cansat-tsniimash/can-cube-sat-2022/logs/sd/best-dataset/readme.txt

Набор создан из одного файла телеметрии с SD карты по имени T167, так как он содержит все данные полёта и чуть больше.

Использованы следующие команды:

1. Для создания первичных csv с фильтрацией по времени и дополнительными колонками с временем
`python make_csv.py -i "T167" --notimestamps --time-steady-start 2450006 --time-steady-stop 10381817 --time-steady-launch 2710973 --output-dir T167_mav_csv_flight --fix-bcu-electricals --time-launch 1656909365`. make_csv находится в cansat-gcs репе

2. Для создания набора с интерполированной высотой и давлением для каждой записи
`python inject.py` Скрипт находится здесь же в папочке `analysis-scripts`

Интересные события:

```
начало интересной телеметрии
time_steady = 2450006; time_s = 1656909103; greg = 2022-07-04T07:31:43; минуты от старта (по time_s): -4.356

запуск
time_steady = 2710973; time_s = 1656909365; greg = 2022-07-04T07:36:05; минуты от старта: 0

разрыв шара
time_steady= 489901; time_s = 1656914065; greg = 2022-07-04T08:54:25; минуты от старта: 78.335

посадка
time_steady = 9328887; time_s = 1656915983; greg = 2022-07-04T09:26:23; минуты от старта: 110.27

конец интересной телеметрии
time_steady = 10381817; time_s = 1656917036; greg = 2022-07-04T09:43:56; минуты от старта: 127.858
```
