cansat-tsniimash/can-cube-sat-2022/doc/Отчетные документы на зимнюю сессию/ТЗ на наземный комплекс управления Охотник.docx

СОГЛАСОВАНО | УТВЕРЖДАЮ
___________________________________ | ___________________________________
должность, головной исполнитель ОКР | должность, заказчик
___________________________________ | ___________________________________
подпись, инициалы, фамилия | подпись, инициалы, фамилия
«___»____________________ 20___г. | «___»____________________ 20___г.

ТЕХНИЧЕСКОЕ ЗАДАНИЕ
НА СОСТАВНУЮ ЧАСТЬ ОПЫТНО-КОНСТРУКТОРСКОЙ РАБОТЫ

НАЗЕМНЫЙ КОМПЛЕКС УПРАВЛЕНИЯ ОХОТНИК

ОХОТНИК-ИТС

Королев 2022

Содержание

1 Наименование, шифр СЧ ОКР, основание, исполнитель и сроки выполнения СЧ ОКР

Разрабатываемый наземный комплекс управления, входящий в состав стратосферной исследовательской системы "Дикая охота" (далее именуется "Охотник").

Шифр СЧ ОКР: "ОХОТНИК-ИТС".

Основания для проведения СЧ ОКР:

- «Положение о проведении 11 сезона всероссийского чемпионата «Воздушно-инженерная школа»;
- решение участников "Концерна "Информационные технические системы" об участии в конкурсе.

Исполнитель – "Концерн "Информационные технические системы".

Сроки выполнения СЧ ОКР распределены на несколько этапов согласно таблице 1.

Таблица 1. Этапы проведения СЧ ОКР.

№ | Наименования этапа | Срок окончания
1 | Разработка эскизного проекта | Январь 2022
2 | Разработка рабочего проекта | Апрель 2022
3 | Изготовление и проведение контрольных испытаний всех элементов разрабатываемой системы | Июнь 2022

2 Цель выполнения СЧ ОКР, наименование и индекс изделия

Целью составной части опытно-конструкторской работы (СЧ ОКР) является разработка наземного комплекса управления в составе стратосферной исследовательской системы "Дикая охота", предназначенной для выполнения исследовательских задач согласно регламенту конкурса "Воздушно-инженерная школа CanSat в России".

Наименование изделия: Наземный комплекс управления "Охотник" стратосферной исследовательской системы "Дикая охота".

Индекс изделия: GCS1B.

3 Технические требования к изделию
  3.1 Состав изделия
- Центр управления полетами "Засада", предназначенный для сбора хранения и отображения телеметрии в реальном времени;
- Приемопередающая антенная система "Арсенал", предназначенная для обеспечения канала связи аппарата с Землей.
- Программное обеспечение различного назначения, в том числе система автоматического наведения, система ручного управления антенной, система отображения телеметрии "Стрела-МС", система приема и отправки команд.
  3.2 Требования назначения

Разрабатываемый наземный комплекс управления предназначен для решения следующих задач:

- приём телеметрической и иной информации, передаваемой стратосферным зондом;
- отправка команд;
- накопление принятой информации на внутреннем накопителе;
- отображение полученной по радиоканалу информации электронно-вычислительными машинами центра управления полетами в реальном или близком к реальному времени;
- передача информации с приемо-передающей антенной системы на электронно-вычислительные машины центра управления полетами, осуществляемая при помощи протокола из стека протоколов TCP/IP (v4 или v6);
- Автоматическое наведение антенны на аппарат по данным о его положении в системе координат WGS84;
- Ручное управление приемо-передающей антенной системой с использованием компьютеров центра управления полетами.
  3.3 Требования радиоэлектронной защиты

Должна быть обеспечена совместимость радиоэлектронных средств, используемых в системе.

  3.4 Требования живучести и стойкости к внешним воздействующим факторам

Требования к имитозащищенности

Наземная станция должна удовлетворять следующим требованиям к имитозащищенности:

- должна быть предусмотрена защита от различного рода помех при помощи таких механизмов, как контрольные суммы или помехозащищенное кодирование.

К наземному измерительному пункту предоставляются следующие требования климатической устойчивости:

- Наземный комплекс управления должен функционировать в диапазоне температур от 0 °C до 45 °C при нормальном атмосферном давлении.

Требования надёжности не предъявляются.

  3.5 Требования эргономики, обитаемости и технической эстетики

Составные части системы должны выглядеть красиво и вызывать ощущение гармонии и удовлетворения в той или иной степени.

  3.6 Требования к эксплуатации, хранению, удобству технического обслуживания и ремонта.

К системе предоставляются следующие эксплуатационные требования:

- система должна приводиться в готовность не дольше 1 часа;
- элементы системы должны быть разборными и предусматривать возможность многократной неразрушающей разборки и последующей сборки в целях проведения локальных ремонтных работ.
  3.7 Требования к транспортабельности

К составным частям системы предоставляются следующие требования:

- элементы системы должны быть транспортабельны при помощи рюкзака объёмом не более 20 литров без потери функциональности. Это требование не распространяется на антенны и штатив.
  3.8 Требования безопасности

К системе предъявляются следующие требования безопасности:

- элементы системы не должны предоставлять опасности для персонала и населения путём воздействия электрического напряжения, движущихся частей, теплового (светового) воздействия, высокочастотных, радиационных, электромагнитных полей, ядовитых паров и газов, вибраций, акустических шумов и др.;
- элементы питания системы должны быть снабжены соответствующими устройствами защиты от коротких замыканий и последующего возгорания;
- конструкция элементов системы должна исключать самопроизвольное включение и выключение.
  3.9 Требования стандартизации

Не предъявляются.

  3.10 Требования технологичности

Не предъявляются.

  3.11 Конструктивные требования

Не предъявляются.

4 Требования к обеспечению
  4.1 Требования к нормативно-техническому обеспечению

Для разработки проекта должна быть использована система контроля версий.

  4.2 Требования к метрологическому обеспечению

Не предъявляются

  4.3 Требования к диагностическому обеспечению

Не предъявляются

  4.4 Требования к математическому, программному и информационно-лингвистическому обеспечению

Вся принятая телеметрия должна сохраняться на внутренний накопитель информации приёмной станции.

5 Требования к консервации, упаковке и маркировке

Для элементов системы должна быть разработана упаковка, позволяющая осуществлять транспортировку и хранение с учётом предоставляемых к транспортировке требований.

6 Требования к учебно-тренировочным средствам

При разработке системы требуется создание автономных стендов для отработки отдельных узлов (там, где это возможно).

7 Этапы выполнения ОКР

Этапы выполнения ОКР приведены в таблице 1.

8 Порядок выполнения этапов и приёмки ОКР

Для закрытия этапа эскизного проектирования, требуется выполнение следующих требований:

Должна быть разработана принципиальная электрической схема наземной станции;

Должна быть создана презентация для устного доклада комиссии;

Для закрытия этапа рабочего проекта должны быть выполнены следующие требования:

Система должна быть полностью спроектирована с выпуском следующих документов:

- Комплект чертежей конструкции СЧ (допустимо использование точных трёхмерных моделей);
- Электрические принципиальные схемы и шаблоны для производства печатных плат, используемых в наземной станции в случае, если последние являются вновь разрабатываемыми.

Должна быть выпущена альфа версия программного обеспечения наземной станции.

Должны быть проведены автономные испытания СЧ.

На финальный этап конкурса команда должна предоставить готовую к эксплуатации СЧ в составе системы и принять участие в финале конкурса "Воздушно-инженерная школа (CanSat в России)".

9 Непредъявляемые требования

Технико-экономические требования.

Требования к каталогизации.

Требования к сырью, материалам и КИМП.

Специальные требования.

10 Ссылочные документы
- Положение о проведении 11 сезона всероссийского чемпионата «Воздушно-инженерная школа».
11 Перечень сокращений:
- КИМП – комплектующие изделия межотраслевого применения;
- ОКР – опытно конструкторская работа;
- СЧ – структурная часть;
- IP – internet protocol;
- UDP – user datagram protocol.

Со стороны исполнителей | Со стороны заказчика
_____________________________________ | _____________________________________
должность, головной исполнитель ОКР | должность, организация заказчика — разработчика ТЗ на ОКР
_____________________________________ | _____________________________________
подпись, инициалы, фамилия | подпись, инициалы, фамилия
«___»____________________ 20___г. | «___»____________________ 20___г.

_____________________________________ | _____________________________________
должность, головной исполнитель ОКР | должность, организация заказчика — разработчика ТЗ на ОКР
_____________________________________ | _____________________________________
подпись, инициалы, фамилия | подпись, инициалы, фамилия
«___»____________________ 20___г. | «___»____________________ 20___г.

_____________________________________ | _____________________________________
должность, головной исполнитель ОКР | должность, организация заказчика — разработчика ТЗ на ОКР
_____________________________________ | _____________________________________
подпись, инициалы, фамилия | подпись, инициалы, фамилия
«___»____________________ 20___г. | «___»____________________ 20___г.

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

ТЗ ОХОТНИК-ИТС Лист 18
