cansat-tsniimash/can-cube-sat-2022/doc/Отчетные документы на зимнюю сессию/ТЗ на систему Дикая охота.docx

СОГЛАСОВАНО | УТВЕРЖДАЮ
___________________________________ | ___________________________________
должность, головной исполнитель ОКР | должность, заказчик
___________________________________ | ___________________________________
подпись, инициалы, фамилия | подпись, инициалы, фамилия
«___»____________________ 20___г. | «___»____________________ 20___г.

ТЕХНИЧЕСКОЕ ЗАДАНИЕ
НА ОПЫТНО-КОНСТРУКТОРСКУЮ РАБОТУ

СТРАТОСФЕРНАЯ ИССЛЕДОВАТЕЛЬСКАЯ СИСТЕМА ДИКАЯ ОХОТА

ДИКАЯ-ОХОТА-ИТС

Содержание

1 Наименование, шифр ОКР, основание, исполнитель и сроки выполнения ОКР

Разрабатываемая стратосферная исследовательская система именуется "Дикая охота".

Шифр ОКР: "ДИКАЯ-ОХОТА-ИТС".

Основания для проведения ОКР:

- «Положение о проведении 11 сезона всероссийского чемпионата «Воздушно-инженерная школа»;
- решение участников Концерна "Информационные технические системы" об участии в конкурсе.

Исполнитель – "Концерн "Информационные технические системы".

Сроки выполнения ОКР распределены на несколько этапов согласно таблице 1.

Таблица 1. Этапы проведения ОКР

№ | Наименования этапа | Срок окончания
1 | Разработка эскизного проекта | Январь 2022
2 | Разработка рабочего проекта | Апрель 2022
3 | Изготовление и проведение контрольных испытаний всех элементов разрабатываемой системы | Июнь 2022

2 Цель выполнения ОКР, наименование и индекс изделия

Целью опытно-конструкторской работы (ОКР) является разработка стратосферной исследовательской системы, предназначенной для выполнения исследовательских задач согласно регламенту конкурса "Воздушно-инженерная школа CanSat в России".

Наименование изделия: Стратосферная исследовательская система "Дикая охота". Далее "Дикая охота" или исследовательская система.

Индекс изделия: 2A.

3 Технические требования к изделию
  3.1 Состав изделия
- стратосферный зонд (СЗ), запускаемый на стратостате;
- наземный комплекс управления (НКУ), осуществляющий приём и обработку данных, поступающих от стратостата.
  3.2 Требования назначения

Разрабатываемая система предназначена для решения следующих задач:

- измерение распределения температуры и давления во время подъёма и спуска;
- измерение относительной влажности на всей трассе полёта;
- измерение состава воздуха (кислорода и примесей: NH3, NO2 и CO) на всей трассе полёта;
- измерение трёх компонент ускорения;
- фотография Земли в период времени от 0 до 10 секунд после начала падения аппарата;
- фиксация точки разрушения шара-зонда (координаты, высота, время);
- фотофиксация неба в момент приземления;
- исследование радиационной обстановки на протяжении всего полета;
- определение ориентации на Солнце при помощи солнечного датчика собственной разработки;
- регистрация траектории полета и ориентации стратосферного зонда;
- изучение эффективности работы солнечных панелей в зависимости от высоты;
- создание улучшенного наземного комплекса управления;
- обеспечение двунаправленной связи по радиоканалу между СЗ и НКУ;
- анализ телеметрии аппарата на приёмном пункте во время полёта;
- накопление принятой информации от СЗ на НКУ;
- автоматическое (основное) и ручное (резервное) наведение антенны НКУ на аппарат.
  3.3 Требования радиоэлектронной защиты

Должна быть обеспечена совместимость радиоэлектронных средств, используемых в системе.

  3.4 Требования живучести и стойкости к внешним воздействующим факторам

Требования к имитозащищенности

Система должна удовлетворять следующим требованиям к имитозащищенности:

- должна быть предусмотрена защита от различного рода помех при помощи таких механизмов, как контрольные суммы или помехозащищенное кодирование.

Требования к устойчивости к климатическим воздействиям не предъявляются.

Требования надёжности не предъявляются.

  3.5 Требования эргономики, обитаемости и технической эстетики

Элементы системы должны выглядеть внушительно.

  3.6 Требования к эксплуатации, хранению, удобству технического обслуживания и ремонта

К системе предоставляются следующие эксплуатационные требования:

- система должна приводиться в готовность не дольше 1 часа;
- элементы системы должны быть разборными и предусматривать возможность многократной неразрушающей разборки и последующей сборки в целях проведения локальных ремонтных работ.
  3.7 Требования к транспортабельности

К составным частям системы предоставляются следующие требования:

- элементы системы должны быть транспортабельны при помощи двух рюкзаков объёмом не более 20 литров без потери функциональности. Это требование не распространяется на антенны и штатив из состава НКУ.
  3.8 Требования безопасности

К системе предоставляются следующие требования безопасности:

- элементы системы не должны предоставлять опасности для персонала и населения путём воздействия электрического напряжения, движущихся частей, теплового (светового) воздействия, высокочастотных, радиационных, электромагнитных полей, ядовитых паров и газов, вибраций, акустических шумов и др.;
- элементы питания системы должны быть снабжены соответствующими устройствами защиты от коротких замыканий и последующего возгорания;
- конструкция элементов системы должна исключать самопроизвольное включение и выключение.
  3.9 Требования стандартизации

Не предъявляются.

  3.10 Требования технологичности

Не предъявляются.

  3.11 Конструктивные требования

Не предъявляются.

4 Технико-экономические требования

Не предъявляются.

5 Требования к обеспечению
  5.1 Требования к нормативно-техническому обеспечению

Для разработки проекта должна быть использована система контроля версий.

  5.2 Требования к метрологическому обеспечению

Не предъявляются.

  5.3 Требования к диагностическому обеспечению

Не предъявляются.

  5.4 Требования к математическому, программному и информационно-лингвистическому обеспечению

Не предъявляются.

6 Требования к учебно-тренировочным средствам

При разработке системы требуется создание автономных стендов для отработки отдельных узлов там, где это возможно.

7 Непредъявляемые требования

Требования к каталогизации.

Требования к сырью, материалам и КИМП.

Специальные требования.

Требования к консервации, упаковке и маркировке.

8 Этапы выполнения ОКР

Этапы выполнения ОКР приведены в таблице 1.

9 Порядок выполнения этапов и приёмки ОКР.

Для закрытия этапа эскизного проектирования, требуется выполнение следующих требований:

Должны быть разработаны трёхмерные модели элементов конструкции стратосферного зонда;

Должна быть разработана принципиальная электрической схема аппарата;

Должна быть создана презентация для устного доклада комиссии.

Презентация должна включать:

- описание научной задачи;
- описание технической задачи;

Для закрытия этапа рабочего проекта должны быть выполнены следующие требования:

Система должна быть полностью спроектирована с выпуском следующих документов:

- Комплект чертежей конструкции системы (допустимо использование точных трёхмерных моделей);
- Электрические принципиальные схемы и шаблоны для производства печатных плат, используемых в системе.

Должна быть выпущена альфа версия программного обеспечения всех составных частей системы.

Должны быть проведены автономные испытания элементов разрабатываемой системы.

На финальный этап конкурса команда должна предоставить готовую к эксплуатации систему и принять участие в финале конкурса Воздушно-инженерная школа CanSat в России.

10 Ссылочные документы
- Положение о проведении 11 сезона всероссийского чемпионата «Воздушно-инженерная школа».
11 Перечень сокращений:
- КИМП – комплектующие изделия межотраслевого применения;
- НИП – наземный измерительный пункт;
- НКУ – наземный комплекс управления;
- ОКР – опытно конструкторская работа;
- СЗ – стратосферный зонд.

Со стороны исполнителей | Со стороны заказчика
_____________________________________ | _____________________________________
должность, головной исполнитель ОКР | должность, организация заказчика — разработчика ТЗ на ОКР
_____________________________________ | _____________________________________
подпись, инициалы, фамилия | подпись, инициалы, фамилия
«___»____________________ 20___г. | «___»____________________ 20___г.

_____________________________________ | _____________________________________
должность, головной исполнитель ОКР | должность, организация заказчика — разработчика ТЗ на ОКР
_____________________________________ | _____________________________________
подпись, инициалы, фамилия | подпись, инициалы, фамилия
«___»____________________ 20___г. | «___»____________________ 20___г.

_____________________________________ | _____________________________________
должность, головной исполнитель ОКР | должность, организация заказчика — разработчика ТЗ на ОКР
_____________________________________ | _____________________________________
подпись, инициалы, фамилия | подпись, инициалы, фамилия
«___»____________________ 20___г. | «___»____________________ 20___г.

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

ТЗ ДИКАЯ-ОХОТА-ИТС Лист 16
