cansat-tsniimash/can-cube-sat-2022/doc/Отчетные документы на зимнюю сессию/ТЗ на стратосфнрный зонд Снегирь МС.docx

СОГЛАСОВАНО | УТВЕРЖДАЮ
___________________________________ | ___________________________________
должность, головной исполнитель ОКР | должность, заказчик
___________________________________ | ___________________________________
подпись, инициалы, фамилия | подпись, инициалы, фамилия
«___»____________________ 20___г. | «___»____________________ 20___г.

ТЕХНИЧЕСКОЕ ЗАДАНИЕ

НА СОСТАВНУЮ ЧАСТЬ ОПЫТНО-КОНСТРУКТОРСКОЙ РАБОТЫ

СТРАТОСФЕРНЫЙ ЗОНД СНЕГИРЬ МС

СНЕГИРЬ-МС-ИТС

Королев 2022

Содержание

1 Наименование, шифр СЧ ОКР, основание, исполнитель и сроки выполнения СЧ ОКР

1.1 Разрабатываемый стратосферный зонд, являющийся частью стратосферной исследовательской системы "Дикая охота" имеет название "Снегирь".

1.2 Шифр СЧ ОКР: "СНЕГИРЬ-МС-ИТС".

1.3 Основания для проведения СЧ ОКР.

- «Положение о проведении 11 сезона всероссийского чемпионата «Воздушно-инженерная школа»;
- решение участников Концерна "Информационные технические системы" об участии в конкурсе.

1.4 Исполнитель – "Концерн "Информационные технические системы".

1.5 Сроки выполнения СЧ ОКР распределены на несколько этапов согласно таблице 1.

Таблица 1. Этапы проведения СЧ ОКР

№ | Наименования этапа | Срок окончания
1 | Разработка эскизного проекта | Январь 2022
2 | Разработка рабочего проекта | Апрель 2022
3 | Изготовление и проведение контрольных испытаний всех элементов разрабатываемой системы | Июнь 2022

2 Цель выполнения СЧ ОКР, наименование и индекс изделия

2.1 Целью составной части опытно-конструкторской работы (СЧ ОКР) является разработка стратосферного зонда, являющегося частью стратосферной исследовательской системы, предназначенной для выполнения исследовательских задач согласно регламенту конкурса "Воздушно-инженерная школа CanSat в России".

2.2 Наименование изделия: Стратосферный зонд "Снегирь". Далее "Снегирь" или стратосферный зонд, или же зонд.

2.3 Индекс изделия: CCS2A.

3 Технические требования к изделию
  3.1 Состав изделия
- бортовой комплекс управления;
- система электроснабжения;
- система обеспечения теплового режима;
- полезная нагрузка;
- блок формирования навигационных параметров;
- конструкция.
  3.2 Требования назначения

3.2.1 Разрабатываемый стратосферный зонд предназначен для решения следующих задач:

- измерение распределения температуры и давления во время подъёма и спуска;
- измерение относительной влажности на всей трассе полёта;
- измерение состава воздуха (кислорода и примесей: NH3, NO2 и CO) на всей трассе полёта;
- измерение трёх компонент ускорения;
- фотография Земли в период времени от 0 до 10 секунд после начала падения аппарата;
- фиксация точки разрушения шара-зонда (координаты, высота, время);
- фотофиксация неба в момент приземления;
- сбор показаний с инерциальных датчиков для последующего восстановления траектории полёта;
- исследование радиационной обстановки на протяжении всего полета;
- определение ориентации на Солнце при помощи солнечного датчика собственной разработки;
- регистрация траектории полета и ориентации стратосферного зонда;
- изучение эффективности работы солнечных панелей в зависимости от высоты;
- отправка телеметрии на наземный комплекс управления;
- получение команд по радиоканалу с наземного комплекса управления и их исполнение.
  3.3 Требования радиоэлектронной защиты

3.3.1 Должна быть обеспечена совместимость радиоэлектронных средств, используемых в зонде.

  3.4 Требования живучести и стойкости к внешним воздействующим факторам

3.4.1 Требования к имитозащищенности

3.4.1.1 Зонд должен удовлетворять следующим требованиям к имитозащищенности:

- должна быть предусмотрена защита от различного рода помех при помощи таких механизмов, как контрольные суммы или помехозащищенное кодирование.

3.4.2 Требования к устойчивости к климатическим воздействиям

3.4.2.1 К зонду в составе системы предъявляются следующие требования:

- зонд должен выдерживать температуру внешней окружающей среды в диапазоне от минус 45 до плюс 45 °C;
- зонд должен выдерживать атмосферное давление в диапазоне от 1 кПа до 105 кПа;
- зонд должен выдерживать подъем на высоту до 30 км относительно опорного эллипсоида WGS84 со скоростью от 4 до 7 м/с;
- зонд должен выдержать посадку при скорости от 5 до 8 м/c;

3.4.3 Требования к надёжности не предъявляются

  3.5 Требования эргономики, обитаемости и технической эстетики

3.5.1 Зонд должен выглядеть приятно.

  3.6 Требования к эксплуатации, хранению, удобству технического обслуживания и ремонта

3.6.1 К зонду предъявляются следующие эксплуатационные требования:

- зонд должен приводиться в готовность не дольше 1 часа;
- конструкция зонда должна предусматривать возможность многократной неразрушающей разборки и последующей сборки в целях проведения локальных ремонтных работ.
  3.7 Требования к транспортабельности

3.7.1 К зонду предъявляются следующие требования:

- зонд должен быть транспортабельным при помощи рюкзака объёмом не более 20 литров без потери функциональности. Это требование не распространяется на антенны.
  3.8 Требования безопасности

3.8.1 К зонду предъявляются следующие требования безопасности:

- элементы зонда не должны предоставлять опасности для персонала и населения путём воздействия электрического напряжения, движущихся частей, теплового (светового) воздействия, высокочастотных, радиационных, электромагнитных полей, ядовитых паров и газов, вибраций, акустических шумов и др.;
- элементы питания зонда должны быть снабжены соответствующими устройствами защиты от коротких замыканий и последующего возгорания;
- конструкция зонда должна исключать самопроизвольное выключение.
  3.9 Требования стандартизации

3.9.1 Не предъявляются.

  3.10 Требования технологичности

3.10.1 Не предъявляются.

  3.11 Конструктивные требования

3.11.1 Габариты зонда: не более 300x300x410 мм с учётом системы крепления троса;

3.11.2 Масса зонда в диапазоне от 750 до 1500 грамм;

3.11.3 Зонд должен быть адаптирован для крепления к специальным точкам стратостата.

3.11.5 Не предъявляются.

4 Требования к обеспечению
  4.1 Требования к нормативно-техническому обеспечению

4.1.1 Для разработки проекта должна быть использована система контроля версий.

  4.2 Требования к метрологическому обеспечению

4.2.1 Не предъявляются.

  4.3 Требования к диагностическому обеспечению

4.3.1 Не предъявляются.

  4.4 Требования к математическому, программному и информационно-лингвистическому обеспечению

4.4.1 Программное обеспечение, разрабатываемое для зонда должно быть разработано на языке программирования C.

4.4.2 Приветствуется следование рекомендациям MISRA C.

4.4.3 Вся телеметрическая информация, передаваемая аппаратом, должна сохраняться на внутреннем накопителе информации.

5 Требования к консервации, упаковке и маркировке

5.1 При необходимости, для зонда должна быть разработана упаковка, позволяющая осуществлять транспортировку и хранение с учётом предъявляемых к транспортировке требований.

5.2 На корпусе зонда должна быть размещена табличка с координатами официального представителя Концерна "Информационного технические системы", с наименованием аппарата и кратким описанием в целях оповещения нашедшего аппарат.

6 Требования к учебно-тренировочным средствам

6.1 При разработке зонда требуется создание автономных стендов для отработки отдельных узлов там, где это возможно.

7 Непредъявляемые требования
  7.1 Технико-экономические требования

7.2 Требования к каталогизации.

  7.2 Требования к сырью, материалам и КИМП

7.4 Специальные требования.

8 Этапы выполнения СЧ ОКР

8.1 Этапы выполнения ОКР приведены в таблице 1.

9 Порядок выполнения этапов и приёмки СЧ ОКР

9.1 Для закрытия этапа эскизного проектирования, требуется выполнение следующих требований:

9.1.1 Должны быть разработаны трёхмерные модели элементов конструкции стратосферного зонда;

9.1.2 Должна быть разработана принципиальная электрической схема аппарата;

9.1.3 Должна быть создана презентация для устного доклада комиссии.

9.1.4 Презентация должна включать:

- описание научной задачи;
- описание технической задачи;

9.2 Для закрытия этапа рабочего проекта должны быть выполнены следующие требования:

9.2.1 Система должна быть полностью спроектирована с выпуском следующих документов:

- Комплект чертежей конструкции системы (допустимо использование точных трёхмерных моделей);
- Электрические принципиальные схемы и шаблоны для производства печатных плат, используемых в системе.

9.2.2 Должна быть выпущена альфа версия программного обеспечения всех составных частей системы.

9.2.3 Должны быть проведены автономные испытания элементов разрабатываемой системы.

9.3 На финальный этап конкурса команда должна предоставить готовую к эксплуатации систему и принять участие в финале конкурса Воздушно-инженерная школа CanSat в России.

10 Ссылочные документы
- Положение о проведении 11 сезона всероссийского чемпионата «Воздушно-инженерная школа».
11 Перечень сокращений:
- КИМП – комплектующие изделия межотраслевого применения;
- НИП – наземный измерительный пункт;
- НКУ – наземный комплекс управления;
- ОКР – опытно конструкторская работа;
- СЗ – стратосферный зонд;
- СЧ – составная часть.

Со стороны исполнителей | Со стороны заказчика
_____________________________________ | _____________________________________
должность, головной исполнитель ОКР | должность, организация заказчика — разработчика ТЗ на ОКР
_____________________________________ | _____________________________________
подпись, инициалы, фамилия | подпись, инициалы, фамилия
«___»____________________ 20___г. | «___»____________________ 20___г.

_____________________________________ | _____________________________________
должность, головной исполнитель ОКР | должность, организация заказчика — разработчика ТЗ на ОКР
_____________________________________ | _____________________________________
подпись, инициалы, фамилия | подпись, инициалы, фамилия
«___»____________________ 20___г. | «___»____________________ 20___г.

_____________________________________ | _____________________________________
должность, головной исполнитель ОКР | должность, организация заказчика — разработчика ТЗ на ОКР
_____________________________________ | _____________________________________
подпись, инициалы, фамилия | подпись, инициалы, фамилия
«___»____________________ 20___г. | «___»____________________ 20___г.

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

ТЗ СНЕГИРЬ-МС-ИТС Лист 8
