cansat-tsniimash/can-cube-sat-2022/doc/Schemstic Payload.png

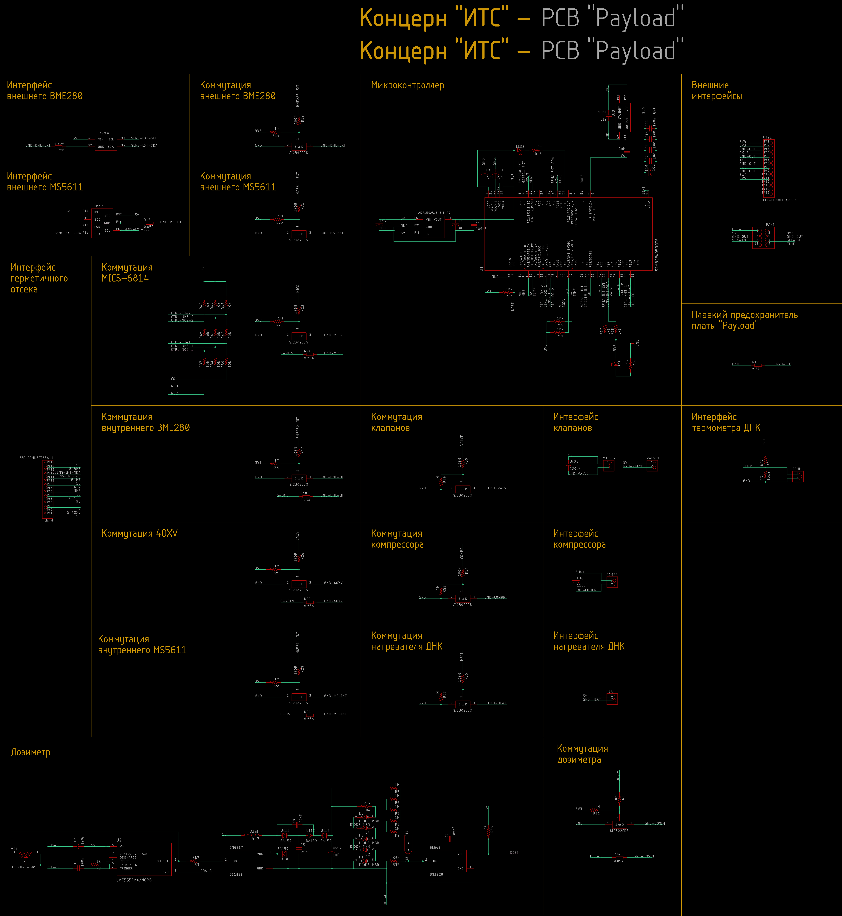
doc/Schemstic Payload.png
