cansat-tsniimash/can-cube-sat-2022/doc/Отчетные документы на зимнюю сессию/Протоколы взаимодействия интерфейсов.PNG

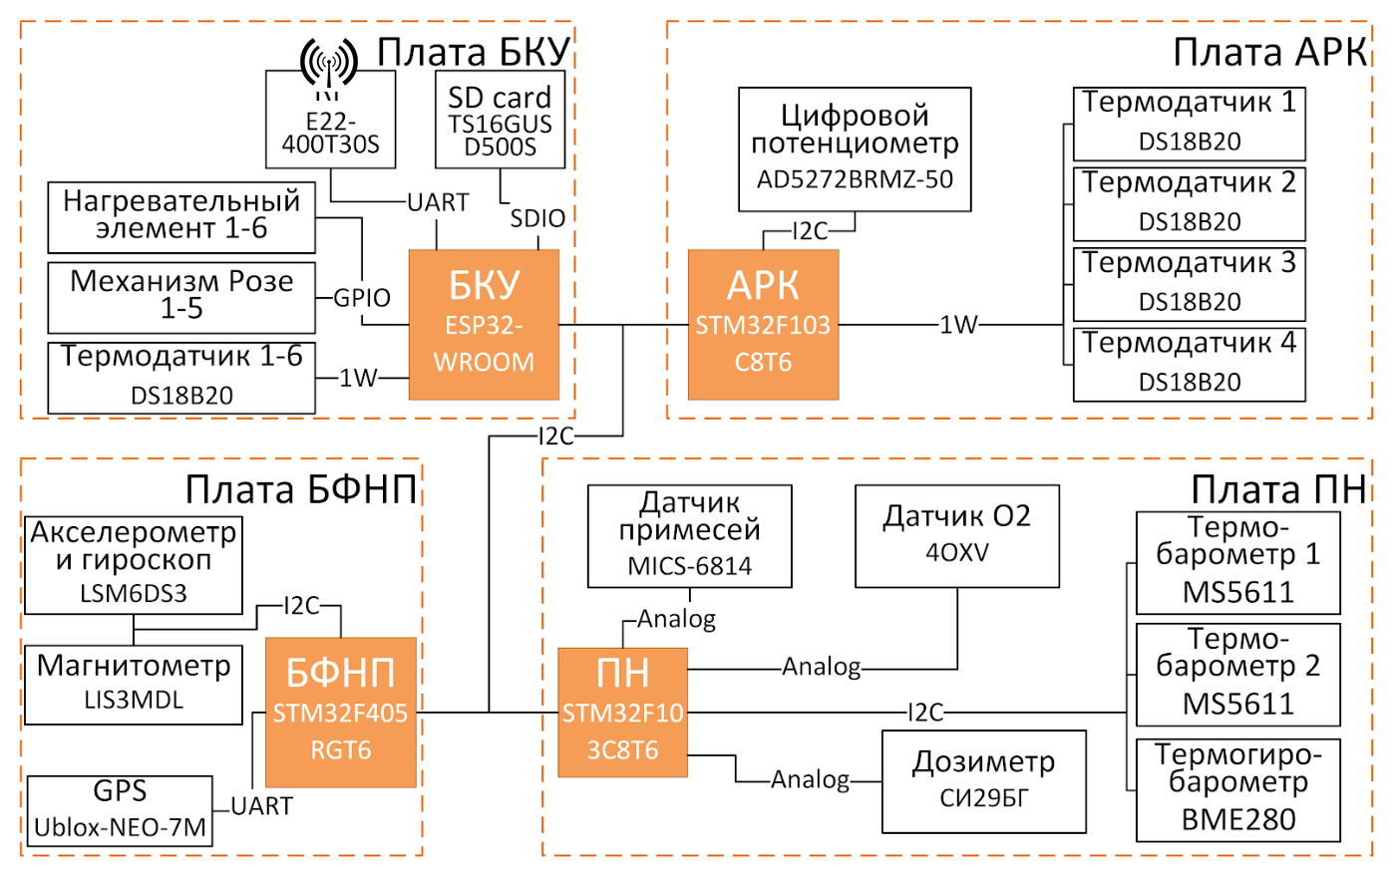
doc/Отчетные документы на зимнюю сессию/Протоколы взаимодействия интерфейсов.PNG
