cansat-tsniimash/can-cube-sat-2022/doc/Схема подключения плат.png

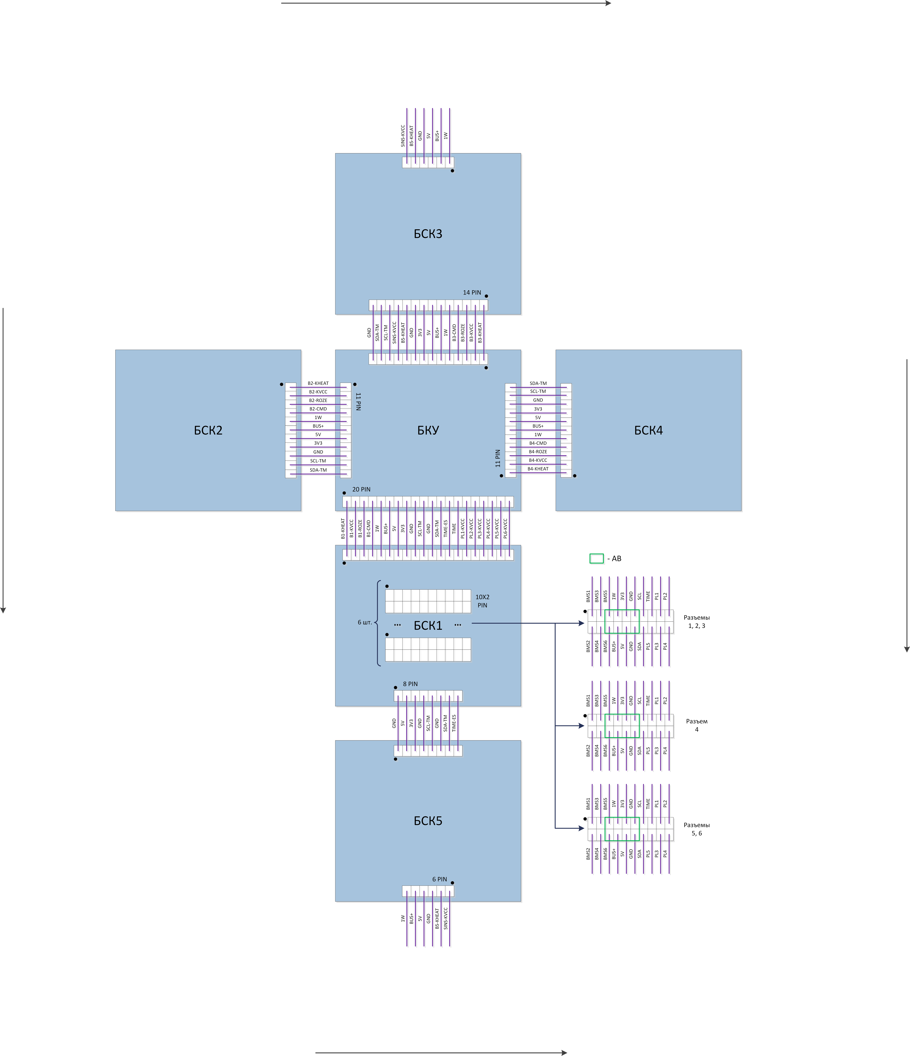
doc/Схема подключения плат.png
