cansat-tsniimash/can-cube-sat-2022/logs/radio/best-dataset-on-the-earth/gnuplot/rssi-snr-analysis.plot.png

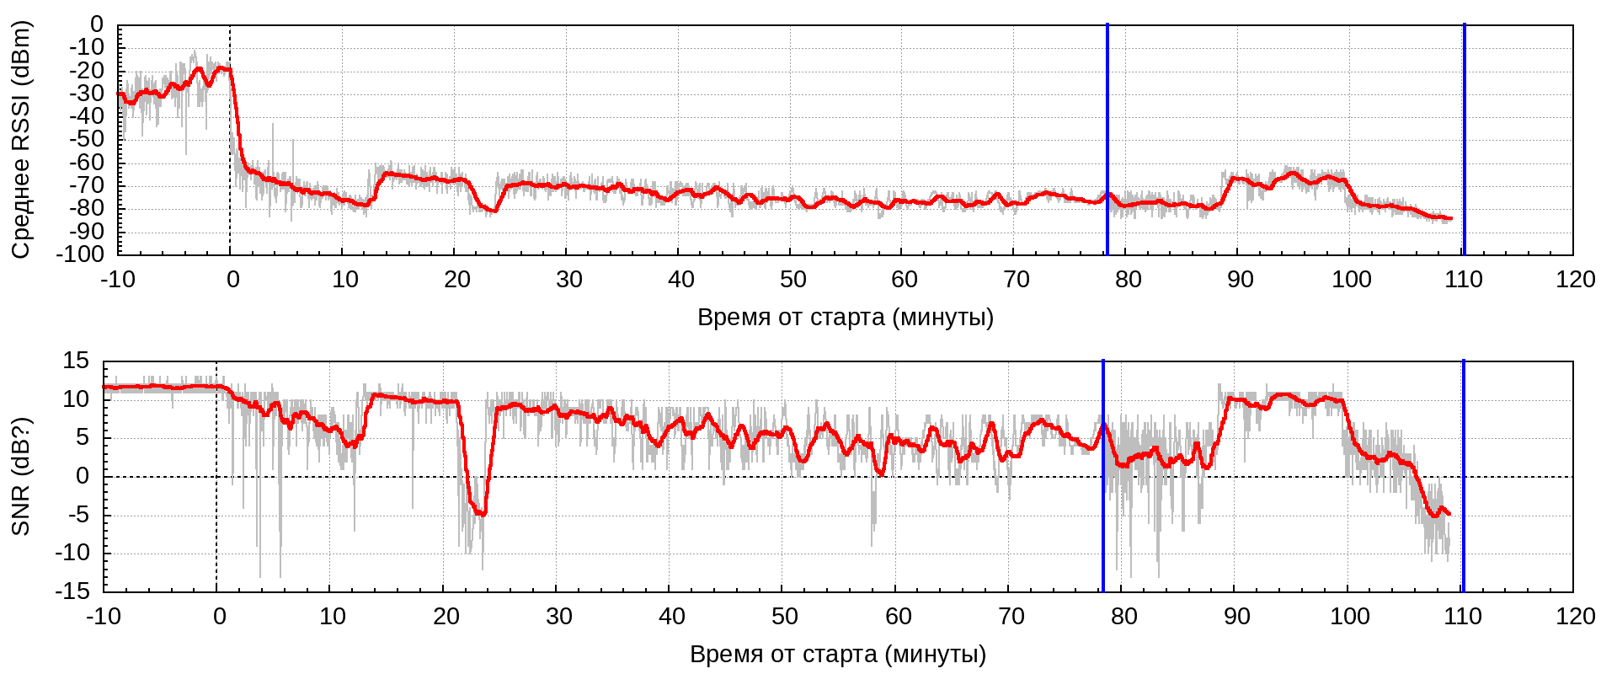
logs/radio/best-dataset-on-the-earth/gnuplot/rssi-snr-analysis.plot.png
