cansat-tsniimash/can-cube-sat-2022/src/research/light_sensor/Madgwick/dump-processor/theplane.stl

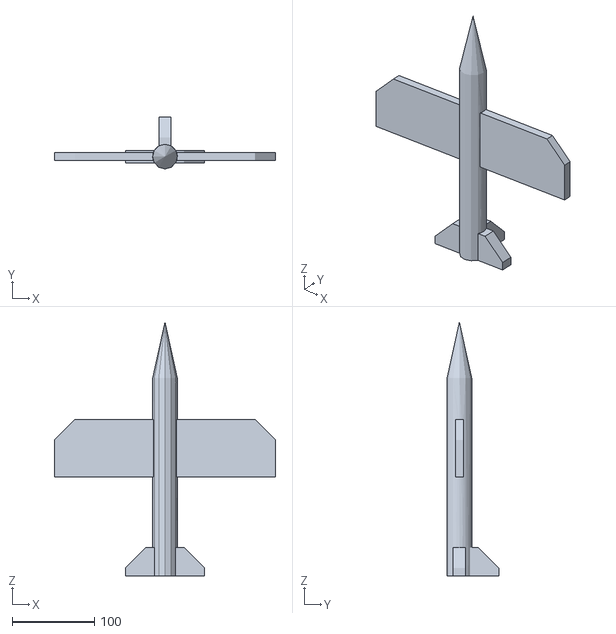
[picture p7: CAD file, 2020-12-05]
src/research/light_sensor/Madgwick/dump-processor/theplane.stl
268.3 x 63.0 x 308.0
