cansat-tsniimash/can-cube-sat-2022/(list of files, cad)

Other CAD files:
construction/3Dmodel_Spacecraft/adapter.prt
construction/3Dmodel_Spacecraft/air-valve.prt
construction/3Dmodel_Spacecraft/ark-pcb.prt
construction/3Dmodel_Spacecraft/barometr-ms5611.prt
construction/3Dmodel_Spacecraft/battery_pcb-bms.prt
construction/3Dmodel_Spacecraft/bku-pcb.prt
construction/3Dmodel_Spacecraft/bme280_module.prt
construction/3Dmodel_Spacecraft/bottom-camera-kron.prt
construction/3Dmodel_Spacecraft/bsk1-pcb-main.prt
construction/3Dmodel_Spacecraft/bsk2-pcb-main.prt
construction/3Dmodel_Spacecraft/bsk3-pcb-main.prt
construction/3Dmodel_Spacecraft/bsk4-pcb-main.prt
construction/3Dmodel_Spacecraft/bsk5_pcb-main.prt
construction/3Dmodel_Spacecraft/bsk_inter-plata.prt
construction/3Dmodel_Spacecraft/bsk_pcb-cross.prt
construction/3Dmodel_Spacecraft/button_s4f.prt
construction/3Dmodel_Spacecraft/camera_sq13.prt
construction/3Dmodel_Spacecraft/cancubesat-2-for-gks.prt
construction/3Dmodel_Spacecraft/connector-ffc_686115148922.prt
construction/3Dmodel_Spacecraft/connector-pbd-20r.prt
construction/3Dmodel_Spacecraft/connector-pbs-14r.prt
construction/3Dmodel_Spacecraft/connector-pbs-6r.prt
construction/3Dmodel_Spacecraft/connector-pbs-8r.prt
construction/3Dmodel_Spacecraft/connector-pls-11.prt
construction/3Dmodel_Spacecraft/connector-pls-14.prt
construction/3Dmodel_Spacecraft/connector-pls-2.prt
construction/3Dmodel_Spacecraft/connector-pls-20.prt
construction/3Dmodel_Spacecraft/connector-pls-6.prt
construction/3Dmodel_Spacecraft/connector-pls-8.prt
construction/3Dmodel_Spacecraft/connector_b2b-eh-a.prt
construction/3Dmodel_Spacecraft/dna-container.prt
construction/3Dmodel_Spacecraft/dna-container_tip.prt
construction/3Dmodel_Spacecraft/dna-tube.prt
construction/3Dmodel_Spacecraft/dosimeter.prt
construction/3Dmodel_Spacecraft/fixator-cancubesat-2.prt
construction/3Dmodel_Spacecraft/gps_antenna.prt
construction/3Dmodel_Spacecraft/gps_ublox_neo-7m-0-000.prt
construction/3Dmodel_Spacecraft/gy-lsm6ds3_lsm6ds3.prt
construction/3Dmodel_Spacecraft/heater.prt
construction/3Dmodel_Spacecraft/ic_mosfet-n_fs8205a.prt
construction/3Dmodel_Spacecraft/ic_shift_register_74hc164d.prt
construction/3Dmodel_Spacecraft/ic_step-down_regulator_ltc3633.prt
construction/3Dmodel_Spacecraft/ic_termometer_ds18b20.prt
construction/3Dmodel_Spacecraft/ic_termometer_ds18b20z.prt
construction/3Dmodel_Spacecraft/ir-photodiode_bpv23nf.prt
construction/3Dmodel_Spacecraft/karkas_balka-1.prt
construction/3Dmodel_Spacecraft/karkas_rama-1.prt
construction/3Dmodel_Spacecraft/karkas_rama-2.prt
construction/3Dmodel_Spacecraft/kompressor-528.prt
construction/3Dmodel_Spacecraft/krepej_anteni_gps-v2.prt
construction/3Dmodel_Spacecraft/kron-of-board.prt
construction/3Dmodel_Spacecraft/li-ion-cell_inr18650-25r.prt
construction/3Dmodel_Spacecraft/microkontroller_esp32-wroom.prt
construction/3Dmodel_Spacecraft/microsd_connector_502774-0891.prt
construction/3Dmodel_Spacecraft/mics-6814.prt
construction/3Dmodel_Spacecraft/module-ab_2s2p_korpus-bottom.prt
construction/3Dmodel_Spacecraft/module-ab_2s2p_korpus-top.prt
construction/3Dmodel_Spacecraft/onboard-antenna-433mhz.prt
construction/3Dmodel_Spacecraft/opora-cancubesat-2.prt
construction/3Dmodel_Spacecraft/oxigen-sensor_me2-o2-f20.prt
construction/3Dmodel_Spacecraft/payload-pcb.prt
construction/3Dmodel_Spacecraft/pin-header-11-female_onboard.prt
construction/3Dmodel_Spacecraft/pin-header-20-female_onboard.prt
construction/3Dmodel_Spacecraft/pin-header-2x10-male_onboard.prt
construction/3Dmodel_Spacecraft/pin-header-2x8-female_onboard.prt
construction/3Dmodel_Spacecraft/pipe-1.prt
construction/3Dmodel_Spacecraft/pipe-2.prt
construction/3Dmodel_Spacecraft/pipe-3.prt
construction/3Dmodel_Spacecraft/pipe-4.prt
construction/3Dmodel_Spacecraft/pipe-nozzle-3_5mm.prt
construction/3Dmodel_Spacecraft/pipe-nozzle-3_9mm.prt
construction/3Dmodel_Spacecraft/sealed-housing-tip.prt
construction/3Dmodel_Spacecraft/sealed-housing.prt
construction/3Dmodel_Spacecraft/shaiba_for_antenna.prt
construction/3Dmodel_Spacecraft/shtift-2mm.prt
construction/3Dmodel_Spacecraft/si-rod.prt
construction/3Dmodel_Spacecraft/soft_connector-for-sb.prt
construction/3Dmodel_Spacecraft/soft_connector.prt
construction/3Dmodel_Spacecraft/solar_inter-plata.prt
construction/3Dmodel_Spacecraft/solar_kron-mirror.prt
construction/3Dmodel_Spacecraft/solar_kron.prt
construction/3Dmodel_Spacecraft/solar_pcb-inner.prt
construction/3Dmodel_Spacecraft/solar_pcb-main.prt
construction/3Dmodel_Spacecraft/solar_pcb-outer.prt
construction/3Dmodel_Spacecraft/spring_0_4x2_4x19_6.prt
construction/3Dmodel_Spacecraft/sun-sensor-kron.prt
construction/3Dmodel_Spacecraft/sun-sensor-shtanga-mirror.prt
construction/3Dmodel_Spacecraft/sun-sensor-shtanga.prt
construction/3Dmodel_Spacecraft/top-camera-kron.prt
construction/3Dmodel_Spacecraft/vint_m2_5x10_din-912.prt
construction/3Dmodel_Spacecraft/vint_m2x6_din-912.prt
construction/3Dmodel_Spacecraft/vint_m2x8_din-912.prt
construction/3Dmodel_Spacecraft/vint_m3x12_din-912.prt
construction/3Dmodel_Spacecraft/vint_m3x5_din-912.prt
construction/3Dmodel_Spacecraft/vint_m3x8_din-912.prt
construction/3Dmodel_Spacecraft/vint_m5x10_din-912.prt
construction/3Dmodel_Spacecraft/wireless_module_e22-400t30s.prt
construction/Equipment/solar-eqv.prt
