cansat-tsniimash/can-cube-sat-2022/doc/Отчетные документы на зимнюю сессию/CCS2A.0000-0.pdf

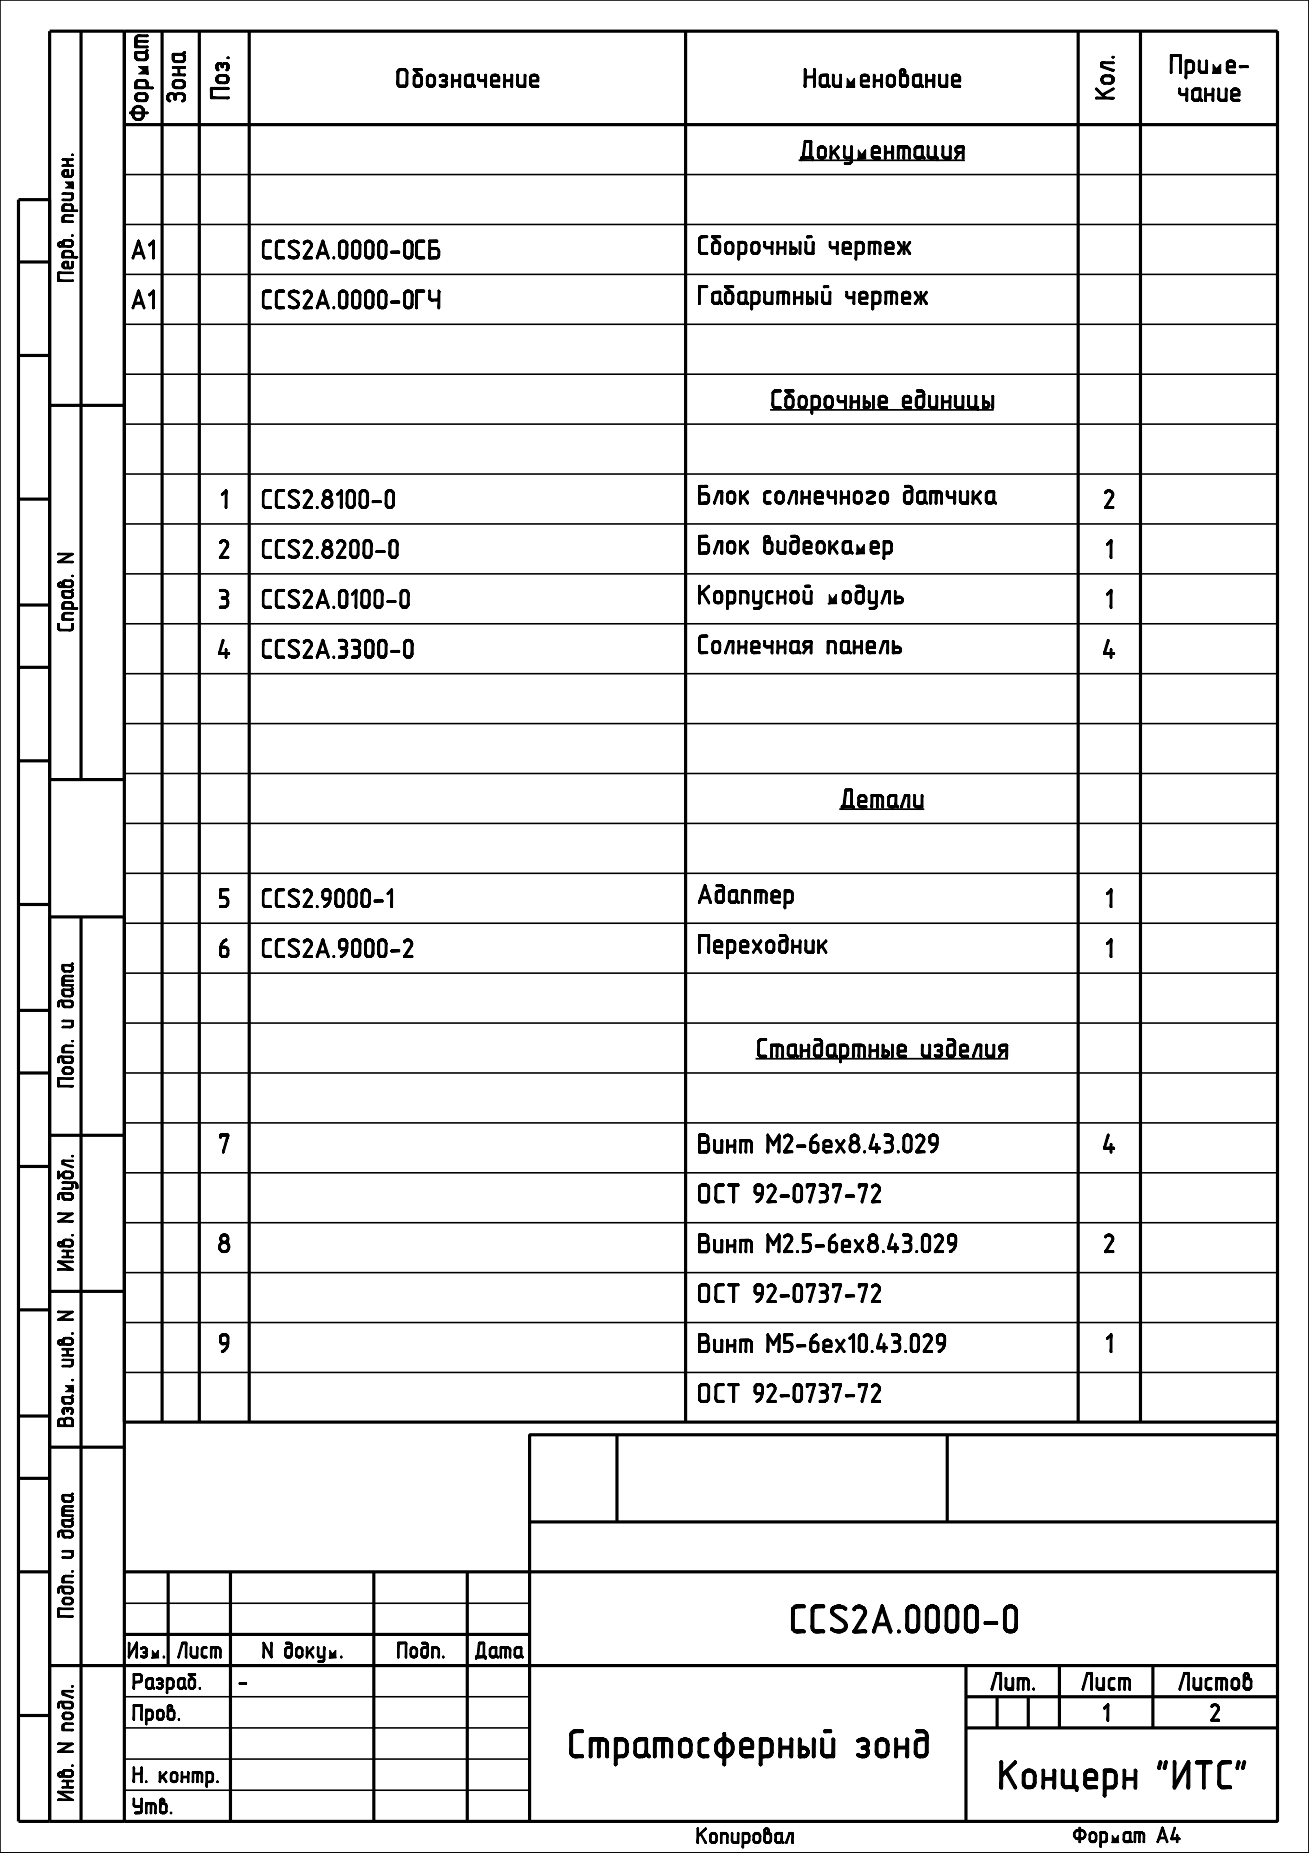
[picture p8: page 1]

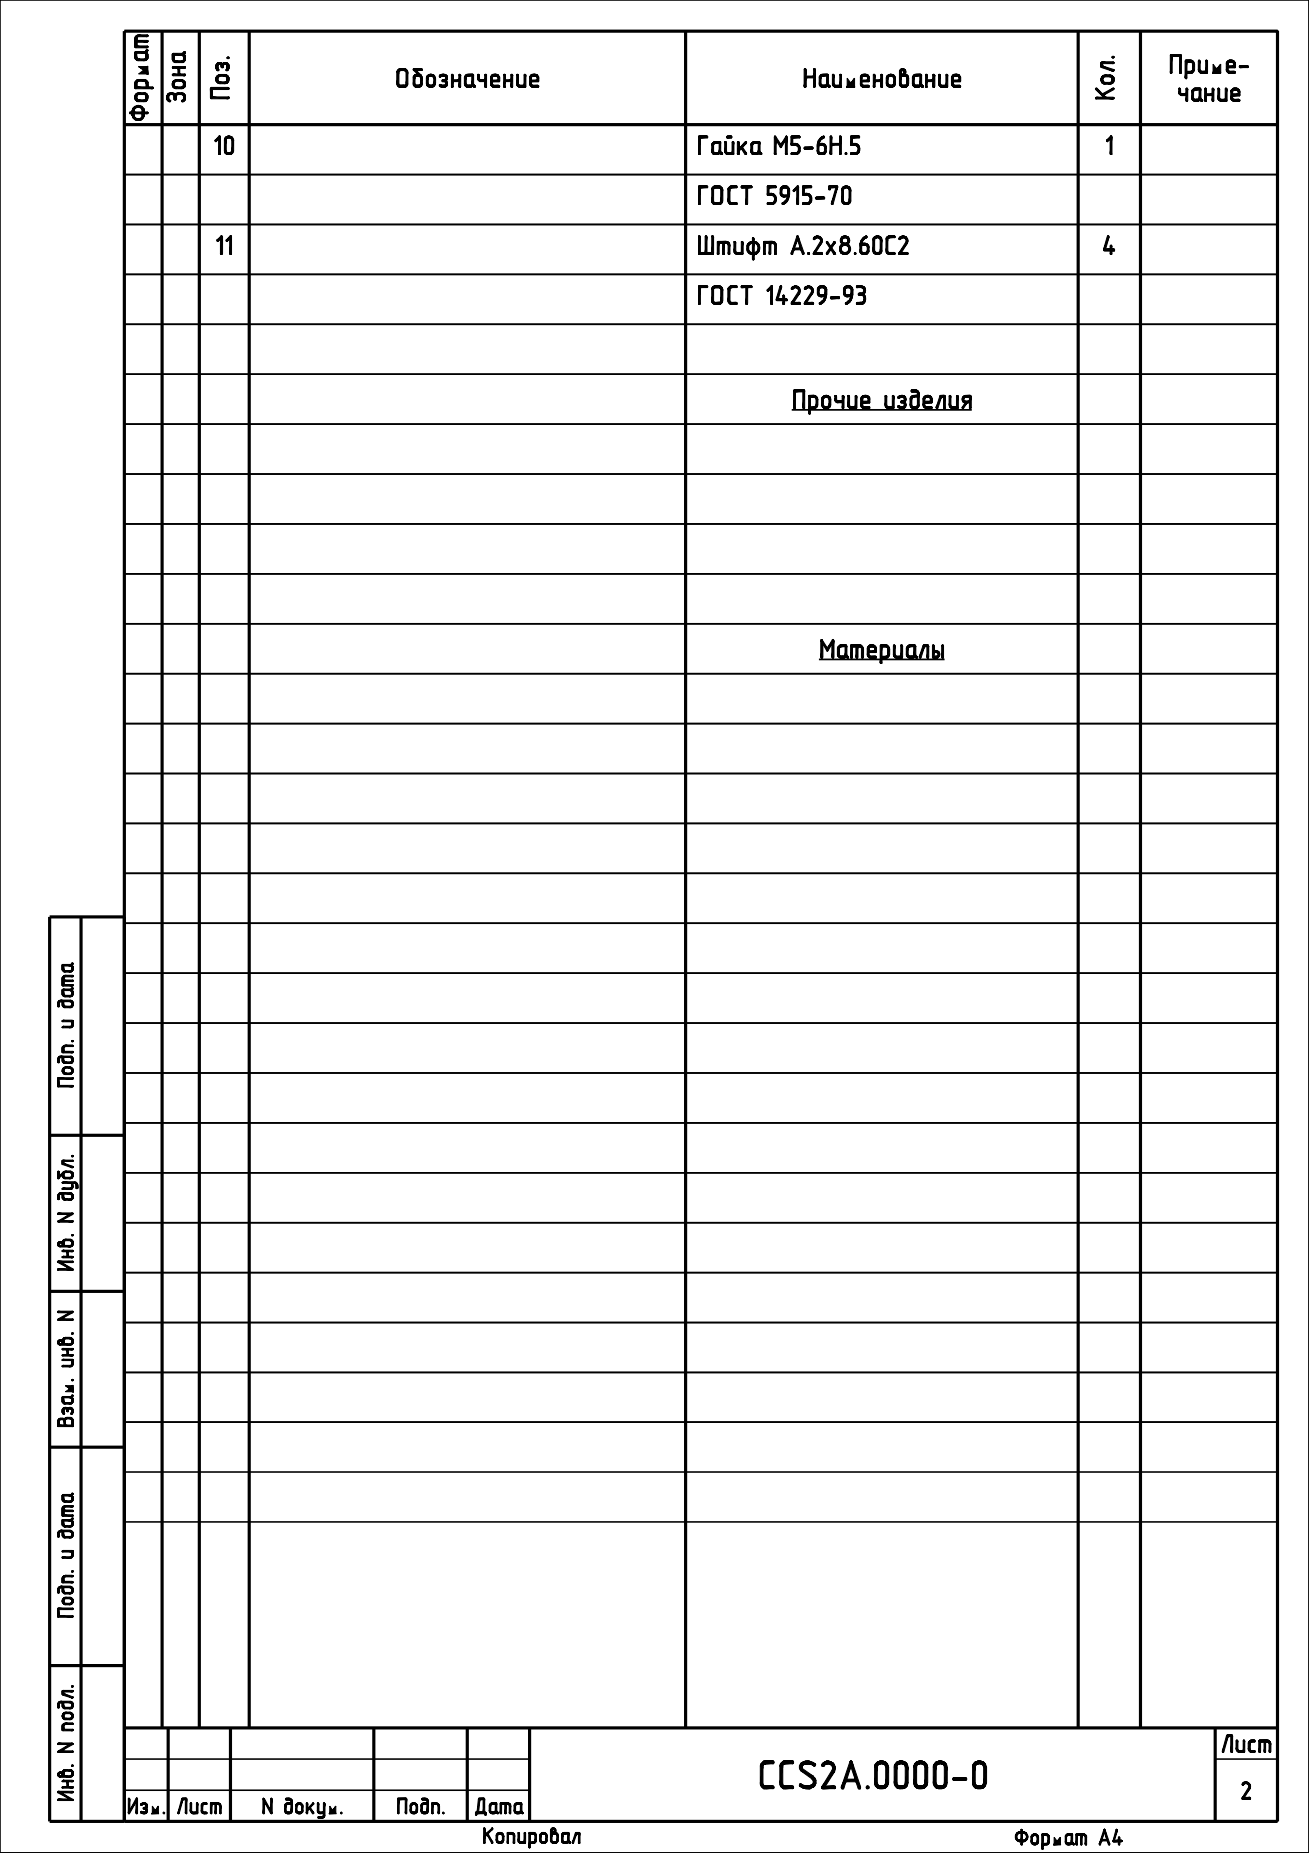
[picture p9: page 2]
