cansat-tsniimash/can-cube-sat-2022/doc/Отчетные документы на зимнюю сессию/CCS2A.0000-0ГЧ.pdf

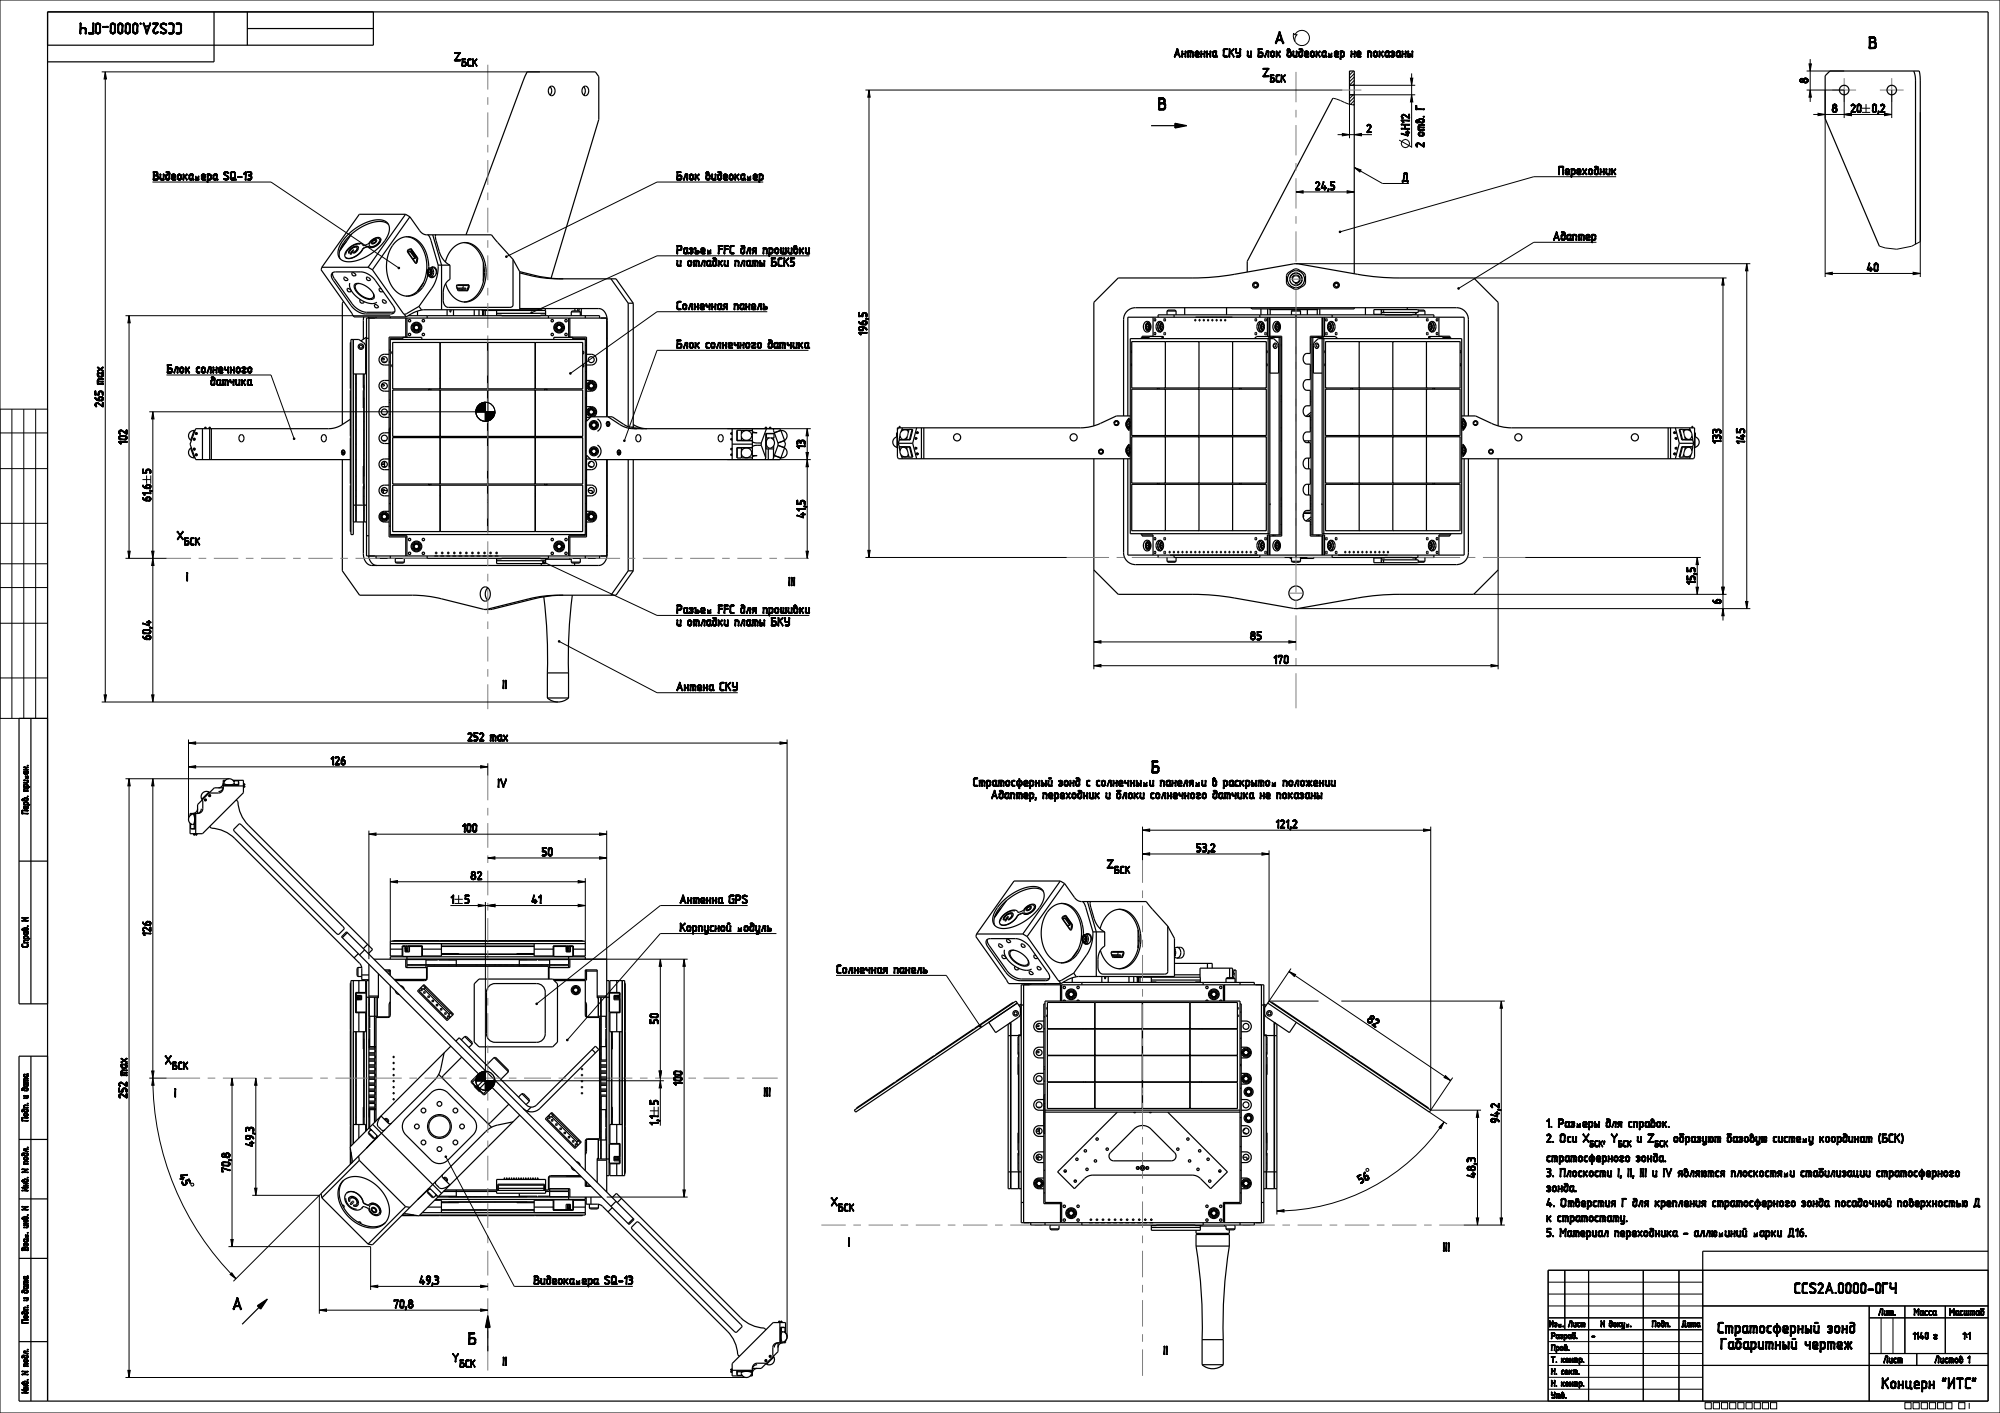
[picture p10: page 1]
III; FFC; GPS; . 3. I, II, III IV .; max 265; 252 max; max 252

CCS2A.0000-0

. | N . | . | | | 1140 | 1:1
. . | | | | 1
. . | | | " " .
. .
