cansat-tsniimash/can-cube-sat-2022/doc/Отчетные документы на зимнюю сессию/CCS2A.0000-0СБ.pdf

- (4:1

)

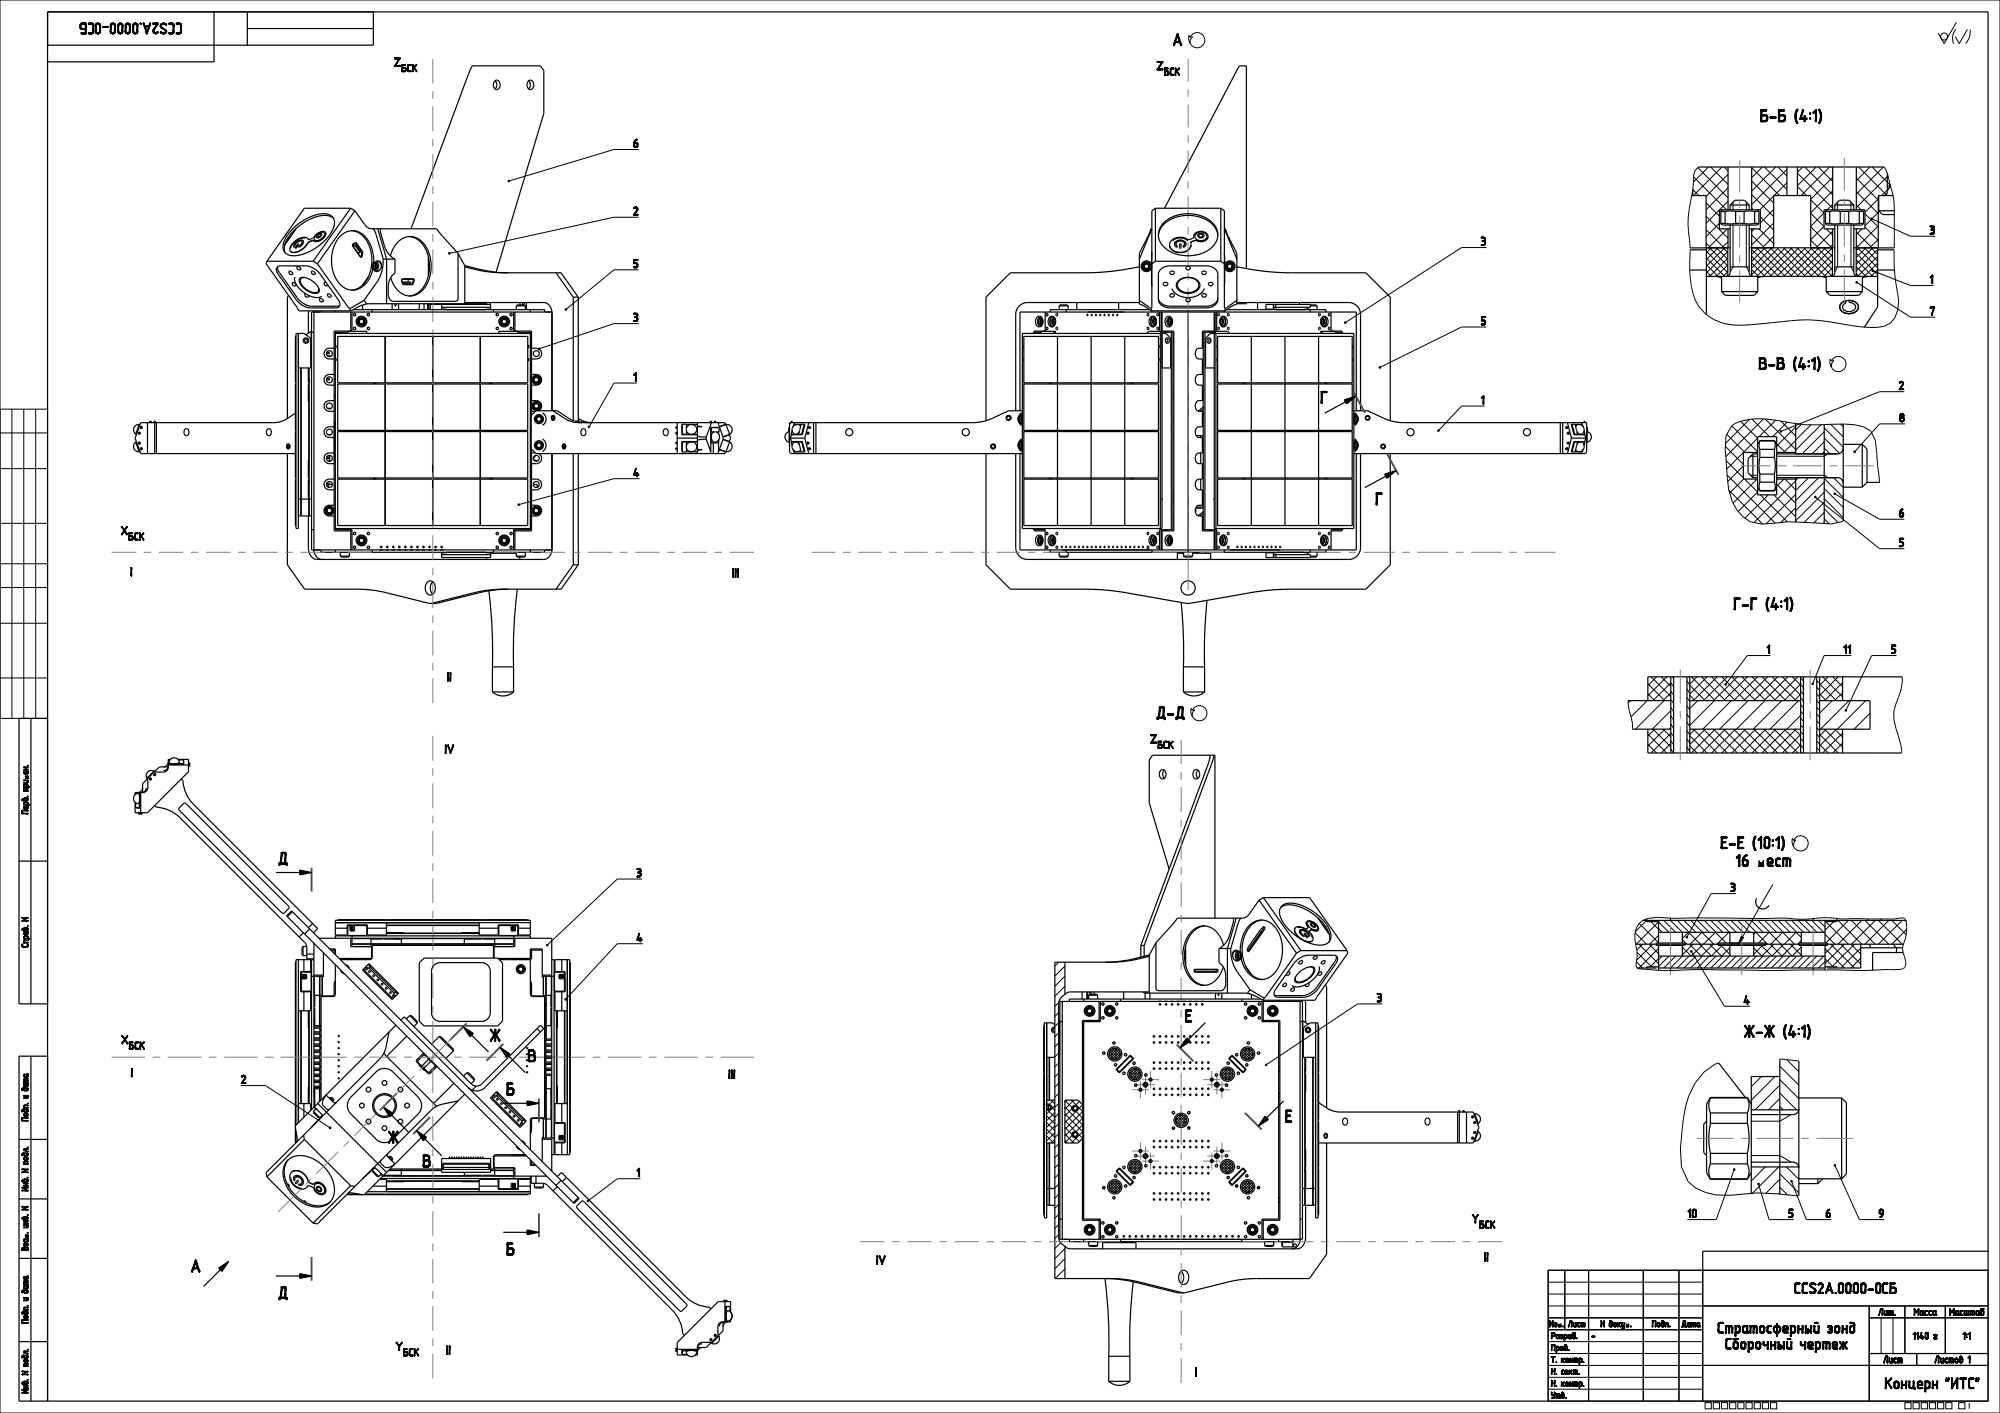
[picture p11: page 1]
III; III Y

CCS2A.0000-0

. | | N . | . | | 1140 | 1:1
. . . . | | -
