cansat-tsniimash/can-cube-sat-2022/schematics/board/ARK.brd

## EAGLE design schematics/board/ARK.brd (2022-05-21)

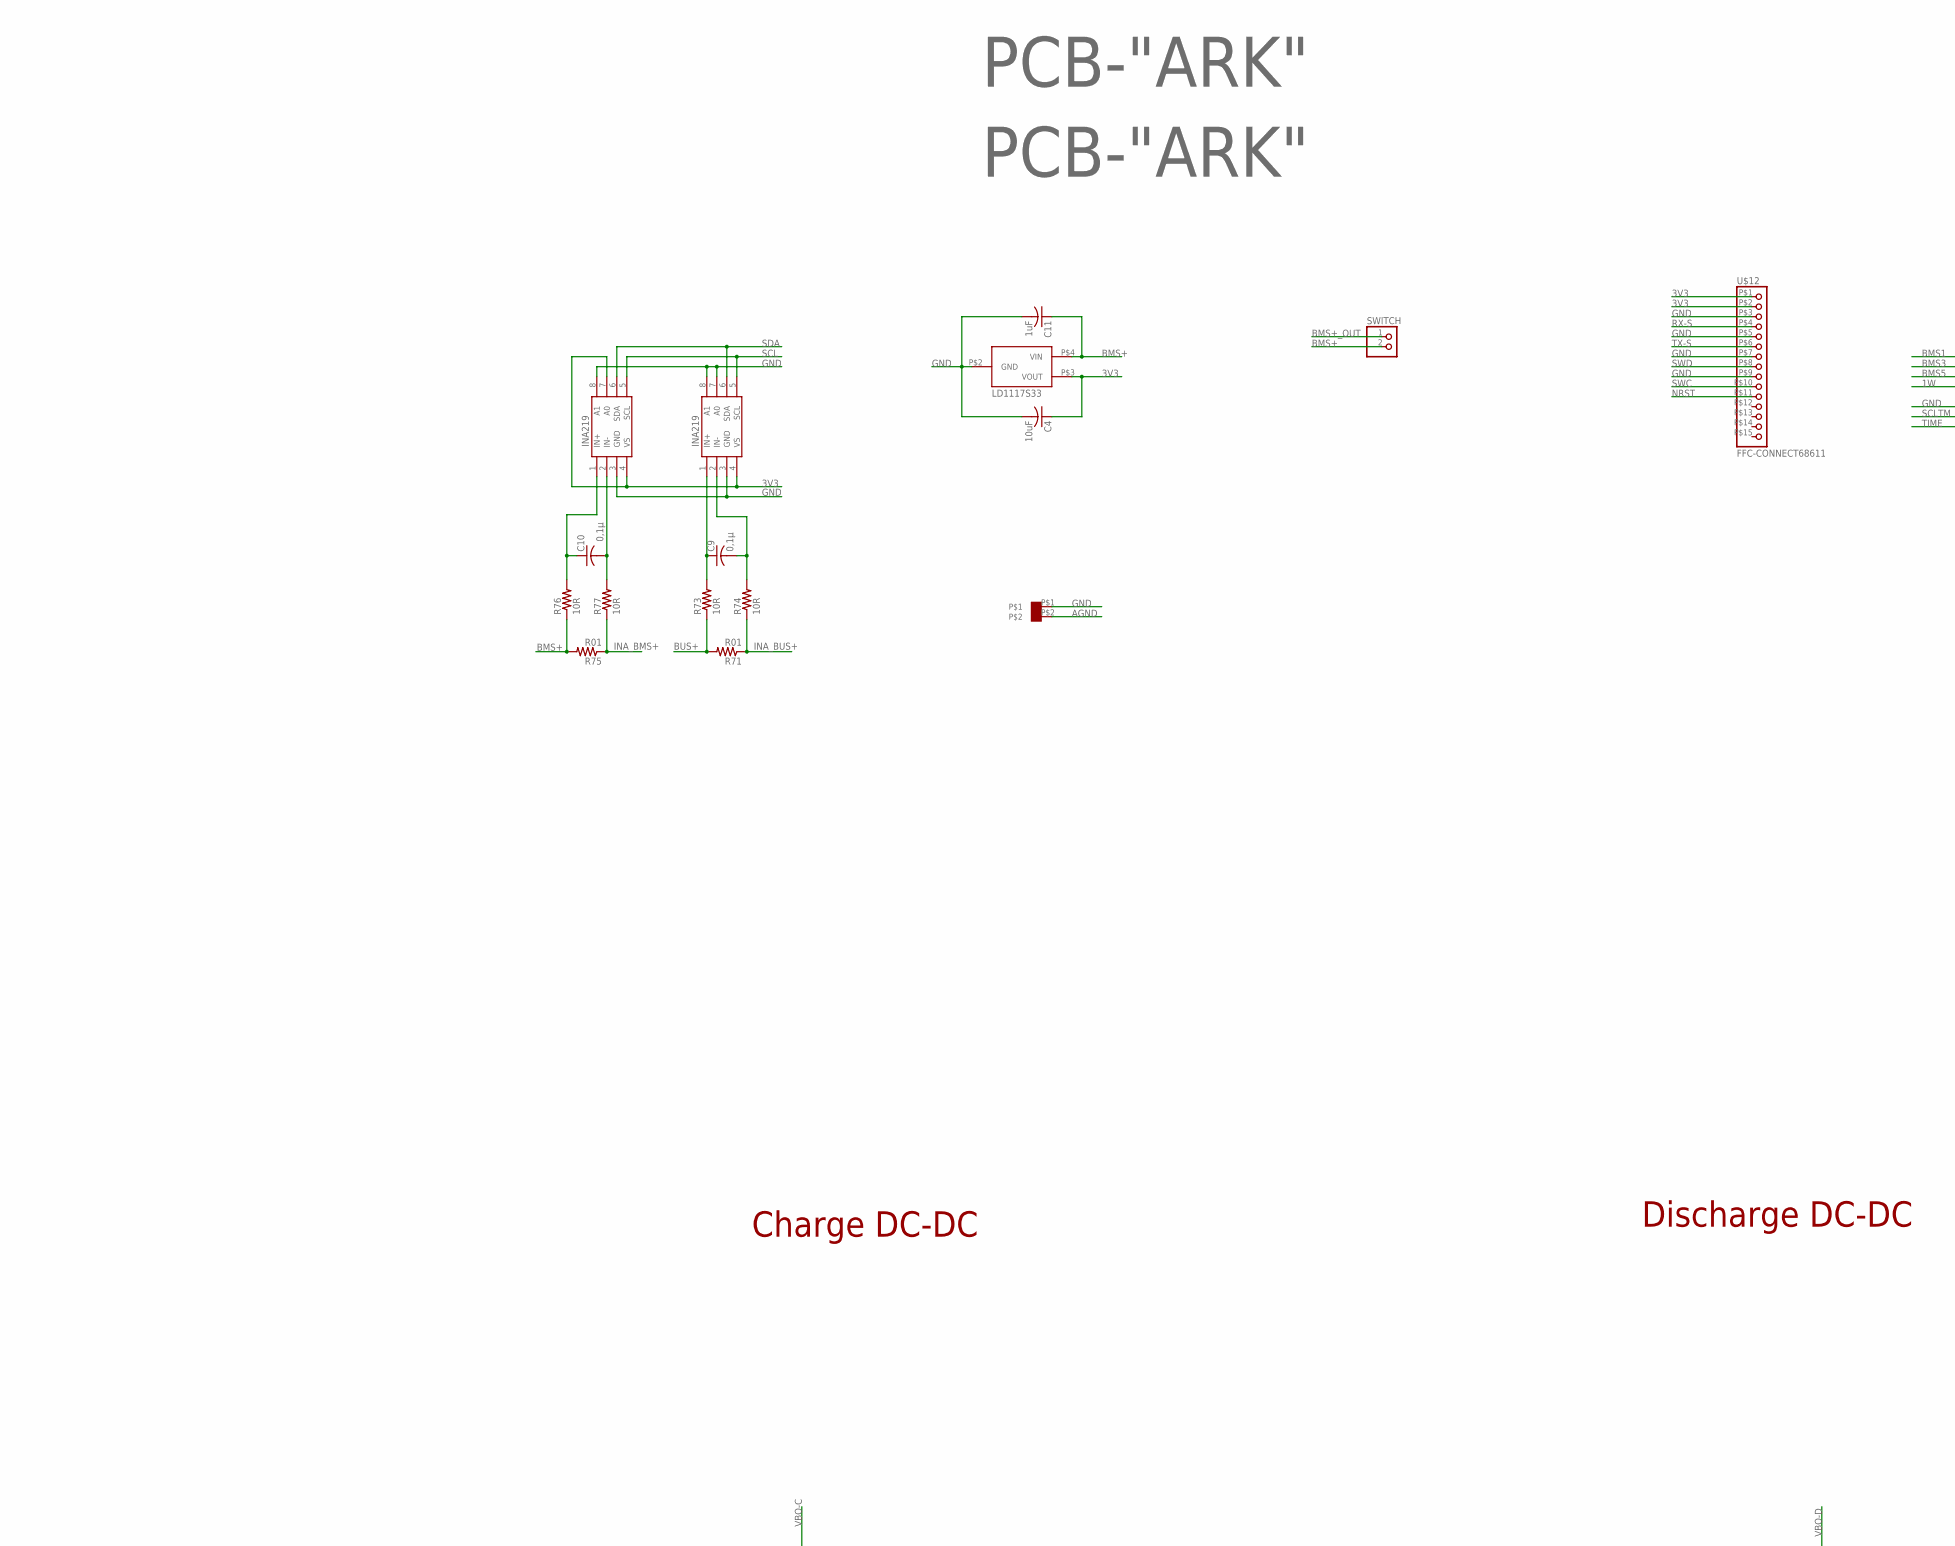
[picture p12: schematic ARK.sch, part in row 1, column 1]

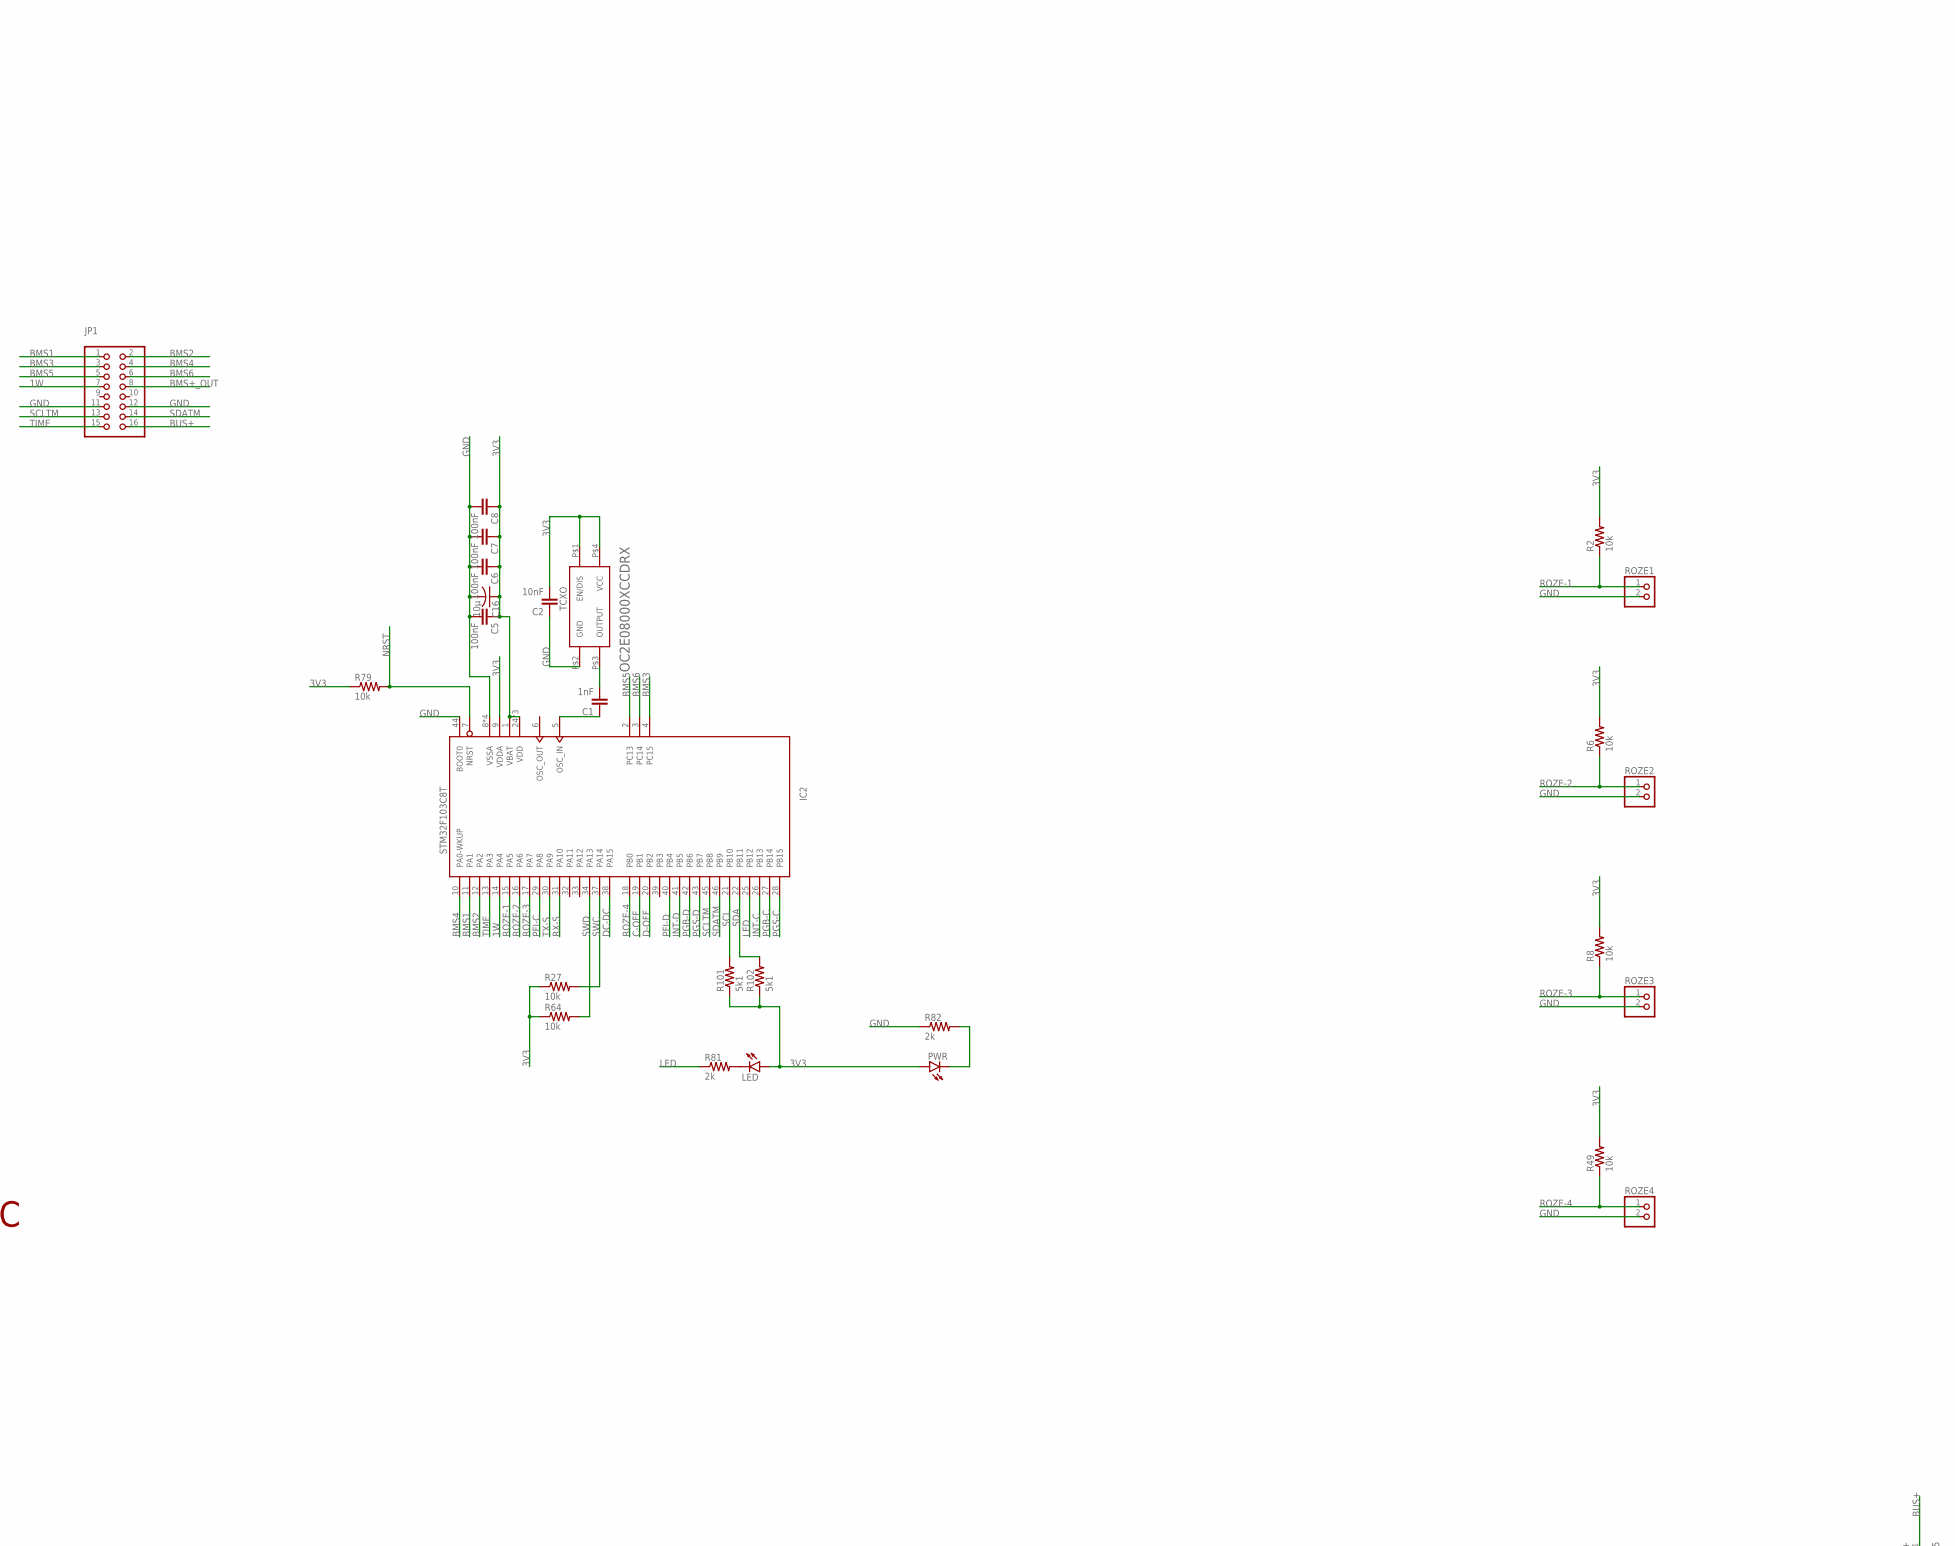
[picture p13: schematic ARK.sch, part in row 1, column 2]

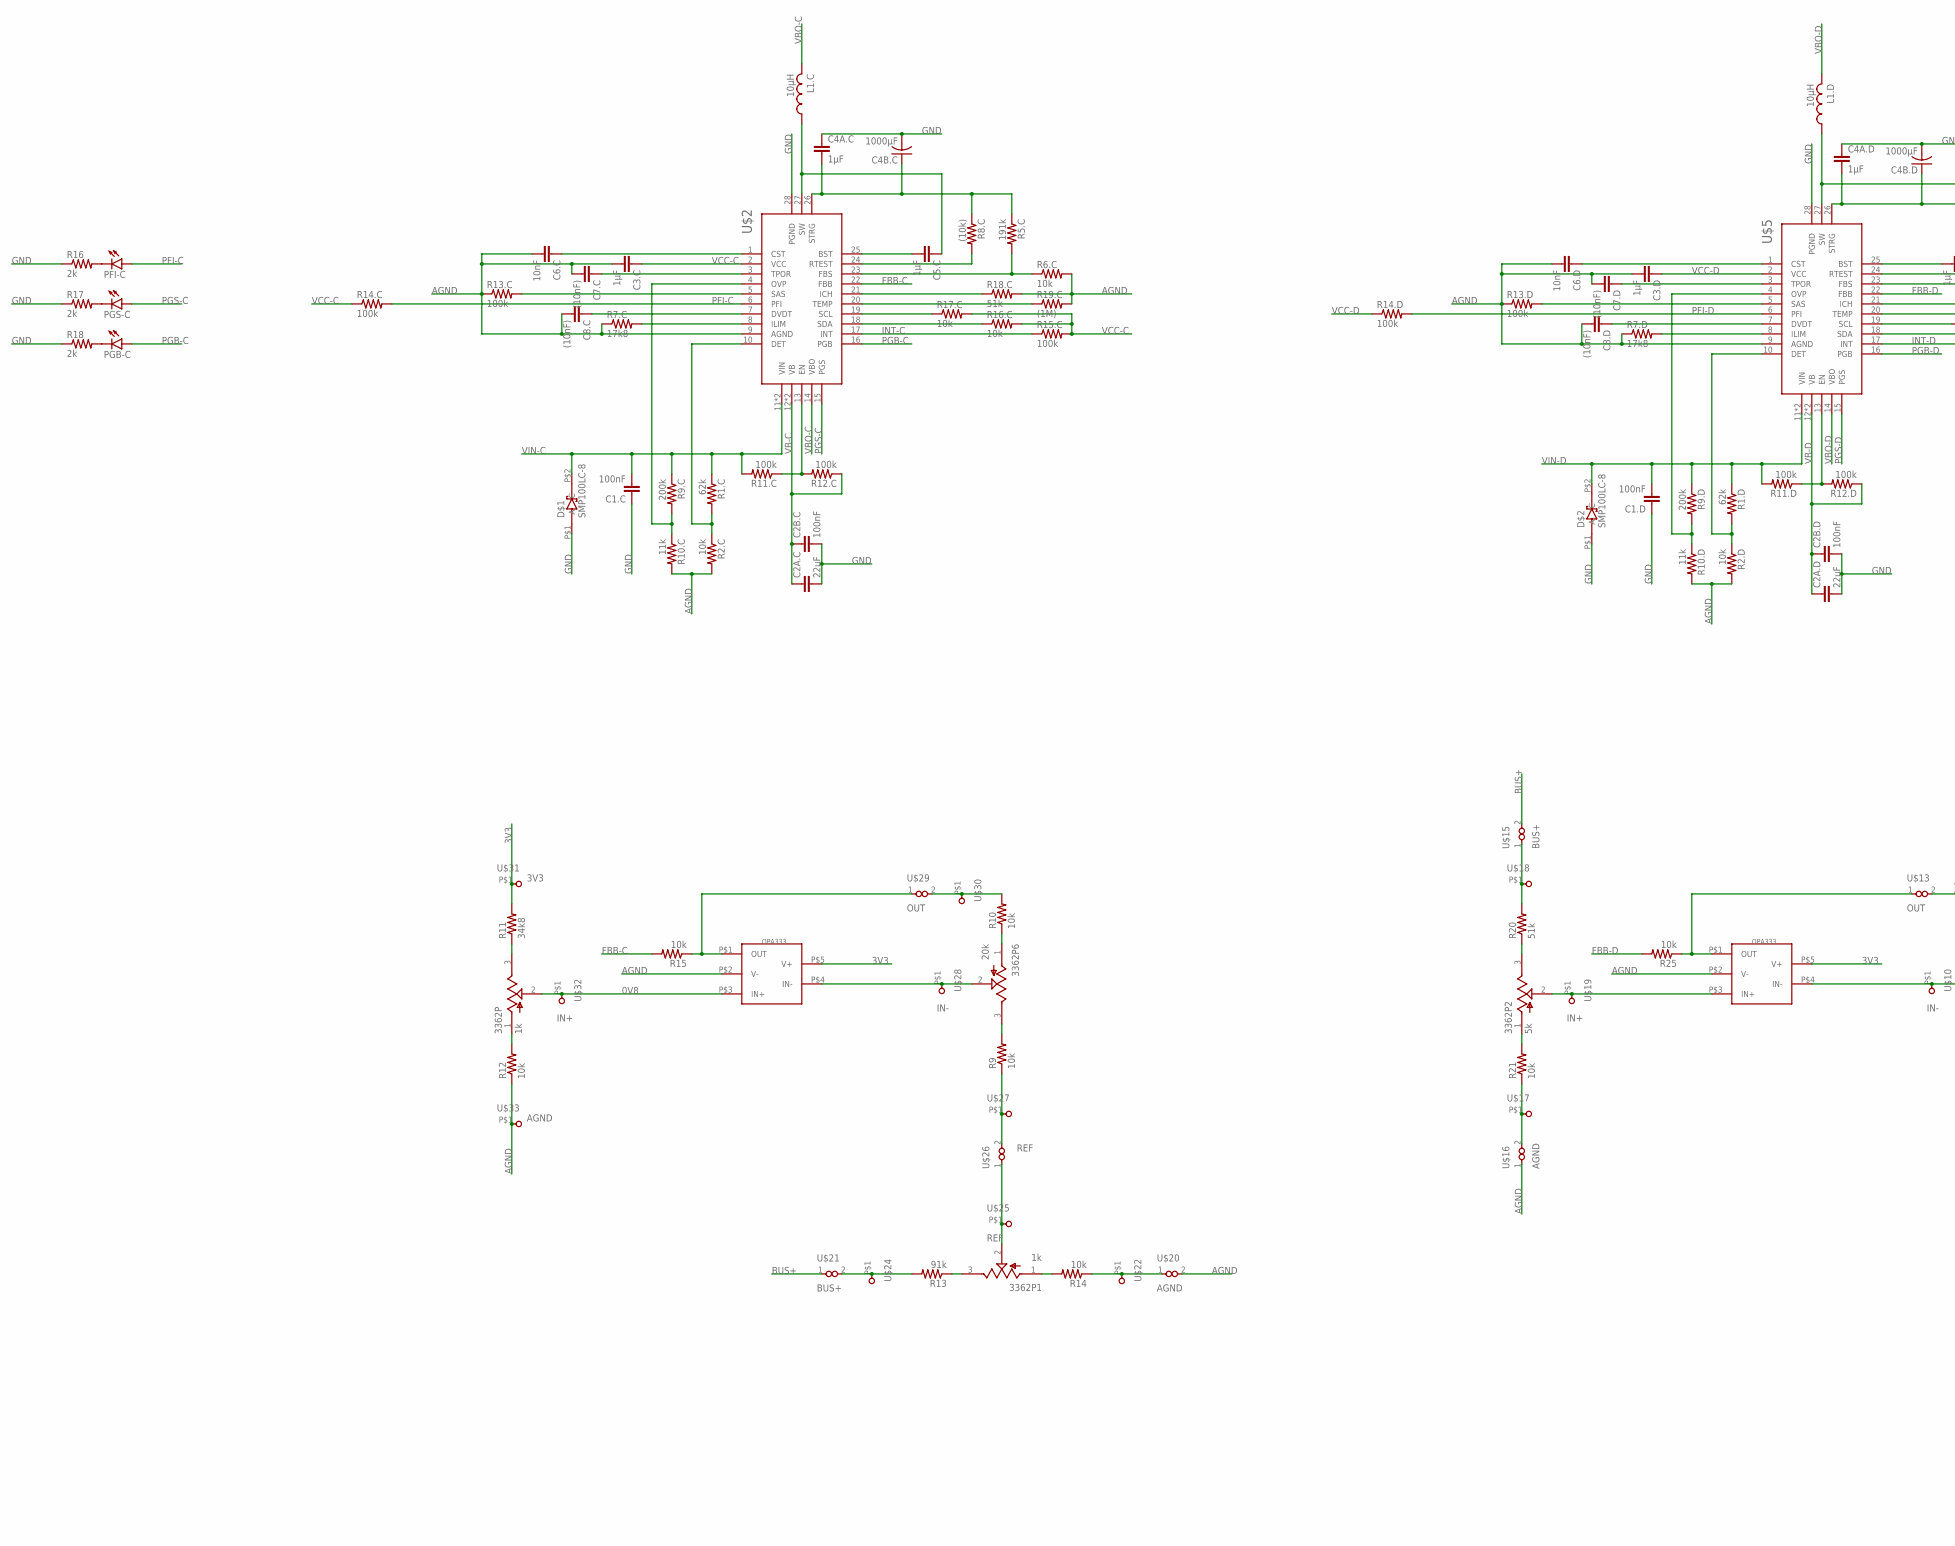
[picture p14: schematic ARK.sch, part in row 2, column 1]

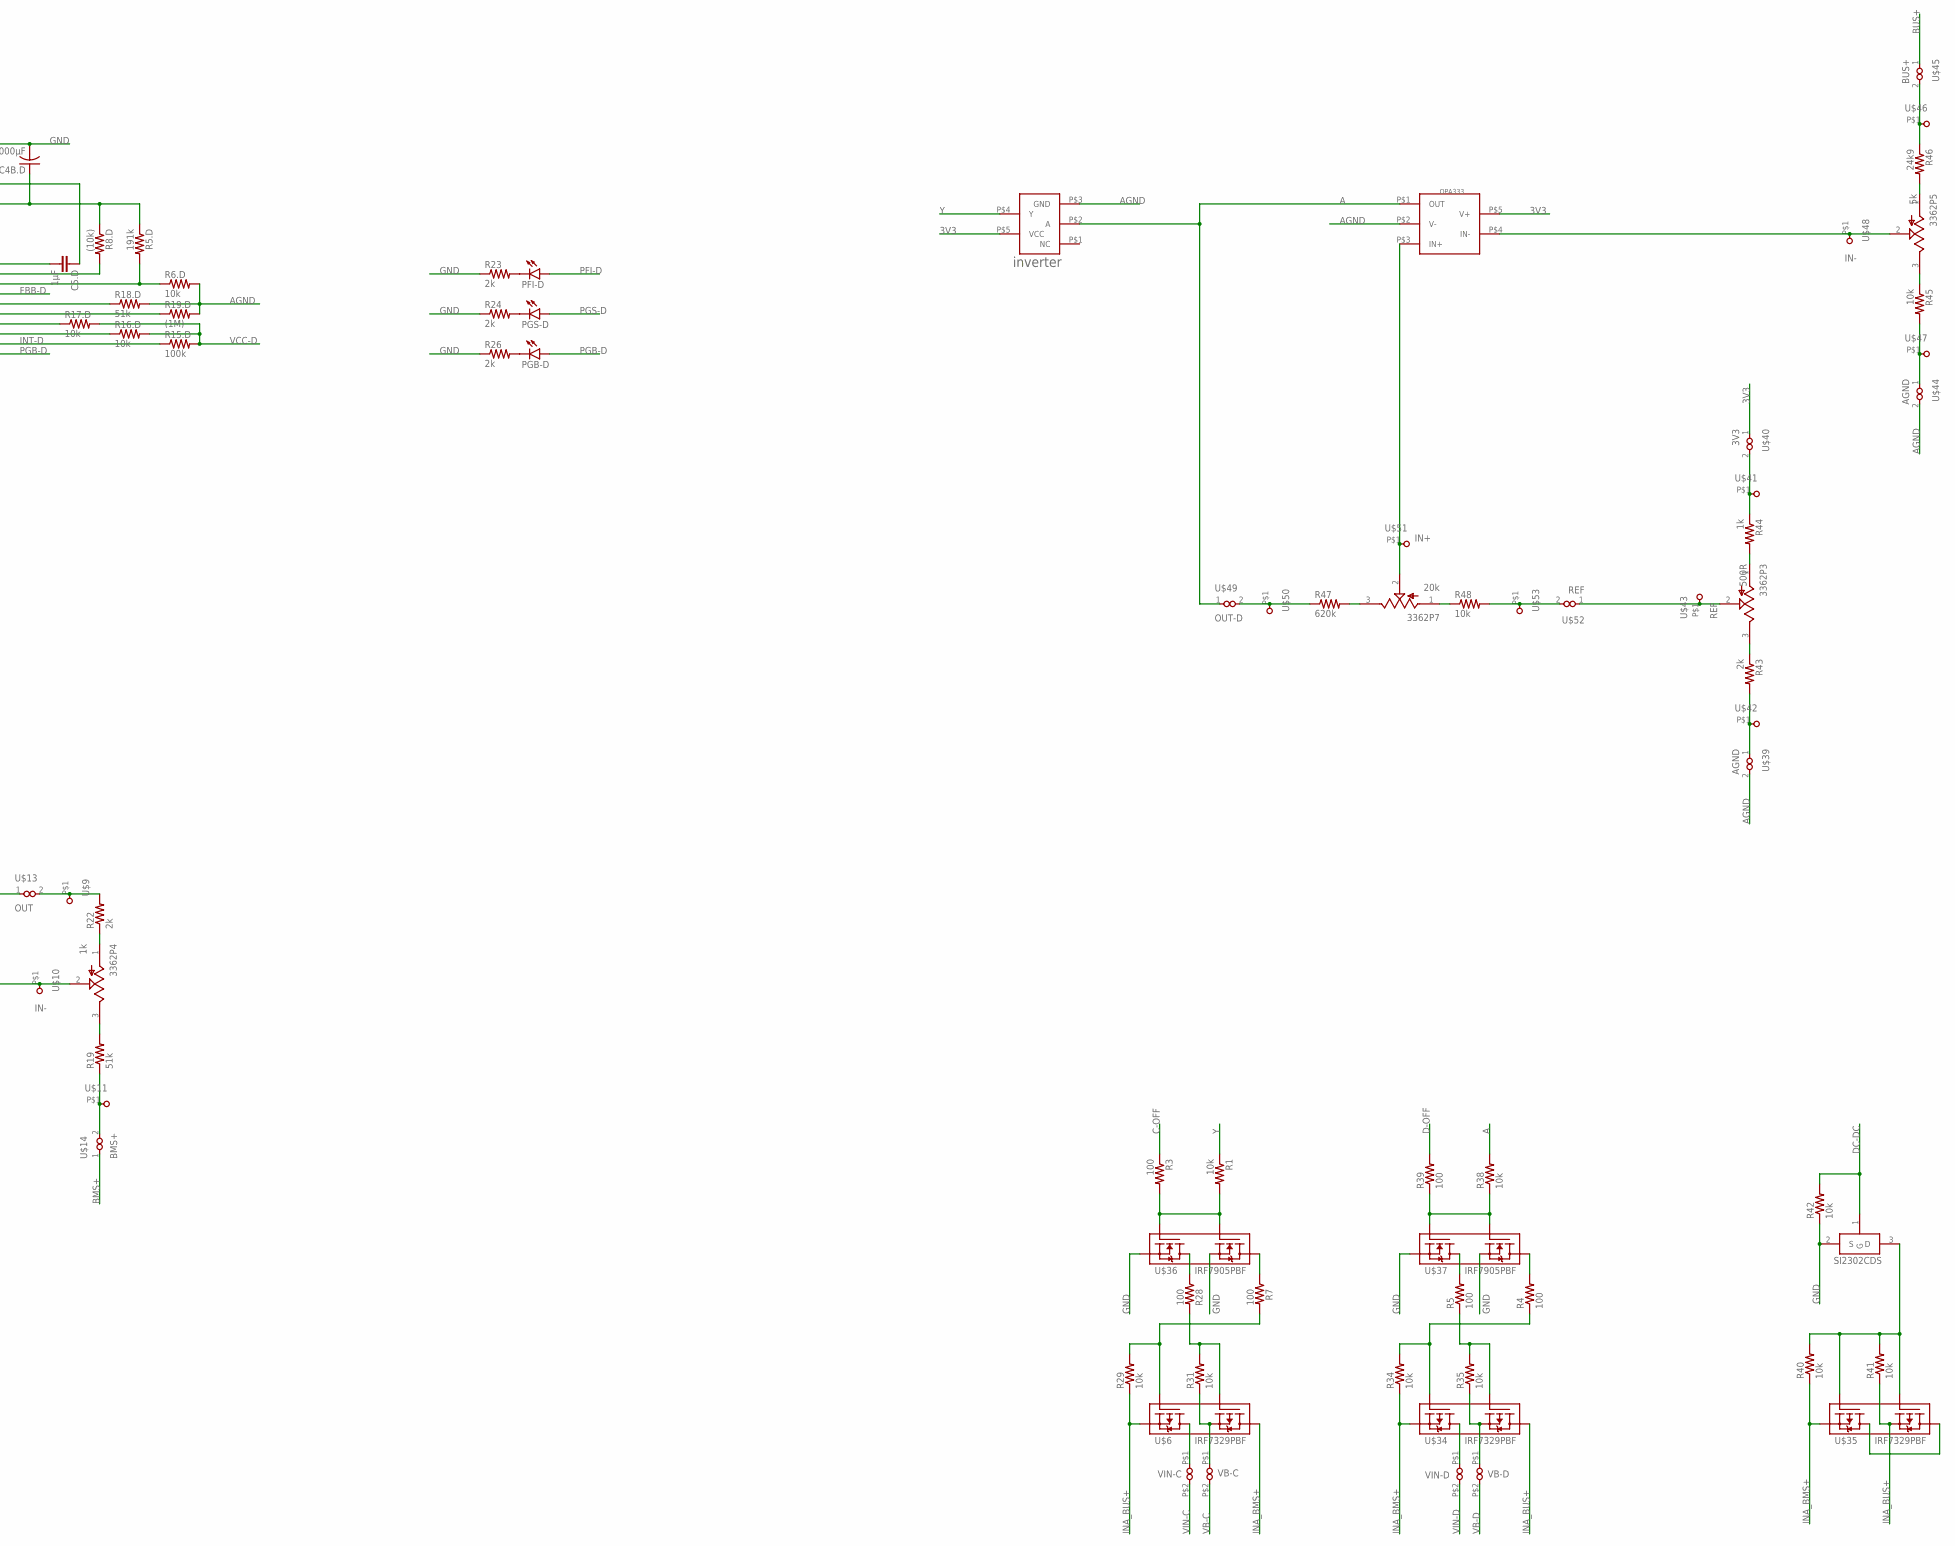
[picture p15: schematic ARK.sch, part in row 2, column 2]

Parts:
3362P, 3362P1, 3362P4: 1k; TRIM_3362P-1-502LF
3362P2, 3362P5: 5k; TRIM_3362P-1-502LF
3362P3: 500R; TRIM_3362P-1-502LF
3362P6, 3362P7: 20k; TRIM_3362P-1-502LF
C1: 1nF; C0603
C1.C, C1.D, C2B.C, C2B.D, C5, C6, C7, C8: 100nF; C0603
C2, C6.C, C6.D: 10nF; C0603
C2A.C, C2A.D: 22µF; C1206
C3.C, C3.D, C5.C, C5.D: 1µF; C0603
C4: 10uF; ECAP-SMD-D4
C4A.C, C4A.D: 1µF; C1206
C4B.C, C4B.D: 1000µF; ECAP1000-CMD
C7.C, C7.D, C8.C, C8.D: (10nF); C0603
C9, C10: 0,1µ; C0603
C11: 1uF; ECAP-SMD-D4
C16: 10µ; C1206
D$1, D$2: SMP100LC-8; SMB
IC2: STM32F103C8T; LQFP48
INA219#1, INA219#2: INA219AID; SOT23-8
INVERT1: INVERTER.; SC70
JP1: PINHD-2X8; 2X08
L1.C, L1.D: 10µH; L_12X12
LD1117S33: LD1117S33; SOT223
LED: LEDCHIPLED_0603; CHIPLED_0603
OPA1, OPA2, OPA3: OPA333; SOT23-5
PFI-C: LEDCHIPLED_0603; CHIPLED_0603
PFI-D: LEDCHIPLED_0603; CHIPLED_0603
PGB-C: LEDCHIPLED_0603; CHIPLED_0603
PGB-D: LEDCHIPLED_0603; CHIPLED_0603
PGS-C: LEDCHIPLED_0603; CHIPLED_0603
PGS-D: LEDCHIPLED_0603; CHIPLED_0603
PWR: LEDCHIPLED_0603; CHIPLED_0603
R1, R2, R2.C, R2.D, R6, R6.C, R6.D, R8, R9, R10, R12, R14, R15, R16.C, R16.D, R17.C, R17.D, R21, R25, R27, R29, R31, R34, R35, R38, R40, R41, R42, R45, R48, R49, R64, R79: 10k; R0603
R1.C, R1.D: 62k; R0603
R3, R4, R5, R7, R28, R39: 100; R0603
R5.C, R5.D: 191k; R0603
R7.C, R7.D: 17k8; R0603
R8.C, R8.D: (10k); R0603
R9.C, R9.D: 200k; R0603
R10.C, R10.D: 11k; R0603
R11: 34k8; R0603
R11.C, R11.D, R12.C, R12.D, R13.C, R13.D, R14.C, R14.D, R15.C, R15.D: 100k; R0603
R13: 91k; R0603
R16, R17, R18, R22, R23, R24, R26, R43, R81, R82: 2k; R0603
R18.C, R18.D, R19, R20: 51k; R0603
R19.C, R19.D: (1M); R0603
R44: 1k; R0603
R46: 24k9; R0603
R47: 620k; R0603
R71, R75: R01; R2512
R73, R74, R76, R77: 10R; R0603
R101, R102: 5k1; R0603
ROZE1, ROZE2, ROZE3, ROZE4: PINHD-1X2; 1X02
SWITCH: PINHD-1X2; 1X02
TCXO: OC2E08000XCCDRX
U$1: VIN-C; SOLDERING-PAD-4A
U$2, U$5: MP5515; QFN-30
U$3, U$4: PCB-"ARK"; ITS-LOGO
U$6, U$34, U$35: IRF7329PBF; SO8
U$7: GNDS-CONNECTOR
U$9, U$11, U$17, U$18, U$22, U$24, U$27, U$30, U$41, U$42, U$46, U$47, U$50, U$53: VIAS
U$10, U$28, U$48: IN-; VIAS
U$12: FFC-CONNECT68611; 68611
U$13, U$29: OUT; VIAS-CONNECT
U$14: BMS+; VIAS-CONNECT
U$15, U$21, U$45: BUS+; VIAS-CONNECT
U$16, U$20, U$39, U$44: AGND; VIAS-CONNECT
U$19, U$32, U$51: IN+; VIAS
U$23: VB-C; SOLDERING-PAD-4A
U$25, U$43: REF; VIAS
U$26, U$52: REF; VIAS-CONNECT
U$31: 3V3; VIAS
U$33: AGND; VIAS
U$36, U$37: IRF7905PBF; SO8
U$38: SI2302CDS; SOT23-3
U$40: 3V3; VIAS-CONNECT
U$49: OUT-D; VIAS-CONNECT
U$54: VIN-D; SOLDERING-PAD-4A
U$55: VB-D; SOLDERING-PAD-4A

Connections:
0V8: 3362P.2 (WIPER), OPA2.P$3 (IN+), U$32.P$1
1W: IC2.14 (PA4), JP1.7
3V3: C2.2, C4.P+ (1), C5.1, C6.1, C7.1, C8.1, C16.1, IC2.1 (VBAT), IC2.9 (VDDA), IC2.24 (VDD), IC2.36 (VDD), IC2.48 (VDD), INA219#1.4 (VS), INA219#2.4 (VS), INA219#2.7 (A0), INVERT1.P$5 (VCC), LD1117S33.P$3 (VOUT), LED.A, OPA1.P$5 (V+), OPA2.P$5 (V+), OPA3.P$5 (V+), PWR.A, R2.2, R6.2, R8.2, R11.2, R27.1, R49.2, R64.1, R79.1, R101.1, R102.1, TCXO.P$1 (EN/DIS), TCXO.P$4 (VCC), U$12.P$1 (1), U$12.P$2 (2), U$31.P$1, U$40.1
A: INVERT1.P$2 (A), OPA1.P$1 (OUT), R38.2, U$49.1
AGND: C3.C.2, C3.D.2, C6.C.2, C6.D.2, C7.C.2, C7.D.2, C8.C.2, C8.D.2, INVERT1.P$3 (GND), OPA1.P$2 (V-), OPA2.P$2 (V-), OPA3.P$2 (V-), R2.C.2, R2.D.2, R6.C.2, R6.D.2, R7.C.1, R7.D.1, R10.C.2, R10.D.2, R12.1, R13.C.1, R13.D.1, R18.C.2, R18.D.2, R19.C.2, R19.D.2, U$2.9 (AGND), U$5.9 (AGND), U$7.P$2, U$16.1, U$20.2, U$33.P$1, U$39.2, U$44.2
BMS1: IC2.11 (PA1), JP1.1
BMS2: IC2.12 (PA2), JP1.2
BMS3: IC2.4 (PC15), JP1.3
BMS4: IC2.10 (PA0-WKUP), JP1.4
BMS5: IC2.2 (PC13), JP1.5
BMS6: IC2.3 (PC14), JP1.6
BMS+: C11.P+ (1), LD1117S33.P$4 (VIN), R75.2, R76.1, SWITCH.2, U$14.1
BMS+_OUT: JP1.8, SWITCH.1
BUS+: JP1.16, R71.2, R73.1, U$15.2, U$21.1, U$45.1
C-OFF: IC2.19 (PB1), R3.1
D-OFF: IC2.20 (PB2), R39.2
DC-DC: IC2.38 (PA15), R42.2, U$38.1 (G)
FBB-C: R15.2, U$2.22 (FBB)
FBB-D: R25.2, U$5.22 (FBB)
GND: C1.C.1, C1.D.1, C2.1, C2A.C.2, C2A.D.2, C2B.C.2, C2B.D.2, C4.P- (2), C4A.C.1, C4A.D.1, C4B.C.P$2 (2), C4B.D.P$2 (2), C5.2, C6.2, C7.2, C8.2, C11.P- (2), C16.2, D$1.P$1 (A), D$2.P$1 (A), IC2.8 (VSSA), IC2.23 (VSSA), IC2.35 (VSSA), IC2.44 (BOOT0), IC2.47 (VSSA), INA219#1.3 (GND), INA219#1.7 (A0), INA219#1.8 (A1), INA219#2.3 (GND), INA219#2.8 (A1), JP1.11, JP1.12, LD1117S33.P$2 (GND), R16.1, R17.1, R18.1, R23.1, R24.1, R26.1, R42.1, R82.1, ROZE1.2, ROZE2.2, ROZE3.2, ROZE4.2, TCXO.P$2 (GND), U$2.28 (PGND), U$5.28 (PGND), U$7.P$1, U$12.P$3 (3), U$12.P$5 (5), U$12.P$7 (7), U$12.P$9 (9), U$36.1 (S2), U$36.3 (S1), U$37.1 (S2), U$37.3 (S1), U$38.2 (S)
INA_BMS+: R34.1, R40.1, R75.1, R77.1, U$6.7 (D1), U$6.8 (D1), U$34.3 (S2), U$35.3 (S2)
INA_BUS+: R29.1, R41.1, R71.1, R74.1, U$6.3 (S2), U$34.7 (D1), U$34.8 (D1), U$35.1 (S1)
INT-C: IC2.26 (PB13), R15.C.1, U$2.17 (INT)
INT-D: IC2.41 (PB5), R15.D.1, U$5.17 (INT)
LED: IC2.25 (PB12), R81.1
unnamed: C1.1, IC2.5 (OSC_IN)
unnamed: U$1.P$1 (1), U$6.5 (D2), U$6.6 (D2)
unnamed: R31.1, U$6.1 (S1), U$23.P$1 (1)
unnamed: C1.2, TCXO.P$3 (OUTPUT)
unnamed: R4.1, R34.2, U$34.4 (G2)
unnamed: OPA3.P$1 (OUT), R25.1, U$13.1
unnamed: R11.C.1, R12.C.2, U$2.13 (EN)
unnamed: R7.C.2, U$2.8 (ILIM)
unnamed: C7.C.1, U$2.3 (TPOR)
unnamed: R1.C.2, R2.C.1, U$2.10 (DET)
unnamed: R9.C.2, R10.C.1, U$2.4 (OVP)
unnamed: C8.C.1, U$2.7 (DVDT)
unnamed: R18.C.1, U$2.21 (ICH)
unnamed: C9.2, INA219#1.2 (IN-), R74.2
unnamed: R19.C.1, U$2.20 (TEMP)
unnamed: R13.C.2, U$2.5 (SAS)
unnamed: LED.C, R81.2
unnamed: C6.C.1, U$2.1 (CST)
unnamed: C4A.C.2, C4B.C.P$1 (1), R5.C.1, R8.C.1, U$2.26 (STRG)
unnamed: C5.C.2, U$2.25 (BST)
unnamed: C5.C.1, L1.C.P$1 (1), U$2.27 (SW)
unnamed: R5.C.2, R6.C.1, U$2.23 (FBS)
unnamed: R8.C.2, U$2.24 (RTEST)
unnamed: 3362P4.1 (CCW), R22.1
unnamed: R7.2, R29.2, U$6.4 (G2)
unnamed: R17.C.1, U$2.19 (SCL)
unnamed: R16.C.1, U$2.18 (SDA)
unnamed: R5.1, R35.2, U$34.2 (G1)
unnamed: 3362P2.2 (WIPER), OPA3.P$3 (IN+), U$19.P$1
unnamed: R11.D.1, R12.D.2, U$5.13 (EN)
unnamed: R1.D.2, R2.D.1, U$5.10 (DET)
unnamed: R9.D.2, R10.D.1, U$5.4 (OVP)
unnamed: R7.D.2, U$5.8 (ILIM)
unnamed: C7.D.1, U$5.3 (TPOR)
unnamed: C8.D.1, U$5.7 (DVDT)
unnamed: R18.D.1, U$5.21 (ICH)
unnamed: R19.D.1, U$5.20 (TEMP)
unnamed: R13.D.2, U$5.5 (SAS)
unnamed: C6.D.1, U$5.1 (CST)
unnamed: C5.D.2, U$5.25 (BST)
unnamed: C5.D.1, L1.D.P$1 (1), U$5.27 (SW)
unnamed: R5.D.2, R6.D.1, U$5.23 (FBS)
unnamed: R8.D.2, U$5.24 (RTEST)
unnamed: C4A.D.2, C4B.D.P$1 (1), R5.D.1, R8.D.1, U$5.26 (STRG)
unnamed: U$35.5 (D2), U$35.6 (D2), U$35.7 (D1), U$35.8 (D1)
unnamed: R17.D.1, U$5.19 (SCL)
unnamed: R1.2, R3.2, U$36.2 (G2), U$36.4 (G1)
unnamed: R16.D.1, U$5.18 (SDA)
unnamed: U$34.5 (D2), U$34.6 (D2), U$54.P$1 (1)
unnamed: R38.1, R39.1, U$37.2 (G2), U$37.4 (G1)
unnamed: OPA2.P$1 (OUT), R15.1, U$29.1
unnamed: 3362P6.2 (WIPER), OPA2.P$4 (IN-), U$28.P$1
unnamed: 3362P6.3 (CW), R9.2
unnamed: 3362P6.1 (CCW), R10.1
unnamed: PFI-C.C, R16.2
unnamed: 3362P.3 (CW), R11.1
unnamed: 3362P.1 (CCW), R12.2
unnamed: 3362P1.3 (CW), R13.1
unnamed: 3362P1.1 (CCW), R14.2
unnamed: 3362P1.2 (WIPER), U$25.P$1, U$26.1
unnamed: 3362P2.3 (CW), R20.1
unnamed: PGS-C.C, R17.2
unnamed: 3362P2.1 (CCW), R21.2
unnamed: PGB-C.C, R18.2
unnamed: 3362P4.2 (WIPER), OPA3.P$4 (IN-), U$10.P$1
unnamed: 3362P4.3 (CW), R19.2
unnamed: PFI-D.C, R23.2
unnamed: PGS-D.C, R24.2
unnamed: PGB-D.C, R26.2
unnamed: R22.2, U$9.P$1, U$13.2
unnamed: R19.1, U$11.P$1, U$14.2
unnamed: R20.2, U$15.1, U$18.P$1
unnamed: R21.1, U$16.2, U$17.P$1
unnamed: R13.2, U$21.2, U$24.P$1
unnamed: R14.1, U$20.1, U$22.P$1
unnamed: R35.1, U$34.1 (S1), U$55.P$1 (1)
unnamed: R5.2, U$37.7 (D2), U$37.8 (D2)
unnamed: R28.1, U$36.7 (D2), U$36.8 (D2)
unnamed: R4.2, U$37.5 (D1), U$37.6 (D1)
unnamed: R7.1, U$36.5 (D1), U$36.6 (D1)
unnamed: R9.1, U$26.2, U$27.P$1
unnamed: R10.2, U$29.2, U$30.P$1
unnamed: R28.2, R31.2, U$6.2 (G1)
unnamed: 3362P3.3 (CW), R43.1
unnamed: 3362P3.1 (CCW), R44.2
unnamed: 3362P3.2 (WIPER), U$43.P$1, U$52.1
unnamed: R40.2, R41.2, U$35.2 (G1), U$35.4 (G2), U$38.3 (D)
unnamed: R43.2, U$39.1, U$42.P$1
unnamed: R44.1, U$40.2, U$41.P$1
unnamed: 3362P5.3 (CW), R45.1
unnamed: 3362P5.1 (CCW), R46.2
unnamed: 3362P5.2 (WIPER), OPA1.P$4 (IN-), U$48.P$1
unnamed: R45.2, U$44.1, U$47.P$1
unnamed: R46.1, U$45.2, U$46.P$1
unnamed: 3362P7.1 (CCW), R48.1
unnamed: 3362P7.2 (WIPER), OPA1.P$3 (IN+), U$51.P$1
unnamed: 3362P7.3 (CW), R47.2
unnamed: R47.1, U$49.2, U$50.P$1
unnamed: R48.2, U$52.2, U$53.P$1
unnamed: C9.1, INA219#1.1 (IN+), R73.2
unnamed: C10.1, INA219#2.1 (IN+), R76.2
unnamed: C10.2, INA219#2.2 (IN-), R77.2
unnamed: PWR.C, R82.2
NRST: IC2.7 (NRST), R79.2, U$12.P$11 (11)
PFI-C: IC2.29 (PA8), PFI-C.A, R14.C.2, U$2.6 (PFI)
PFI-D: IC2.40 (PB4), PFI-D.A, R14.D.2, U$5.6 (PFI)
PGB-C: IC2.27 (PB14), PGB-C.A, U$2.16 (PGB)
PGB-D: IC2.42 (PB6), PGB-D.A, U$5.16 (PGB)
PGS-C: IC2.28 (PB15), PGS-C.A, U$2.15 (PGS)
PGS-D: IC2.43 (PB7), PGS-D.A, U$5.15 (PGS)
ROZE-1: IC2.15 (PA5), R2.1, ROZE1.1
ROZE-2: IC2.16 (PA6), R6.1, ROZE2.1
ROZE-3: IC2.17 (PA7), R8.1, ROZE3.1
ROZE-4: IC2.18 (PB0), R49.1, ROZE4.1
RX-S: IC2.31 (PA10), U$12.P$4 (4)
SCL: IC2.21 (PB10), INA219#1.5 (SCL), INA219#2.5 (SCL), R101.2
SCLTM: IC2.45 (PB8), JP1.13
SDA: IC2.22 (PB11), INA219#1.6 (SDA), INA219#2.6 (SDA), R102.2
SDATM: IC2.46 (PB9), JP1.14
SWC: IC2.37 (PA14), R27.2, U$12.P$10 (10)
SWD: IC2.34 (PA13), R64.2, U$12.P$8 (8)
TIME: IC2.13 (PA3), JP1.15
TX-S: IC2.30 (PA9), U$12.P$6 (6)
VB-C: C2A.C.1, C2B.C.1, R12.C.1, U$2.12 (VB), U$2.29 (VB), U$23.P$2 (2)
VB-D: C2A.D.1, C2B.D.1, R12.D.1, U$5.12 (VB), U$5.29 (VB), U$55.P$2 (2)
VBO-C: L1.C.P$2 (2), U$2.14 (VBO)
VBO-D: L1.D.P$2 (2), U$5.14 (VBO)
VCC-C: C3.C.1, R14.C.1, R15.C.2, R16.C.2, R17.C.2, U$2.2 (VCC)
VCC-D: C3.D.1, R14.D.1, R15.D.2, R16.D.2, R17.D.2, U$5.2 (VCC)
VIN-C: C1.C.2, D$1.P$2 (C), R1.C.1, R9.C.1, R11.C.2, U$1.P$2 (2), U$2.11 (VIN), U$2.30 (VIN)
VIN-D: C1.D.2, D$2.P$2 (C), R1.D.1, R9.D.1, R11.D.2, U$5.11 (VIN), U$5.30 (VIN), U$54.P$2 (2)
Y: INVERT1.P$4 (Y), R1.1

Notes on the sheet:
Charge DC-DC
Discharge DC-DC

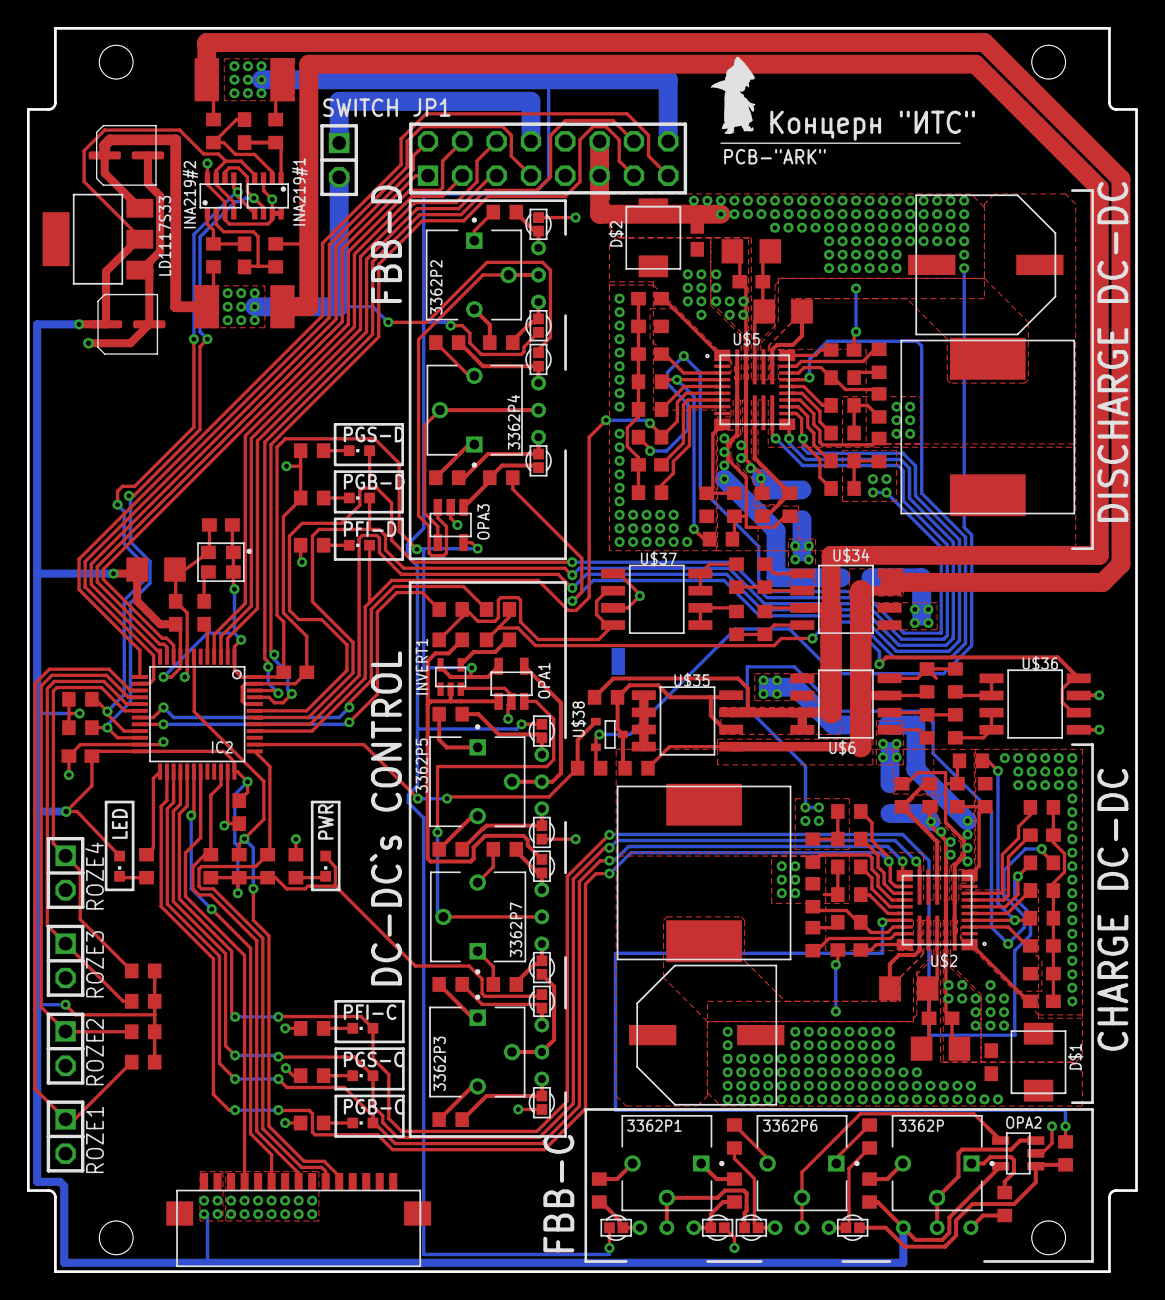
[picture p16: board ARK.brd from above]

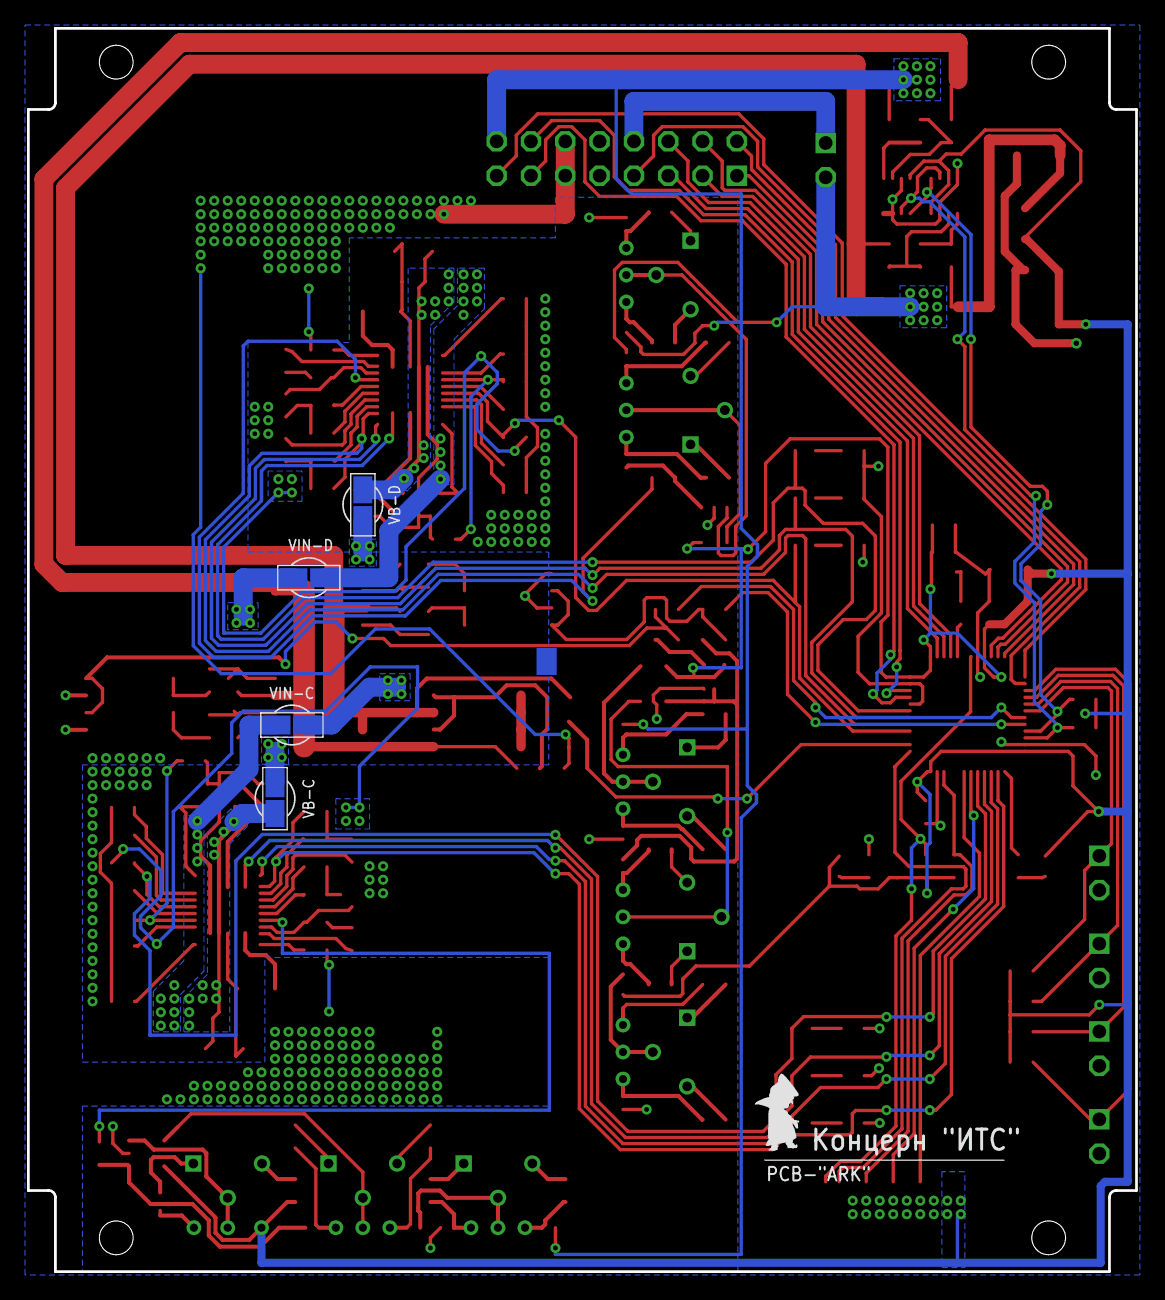
[picture p17: board ARK.brd from below]

Board: 2 copper layers, 82.0 x 92.0 mm, 210 parts (6 on the bottom side), 157 nets.
