cansat-tsniimash/can-cube-sat-2022/schematics/board/SPin.brd

## EAGLE design schematics/board/SPin.brd (2022-05-02)

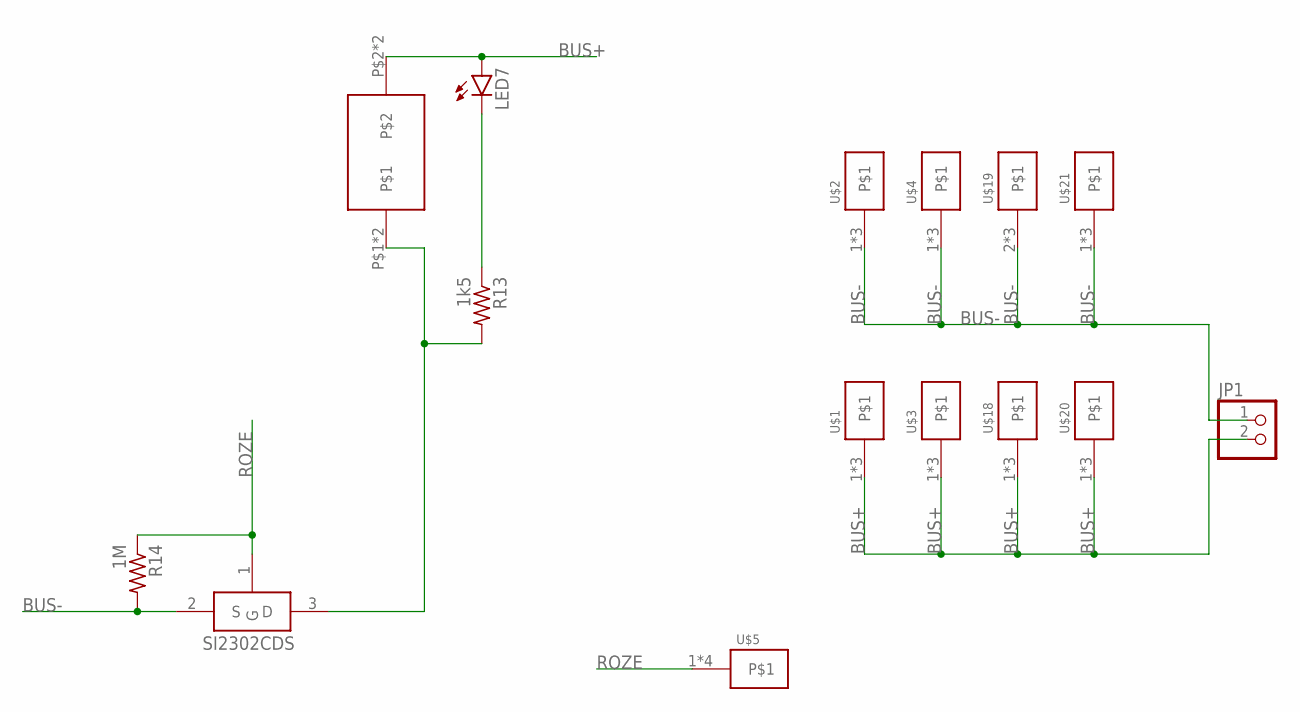
[picture p18: schematic SPin.sch]

Parts:
JP1: PINHD-1X2; 1X02
LED7: LEDCHIPLED_0603; CHIPLED_0603
R13: 1k5; R0603
R14: 1M; R0603
U$1, U$2, U$20, U$21: KCONNECT3; KCONNECT-3
U$3, U$4, U$18: KCONNECT4; KCONNECT-4
U$5: KCONNECTQUAD-; KCONNECT-_QUAD
U$6: GRAFITGRAFIT4_2; GRAFIT4_2
U$13: SI2302CDS; SOT23-3
U$19: KCONNECT1; KCONNECT-1

Connections:
2: R13.2, U$6.P$1, U$6.P$4, U$13.3 (D)
BUS+: JP1.2, LED7.A, U$1.1, U$1.2, U$1.4, U$3.1, U$3.2, U$3.3, U$6.P$2, U$6.P$5, U$18.1, U$18.2, U$18.3, U$20.1, U$20.2, U$20.4
BUS-: JP1.1, R14.2, U$2.1, U$2.2, U$2.4, U$4.1, U$4.2, U$4.3, U$13.2 (S), U$19.2, U$19.3, U$19.4, U$21.1, U$21.2, U$21.4
unnamed: LED7.C, R13.1
ROZE: R14.1, U$5.1, U$5.2, U$5.3, U$5.4, U$13.1 (G)
