cansat-tsniimash/can-cube-sat-2022/schematics/board/SPin.brd

## EAGLE design schematics/board/SPin.brd (continued)

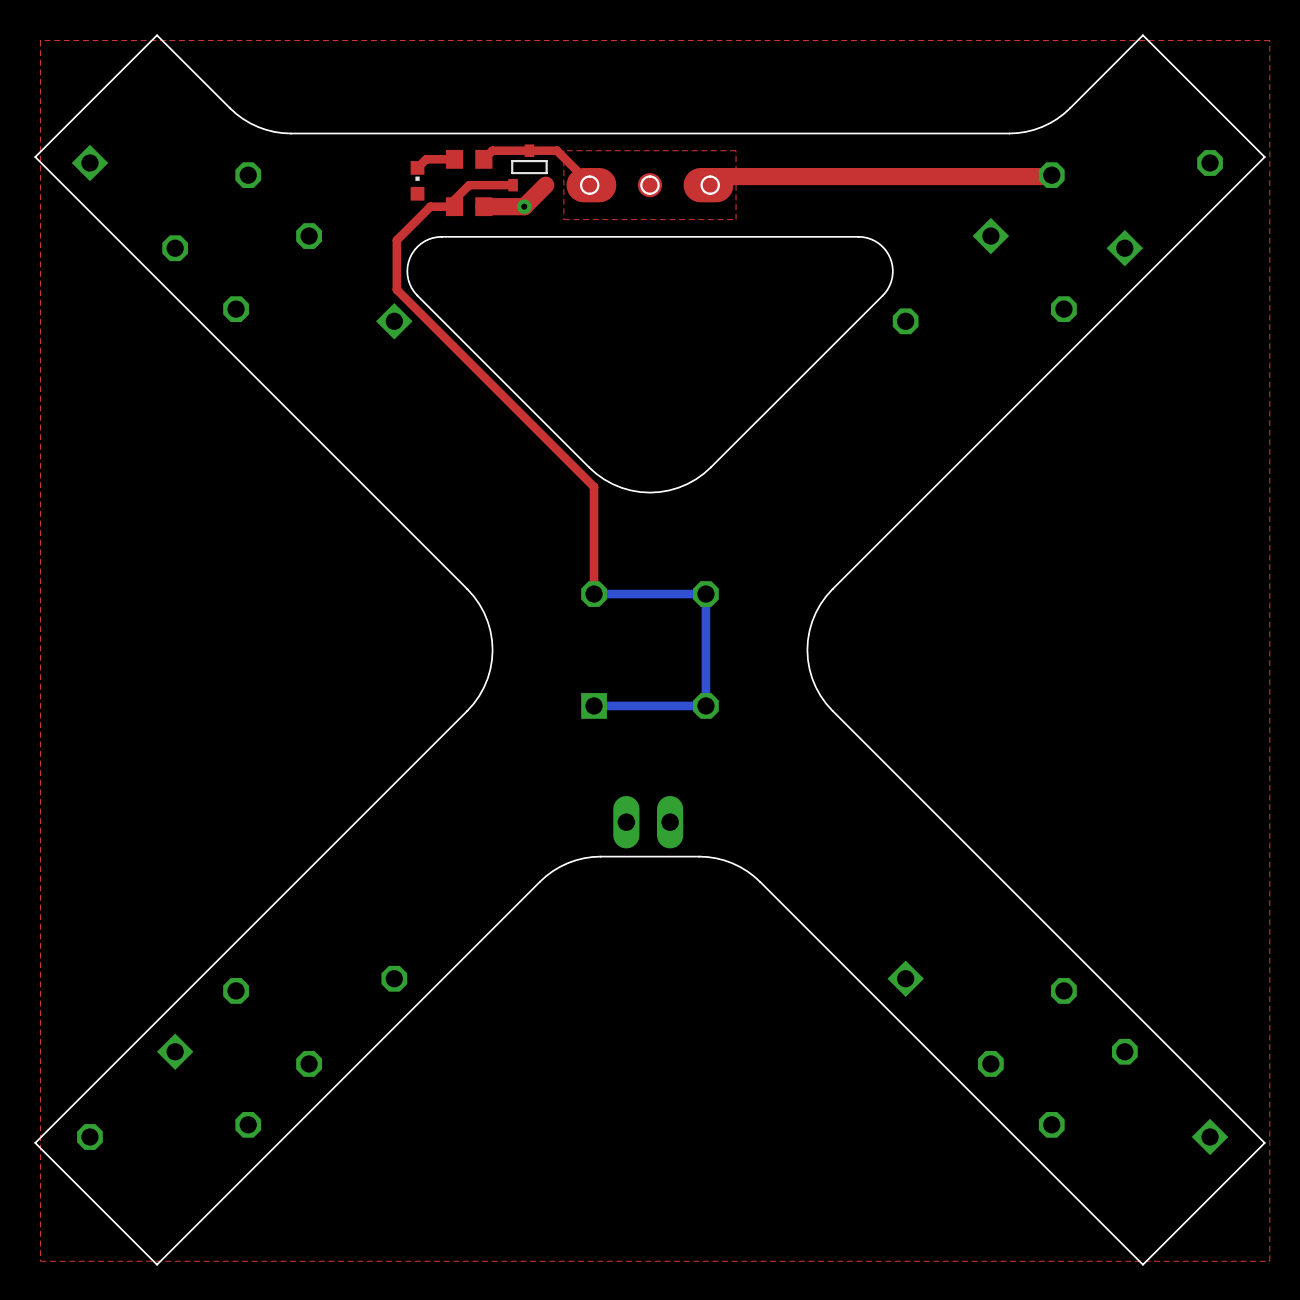
[picture p19: board SPin.brd from above]

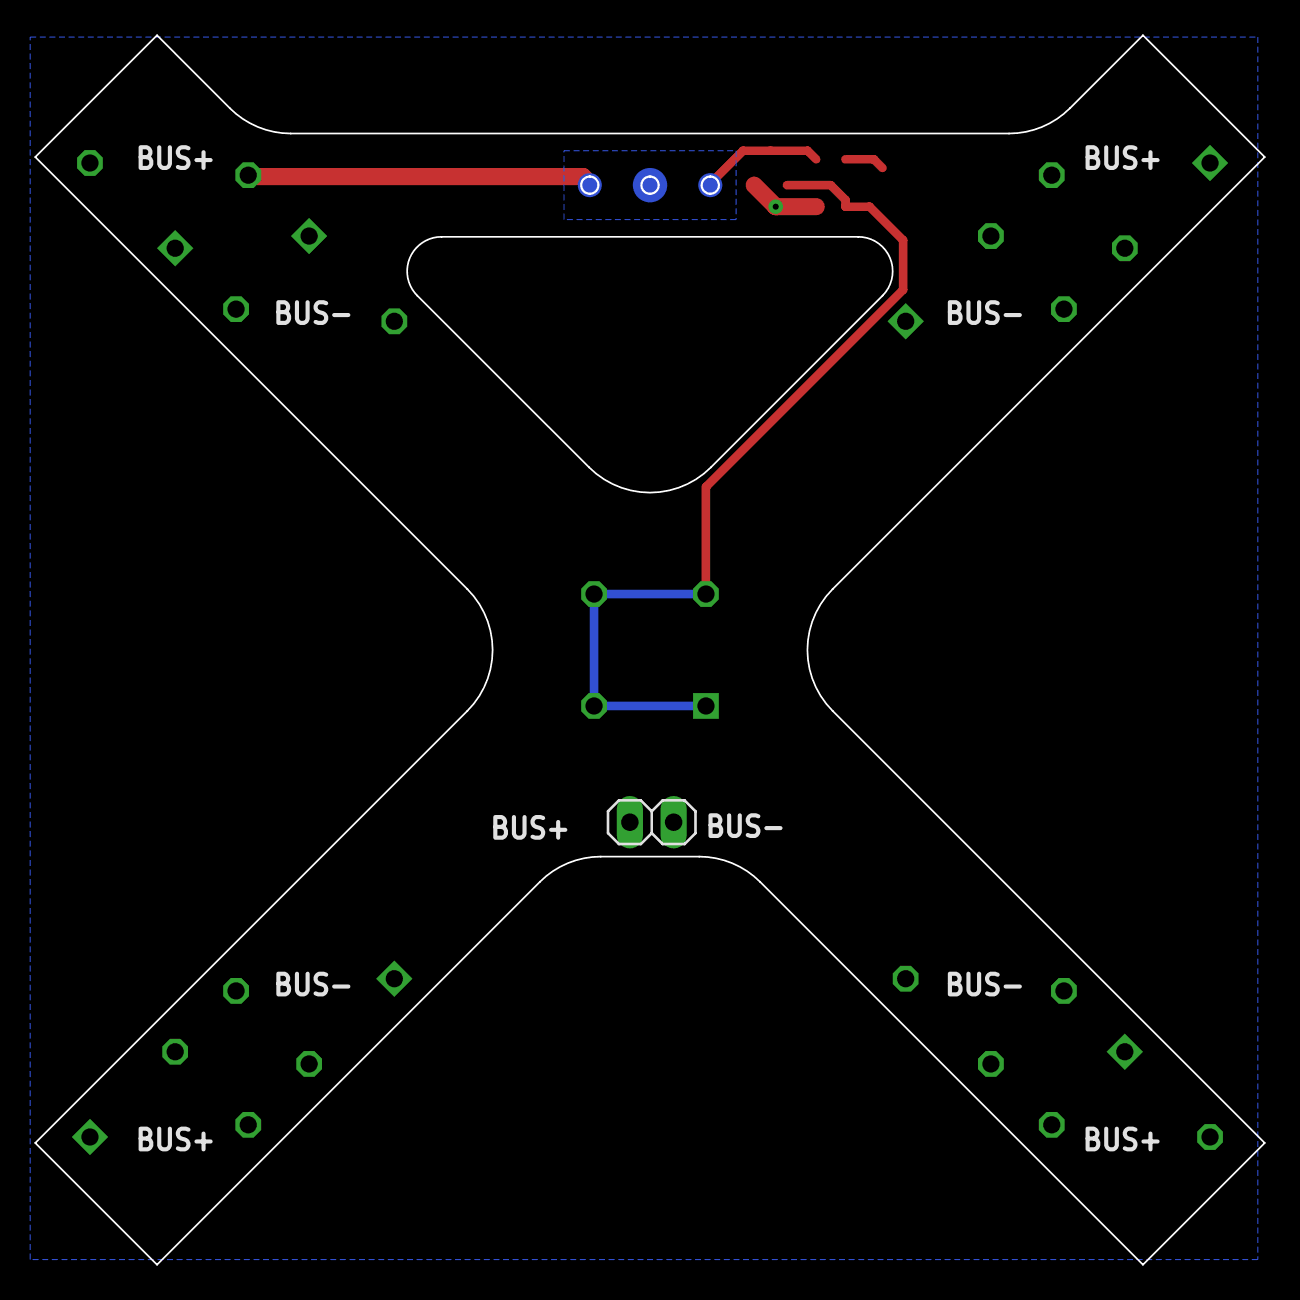
[picture p20: board SPin.brd from below]

Board: 2 copper layers, 71.4 x 71.4 mm, 15 parts (9 on the bottom side), 5 nets.
