cansat-tsniimash/can-cube-sat-2022/schematics/board/SPinner.brd

## EAGLE design schematics/board/SPinner.brd (2022-03-20)

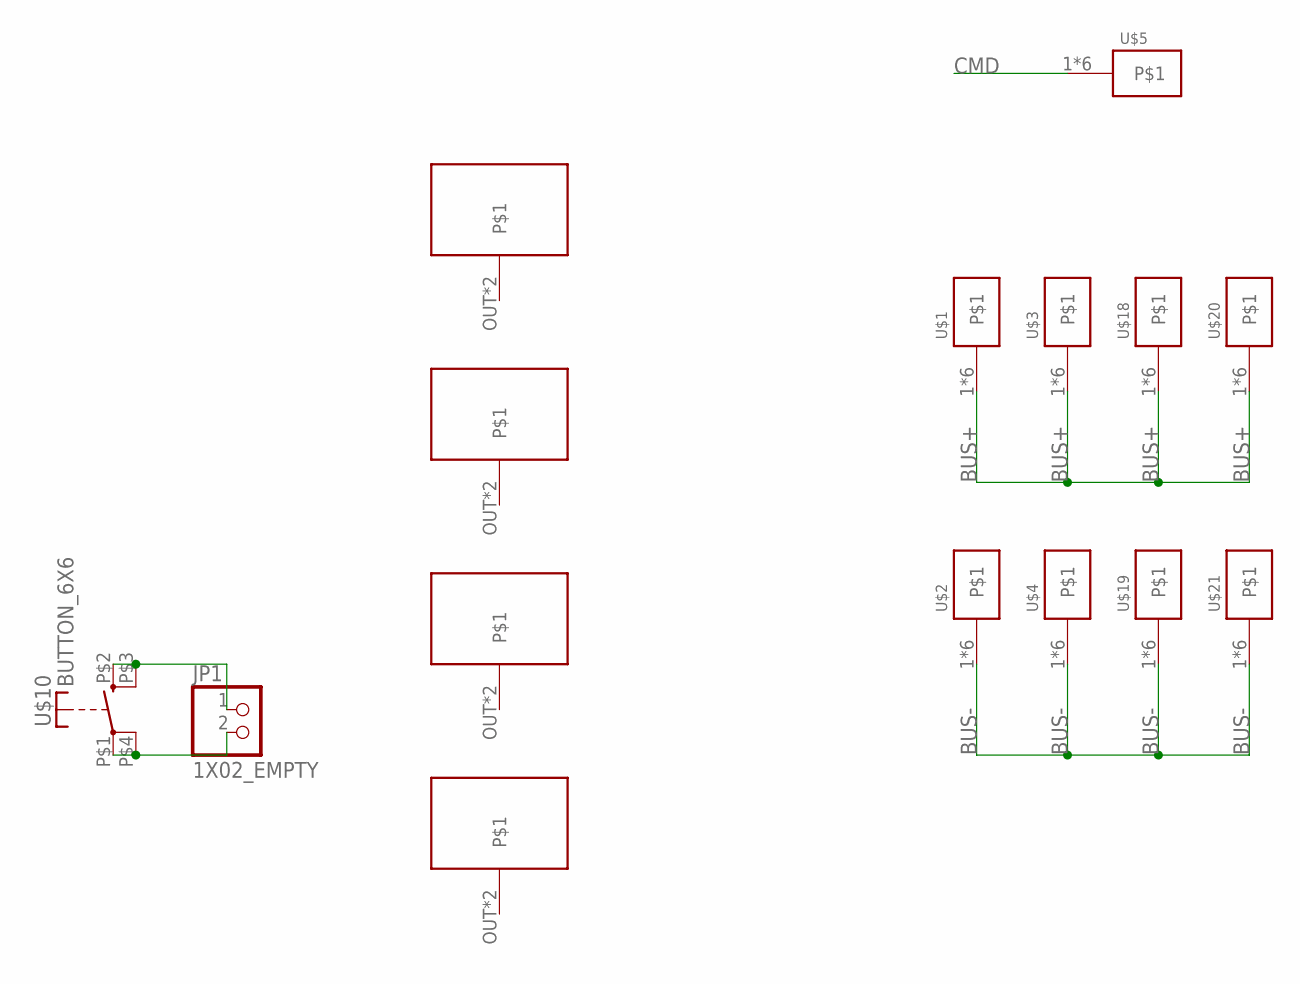
[picture p21: schematic SPinner.sch]

Parts:
JP1: 1X02_EMPTY
U$1, U$2, U$3, U$4, U$18, U$19, U$20, U$21: KCONNECT
U$5: KCONNECTQUAD; KCONNECT_QUAD
U$6, U$7, U$8, U$9: GRAFIT-PASSIVE
U$10: BUTTON_6X6

Connections:
BUS+: U$1.1, U$1.2, U$1.3, U$1.4, U$1.P$1, U$1.P$2, U$3.1, U$3.2, U$3.3, U$3.4, U$3.P$1, U$3.P$2, U$18.1, U$18.2, U$18.3, U$18.4, U$18.P$1, U$18.P$2, U$20.1, U$20.2, U$20.3, U$20.4, U$20.P$1, U$20.P$2
BUS-: U$2.1, U$2.2, U$2.3, U$2.4, U$2.P$1, U$2.P$2, U$4.1, U$4.2, U$4.3, U$4.4, U$4.P$1, U$4.P$2, U$19.1, U$19.2, U$19.3, U$19.4, U$19.P$1, U$19.P$2, U$21.1, U$21.2, U$21.3, U$21.4, U$21.P$1, U$21.P$2
CMD: U$5.1, U$5.2, U$5.3, U$5.4, U$5.P$1, U$5.P$2
unnamed: JP1.1, U$10.P$2 (S), U$10.P$3 (S)
unnamed: JP1.2, U$10.P$1, U$10.P$4

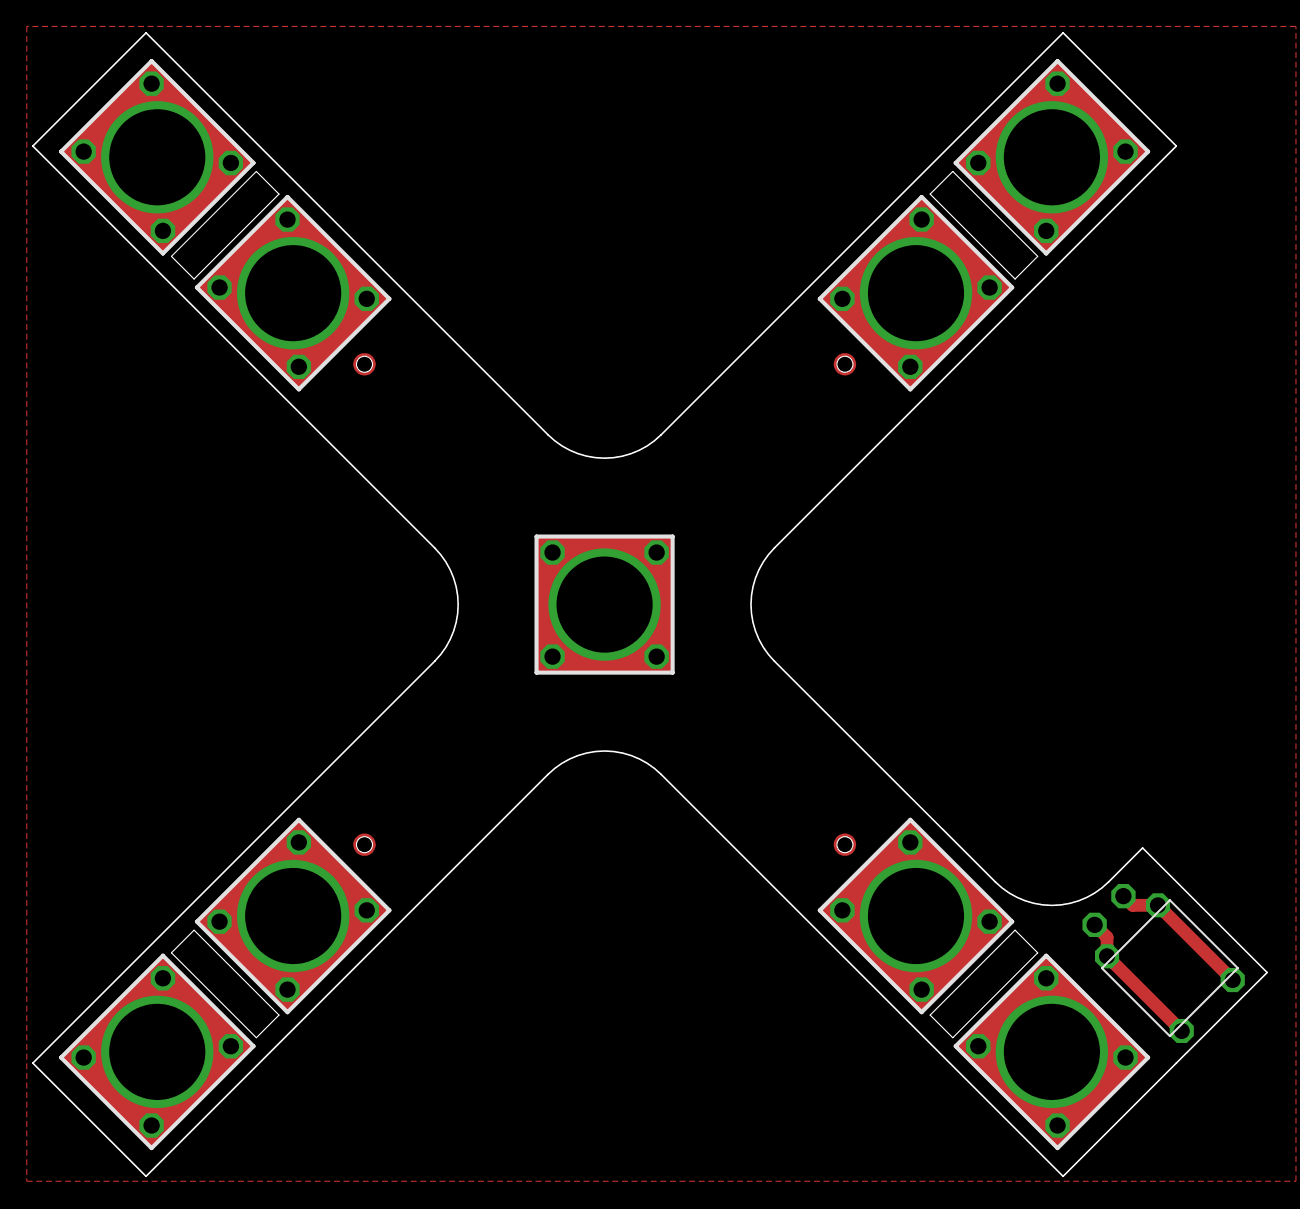
[picture p22: board SPinner.brd from above]

Board: 2 copper layers, 77.1 x 71.4 mm, 15 parts (0 on the bottom side), 5 nets.
