cansat-tsniimash/can-cube-sat-2022/schematics/board/SPout.brd

## EAGLE design schematics/board/SPout.brd (2021-07-07)

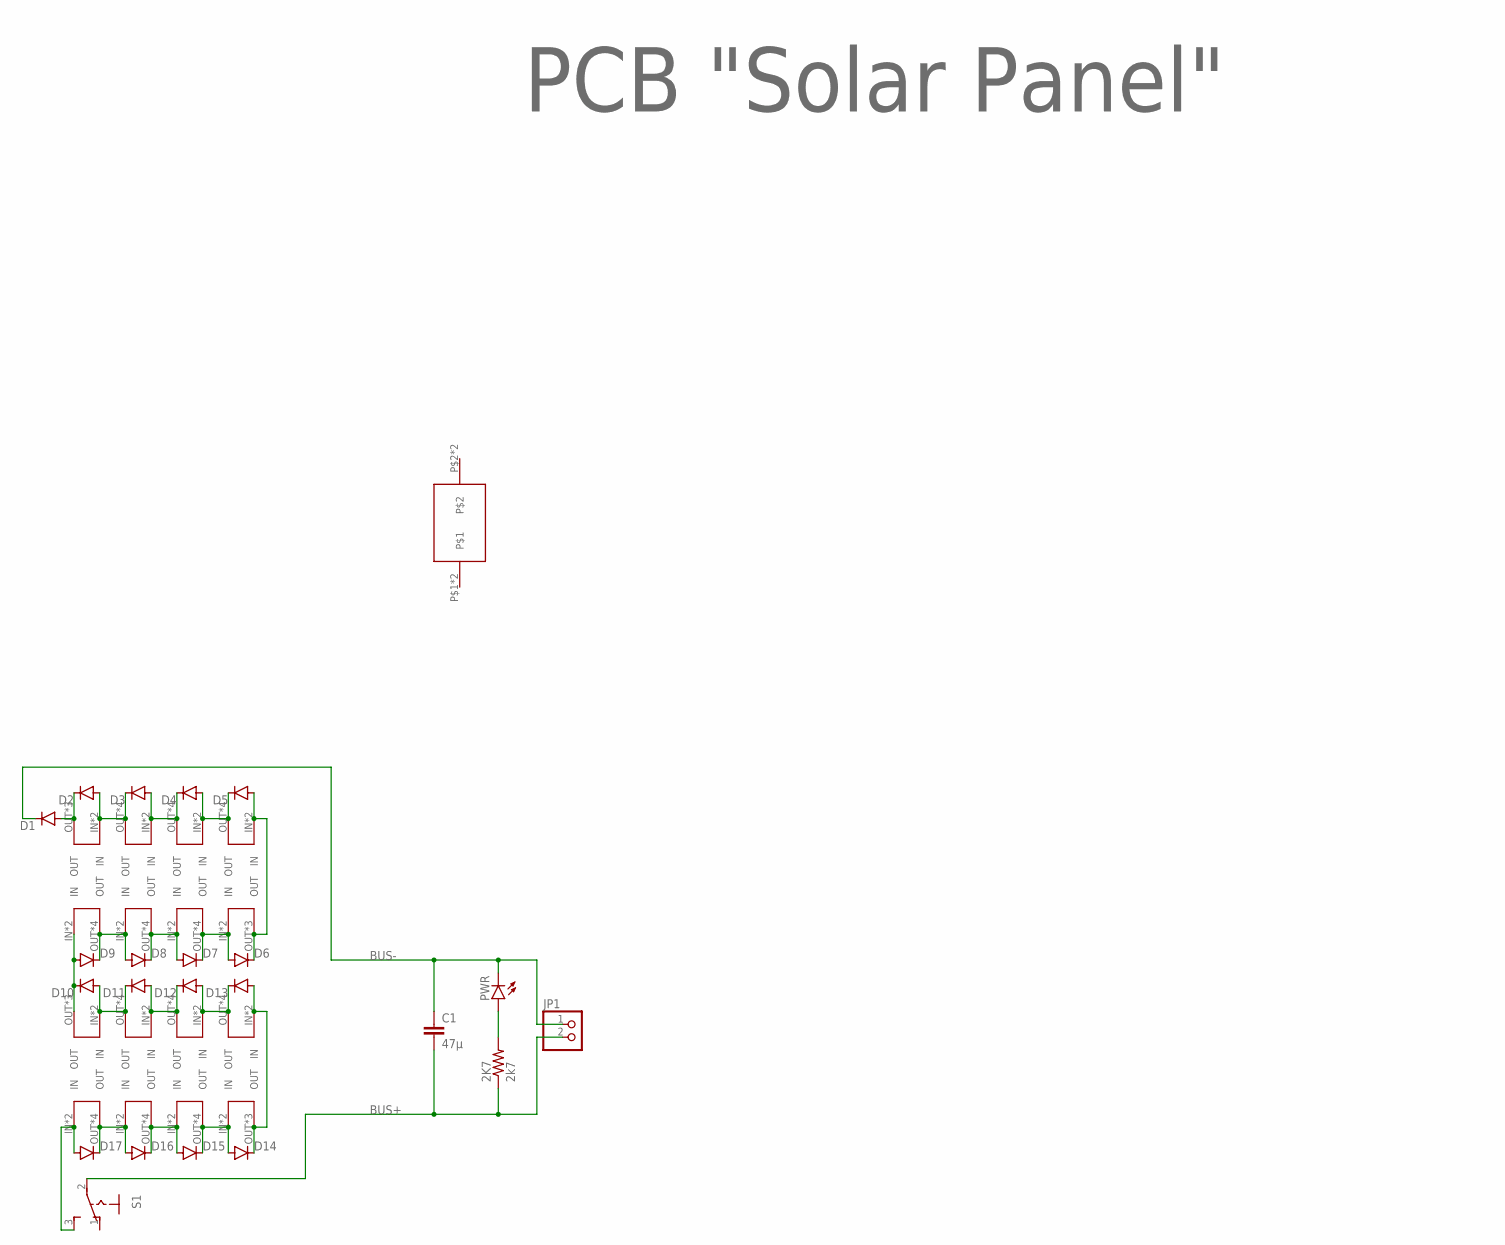
[picture p23: schematic SPout.sch]

Parts:
2K7: 2k7; R0603
C1: 47µ; C1210
D1, D2, D3, D4, D5, D6, D7, D8, D9, D10, D11, D12, D13, D14, D15, D16, D17: MBR0520LT; SOD123
JP1: PINHD-1X2; 1X02
PWR: LEDCHIPLED_0603; CHIPLED_0603
S1: 255SB
SOL1, SOL2, SOL3, SOL5, SOL6, SOL7, SOL9, SOL10, SOL11, SOL13, SOL14, SOL15: SOLAR-2_0; SOLAR_0-2
SOL4, SOL8, SOL12, SOL16: SOLAR-2_1; SOLAR_1-2
U$6: GRAFITGRAFIT4_2; GRAFIT4_2
U$26: PCB "Solar Panel"; ITS-LOGO

Connections:
BUS+: 2K7.1, C1.2, JP1.2, S1.2
BUS-: C1.1, D1.C, JP1.1, PWR.C
unnamed: D16.A, D17.C, SOL1.OUT, SOL1.OUT1 (OUT), SOL1.OUT-2 (OUT), SOL1.OUT-21 (OUT), SOL2.IN, SOL2.IN-2 (IN)
unnamed: D15.A, D16.C, SOL2.OUT, SOL2.OUT1 (OUT), SOL2.OUT-2 (OUT), SOL2.OUT-21 (OUT), SOL3.IN, SOL3.IN-2 (IN)
unnamed: D1.A, D2.C, SOL16.OUT, SOL16.OUT-2 (OUT), SOL16.OUT-21 (OUT)
unnamed: 2K7.2, PWR.A
unnamed: D14.A, D15.C, SOL3.OUT, SOL3.OUT1 (OUT), SOL3.OUT-2 (OUT), SOL3.OUT-21 (OUT), SOL4.IN, SOL4.IN-2 (IN)
unnamed: D17.A, S1.3 (S), SOL1.IN, SOL1.IN-2 (IN)
unnamed: D12.A, D13.C, SOL5.OUT, SOL5.OUT1 (OUT), SOL5.OUT-2 (OUT), SOL5.OUT-21 (OUT), SOL6.IN, SOL6.IN-2 (IN)
unnamed: D11.A, D12.C, SOL6.OUT, SOL6.OUT1 (OUT), SOL6.OUT-2 (OUT), SOL6.OUT-21 (OUT), SOL7.IN, SOL7.IN-2 (IN)
unnamed: D10.A, D11.C, SOL7.OUT, SOL7.OUT1 (OUT), SOL7.OUT-2 (OUT), SOL7.OUT-21 (OUT), SOL8.IN, SOL8.IN-2 (IN)
unnamed: D9.A, D10.C, SOL8.OUT, SOL8.OUT-2 (OUT), SOL8.OUT-21 (OUT), SOL9.IN, SOL9.IN-2 (IN)
unnamed: D8.A, D9.C, SOL9.OUT, SOL9.OUT1 (OUT), SOL9.OUT-2 (OUT), SOL9.OUT-21 (OUT), SOL10.IN, SOL10.IN-2 (IN)
unnamed: D7.A, D8.C, SOL10.OUT, SOL10.OUT1 (OUT), SOL10.OUT-2 (OUT), SOL10.OUT-21 (OUT), SOL11.IN, SOL11.IN-2 (IN)
unnamed: D6.A, D7.C, SOL11.OUT, SOL11.OUT1 (OUT), SOL11.OUT-2 (OUT), SOL11.OUT-21 (OUT), SOL12.IN, SOL12.IN-2 (IN)
unnamed: D5.A, D6.C, SOL12.OUT, SOL12.OUT-2 (OUT), SOL12.OUT-21 (OUT), SOL13.IN, SOL13.IN-2 (IN)
unnamed: D4.A, D5.C, SOL13.OUT, SOL13.OUT1 (OUT), SOL13.OUT-2 (OUT), SOL13.OUT-21 (OUT), SOL14.IN, SOL14.IN-2 (IN)
unnamed: D3.A, D4.C, SOL14.OUT, SOL14.OUT1 (OUT), SOL14.OUT-2 (OUT), SOL14.OUT-21 (OUT), SOL15.IN, SOL15.IN-2 (IN)
unnamed: D2.A, D3.C, SOL15.OUT, SOL15.OUT1 (OUT), SOL15.OUT-2 (OUT), SOL15.OUT-21 (OUT), SOL16.IN, SOL16.IN-2 (IN)
unnamed: D13.A, D14.C, SOL4.OUT, SOL4.OUT-2 (OUT), SOL4.OUT-21 (OUT), SOL5.IN, SOL5.IN-2 (IN)

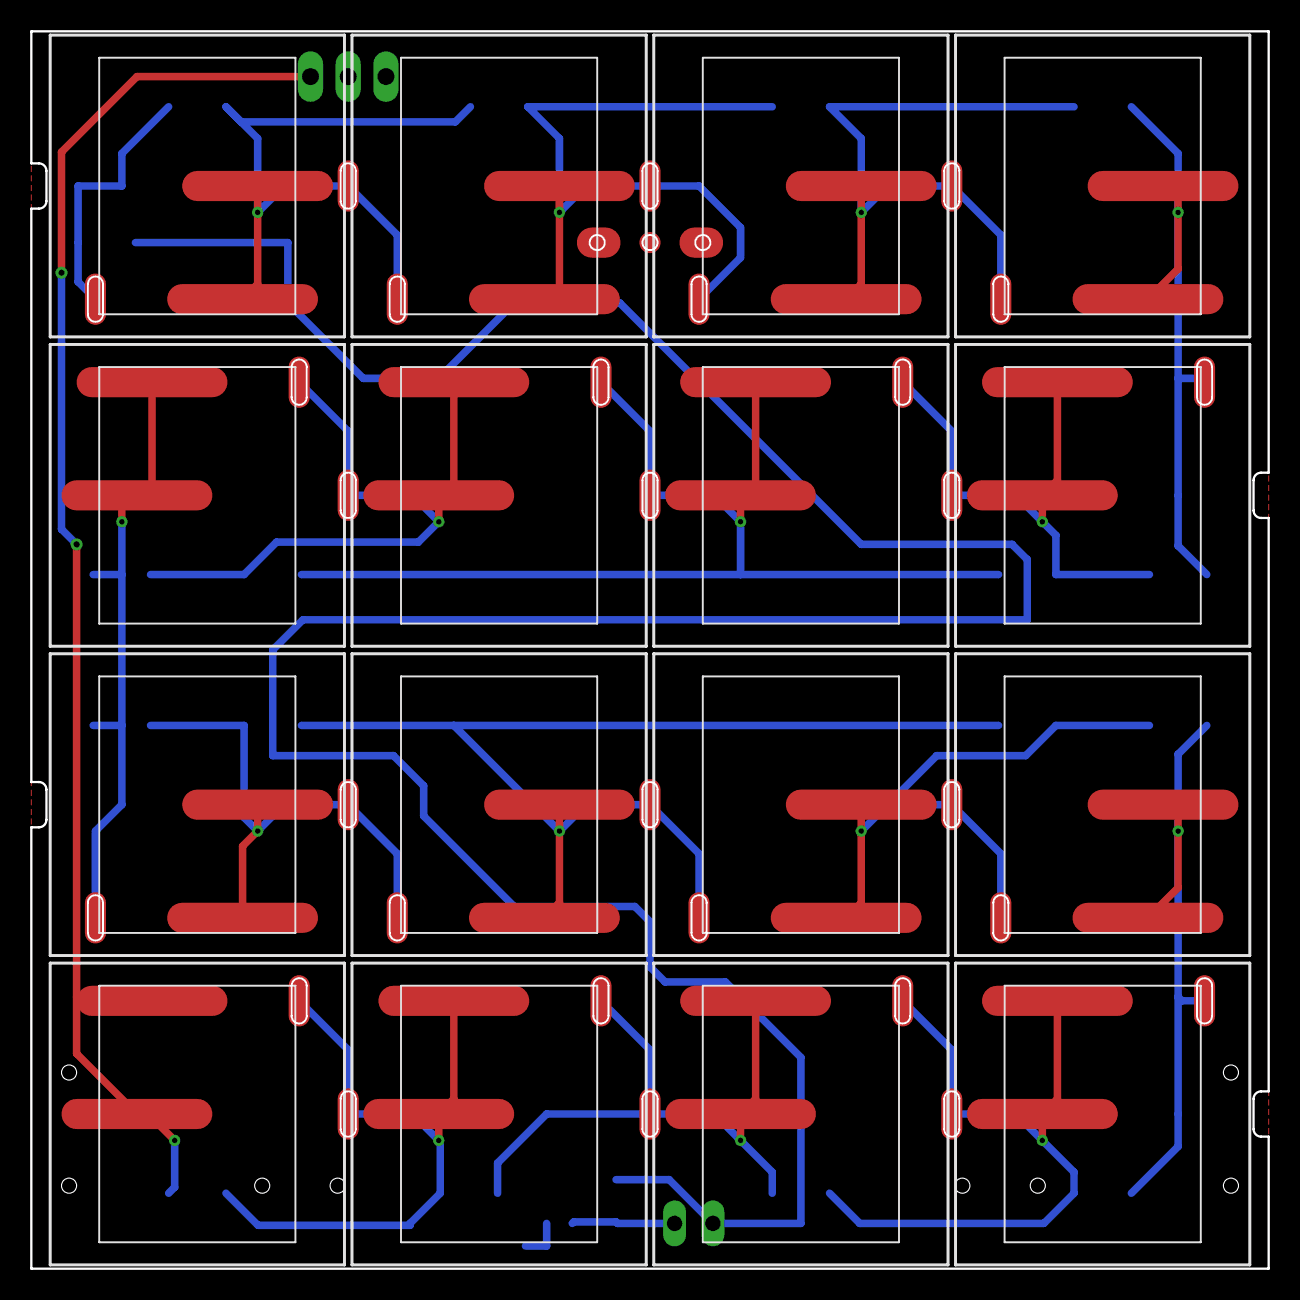
[picture p24: board SPout.brd from above]

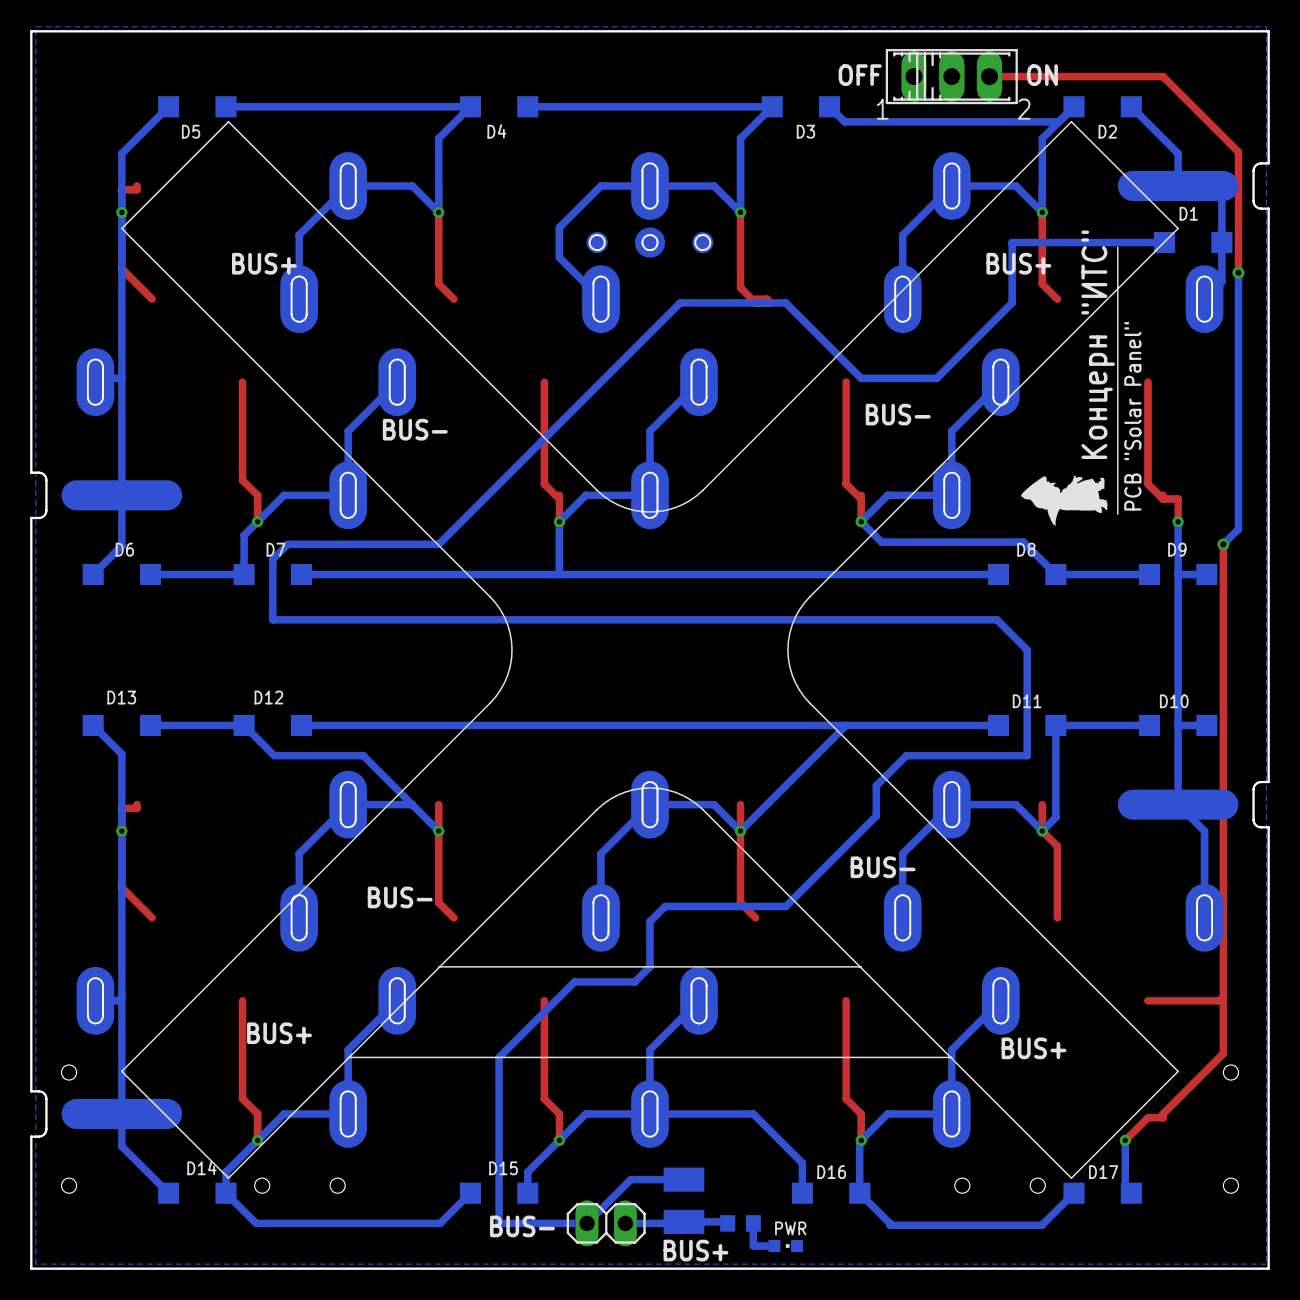
[picture p25: board SPout.brd from below]

Board: 2 copper layers, 82.0 x 82.0 mm, 40 parts (23 on the bottom side), 20 nets.
