cansat-tsniimash/can-cube-sat-2022/schematics/board/AB+RADIO.brd

## EAGLE design schematics/board/AB+RADIO.brd (2021-07-07)

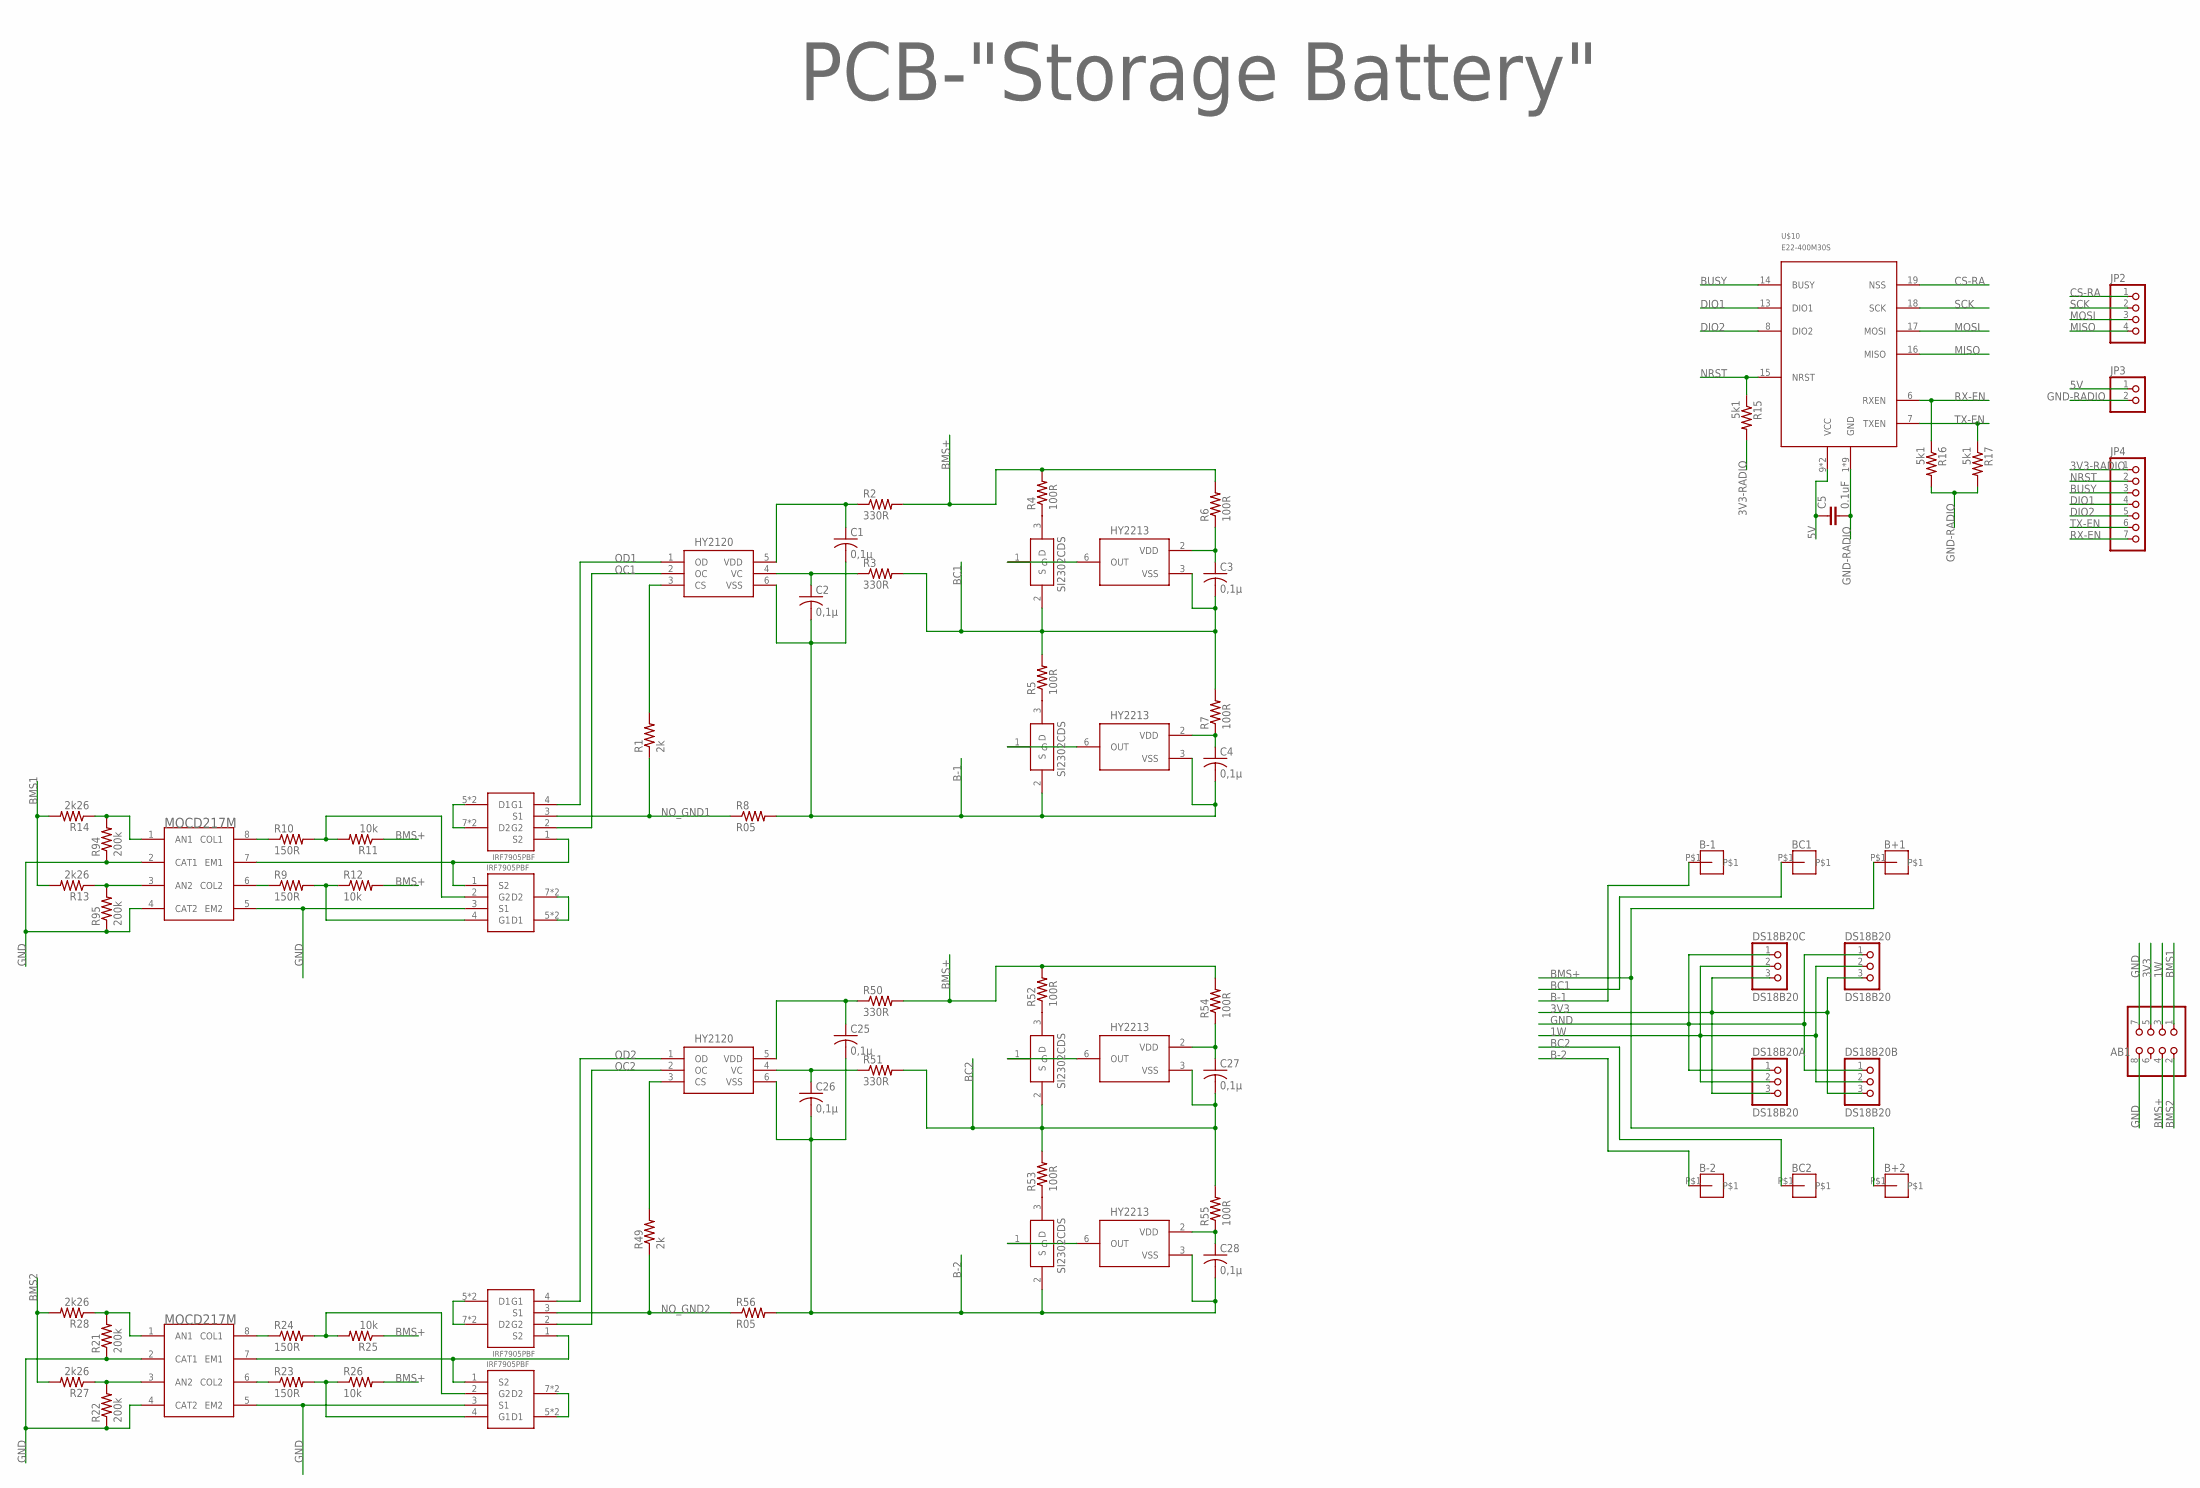
[picture p26: schematic AB+RADIO.sch]

Parts:
AB1: PINHD-2X4; 2X04
B+1, B+2: BATTERY
B-1, B-2: BATTERY
BC1, BC2: BATTERY
C1, C2, C3, C4, C25, C26, C27, C28: 0,1µ; C0603
C5: 0.1uF; C0603
DS18B20, DS18B20A, DS18B20B, DS18B20C: DS18B20; CONNECT1X3
JP2: PINHD-1X4; 1X04
JP3: PINHD-1X2; 1X02
JP4: PINHD-1X7; 1X07
R1, R49: 2k; R0603
R2, R3, R50, R51: 330R; R0603
R4, R5, R6, R7, R52, R53, R54, R55: 100R; R0603
R8, R56: R05; R2512
R9, R10, R23, R24: 150R; R0603
R11, R12, R25, R26: 10k; R0603
R13, R14, R27, R28: 2k26; R0603
R15, R16, R17: 5k1; R0603
R21, R22, R94, R95: 200k; R0603
U$1: PCB-"Storage Battery"; ITS-LOGO
U$2, U$11: MOCD217M; SOIC8
U$3, U$45: HY2120; SOT23-6
U$4, U$5, U$46, U$47: HY2213"; SOT23-6
U$6, U$7, U$48, U$49: SI2302CDS; SOT23-3
U$8, U$9, U$12, U$13: IRF7905PBF; SO8
U$10: E22-400M30S

Connections:
1W: AB1.3, DS18B20.2, DS18B20A.2, DS18B20B.2, DS18B20C.2
3V3: AB1.5, DS18B20.3, DS18B20A.3, DS18B20B.3, DS18B20C.3
3V3-RADIO: JP4.1, R15.2
5V: C5.1, JP3.1, U$10.9 (VCC), U$10.10 (VCC)
B-1: B-1.P$1, C1.2, C2.2, C4.2, R8.2, U$3.6 (VSS), U$5.3 (VSS), U$7.2 (S)
B-2: B-2.P$1, C25.2, C26.2, C28.2, R56.2, U$45.6 (VSS), U$47.3 (VSS), U$49.2 (S)
BC1: BC1.P$1, C3.2, R3.2, R5.2, R7.2, U$4.3 (VSS), U$6.2 (S)
BC2: BC2.P$1, C27.2, R51.2, R53.2, R55.2, U$46.3 (VSS), U$48.2 (S)
BMS1: AB1.1, R13.2, R14.2
BMS2: AB1.2, R27.2, R28.2
BMS+: AB1.4, B+1.P$1, B+2.P$1, R2.2, R4.2, R6.2, R11.1, R12.2, R25.1, R26.2, R50.2, R52.2, R54.2
BUSY: JP4.3, U$10.14 (BUSY)
CS-RA: JP2.1, U$10.19 (NSS)
DIO1: JP4.4, U$10.13 (DIO1)
DIO2: JP4.5, U$10.8 (DIO2)
GND: AB1.7, AB1.8, DS18B20.1, DS18B20A.1, DS18B20B.1, DS18B20C.1, R21.1, R22.1, R94.1, R95.1, U$2.2 (CAT1), U$2.4 (CAT2), U$2.5 (EM2), U$8.3 (S1), U$11.2 (CAT1), U$11.4 (CAT2), U$11.5 (EM2), U$12.3 (S1)
GND-RADIO: C5.2, JP3.2, R16.2, R17.2, U$10.1 (GND), U$10.2 (GND), U$10.3 (GND), U$10.4 (GND), U$10.5 (GND), U$10.11 (GND), U$10.12 (GND), U$10.20 (GND), U$10.22 (GND)
MISO: JP2.4, U$10.16 (MISO)
MOSI: JP2.3, U$10.17 (MOSI)
unnamed: U$2.7 (EM1), U$8.1 (S2), U$9.1 (S2)
unnamed: R10.2, R11.2, U$8.2 (G2)
unnamed: R49.2, U$45.3 (CS)
unnamed: C1.1, R2.1, U$3.5 (VDD)
unnamed: C3.1, R6.1, U$4.2 (VDD)
unnamed: U$4.6 (OUT), U$6.1 (G)
unnamed: C4.1, R7.1, U$5.2 (VDD)
unnamed: U$5.6 (OUT), U$7.1 (G)
unnamed: R4.1, U$6.3 (D)
unnamed: R5.1, U$7.3 (D)
unnamed: R1.2, U$3.3 (CS)
unnamed: C2.1, R3.1, U$3.4 (VC)
unnamed: U$9.5 (D1), U$9.6 (D1), U$9.7 (D2), U$9.8 (D2)
unnamed: R10.1, U$2.8 (COL1)
unnamed: R13.1, R95.2, U$2.3 (AN2)
unnamed: R22.2, R27.1, U$11.3 (AN2)
unnamed: U$8.5 (D1), U$8.6 (D1), U$8.7 (D2), U$8.8 (D2)
unnamed: R9.1, U$2.6 (COL2)
unnamed: R9.2, R12.1, U$8.4 (G1)
unnamed: R21.2, R28.1, U$11.1 (AN1)
unnamed: R14.1, R94.2, U$2.1 (AN1)
unnamed: R24.2, R25.2, U$12.2 (G2)
unnamed: R24.1, U$11.8 (COL1)
unnamed: R23.1, U$11.6 (COL2)
unnamed: R23.2, R26.1, U$12.4 (G1)
unnamed: U$11.7 (EM1), U$12.1 (S2), U$13.1 (S2)
unnamed: U$13.5 (D1), U$13.6 (D1), U$13.7 (D2), U$13.8 (D2)
unnamed: U$12.5 (D1), U$12.6 (D1), U$12.7 (D2), U$12.8 (D2)
unnamed: R52.1, U$48.3 (D)
unnamed: R53.1, U$49.3 (D)
unnamed: C25.1, R50.1, U$45.5 (VDD)
unnamed: C27.1, R54.1, U$46.2 (VDD)
unnamed: U$46.6 (OUT), U$48.1 (G)
unnamed: U$47.6 (OUT), U$49.1 (G)
unnamed: C26.1, R51.1, U$45.4 (VC)
unnamed: C28.1, R55.1, U$47.2 (VDD)
NO_GND1: R1.1, R8.1, U$9.3 (S1)
NO_GND2: R49.1, R56.1, U$13.3 (S1)
NRST: JP4.2, R15.1, U$10.15 (NRST)
OC1: U$3.2 (OC), U$9.2 (G2)
OC2: U$13.2 (G2), U$45.2 (OC)
OD1: U$3.1 (OD), U$9.4 (G1)
OD2: U$13.4 (G1), U$45.1 (OD)
RX-EN: JP4.7, R16.1, U$10.6 (RXEN)
SCK: JP2.2, U$10.18 (SCK)
TX-EN: JP4.6, R17.1, U$10.7 (TXEN)

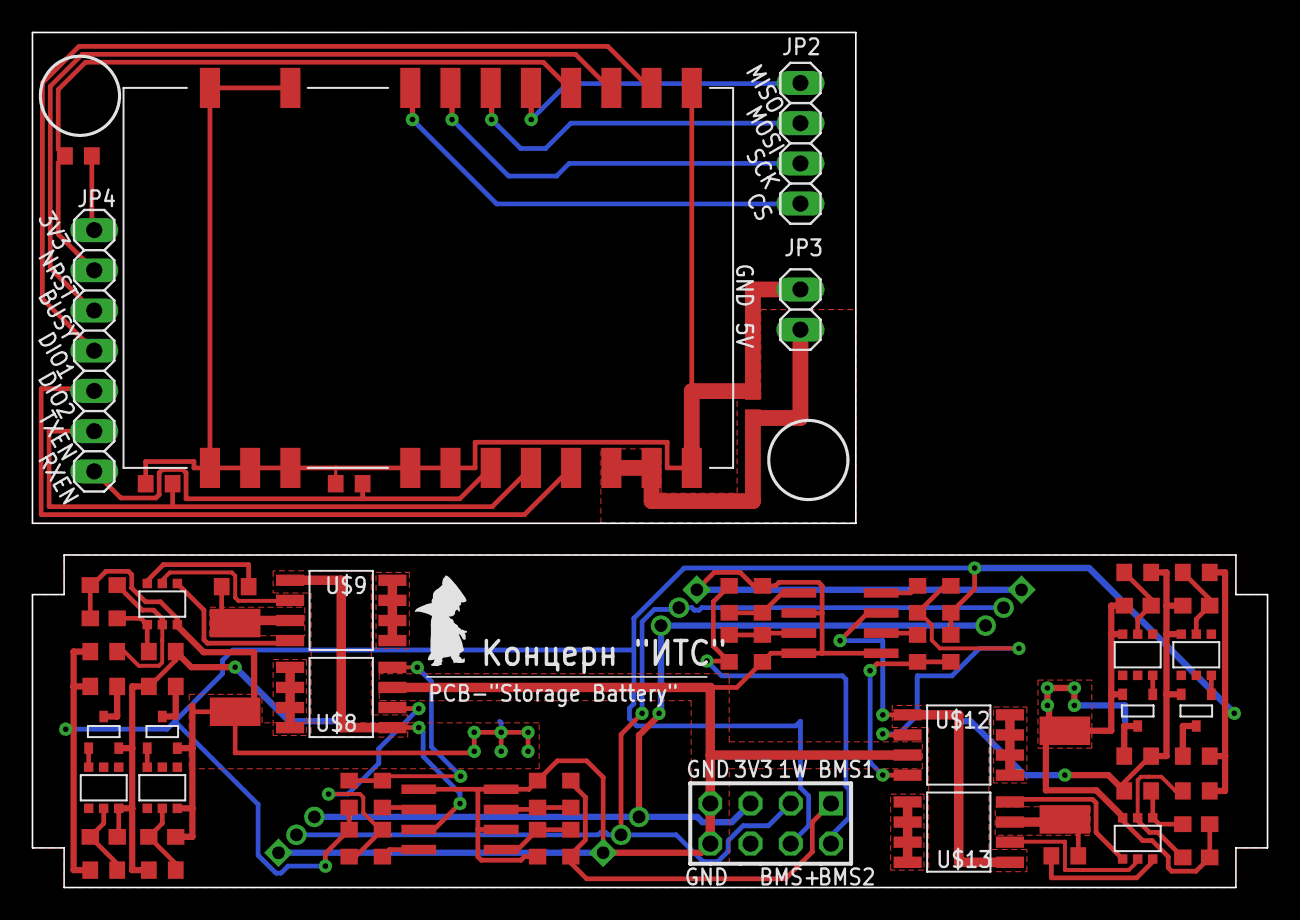
[picture p27: board AB+RADIO.brd from above]

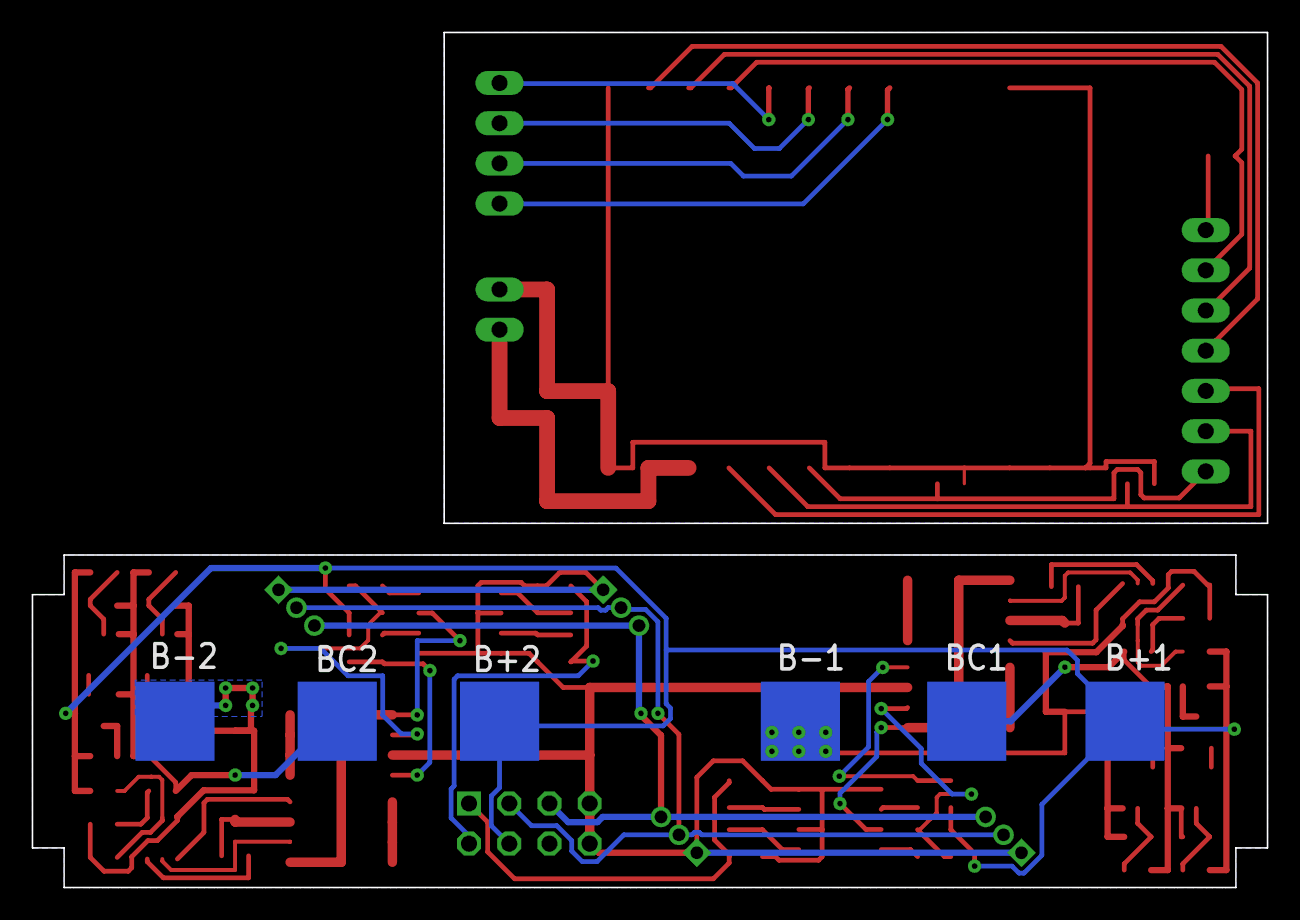
[picture p28: board AB+RADIO.brd from below]

Board: 2 copper layers, 78.0 x 54.0 mm, 76 parts (6 on the bottom side), 65 nets.
