cansat-tsniimash/can-cube-sat-2022/schematics/board/RADIO.brd

## EAGLE design schematics/board/RADIO.brd (2021-06-03)

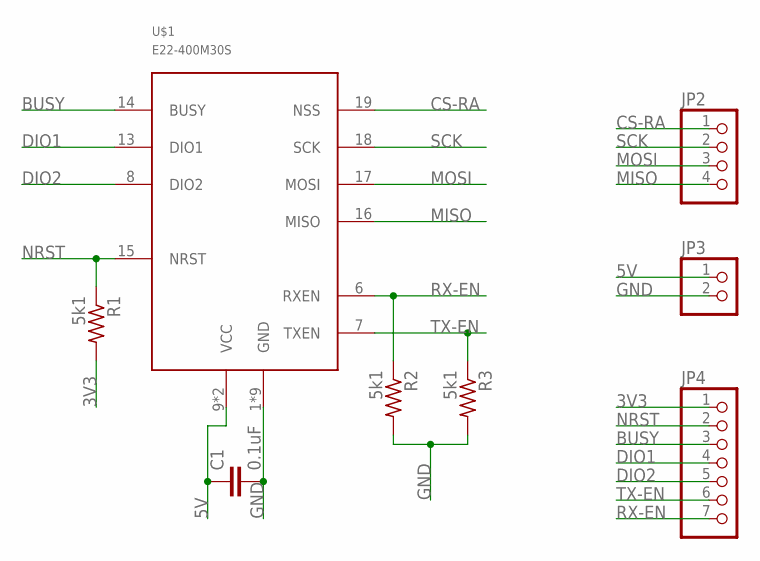
[picture p29: schematic RADIO.sch]

Parts:
C1: 0.1uF; C0603
JP2: PINHD-1X4; 1X04
JP3: PINHD-1X2; 1X02
JP4: PINHD-1X7; 1X07
R1, R2, R3: 5k1; R0603
U$1: E22-400M30S

Connections:
3V3: JP4.1, R1.2
5V: C1.1, JP3.1, U$1.9 (VCC), U$1.10 (VCC)
BUSY: JP4.3, U$1.14 (BUSY)
CS-RA: JP2.1, U$1.19 (NSS)
DIO1: JP4.4, U$1.13 (DIO1)
DIO2: JP4.5, U$1.8 (DIO2)
GND: C1.2, JP3.2, R2.2, R3.2, U$1.1 (GND), U$1.2 (GND), U$1.3 (GND), U$1.4 (GND), U$1.5 (GND), U$1.11 (GND), U$1.12 (GND), U$1.20 (GND), U$1.22 (GND)
MISO: JP2.4, U$1.16 (MISO)
MOSI: JP2.3, U$1.17 (MOSI)
NRST: JP4.2, R1.1, U$1.15 (NRST)
RX-EN: JP4.7, R2.1, U$1.6 (RXEN)
SCK: JP2.2, U$1.18 (SCK)
TX-EN: JP4.6, R3.1, U$1.7 (TXEN)
