cansat-tsniimash/can-cube-sat-2022/schematics/board/RADIO.brd

## EAGLE design schematics/board/RADIO.brd (continued)

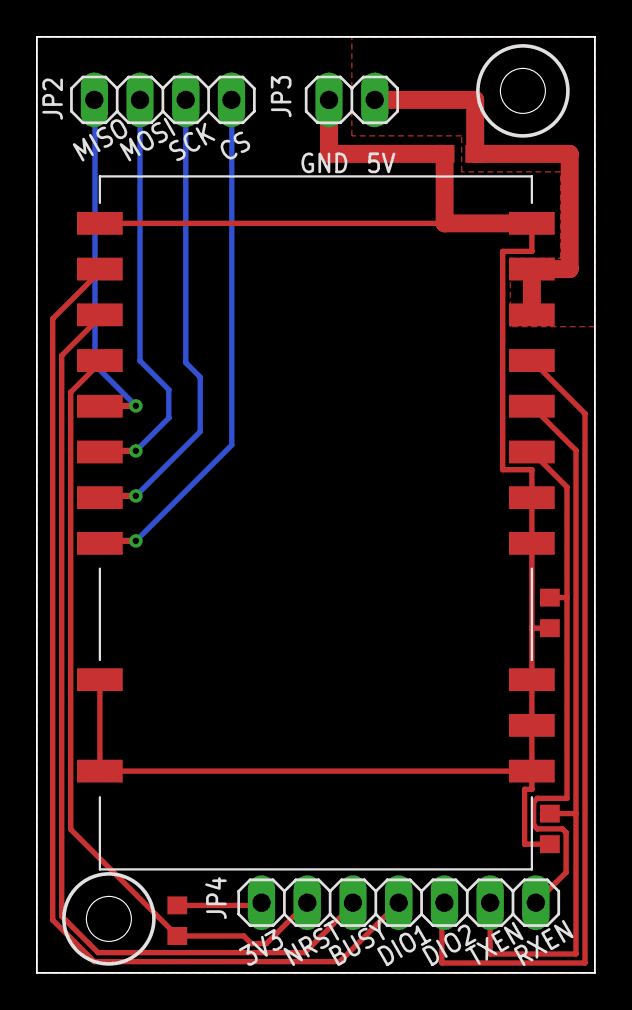
[picture p30: board RADIO.brd from above]

Board: 2 copper layers, 31.0 x 52.0 mm, 8 parts (0 on the bottom side), 13 nets.
