cansat-tsniimash/can-cube-sat-2022/schematics/board/Debug.brd

## EAGLE design schematics/board/Debug.brd (2021-05-13)

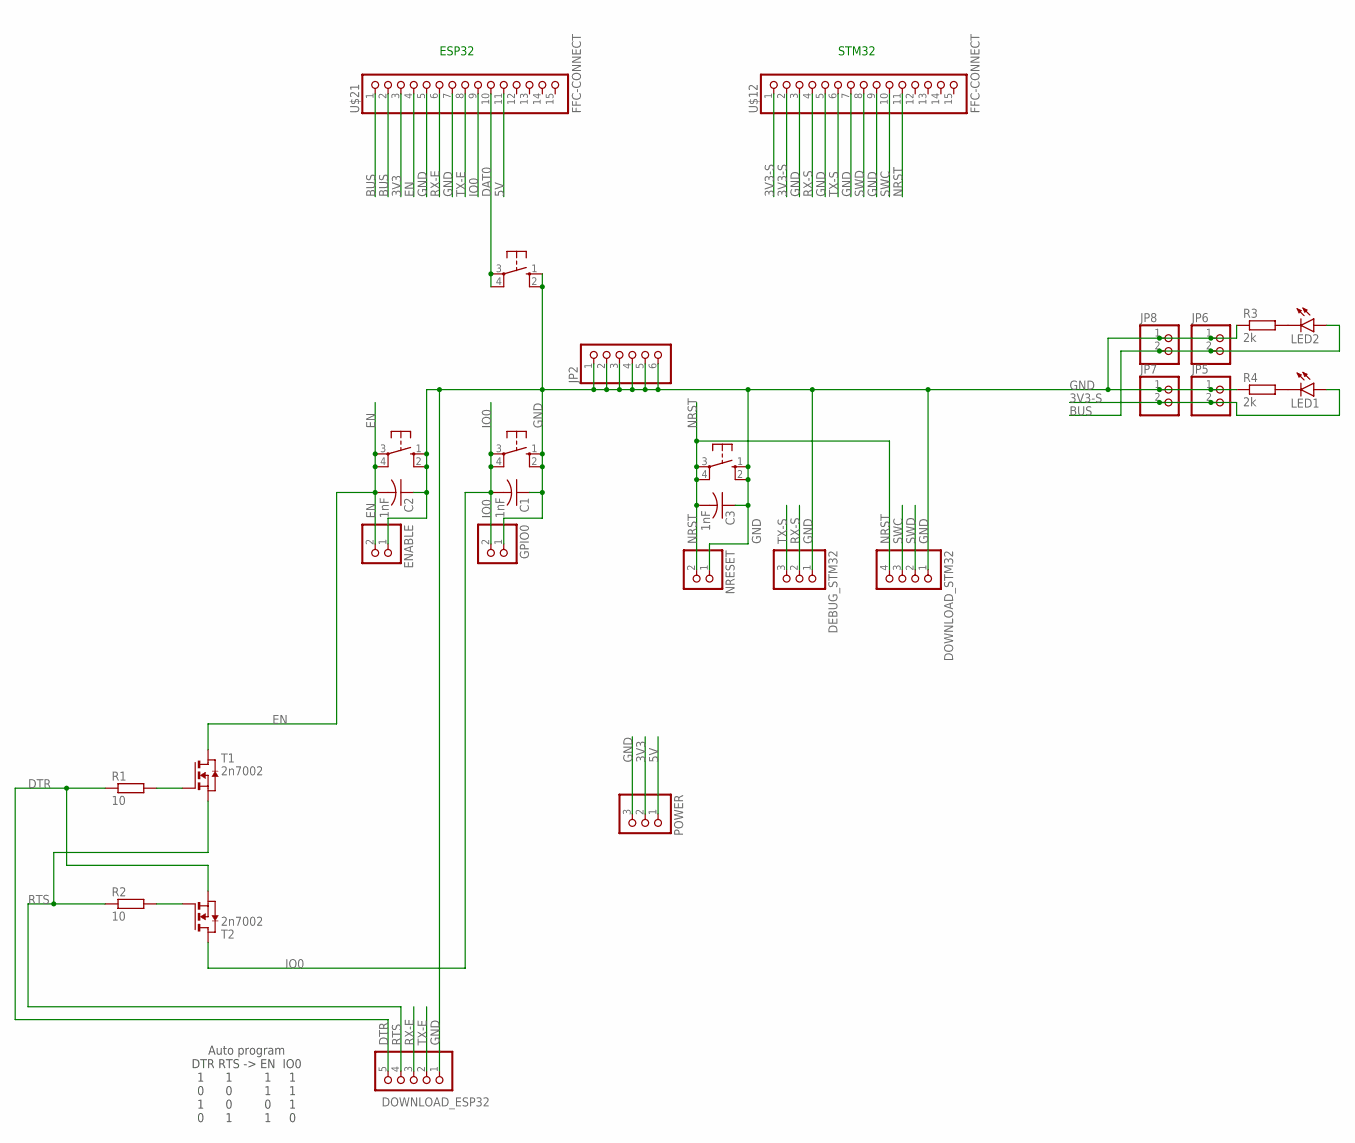
[picture p31: schematic Debug.sch]

Parts:
C1, C2, C3: 1nF; C0603
DAT0: 10-XX; B3F-10XX
DEBUG_STM32: PINHD-1X3; 1X03
DOWNLOAD_ESP32: PINHD-1X5; 1X05
DOWNLOAD_STM32: PINHD-1X4; 1X04
EN: 10-XX; B3F-10XX
ENABLE: PINHD-1X2; 1X02
GPIO0: PINHD-1X2; 1X02
IO0: 10-XX; B3F-10XX
JP2: PINHD-1X6; 1X06
JP5, JP6, JP7, JP8: PINHD-1X2; 1X02
LED1, LED2: LEDCHIPLED_0603; CHIPLED_0603
NRESET: PINHD-1X2; 1X02
NRST: 10-XX; B3F-10XX
POWER: PINHD-1X3; 1X03
R1, R2: 10; R0603
R3, R4: 2k; R0603
T1, T2: 2n7002; SOT-23
U$12, U$21: FFC-CONNECT; SLW15S

Connections:
3V3: POWER.2, U$21.3
3V3-S: JP5.2, JP7.2, LED1.A, U$12.1, U$12.2
5V: POWER.1, U$21.11
BUS: JP6.2, JP8.2, LED2.A, U$21.1, U$21.2
DAT0: DAT0.3, DAT0.4 (P1), U$21.10
DTR: DOWNLOAD_ESP32.5, R1.1, T2.2 (S)
EN: C2.2, EN.3, EN.4 (P1), ENABLE.2, T1.1 (D), U$21.4
GND: C1.1, C2.1, C3.1, DAT0.1 (S), DAT0.2 (S1), DEBUG_STM32.1, DOWNLOAD_ESP32.1, DOWNLOAD_STM32.1, EN.1 (S), EN.2 (S1), ENABLE.1, GPIO0.1, IO0.1 (S), IO0.2 (S1), JP2.1, JP2.2, JP2.3, JP2.4, JP2.5, JP2.6, JP5.1, JP6.1, JP7.1, JP8.1, NRESET.1, NRST.1 (S), NRST.2 (S1), POWER.3, R3.1, R4.1, U$12.3, U$12.5, U$12.7, U$12.9, U$21.5, U$21.7
IO0: C1.2, GPIO0.2, IO0.3, IO0.4 (P1), T2.1 (D), U$21.9
unnamed: R2.2, T2.3 (G)
unnamed: R1.2, T1.3 (G)
unnamed: LED1.C, R4.2
unnamed: LED2.C, R3.2
NRST: C3.2, DOWNLOAD_STM32.4, NRESET.2, NRST.3, NRST.4 (P1), U$12.11
RTS: DOWNLOAD_ESP32.4, R2.1, T1.2 (S)
RX-E: DOWNLOAD_ESP32.3, U$21.6
RX-S: DEBUG_STM32.2, U$12.4
SWC: DOWNLOAD_STM32.3, U$12.10
SWD: DOWNLOAD_STM32.2, U$12.8
TX-E: DOWNLOAD_ESP32.2, U$21.8
TX-S: DEBUG_STM32.3, U$12.6

Notes on the sheet:
ESP32
STM32
Auto program DTR RTS -> EN IO0 1 1 1 1 0 0 1 1 1 0 0 1 0 1 1 0

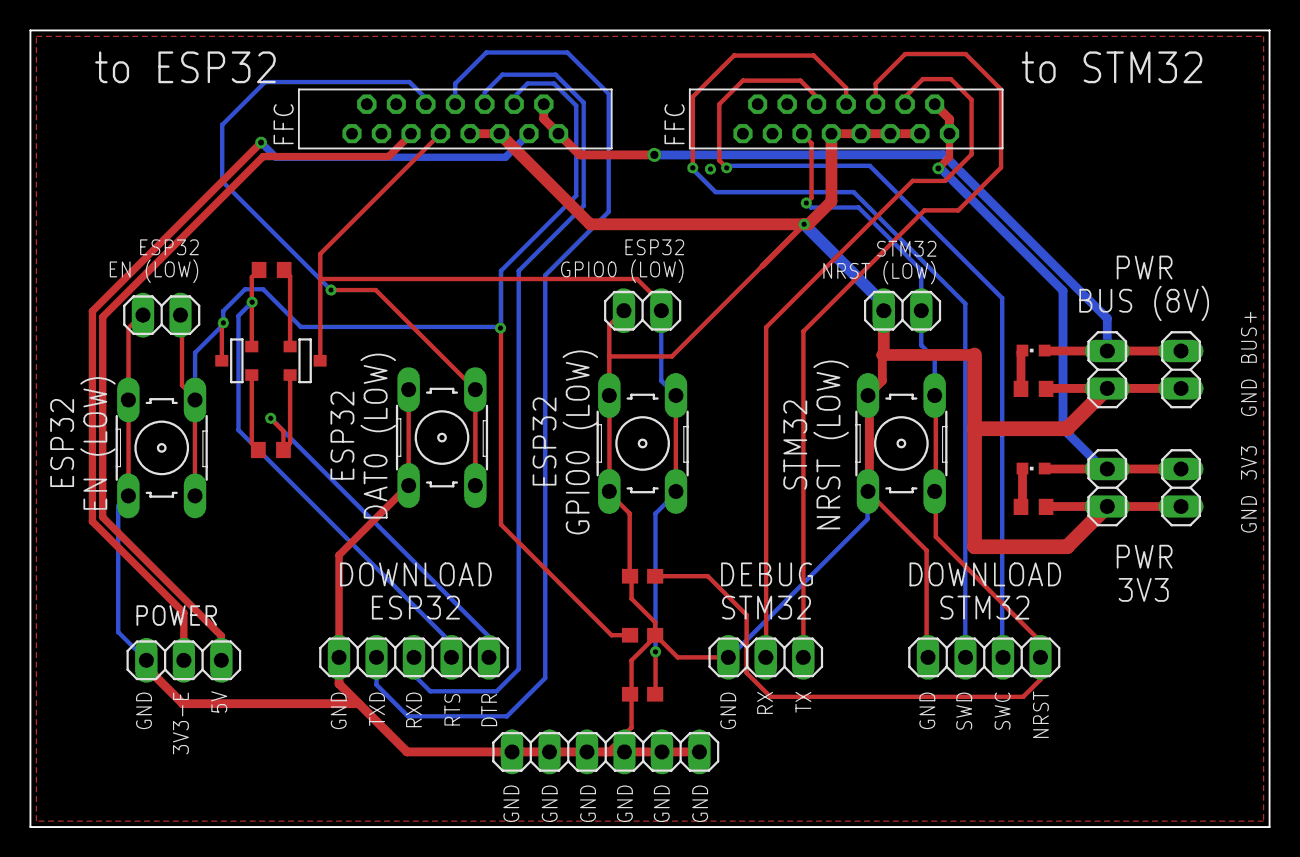
[picture p32: board Debug.brd from above]

Board: 2 copper layers, 84.0 x 54.0 mm, 29 parts (0 on the bottom side), 21 nets.
