cansat-tsniimash/can-cube-sat-2022/schematics/board/BKU.brd

## EAGLE design schematics/board/BKU.brd (2021-05-13)

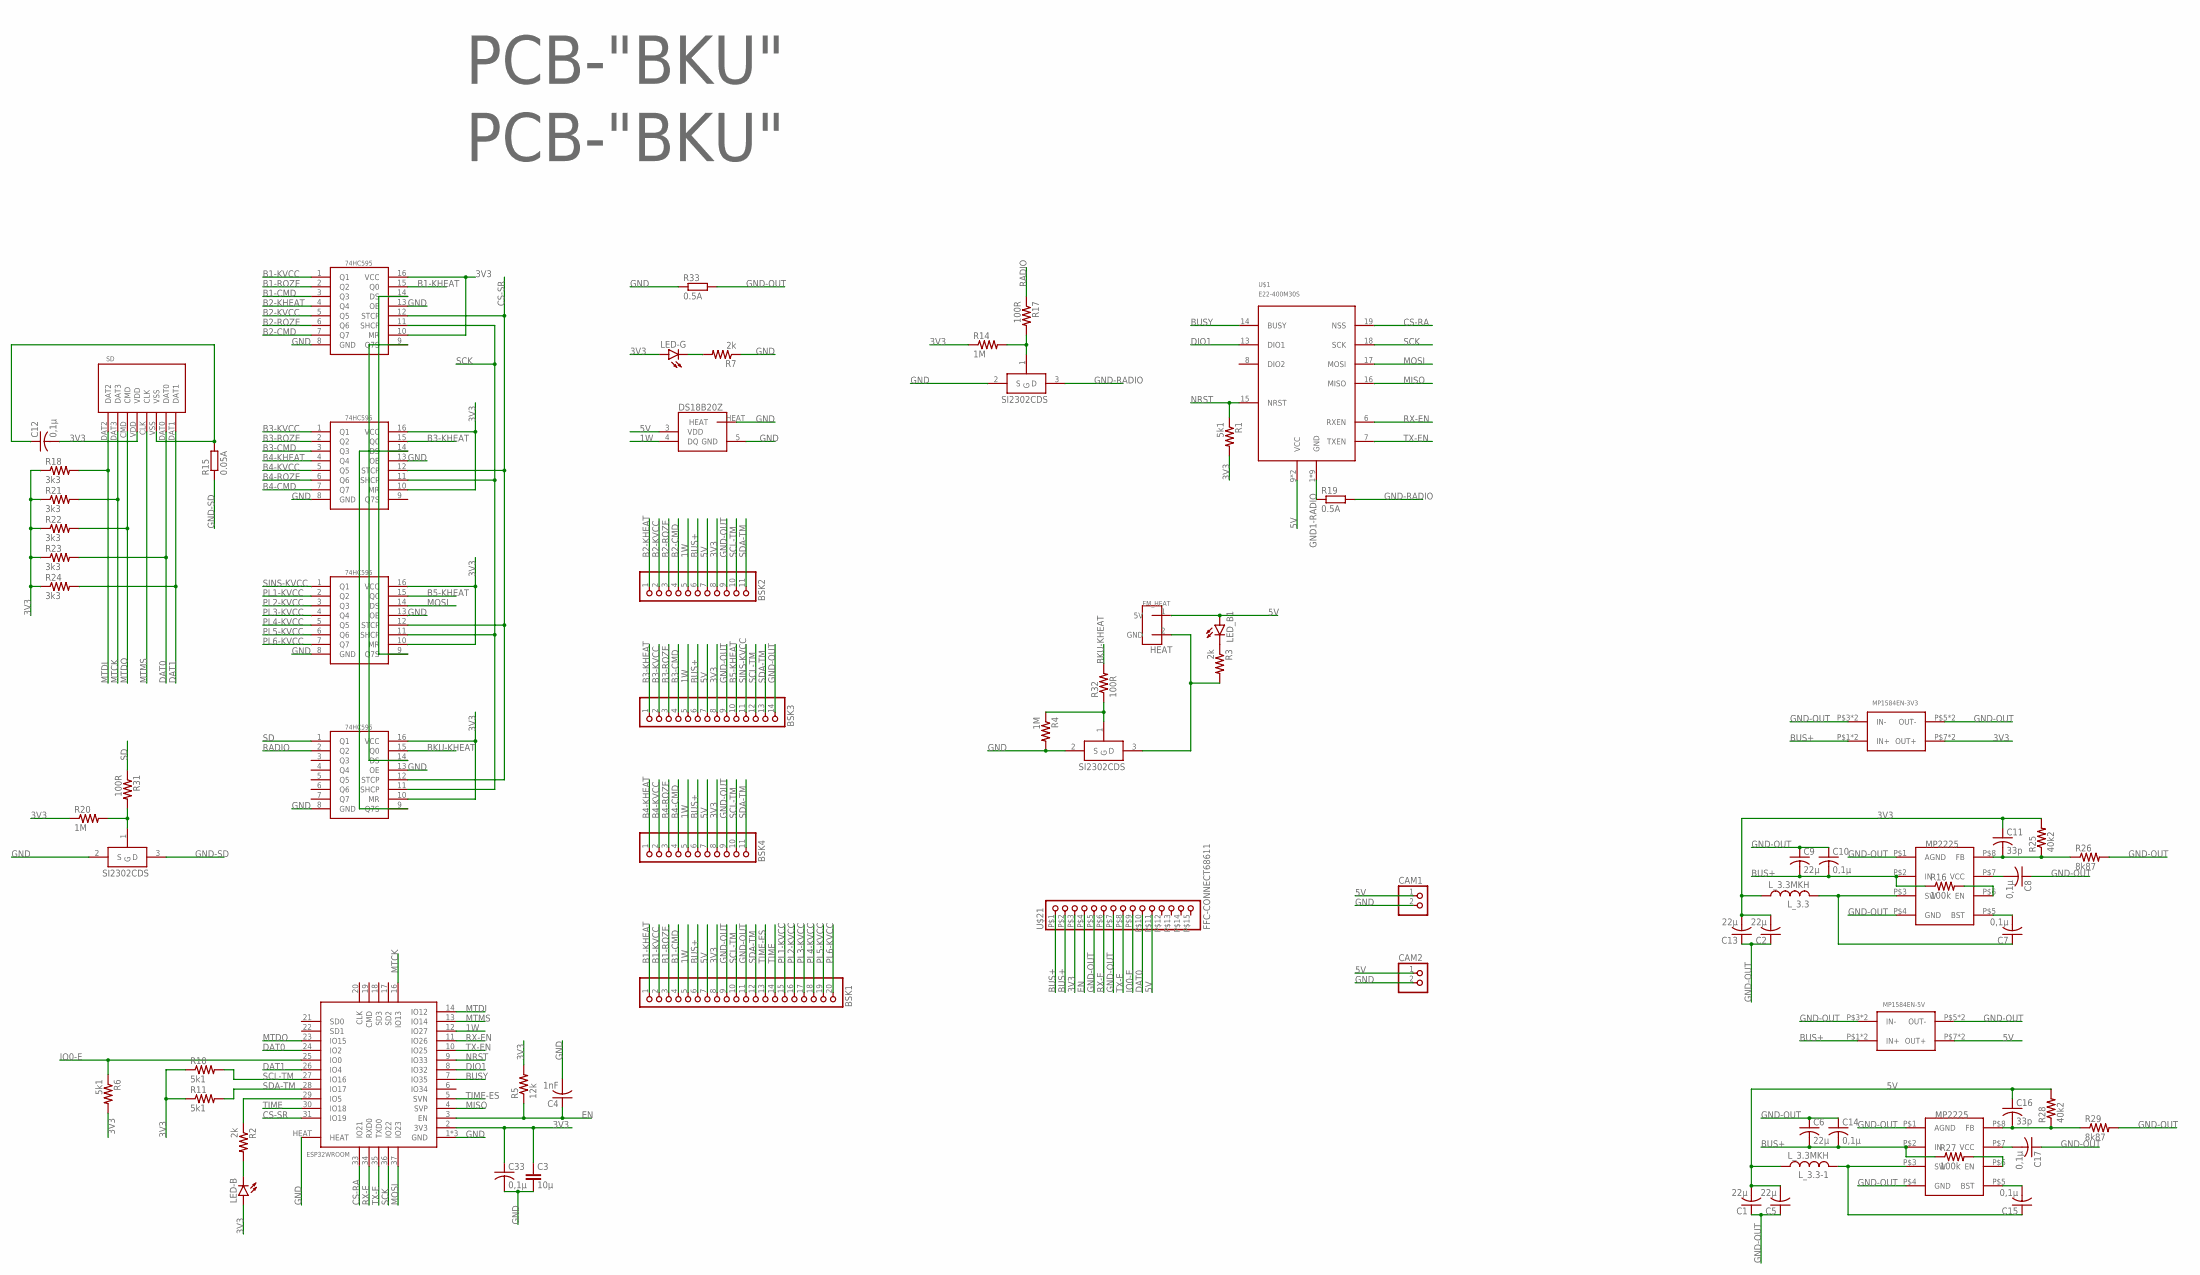
[picture p33: schematic BKU.sch]

Parts:
74HC595#1, 74HC595#2, 74HC595#3, 74HC595#4: 74HC595; TSSOP16
BSK1: PINHD-1X20; 1X20
BSK2, BSK4: PINHD-1X11; 1X11
BSK3: PINHD-1X14; 1X14
C1, C2, C5, C6, C9, C13: 22µ; C1206
C3: 10µ; C1206
C4: 1nF; C0603
C7, C8, C10, C12, C14, C15, C17, C33: 0,1µ; C0603
C11, C16: 33p; C0603
CAM1, CAM2: PINHD-1X2; 1X02
LED-B: LEDCHIPLED_0603; CHIPLED_0603
LED-G: LEDCHIPLED_0603; CHIPLED_0603
LED_B1: LEDCHIPLED_0603; CHIPLED_0603
L_3.3, L_3.3-1: L_3.3MKH; L_SPM5020
MP1584EN-3V3, MP1584EN-5V: MP1584-B
MP2225-3V3, MP2225-5V: MP2225; TSOT23-8
R1, R6, R10, R11: 5k1; R0603
R2, R3, R7: 2k; R0603
R4, R14, R20: 1M; R0603
R5: 12k; R0603
R15: 0.05A; R1210
R16, R27: 100k; R0603
R17, R31, R32: 100R; R0603
R18, R21, R22, R23, R24: 3k3; R0603
R19, R33: 0.5A; R1210
R25, R28: 40k2; R0603
R26, R29: 8k87; R0603
SD: SD
U$1: E22-400M30S
U$2, U$6: PCB-"BKU"; ITS-LOGO
U$3, U$4, U$23: SI2302CDS; SOT23-3
U$5: DS18B20Z; SOIC8+HEAT_S
U$13: ESP32WROOM
U$21: FFC-CONNECT68611; 68611
U$24: EM_HEAT

Connections:
1W: BSK1.5, BSK2.5, BSK3.5, BSK4.5, U$5.4 (DQ), U$13.12 (IO27)
3: R3.2, U$23.3 (D), U$24.2 (GND)
3V3: 74HC595#1.10 (MR), 74HC595#1.16 (VCC), 74HC595#2.10 (MR), 74HC595#2.16 (VCC), 74HC595#3.10 (MR), 74HC595#3.16 (VCC), 74HC595#4.10 (MR), 74HC595#4.16 (VCC), BSK1.8, BSK2.8, BSK3.8, BSK4.8, C2.2, C3.1, C11.1, C12.2, C13.2, C33.1, LED-B.A, LED-G.A, L_3.3.P$1 (1), MP1584EN-3V3.P$7 (OUT+), MP1584EN-3V3.P$8 (OUT+), R1.2, R5.2, R6.2, R10.1, R11.1, R14.1, R18.1, R20.1, R21.1, R22.1, R23.1, R24.1, R25.2, SD.VDD, U$13.2 (3V3), U$21.P$3 (3)
5V: BSK1.7, BSK2.7, BSK3.7, BSK4.7, C1.2, C5.2, C16.1, CAM1.1, CAM2.1, LED_B1.A, L_3.3-1.P$1 (1), MP1584EN-5V.P$7 (OUT+), MP1584EN-5V.P$8 (OUT+), R28.2, U$1.9 (VCC), U$1.10 (VCC), U$5.3 (VDD), U$21.P$11 (11), U$24.1 (5V)
B1-CMD: 74HC595#1.3 (Q3), BSK1.4
B1-KHEAT: 74HC595#1.15 (Q0), BSK1.1
B1-KVCC: 74HC595#1.1 (Q1), BSK1.2
B1-ROZE: 74HC595#1.2 (Q2), BSK1.3
B2-CMD: 74HC595#1.7 (Q7), BSK2.4
B2-KHEAT: 74HC595#1.4 (Q4), BSK2.1
B2-KVCC: 74HC595#1.5 (Q5), BSK2.2
B2-ROZE: 74HC595#1.6 (Q6), BSK2.3
B3-CMD: 74HC595#2.3 (Q3), BSK3.4
B3-KHEAT: 74HC595#2.15 (Q0), BSK3.1
B3-KVCC: 74HC595#2.1 (Q1), BSK3.2
B3-ROZE: 74HC595#2.2 (Q2), BSK3.3
B4-CMD: 74HC595#2.7 (Q7), BSK4.4
B4-KHEAT: 74HC595#2.4 (Q4), BSK4.1
B4-KVCC: 74HC595#2.5 (Q5), BSK4.2
B4-ROZE: 74HC595#2.6 (Q6), BSK4.3
B5-KHEAT: 74HC595#3.15 (Q0), BSK3.10
BKU-KHEAT: 74HC595#4.15 (Q0), R32.2
BUS+: BSK1.6, BSK2.6, BSK3.6, BSK4.6, C6.2, C9.2, C10.2, C14.2, MP1584EN-3V3.P$1 (IN+), MP1584EN-3V3.P$2 (IN+), MP1584EN-5V.P$1 (IN+), MP1584EN-5V.P$2 (IN+), MP2225-3V3.P$2 (IN), MP2225-5V.P$2 (IN), R16.1, R27.1, U$21.P$1 (1), U$21.P$2 (2)
BUSY: U$1.14 (BUSY), U$13.7 (IO35)
CS-RA: U$1.19 (NSS), U$13.33 (IO21)
CS-SR: 74HC595#1.12 (STCP), 74HC595#2.12 (STCP), 74HC595#3.12 (STCP), 74HC595#4.12 (STCP), U$13.31 (IO19)
DAT0: R23.2, SD.DAT0, U$13.24 (IO2), U$21.P$10 (10)
DAT1: R24.2, SD.DAT1, U$13.26 (IO4)
DIO1: U$1.13 (DIO1), U$13.8 (IO32)
EN: C4.1, R5.1, U$13.3 (EN), U$21.P$4 (4)
GND: 74HC595#1.8 (GND), 74HC595#1.13 (OE), 74HC595#2.8 (GND), 74HC595#2.13 (OE), 74HC595#3.8 (GND), 74HC595#3.13 (OE), 74HC595#4.8 (GND), 74HC595#4.13 (OE), C3.2, C4.2, C33.2, CAM1.2, CAM2.2, R4.2, R7.1, R33.1, U$3.2 (S), U$4.2 (S), U$5.5 (GND), U$5.HEAT, U$13.1 (GND), U$13.15 (GND), U$13.38 (GND), U$13.HEAT, U$23.2 (S)
GND1-RADIO: R19.1, U$1.1 (GND), U$1.2 (GND), U$1.3 (GND), U$1.4 (GND), U$1.5 (GND), U$1.11 (GND), U$1.12 (GND), U$1.20 (GND), U$1.22 (GND)
GND-OUT: BSK1.9, BSK1.11, BSK2.9, BSK3.9, BSK3.14, BSK4.9, C1.1, C2.1, C5.1, C6.1, C8.1, C9.1, C10.1, C13.1, C14.1, C17.1, MP1584EN-3V3.P$3 (IN-), MP1584EN-3V3.P$4 (IN-), MP1584EN-3V3.P$5 (OUT-), MP1584EN-3V3.P$6 (OUT-), MP1584EN-5V.P$3 (IN-), MP1584EN-5V.P$4 (IN-), MP1584EN-5V.P$5 (OUT-), MP1584EN-5V.P$6 (OUT-), MP2225-3V3.P$1 (AGND), MP2225-3V3.P$4 (GND), MP2225-5V.P$1 (AGND), MP2225-5V.P$4 (GND), R26.2, R29.2, R33.2, U$21.P$5 (5), U$21.P$7 (7)
GND-RADIO: R19.2, U$4.3 (D)
GND-SD: R15.1, U$3.3 (D)
IO0-E: R6.1, U$13.25 (IO0), U$21.P$9 (9)
IO1: R2.1, U$13.29 (IO5)
MISO: U$1.16 (MISO), U$13.4 (SVP)
MOSI: 74HC595#3.14 (DS), U$1.17 (MOSI), U$13.37 (IO23)
MTCK: R21.2, SD.DAT3, U$13.16 (IO13)
MTDI: R18.2, SD.DAT2, U$13.14 (IO12)
MTDO: R22.2, SD.CMD, U$13.23 (IO15)
MTMS: SD.CLK, U$13.13 (IO14)
unnamed: 74HC595#1.9 (Q7S), 74HC595#4.14 (DS)
unnamed: LED_B1.C, R3.1
unnamed: LED-G.C, R7.2
unnamed: LED-B.C, R2.2
unnamed: C12.1, R15.2, SD.VSS
unnamed: R14.2, R17.2, U$4.1 (G)
unnamed: 74HC595#2.14 (DS), 74HC595#4.9 (Q7S)
unnamed: C15.1, L_3.3-1.P$2 (2), MP2225-5V.P$3 (SW)
unnamed: C15.2, MP2225-5V.P$5 (BST)
unnamed: MP2225-5V.P$6 (EN), R27.2
unnamed: R20.2, R31.2, U$3.1 (G)
unnamed: C17.2, MP2225-5V.P$7 (VCC)
unnamed: C7.2, MP2225-3V3.P$5 (BST)
unnamed: C7.1, L_3.3.P$2 (2), MP2225-3V3.P$3 (SW)
unnamed: MP2225-3V3.P$6 (EN), R16.2
unnamed: C8.2, MP2225-3V3.P$7 (VCC)
unnamed: 74HC595#1.14 (DS), 74HC595#3.9 (Q7S)
unnamed: C11.2, MP2225-3V3.P$8 (FB), R25.1, R26.1
unnamed: C16.2, MP2225-5V.P$8 (FB), R28.1, R29.1
unnamed: R4.1, R32.1, U$23.1 (G)
NRST: R1.1, U$1.15 (NRST), U$13.9 (IO33)
PL1-KVCC: 74HC595#3.2 (Q2), BSK1.15
PL2-KVCC: 74HC595#3.3 (Q3), BSK1.16
PL3-KVCC: 74HC595#3.4 (Q4), BSK1.17
PL4-KVCC: 74HC595#3.5 (Q5), BSK1.18
PL5-KVCC: 74HC595#3.6 (Q6), BSK1.19
PL6-KVCC: 74HC595#3.7 (Q7), BSK1.20
RADIO: 74HC595#4.2 (Q2), R17.1
RX-E: U$13.34 (RXD0), U$21.P$6 (6)
RX-EN: U$1.6 (RXEN), U$13.11 (IO26)
SCK: 74HC595#1.11 (SHCP), 74HC595#2.11 (SHCP), 74HC595#3.11 (SHCP), 74HC595#4.11 (SHCP), U$1.18 (SCK), U$13.36 (IO22)
SCL-TM: BSK1.10, BSK2.10, BSK3.12, BSK4.10, R10.2, U$13.27 (IO16)
SD: 74HC595#4.1 (Q1), R31.1
SDA-TM: BSK1.12, BSK2.11, BSK3.13, BSK4.11, R11.2, U$13.28 (IO17)
SINS-KVCC: 74HC595#3.1 (Q1), BSK3.11
TIME: BSK1.14, U$13.30 (IO18)
TIME-ES: BSK1.13, U$13.5 (SVN)
TX-E: U$13.35 (TXD0), U$21.P$8 (8)
TX-EN: U$1.7 (TXEN), U$13.10 (IO25)

Notes on the sheet:
HEAT

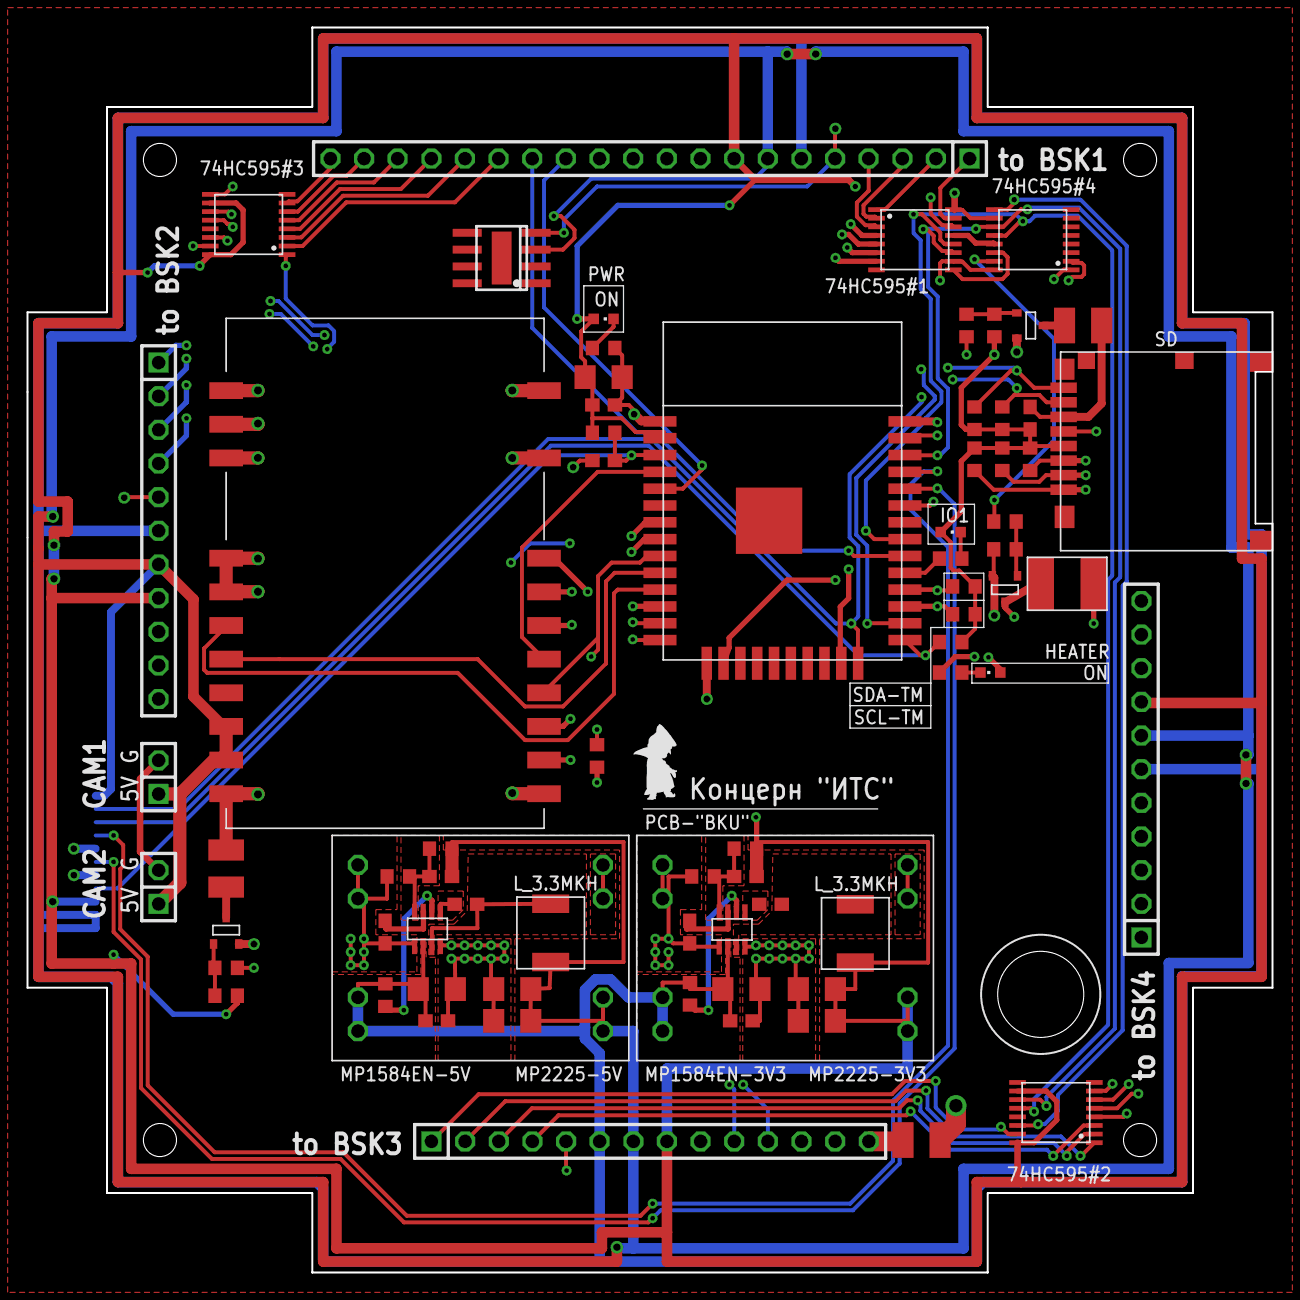
[picture p34: board BKU.brd from above]

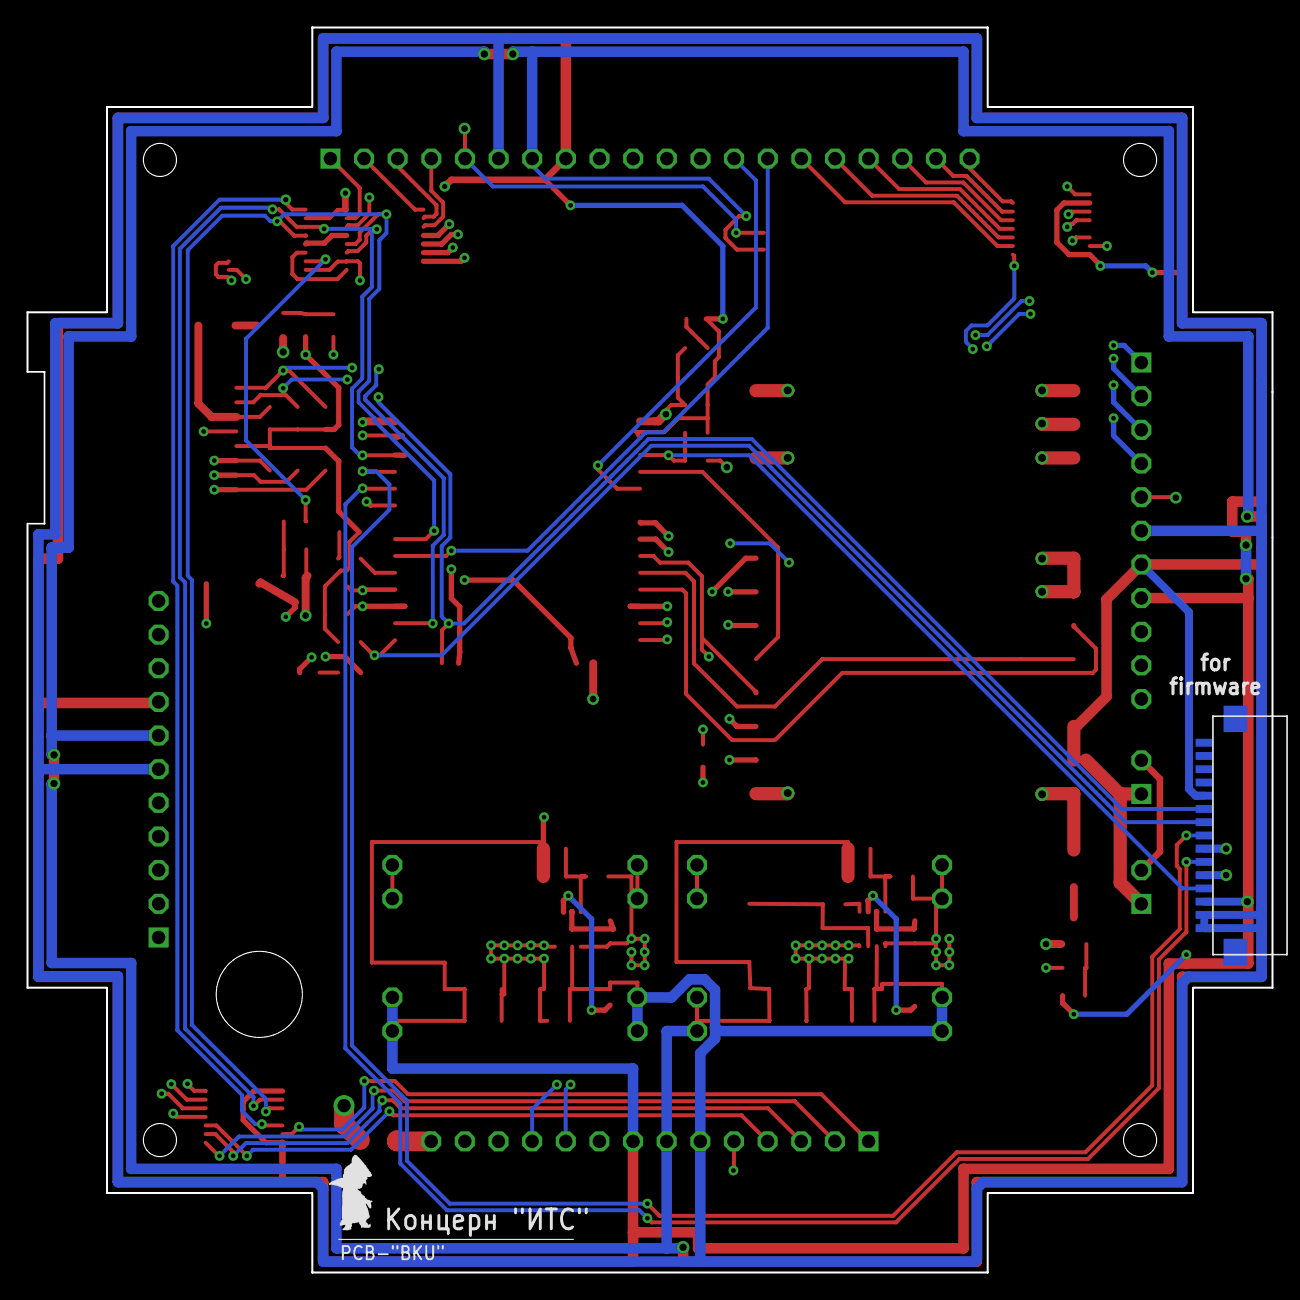
[picture p35: board BKU.brd from below]

Board: 4 copper layers, 94.0 x 94.0 mm, 76 parts (2 on the bottom side), 82 nets.
