cansat-tsniimash/can-cube-sat-2022/schematics/board/BSK5.brd

## EAGLE design schematics/board/BSK5.brd (2021-04-24)

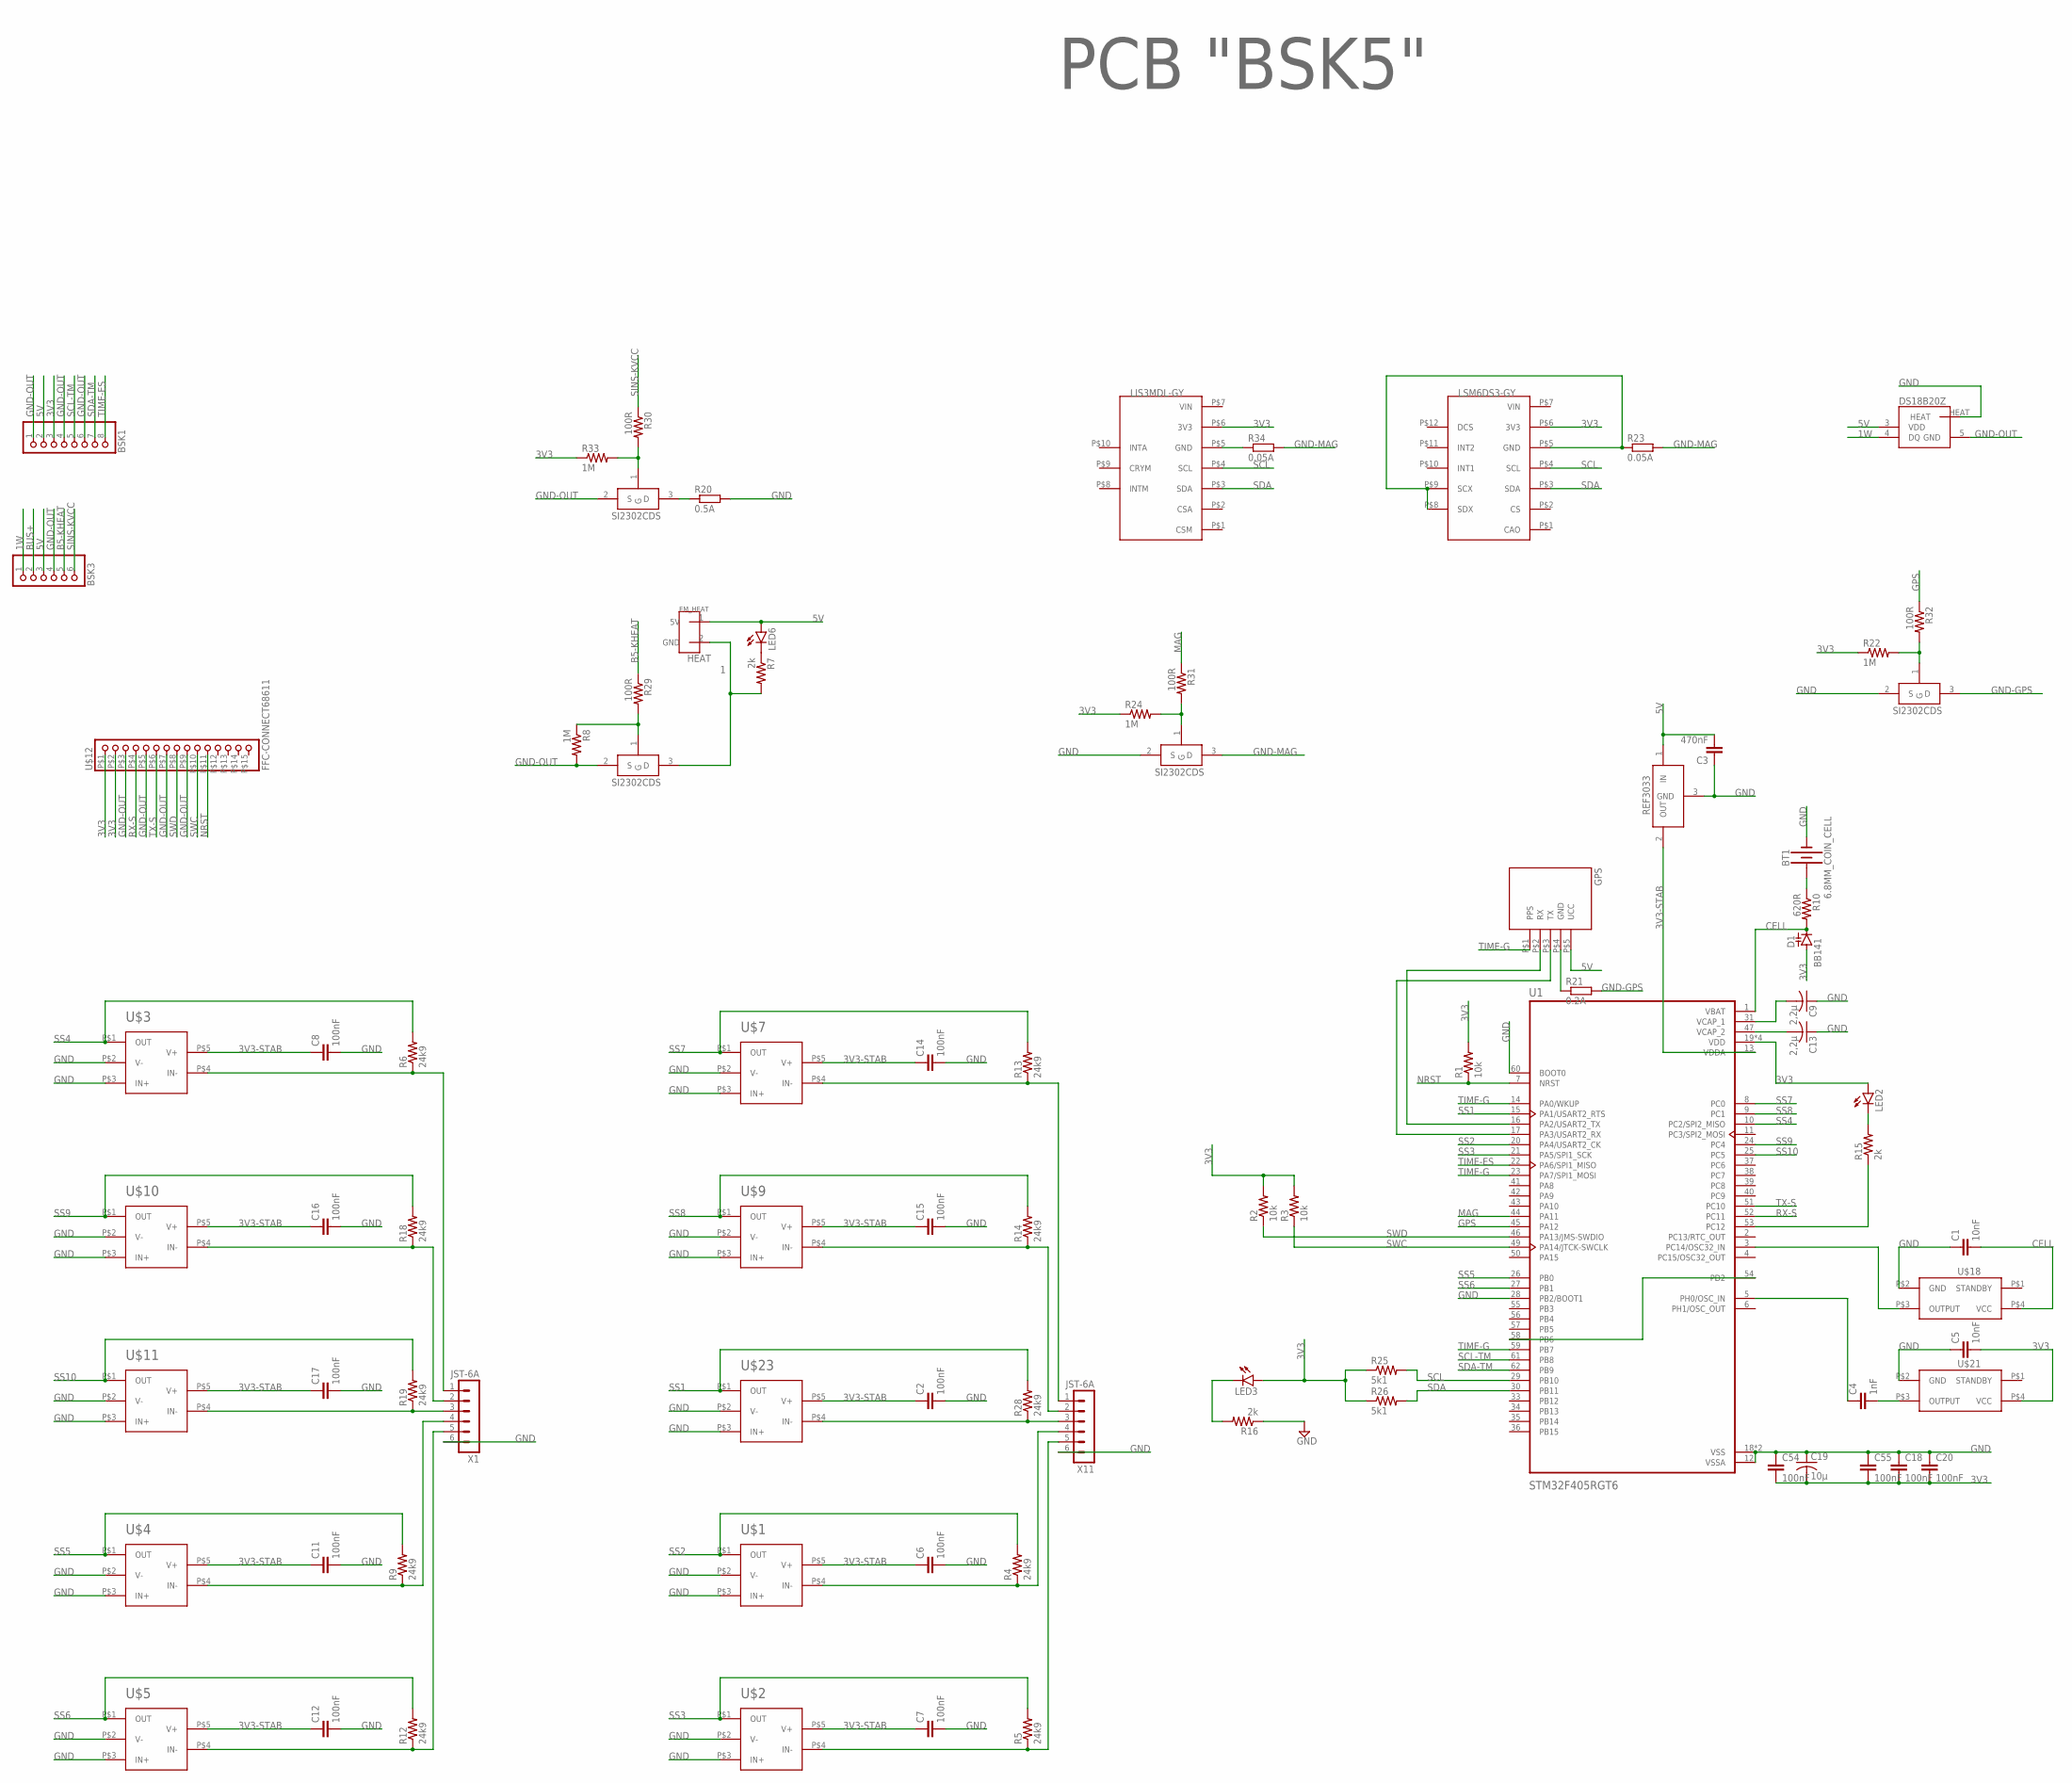
[picture p36: schematic BSK5.sch]

Parts:
BSK1: PINHD-1X8; 1X08
BSK3: PINHD-1X6; 1X06
BT1: 6.8MM_COIN_CELL; BATTCON-6.8MM
C1, C5: 10nF; C0603
C2, C6, C7, C8, C11, C12, C14, C15, C16, C17, C18, C20, C54, C55: 100nF; C0603
C3: 470nF; C0603
C4: 1nF; C0603
C9, C13: 2,2µ; C0603
C19: 10µ; C1206
D1: BB141; SOD523
DS18B20Z1: DS18B20Z; SOIC8+HEAT_S
GPS: GPSNEO6M; GPS-NEO6M
LED2, LED3, LED6: LEDCHIPLED_0603; CHIPLED_0603
LIS3MDL-GY: LIS3MDL-GY
LSM6DS3-GY: LSM6DS3-GY
R1, R2, R3: 10k; R0603
R4, R5, R6, R9, R12, R13, R14, R18, R19, R28: 24k9; R0603
R7, R15, R16: 2k; R0603
R8, R22, R24, R33: 1M; R0603
R10: 620R; R0603
R20: 0.5A; R1210
R21: 0.2A; R1210
R23, R34: 0.05A; R1210
R25, R26: 5k1; R0603
R29, R30, R31, R32: 100R; R0603
U1: STM32F405RGT6; QFP50P1200X1200X160-64N
U$1, U$2, U$3, U$4, U$5, U$7, U$9, U$10, U$11, U$23: LMC7101
U$6: REF3033; SOT23-3
U$8, U$19, U$20, U$22: SI2302CDS; SOT23-3
U$12: FFC-CONNECT68611; 68611
U$14: EM_HEAT
U$18: Q32.768
U$21: Q24
U$26: PCB "BSK5"; ITS-LOGO
X1, X11: JST-6A; B6B-EH-A

Connections:
1: R7.2, U$8.3 (D), U$14.2 (GND)
1W: BSK3.1, DS18B20Z1.4 (DQ)
3V3: BSK1.3, C5.2, C18.2, C19.2, C20.2, C54.2, C55.2, D1.A, LED2.A, LED3.A, LIS3MDL-GY.P$6 (3V3), LSM6DS3-GY.P$6 (3V3), R1.2, R2.2, R3.2, R22.1, R24.1, R25.1, R26.1, R33.1, U1.19 (VDD), U1.32 (VDD), U1.48 (VDD), U1.64 (VDD), U$12.P$1 (1), U$12.P$2 (2), U$21.P$4 (VCC)
3V3-STAB: C2.1, C6.1, C7.1, C8.1, C11.1, C12.1, C14.1, C15.1, C16.1, C17.1, U1.13 (VDDA), U$1.P$5 (V+), U$2.P$5 (V+), U$3.P$5 (V+), U$4.P$5 (V+), U$5.P$5 (V+), U$6.2 (OUT), U$7.P$5 (V+), U$9.P$5 (V+), U$10.P$5 (V+), U$11.P$5 (V+), U$23.P$5 (V+)
5V: BSK1.2, BSK3.3, C3.2, DS18B20Z1.3 (VDD), GPS.P$5 (UCC), LED6.A, U$6.1 (IN), U$14.1 (5V)
B5-KHEAT: BSK3.5, R29.1
BUS+: BSK3.2
CELL: C1.2, D1.C, R10.2, U1.1 (VBAT), U$18.P$4 (VCC)
GND: BT1.-, C1.1, C2.2, C3.1, C5.1, C6.2, C7.2, C8.2, C9.1, C11.2, C12.2, C13.1, C14.2, C15.2, C16.2, C17.2, C18.1, C19.1, C20.1, C54.1, C55.1, DS18B20Z1.HEAT, R16.1, R20.2, U1.12 (VSSA), U1.18 (VSS), U1.28 (PB2/BOOT1), U1.60 (BOOT0), U1.63 (VSS), U$1.P$2 (V-), U$1.P$3 (IN+), U$2.P$2 (V-), U$2.P$3 (IN+), U$3.P$2 (V-), U$3.P$3 (IN+), U$4.P$2 (V-), U$4.P$3 (IN+), U$5.P$2 (V-), U$5.P$3 (IN+), U$6.3 (GND), U$7.P$2 (V-), U$7.P$3 (IN+), U$9.P$2 (V-), U$9.P$3 (IN+), U$10.P$2 (V-), U$10.P$3 (IN+), U$11.P$2 (V-), U$11.P$3 (IN+), U$18.P$2 (GND), U$19.2 (S), U$20.2 (S), U$21.P$2 (GND), U$23.P$2 (V-), U$23.P$3 (IN+), X1.6, X11.6
GND-GPS: R21.2, U$20.3 (D)
GND-MAG: R23.2, R34.2, U$19.3 (D)
GND-OUT: BSK1.1, BSK1.4, BSK1.6, BSK3.4, DS18B20Z1.5 (GND), R8.2, U$8.2 (S), U$12.P$3 (3), U$12.P$5 (5), U$12.P$7 (7), U$12.P$9 (9), U$22.2 (S)
GPS: R32.1, U1.45 (PA12)
MAG: R31.1, U1.44 (PA11)
unnamed: U1.3 (PC14/OSC32_IN), U$18.P$3 (OUTPUT)
unnamed: R20.1, U$22.3 (D)
unnamed: R13.1, U$7.P$4 (IN-), X11.1
unnamed: R6.1, U$3.P$4 (IN-), X1.1
unnamed: R9.1, U$4.P$4 (IN-), X1.4
unnamed: R8.1, R29.2, U$8.1 (G)
unnamed: R30.2, R33.2, U$22.1 (G)
unnamed: R24.2, R31.2, U$19.1 (G)
unnamed: LSM6DS3-GY.P$5 (GND), LSM6DS3-GY.P$8 (SDX), LSM6DS3-GY.P$9 (SCX), R23.1
unnamed: R22.2, R32.2, U$20.1 (G)
unnamed: LIS3MDL-GY.P$5 (GND), R34.1
unnamed: BT1.+, R10.1
unnamed: GPS.P$4 (GND), R21.1
unnamed: U1.54 (PD2), U1.58 (PB6)
unnamed: C13.2, U1.47 (VCAP_2)
unnamed: R4.1, U$1.P$4 (IN-), X11.4
unnamed: R5.1, U$2.P$4 (IN-), X11.5
unnamed: LED6.C, R7.1
unnamed: R12.1, U$5.P$4 (IN-), X1.5
unnamed: C9.2, U1.31 (VCAP_1)
unnamed: LED2.C, R15.2
unnamed: R15.1, U1.53 (PC12)
unnamed: LED3.C, R16.2
unnamed: GPS.P$2 (RX), U1.16 (PA2/USART2_TX)
unnamed: GPS.P$3 (TX), U1.17 (PA3/USART2_RX)
unnamed: C4.2, U$21.P$3 (OUTPUT)
unnamed: C4.1, U1.5 (PH0/OSC_IN)
unnamed: R28.1, U$23.P$4 (IN-), X11.3
unnamed: R14.1, U$9.P$4 (IN-), X11.2
unnamed: R18.1, U$10.P$4 (IN-), X1.2
unnamed: R19.1, U$11.P$4 (IN-), X1.3
NRST: R1.1, U1.7 (NRST), U$12.P$11 (11)
RX-S: U1.52 (PC11), U$12.P$4 (4)
SCL: LIS3MDL-GY.P$4 (SCL), LSM6DS3-GY.P$4 (SCL), R25.2, U1.29 (PB10)
SCL-TM: BSK1.5, U1.61 (PB8)
SDA: LIS3MDL-GY.P$3 (SDA), LSM6DS3-GY.P$3 (SDA), R26.2, U1.30 (PB11)
SDA-TM: BSK1.7, U1.62 (PB9)
SINS-KVCC: BSK3.6, R30.1
SS1: R28.2, U1.15 (PA1/USART2_RTS), U$23.P$1 (OUT)
SS2: R4.2, U1.20 (PA4/USART2_CK), U$1.P$1 (OUT)
SS3: R5.2, U1.21 (PA5/SPI1_SCK), U$2.P$1 (OUT)
SS4: R6.2, U1.10 (PC2/SPI2_MISO), U$3.P$1 (OUT)
SS5: R9.2, U1.26 (PB0), U$4.P$1 (OUT)
SS6: R12.2, U1.27 (PB1), U$5.P$1 (OUT)
SS7: R13.2, U1.8 (PC0), U$7.P$1 (OUT)
SS8: R14.2, U1.9 (PC1), U$9.P$1 (OUT)
SS9: R18.2, U1.24 (PC4), U$10.P$1 (OUT)
SS10: R19.2, U1.25 (PC5), U$11.P$1 (OUT)
SWC: R3.1, U1.49 (PA14/JTCK-SWCLK), U$12.P$10 (10)
SWD: R2.1, U1.46 (PA13/JMS-SWDIO), U$12.P$8 (8)
TIME-ES: BSK1.8, U1.22 (PA6/SPI1_MISO)
TIME-G: GPS.P$1 (PPS), U1.14 (PA0/WKUP), U1.23 (PA7/SPI1_MOSI), U1.59 (PB7)
TX-S: U1.51 (PC10), U$12.P$6 (6)

Notes on the sheet:
HEAT
