cansat-tsniimash/can-cube-sat-2022/schematics/board/BSK5.brd

## EAGLE design schematics/board/BSK5.brd (continued)

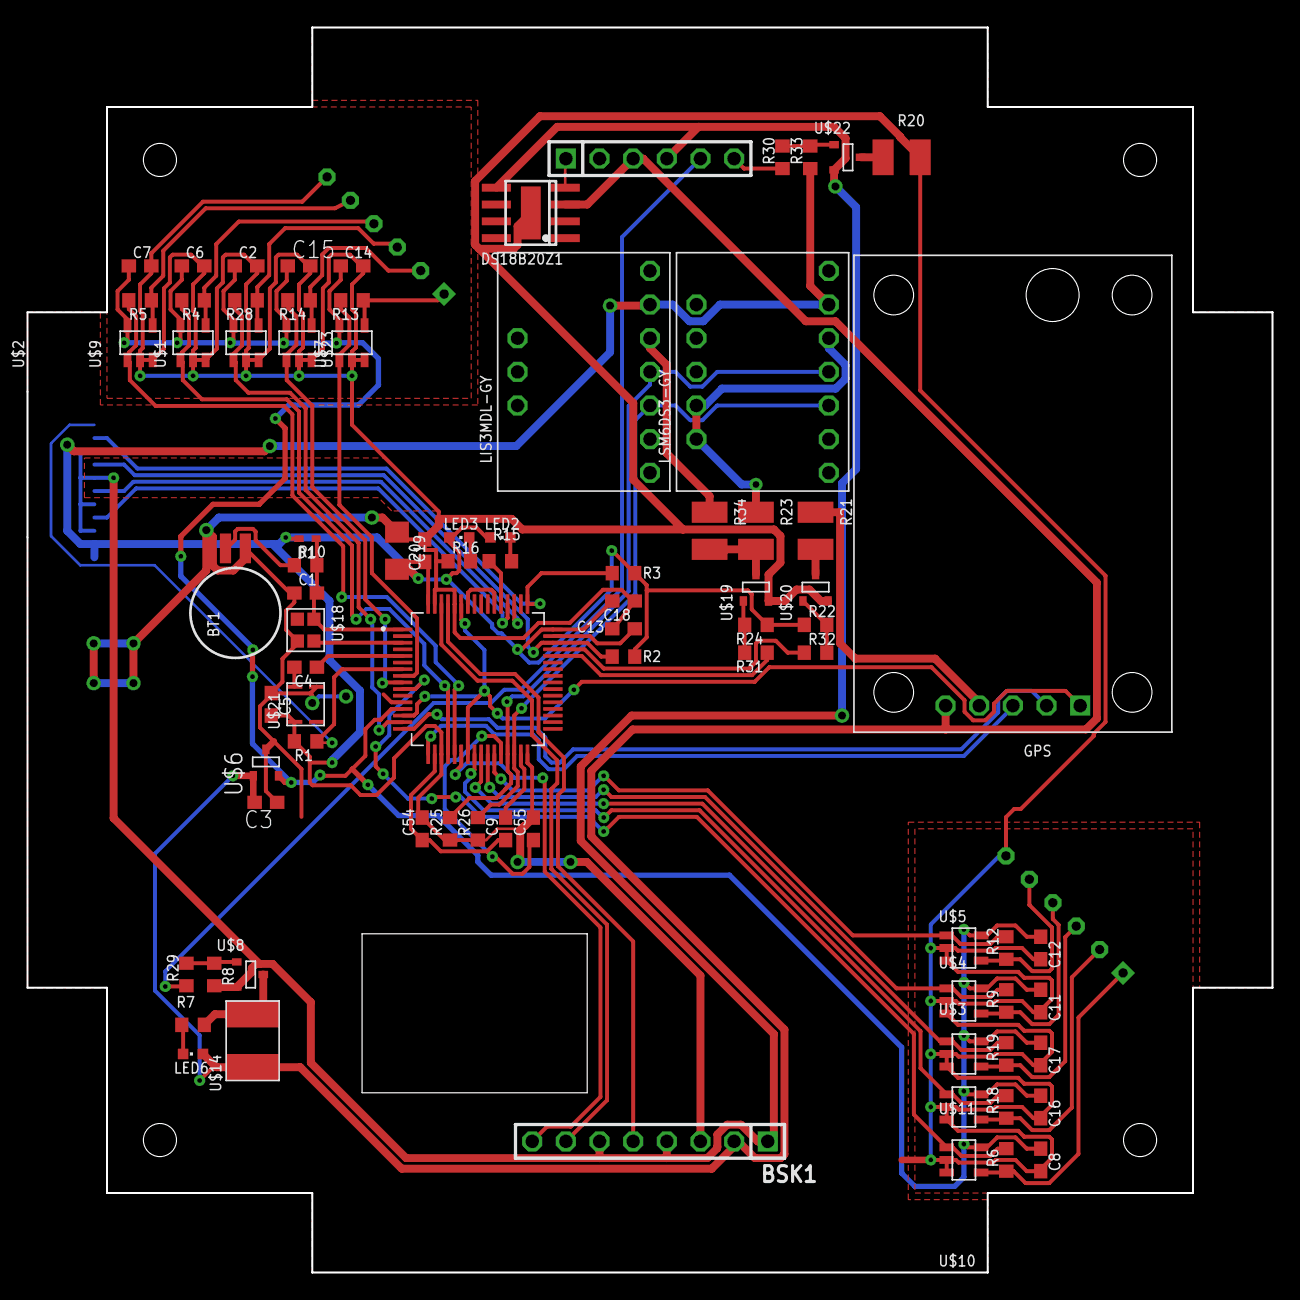
[picture p37: board BSK5.brd from above]

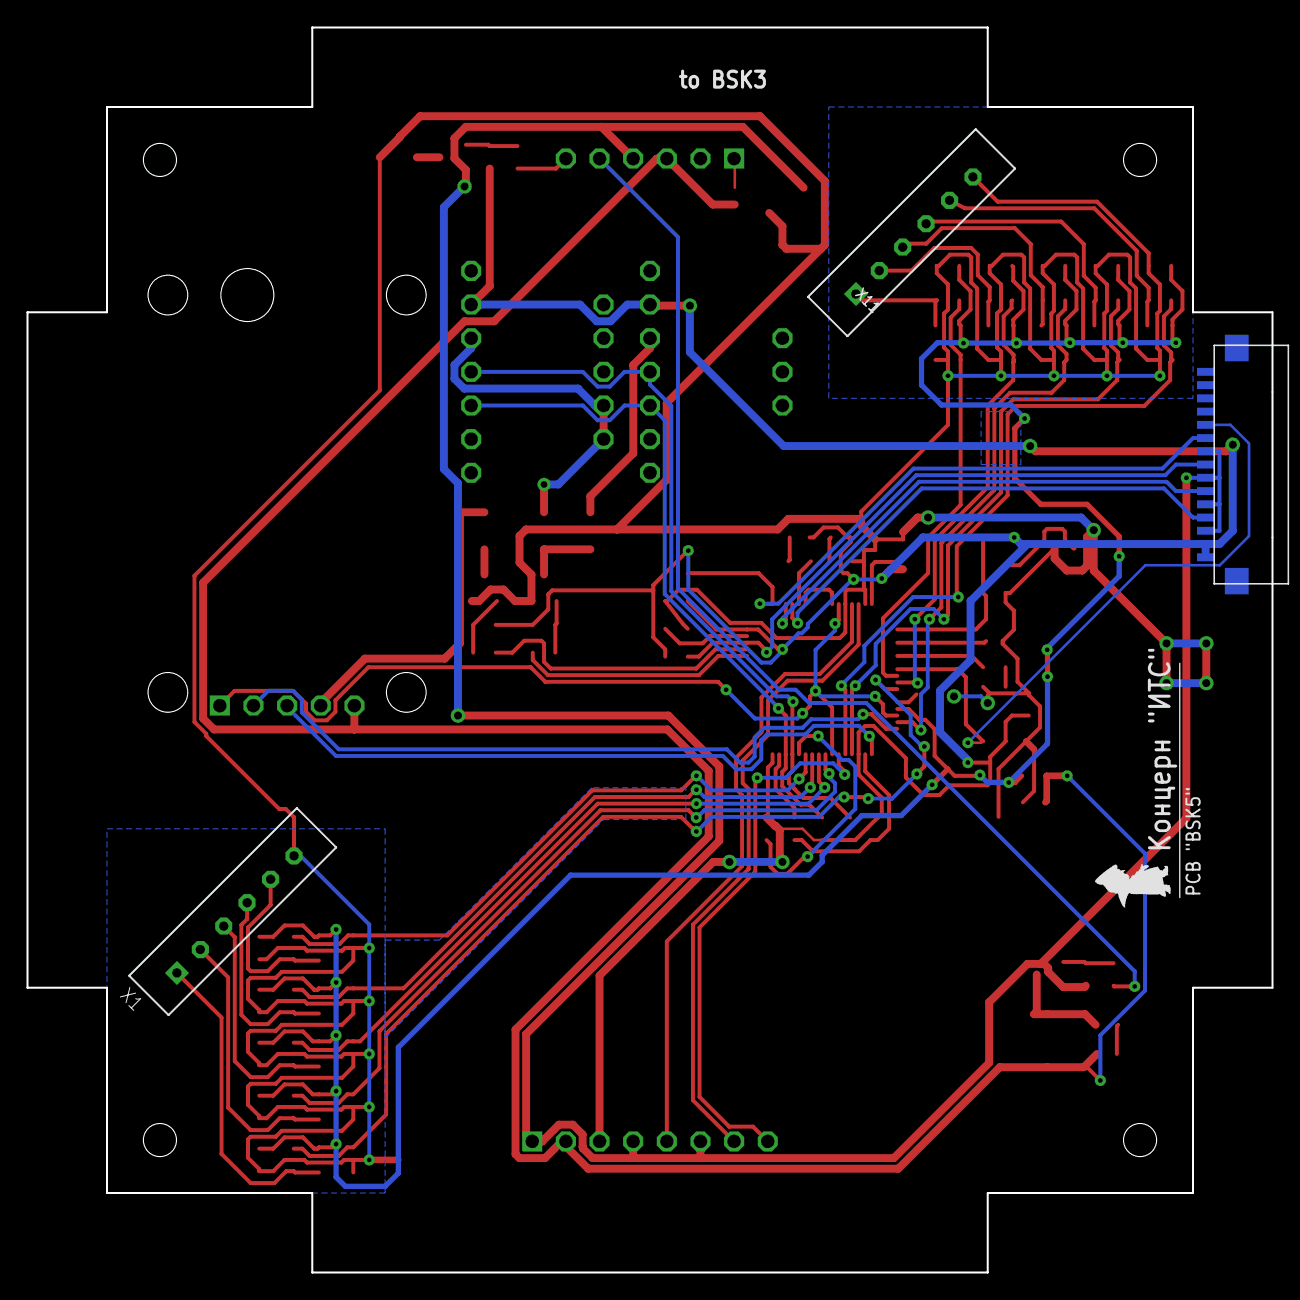
[picture p38: board BSK5.brd from below]

Board: 2 copper layers, 94.0 x 94.0 mm, 86 parts (4 on the bottom side), 66 nets.
