cansat-tsniimash/can-cube-sat-2022/schematics/board/MP2225.brd

## EAGLE design schematics/board/MP2225.brd (2021-04-22)

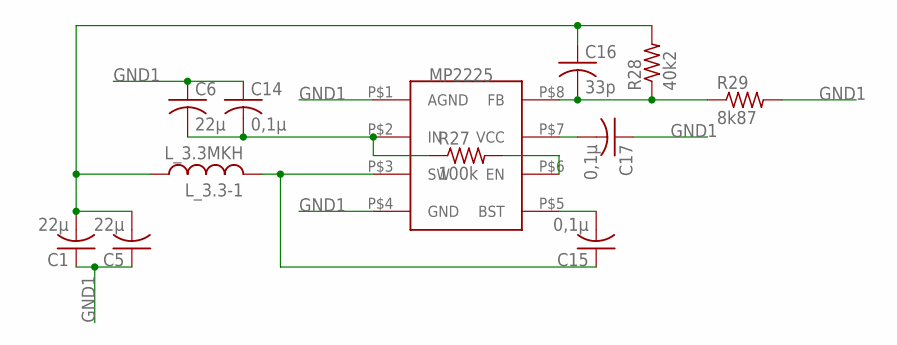
[picture p39: schematic MP2225.sch]

Parts:
C1, C5, C6: 22µ; C1206
C14, C15, C17: 0,1µ; C0603
C16: 33p; C0603
L_3.3-1: L_3.3MKH; L_SPM5020
MP2225-1: MP2225; TSOT23-8
R27: 100k; R0603
R28: 40k2; R0603
R29: 8k87; R0603

Connections:
GND1: C1.1, C5.1, C6.1, C14.1, C17.1, MP2225-1.P$1 (AGND), MP2225-1.P$4 (GND), R29.2
unnamed: C1.2, C5.2, C16.1, L_3.3-1.P$1 (1), R28.2
unnamed: C6.2, C14.2, MP2225-1.P$2 (IN), R27.1
unnamed: C15.1, L_3.3-1.P$2 (2), MP2225-1.P$3 (SW)
unnamed: C15.2, MP2225-1.P$5 (BST)
unnamed: MP2225-1.P$6 (EN), R27.2
unnamed: C17.2, MP2225-1.P$7 (VCC)
unnamed: C16.2, MP2225-1.P$8 (FB), R28.1, R29.1

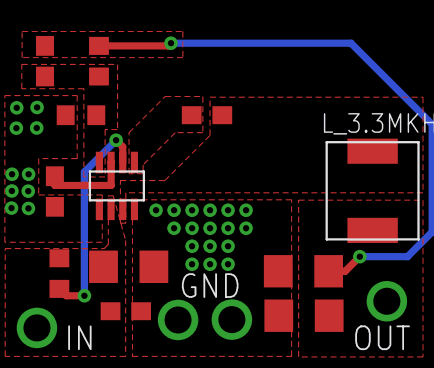
[picture p40: board MP2225.brd from above]

Board: 2 copper layers, 12 parts (0 on the bottom side), 8 nets.
