cansat-tsniimash/can-cube-sat-2022/schematics/board/BSK2.brd

## EAGLE design schematics/board/BSK2.brd (2021-04-13)

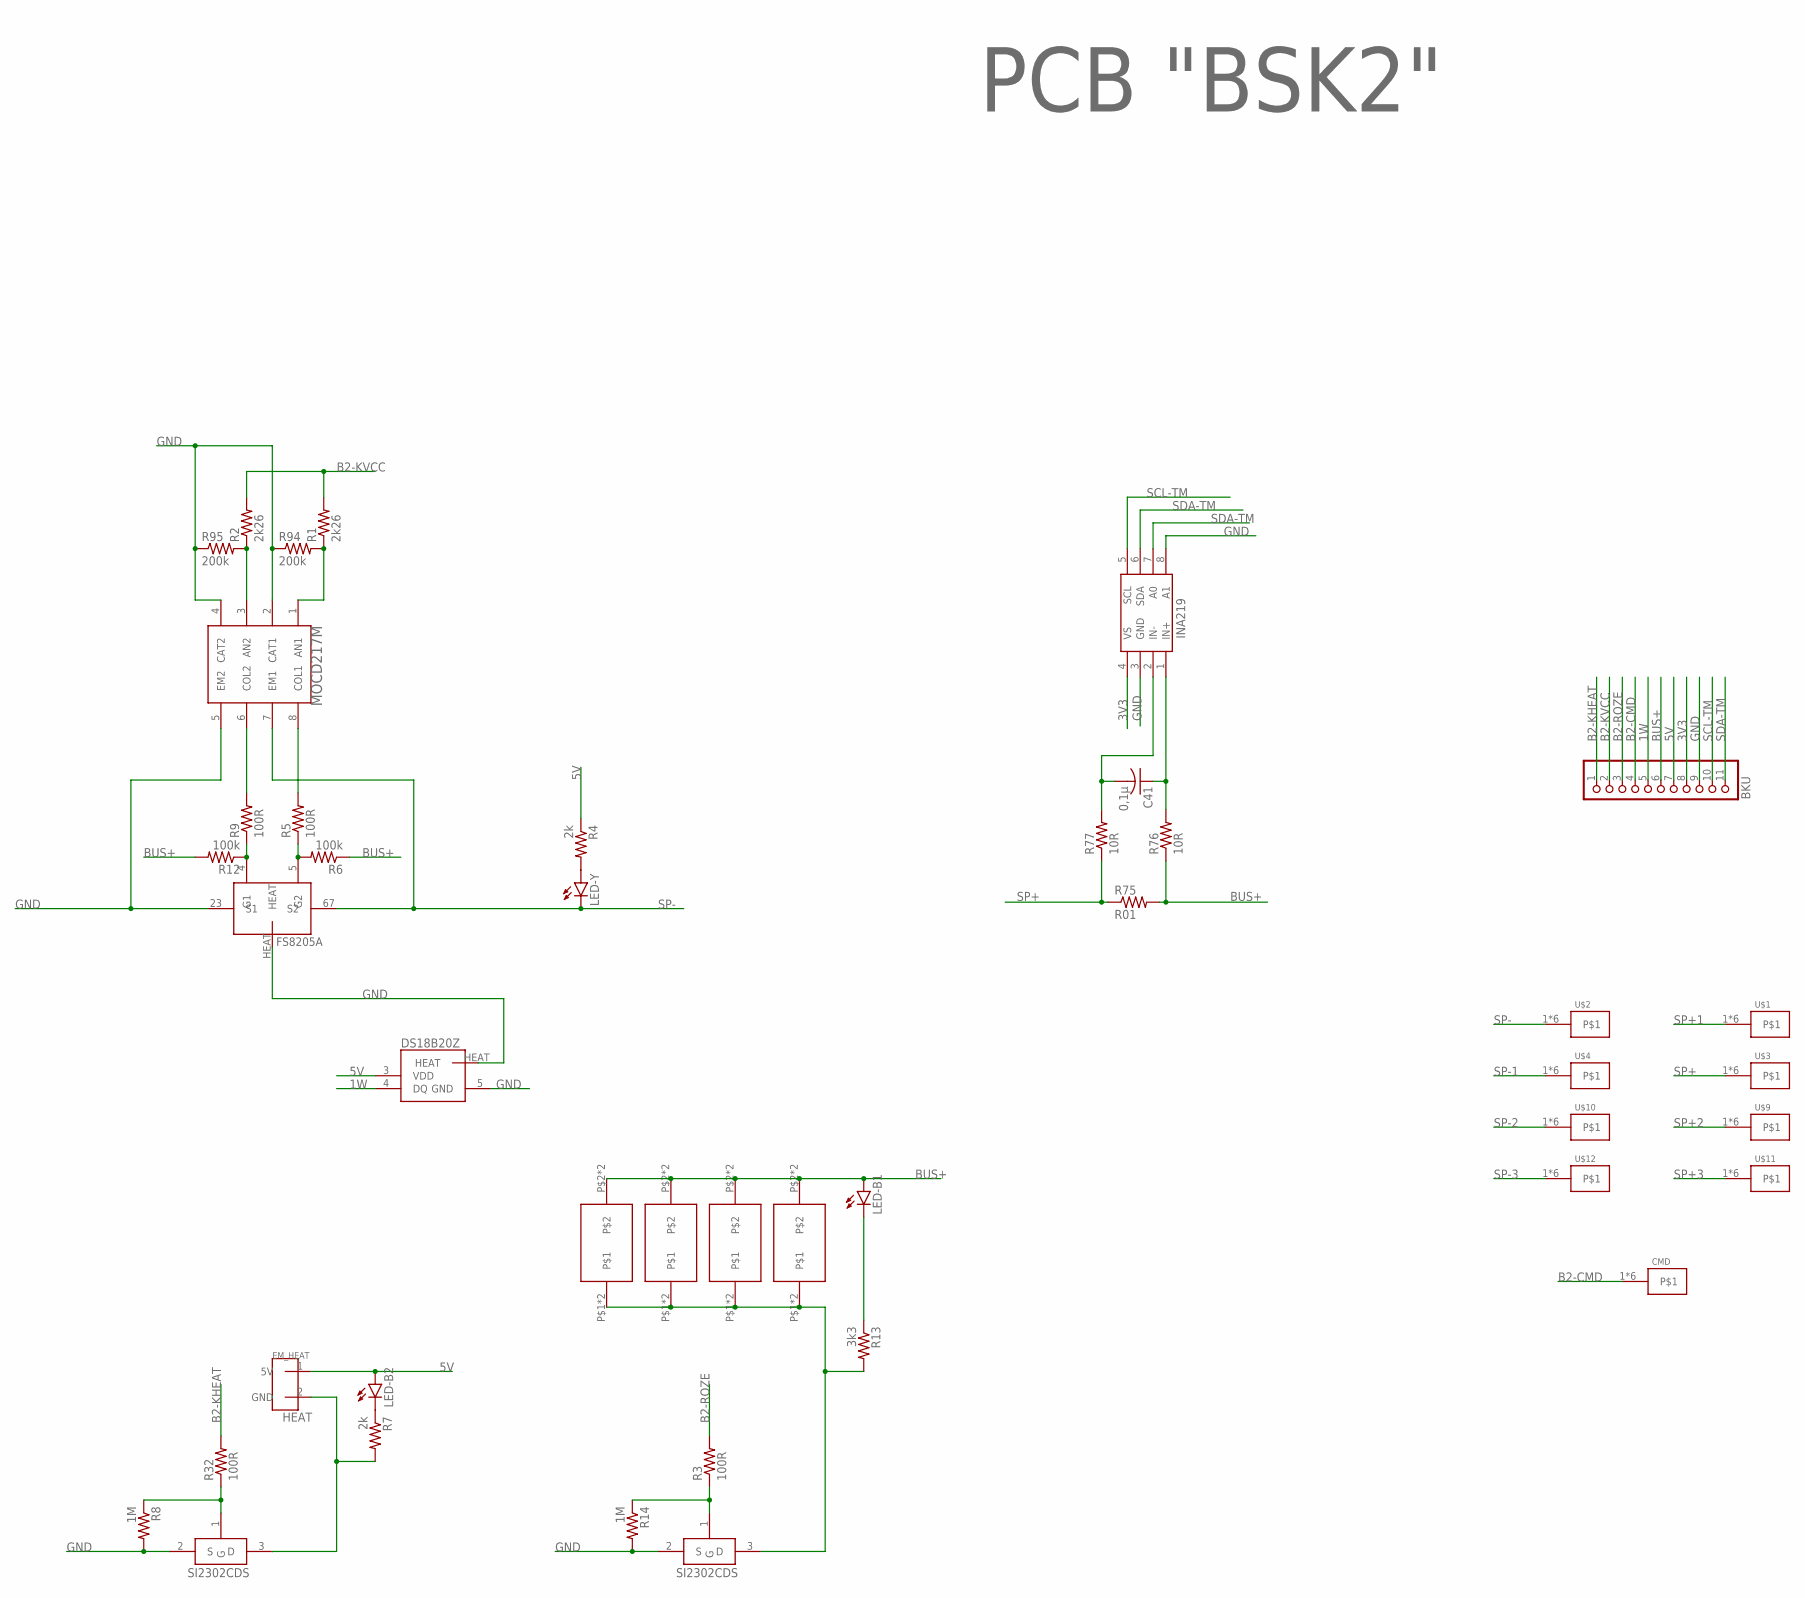
[picture p41: schematic BSK2.sch]

Parts:
BKU: PINHD-1X11; 1X11
C41: 0,1µ; C0603
CMD: KCONNECTQUAD; KCONNECT_QUAD
DS18B20Z1: DS18B20Z; SOIC8+HEAT_S
INA: INA219AID; SOT23-8
LED-B1, LED-B2: LEDCHIPLED_0603; CHIPLED_0603
LED-Y: LAP4-BOTTOM; P47F-BOTTOM
MOCD: MOCD; SOIC8
R1, R2: 2k26; R0603
R3, R5, R9, R32: 100R; R0603
R4, R7: 2k; R0603
R6, R12: 100k; R0603
R8, R14: 1M; R0603
R13: 3k3; R0603
R75: R01; R2512
R76, R77: 10R; R0603
R94, R95: 200k; R0603
U$1, U$2, U$3, U$4, U$9, U$10, U$11, U$12: KCONNECT
U$6, U$7, U$15, U$16: GRAFITGRAFIT4_2; GRAFIT4_2
U$8, U$13: SI2302CDS; SOT23-3
U$14: EM_HEAT
U$17: PCB "BSK2"; ITS-LOGO
U$26: FS8205A+

Connections:
1: R7.2, U$8.3 (D), U$14.2 (GND)
1W: BKU.5, DS18B20Z1.4 (DQ)
2: R13.2, U$6.P$1, U$6.P$4, U$7.P$1, U$7.P$4, U$13.3 (D), U$15.P$1, U$15.P$4, U$16.P$1, U$16.P$4
3V3: BKU.8, INA.4 (VS)
5V: BKU.7, DS18B20Z1.3 (VDD), LED-B2.A, R4.1, U$14.1 (5V)
B2-CMD: BKU.4, CMD.1, CMD.2, CMD.3, CMD.4, CMD.P$1, CMD.P$2
B2-KHEAT: BKU.1, R32.2
B2-KVCC: BKU.2, R1.2, R2.2
B2-ROZE: BKU.3, R3.2
BUS+: BKU.6, LED-B1.A, R6.1, R12.2, R75.2, R76.1, U$6.P$2, U$6.P$5, U$7.P$2, U$7.P$5, U$15.P$2, U$15.P$5, U$16.P$2, U$16.P$5
GND: BKU.9, DS18B20Z1.5 (GND), DS18B20Z1.HEAT, INA.3 (GND), INA.8 (A1), MOCD.2 (CAT1), MOCD.4 (CAT2), MOCD.5 (EM2), R8.2, R14.2, R94.1, R95.1, U$8.2 (S), U$13.2 (S), U$26.23 (S1), U$26.HEAT
unnamed: MOCD.1 (AN1), R1.1, R94.2
unnamed: MOCD.3 (AN2), R2.1, R95.2
unnamed: R8.1, R32.1, U$8.1 (G)
unnamed: R3.1, R14.1, U$13.1 (G)
unnamed: R5.1, R6.2, U$26.5 (G2)
unnamed: R9.1, R12.1, U$26.4 (G1)
unnamed: LED-Y.A, R4.2
unnamed: LED-B1.C, R13.1
unnamed: LED-B2.C, R7.1
unnamed: C41.1, INA.1 (IN+), R76.2
unnamed: C41.2, INA.2 (IN-), R77.2
OC1: MOCD.6 (COL2), R9.2
OD1: MOCD.8 (COL1), R5.2
SCL-TM: BKU.10, INA.5 (SCL)
SDA-TM: BKU.11, INA.6 (SDA), INA.7 (A0)
SP+: R75.1, R77.1, U$3.1, U$3.2, U$3.3, U$3.4, U$3.P$1, U$3.P$2
SP+1: U$1.1, U$1.2, U$1.3, U$1.4, U$1.P$1, U$1.P$2
SP+2: U$9.1, U$9.2, U$9.3, U$9.4, U$9.P$1, U$9.P$2
SP+3: U$11.1, U$11.2, U$11.3, U$11.4, U$11.P$1, U$11.P$2
SP-: LED-Y.C, MOCD.7 (EM1), U$2.1, U$2.2, U$2.3, U$2.4, U$2.P$1, U$2.P$2, U$26.67 (S2)
SP-1: U$4.1, U$4.2, U$4.3, U$4.4, U$4.P$1, U$4.P$2
SP-2: U$10.1, U$10.2, U$10.3, U$10.4, U$10.P$1, U$10.P$2
SP-3: U$12.1, U$12.2, U$12.3, U$12.4, U$12.P$1, U$12.P$2

Notes on the sheet:
HEAT

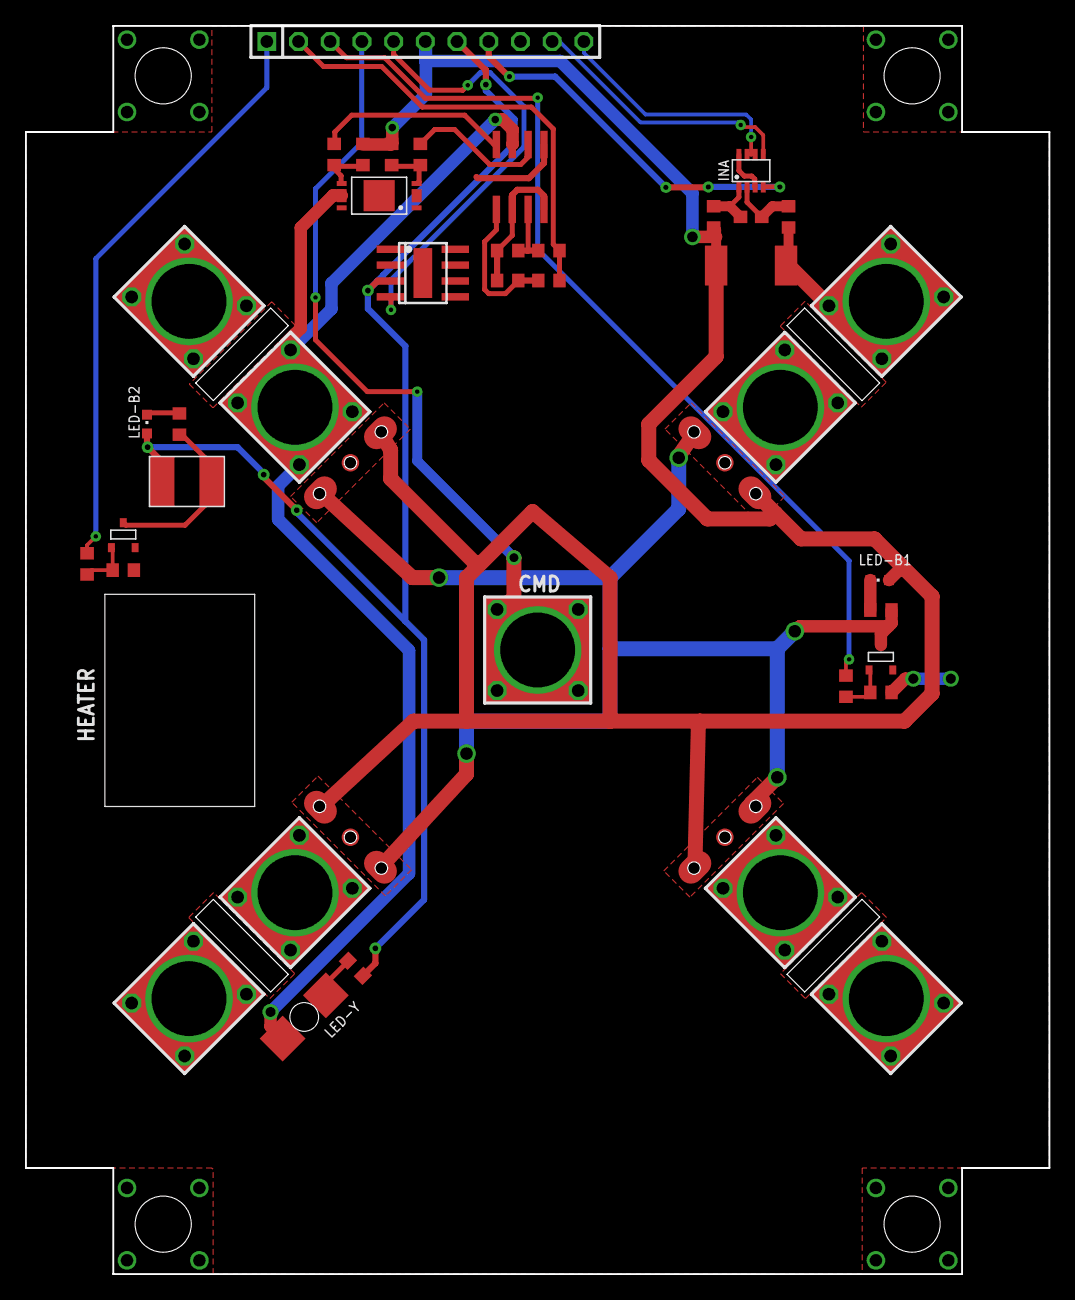
[picture p42: board BSK2.brd from above]

Board: 2 copper layers, 82.0 x 100.0 mm, 44 parts (1 on the bottom side), 34 nets.
