cansat-tsniimash/can-cube-sat-2022/schematics/board/k1fm-pico-balloon-v1.3.brd

## EAGLE design schematics/board/k1fm-pico-balloon-v1.3.brd (2021-04-12)

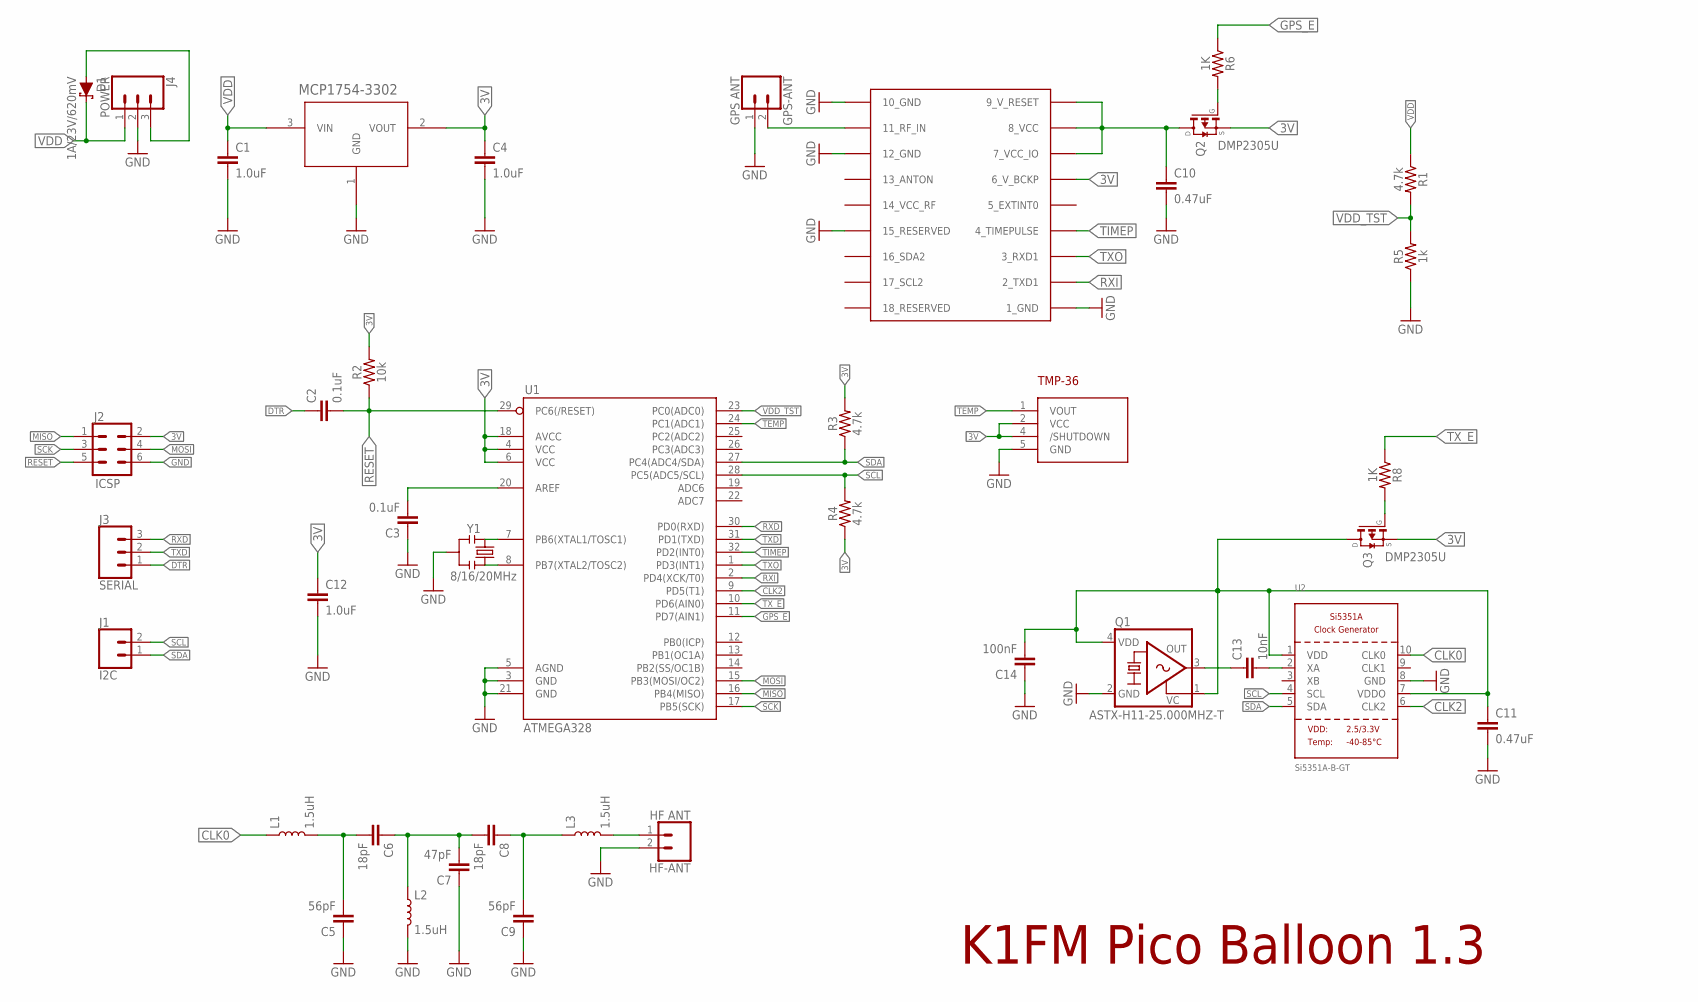
[picture p43: schematic k1fm-pico-balloon-v1.3.sch]

Parts:
C1, C4, C12: 1.0uF; 0603
C2, C3: 0.1uF; 0603
C5, C9: 56pF; 0603
C6, C8: 18pF; 0603
C7: 47pF; 0603
C10, C11: 0.47uF; 0603
C13: 10nF; 0603
C14: 100nF; 0603
D1: 1A/23V/620mV; SOD-323
GPS1: UBLOX_MAX
GPS-ANT: GPS ANT; 1X02
HF-ANT: HF ANT; 1X02
J1: I2C; 1X02
J2: ICSP; 2X3
J3: SERIAL; 1X03
J4: POWER; 1X03
L1, L2, L3: 1.5uH; 0603
Q1: ASTX-H11-25.000MHZ-T; 3.2X2.5_KXO-84
Q2, Q3: DMP2305U; SOT23
R1, R3, R4: 4.7k; 0603
R2: 10k; 0603
R5: 1k; 0603
R6, R8: 1K; 0603
U1: ATMEGA328; TQFP32-08
U2: Si5351A-B-GT; MSOP10
U3: MCP1754X-XXXXX/C; SOT-23A_MC
U4: TMP36; SOT-23
Y1: 8/16/20MHz; RESONATOR-SMD-1:1

Connections:
3V: C4.1, C12.1, GPS1.6_V_BCKP, J2.2, Q2.2 (S), Q3.2 (S), R2.2, R3.2, R4.1, U1.4 (VCC), U1.6 (VCC), U1.18 (AVCC), U3.2 (VOUT), U4.2 (VCC), U4.4 (/SHUTDOWN)
ANT: HF-ANT.1, L3.2
AREF: C3.2, U1.20 (AREF)
CLK0: L1.1, U2.10 (CLK0)
CLK2: U1.9 (PD5(T1)), U2.6 (CLK2)
DTR: C2.1, J3.1
GND: C1.2, C3.1, C4.2, C5.1, C7.1, C9.1, C10.2, C11.2, C12.2, C14.1, GPS1.1_GND, GPS1.10_GND, GPS1.12_GND, GPS1.15_RESERVED, GPS-ANT.1, HF-ANT.2, J2.6, J4.2, L2.2, Q1.2 (GND), R5.1, U1.3 (GND), U1.5 (AGND), U1.21 (GND), U2.8 (GND), U3.1 (GND), U4.5 (GND), Y1.2
GPS_E: R6.1, U1.11 (PD7(AIN1))
MISO: J2.1, U1.16 (PB4(MISO))
MOSI: J2.4, U1.15 (PB3(MOSI/OC2))
unnamed: C13.1, Q1.3 (OUT)
unnamed: C13.2, U2.2 (XA)
unnamed: D1.A, J4.3
unnamed: Q2.1 (G), R6.2
unnamed: GPS1.11_RF_IN, GPS-ANT.2
unnamed: Q3.1 (G), R8.2
unnamed: C10.1, GPS1.7_VCC_IO, GPS1.8_VCC, GPS1.9_V_RESET, Q2.3 (D)
unnamed: C6.1, C7.2, C8.2, L2.1
unnamed: C5.2, C6.2, L1.2
unnamed: C8.1, C9.2, L3.1
unnamed: C11.1, C14.2, Q1.1 (VC), Q1.4 (VDD), Q3.3 (D), U2.1 (VDD), U2.7 (VDDO)
unnamed: U1.8 (PB7(XTAL2/TOSC2)), Y1.3
unnamed: U1.7 (PB6(XTAL1/TOSC1)), Y1.1
RESET: C2.2, J2.5, R2.1, U1.29 (PC6(/RESET))
RXD: J3.3, U1.30 (PD0(RXD))
RXI: GPS1.2_TXD1, U1.2 (PD4(XCK/T0))
SCK: J2.3, U1.17 (PB5(SCK))
SCL: J1.2, R4.2, U1.28 (PC5(ADC5/SCL)), U2.4 (SCL)
SDA: J1.1, R3.1, U1.27 (PC4(ADC4/SDA)), U2.5 (SDA)
TEMP: U1.24 (PC1(ADC1)), U4.1 (VOUT)
TIMEP: GPS1.4_TIMEPULSE, U1.32 (PD2(INT0))
TXD: J3.2, U1.31 (PD1(TXD))
TXO: GPS1.3_RXD1, U1.1 (PD3(INT1))
TX_E: R8.1, U1.10 (PD6(AIN0))
VDD: C1.1, D1.C, J4.1, R1.1, U3.3 (VIN)
VDD_TST: R1.2, R5.2, U1.23 (PC0(ADC0))

Notes on the sheet:
K1FM Pico Balloon 1.3

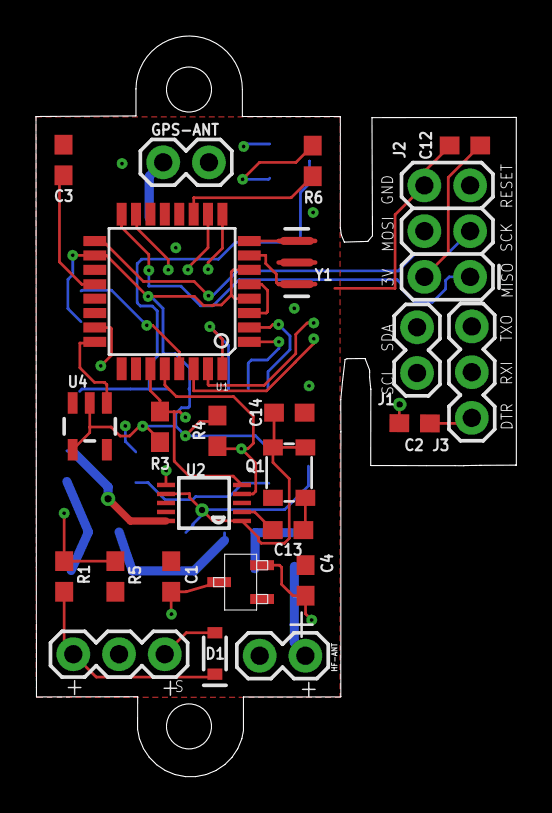
[picture p44: board k1fm-pico-balloon-v1.3.brd from above]

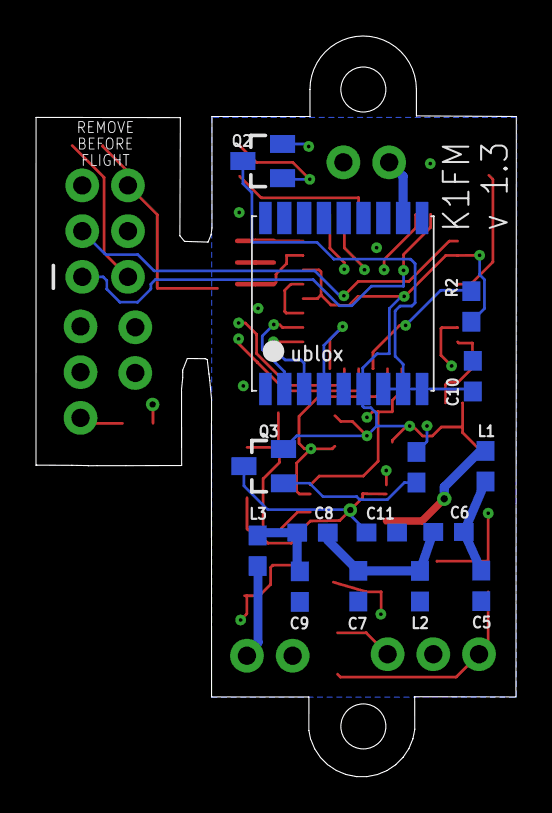
[picture p45: board k1fm-pico-balloon-v1.3.brd from below]

Board: 4 copper layers, 26.7 x 41.1 mm, 40 parts (15 on the bottom side), 36 nets.
