cansat-tsniimash/can-cube-sat-2022/schematics/board/BSK1.brd

## EAGLE design schematics/board/BSK1.brd (2021-04-12)

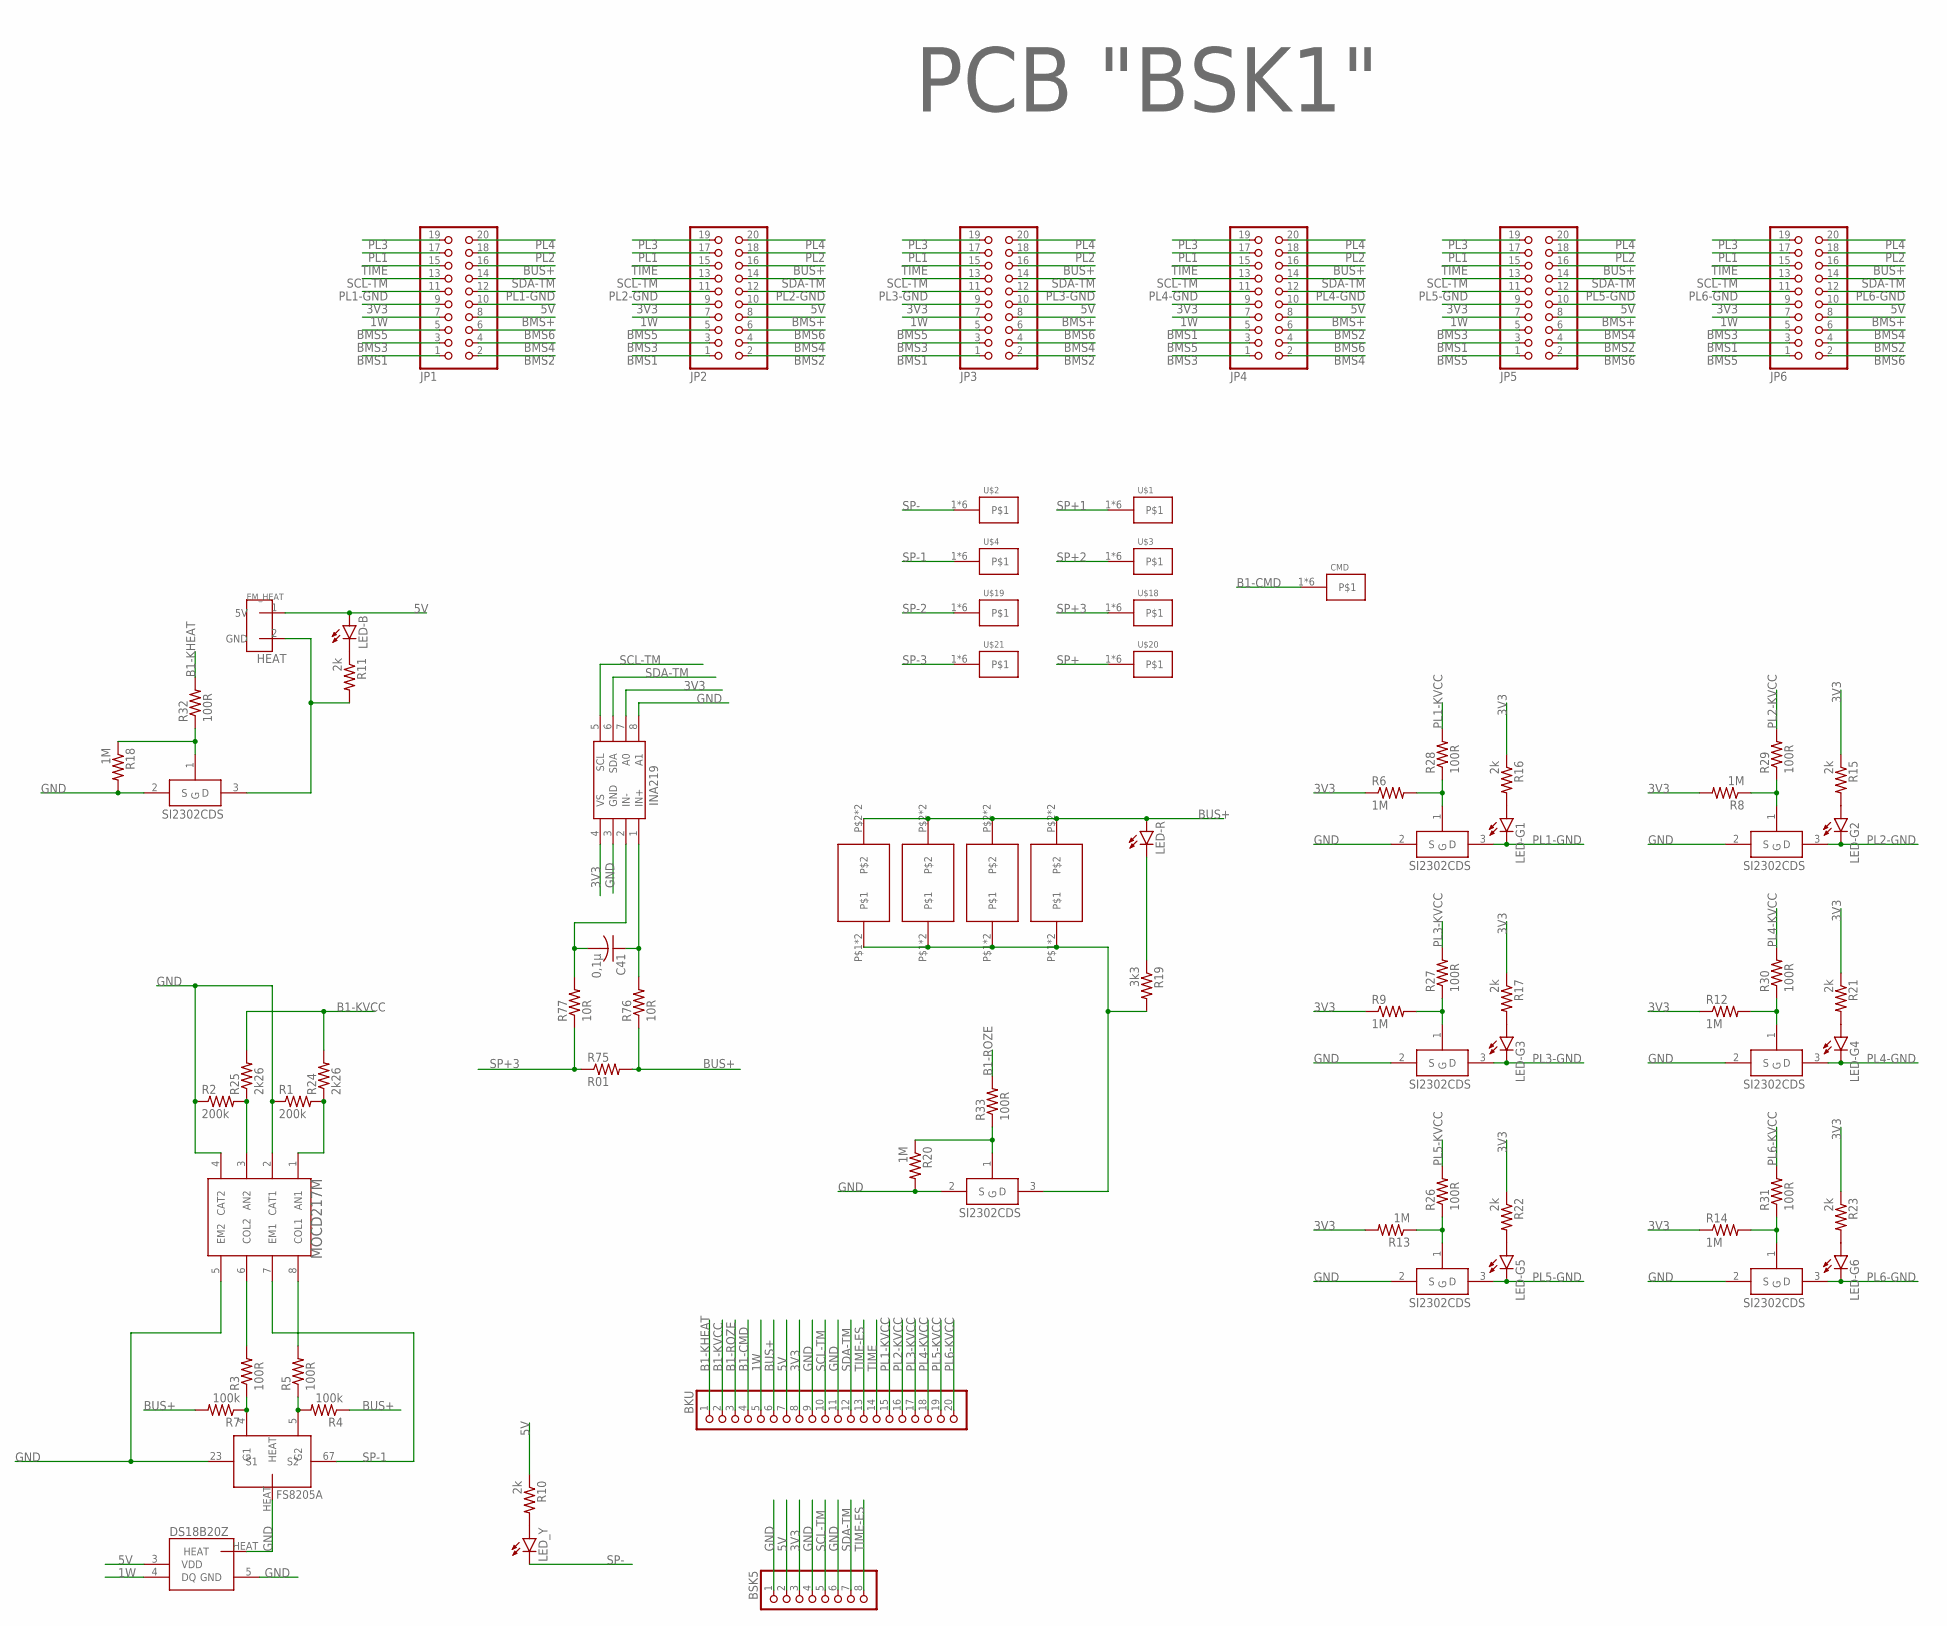
[picture p46: schematic BSK1.sch]

Parts:
BKU: PINHD-1X20; 1X20
BSK5: PINHD-1X8; 1X08
C41: 0,1µ; C0603
CMD: KCONNECTQUAD; KCONNECT_QUAD
DS18B20Z: DS18B20Z; SOIC8+HEAT_S
FS8205: FS8205A+
INA: INA219AID; SOT23-8
JP1, JP2, JP3, JP4, JP5, JP6: PINHD-2X10; 2X10
LED-B: LEDCHIPLED_0603; CHIPLED_0603
LED-G1, LED-G2, LED-G3, LED-G4, LED-G5, LED-G6: LEDCHIPLED_0603; CHIPLED_0603
LED-R: LEDCHIPLED_0603; CHIPLED_0603
LED_Y: LAP4-BOTTOM; P47F-BOTTOM
R1, R2: 200k; R0603
R3, R5, R26, R27, R28, R29, R30, R31, R32, R33: 100R; R0603
R4, R7: 100k; R0603
R6, R8, R9, R12, R13, R14, R18, R20: 1M; R0603
R10, R11, R15, R16, R17, R21, R22, R23: 2k; R0603
R19: 3k3; R0603
R24, R25: 2k26; R0603
R75: R01; R2512
R76, R77: 10R; R0603
SI2302-1, SI2302-2, SI2302-3, SI2302-4, SI2302-5, SI2302-6, SI2302-7, SI2302-8: SI2302CDS; SOT23-3
U$1, U$2, U$3, U$4, U$18, U$19, U$20, U$21: KCONNECT
U$22: MOCD; SOIC8
U$24: EM_HEAT
U$26: PCB "BSK1"; ITS-LOGO
U$27, U$28, U$29, U$30: GRAFITGRAFIT4_2; GRAFIT4_2

Connections:
1W: BKU.5, DS18B20Z.4 (DQ), JP1.7, JP2.7, JP3.7, JP4.7, JP5.7, JP6.7
3: R11.2, SI2302-1.3 (D), U$24.2 (GND)
3V3: BKU.8, BSK5.3, INA.4 (VS), INA.7 (A0), JP1.9, JP2.9, JP3.9, JP4.9, JP5.9, JP6.9, R6.1, R8.2, R9.1, R12.1, R13.2, R14.1, R15.1, R16.1, R17.1, R21.1, R22.1, R23.1
4: R19.2, SI2302-2.3 (D), U$27.P$1, U$27.P$4, U$28.P$1, U$28.P$4, U$29.P$1, U$29.P$4, U$30.P$1, U$30.P$4
5V: BKU.7, BSK5.2, DS18B20Z.3 (VDD), JP1.10, JP2.10, JP3.10, JP4.10, JP5.10, JP6.10, LED-B.A, R10.1, U$24.1 (5V)
B1-CMD: BKU.4, CMD.1, CMD.2, CMD.3, CMD.4, CMD.P$1, CMD.P$2
B1-KHEAT: BKU.1, R32.2
B1-KVCC: BKU.2, R24.2, R25.2
B1-ROZE: BKU.3, R33.2
BMS1: JP1.1, JP2.1, JP3.1, JP4.5, JP5.3, JP6.3
BMS2: JP1.2, JP2.2, JP3.2, JP4.6, JP5.4, JP6.4
BMS3: JP1.3, JP2.3, JP3.3, JP4.1, JP5.5, JP6.5
BMS4: JP1.4, JP2.4, JP3.4, JP4.2, JP5.6, JP6.6
BMS5: JP1.5, JP2.5, JP3.5, JP4.3, JP5.1, JP6.1
BMS6: JP1.6, JP2.6, JP3.6, JP4.4, JP5.2, JP6.2
BMS+: JP1.8, JP2.8, JP3.8, JP4.8, JP5.8, JP6.8
BUS+: BKU.6, JP1.16, JP2.16, JP3.16, JP4.16, JP5.16, JP6.16, LED-R.A, R4.1, R7.2, R75.2, R76.1, U$27.P$2, U$27.P$5, U$28.P$2, U$28.P$5, U$29.P$2, U$29.P$5, U$30.P$2, U$30.P$5
GND: BKU.9, BKU.11, BSK5.1, BSK5.4, BSK5.6, DS18B20Z.5 (GND), DS18B20Z.HEAT, FS8205.23 (S1), FS8205.HEAT, INA.3 (GND), INA.8 (A1), R1.1, R2.1, R18.2, R20.2, SI2302-1.2 (S), SI2302-2.2 (S), SI2302-3.2 (S), SI2302-4.2 (S), SI2302-5.2 (S), SI2302-6.2 (S), SI2302-7.2 (S), SI2302-8.2 (S), U$22.2 (CAT1), U$22.4 (CAT2), U$22.5 (EM2)
unnamed: FS8205.5 (G2), R4.2, R5.1
unnamed: LED-B.C, R11.1
unnamed: LED-R.C, R19.1
unnamed: LED-G1.A, R16.2
unnamed: LED-G3.A, R17.2
unnamed: LED-G4.A, R21.2
unnamed: LED-G5.A, R22.2
unnamed: LED-G6.A, R23.2
unnamed: R1.2, R24.1, U$22.1 (AN1)
unnamed: R2.2, R25.1, U$22.3 (AN2)
unnamed: FS8205.4 (G1), R3.1, R7.1
unnamed: LED_Y.A, R10.2
unnamed: R13.1, R26.1, SI2302-4.1 (G)
unnamed: R9.2, R27.1, SI2302-6.1 (G)
unnamed: R6.2, R28.1, SI2302-8.1 (G)
unnamed: R14.2, R31.1, SI2302-3.1 (G)
unnamed: R8.1, R29.1, SI2302-7.1 (G)
unnamed: R12.2, R30.1, SI2302-5.1 (G)
unnamed: R18.1, R32.1, SI2302-1.1 (G)
unnamed: R20.1, R33.1, SI2302-2.1 (G)
unnamed: LED-G2.A, R15.2
unnamed: C41.1, INA.1 (IN+), R76.2
unnamed: C41.2, INA.2 (IN-), R77.2
OC2: R3.2, U$22.6 (COL2)
OD2: R5.2, U$22.8 (COL1)
PL1: JP1.17, JP2.17, JP3.17, JP4.17, JP5.17, JP6.17
PL1-GND: JP1.11, JP1.12, LED-G1.C, SI2302-8.3 (D)
PL1-KVCC: BKU.15, R28.2
PL2: JP1.18, JP2.18, JP3.18, JP4.18, JP5.18, JP6.18
PL2-GND: JP2.11, JP2.12, LED-G2.C, SI2302-7.3 (D)
PL2-KVCC: BKU.16, R29.2
PL3: JP1.19, JP2.19, JP3.19, JP4.19, JP5.19, JP6.19
PL3-GND: JP3.11, JP3.12, LED-G3.C, SI2302-6.3 (D)
PL3-KVCC: BKU.17, R27.2
PL4: JP1.20, JP2.20, JP3.20, JP4.20, JP5.20, JP6.20
PL4-GND: JP4.11, JP4.12, LED-G4.C, SI2302-5.3 (D)
PL4-KVCC: BKU.18, R30.2
PL5-GND: JP5.11, JP5.12, LED-G5.C, SI2302-4.3 (D)
PL5-KVCC: BKU.19, R26.2
PL6-GND: JP6.11, JP6.12, LED-G6.C, SI2302-3.3 (D)
PL6-KVCC: BKU.20, R31.2
SCL-TM: BKU.10, BSK5.5, INA.5 (SCL), JP1.13, JP2.13, JP3.13, JP4.13, JP5.13, JP6.13
SDA-TM: BKU.12, BSK5.7, INA.6 (SDA), JP1.14, JP2.14, JP3.14, JP4.14, JP5.14, JP6.14
SP+: U$20.1, U$20.2, U$20.3, U$20.4, U$20.P$1, U$20.P$2
SP+1: U$1.1, U$1.2, U$1.3, U$1.4, U$1.P$1, U$1.P$2
SP+2: U$3.1, U$3.2, U$3.3, U$3.4, U$3.P$1, U$3.P$2
SP+3: R75.1, R77.1, U$18.1, U$18.2, U$18.3, U$18.4, U$18.P$1, U$18.P$2
SP-: LED_Y.C, U$2.1, U$2.2, U$2.3, U$2.4, U$2.P$1, U$2.P$2
SP-1: FS8205.67 (S2), U$4.1, U$4.2, U$4.3, U$4.4, U$4.P$1, U$4.P$2, U$22.7 (EM1)
SP-2: U$19.1, U$19.2, U$19.3, U$19.4, U$19.P$1, U$19.P$2
SP-3: U$21.1, U$21.2, U$21.3, U$21.4, U$21.P$1, U$21.P$2
TIME: BKU.14, JP1.15, JP2.15, JP3.15, JP4.15, JP5.15, JP6.15
TIME-ES: BKU.13, BSK5.8

Notes on the sheet:
HEAT
