cansat-tsniimash/can-cube-sat-2022/schematics/board/BSK1.brd

## EAGLE design schematics/board/BSK1.brd (continued)

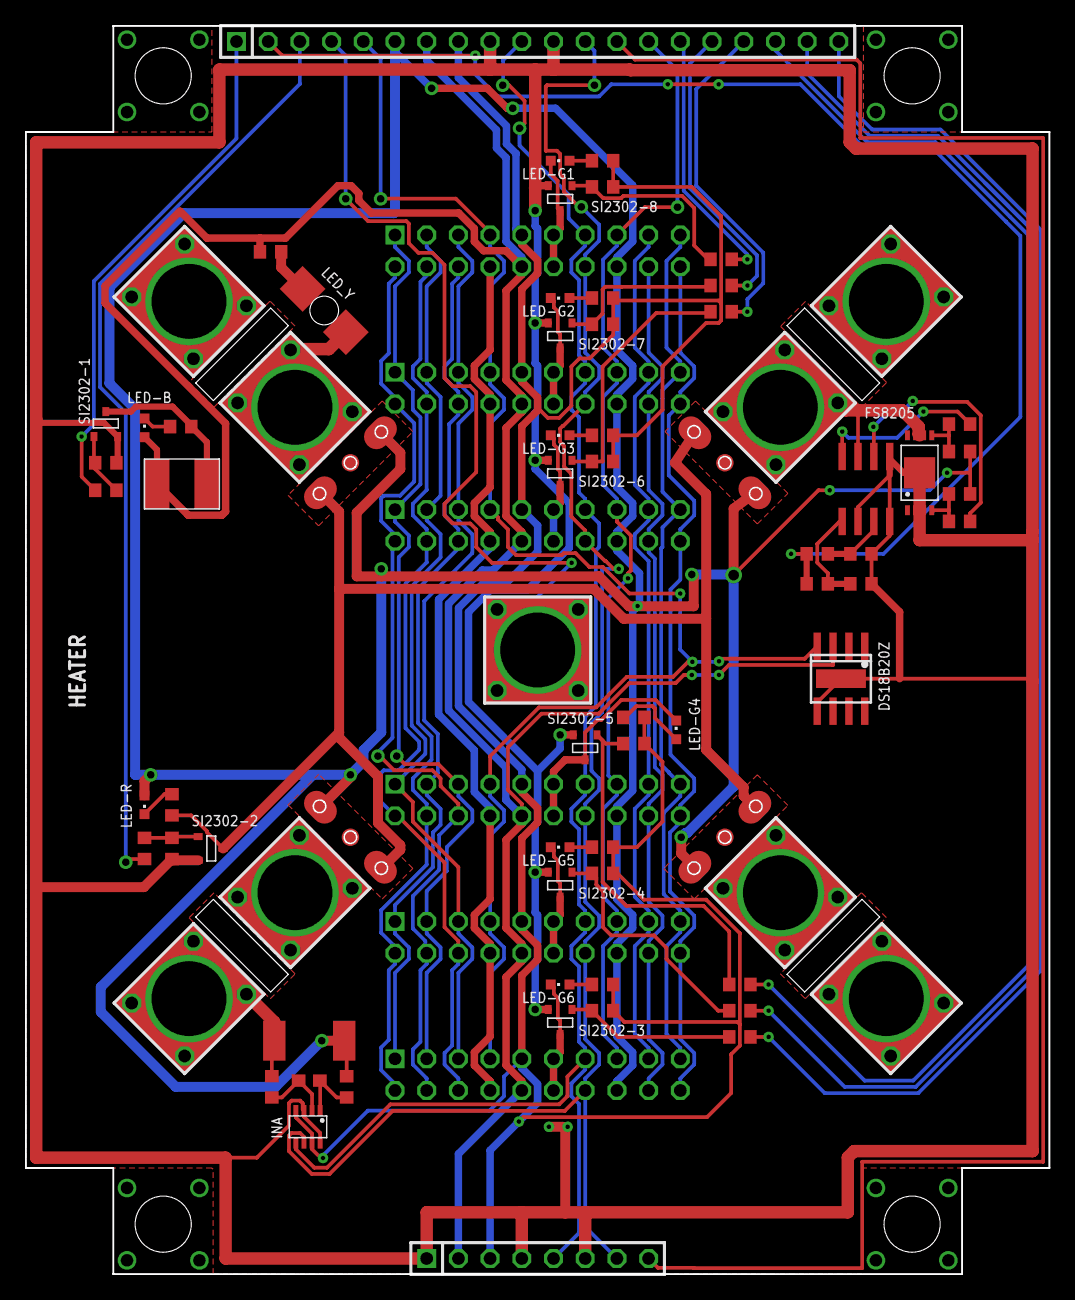
[picture p47: board BSK1.brd from above]

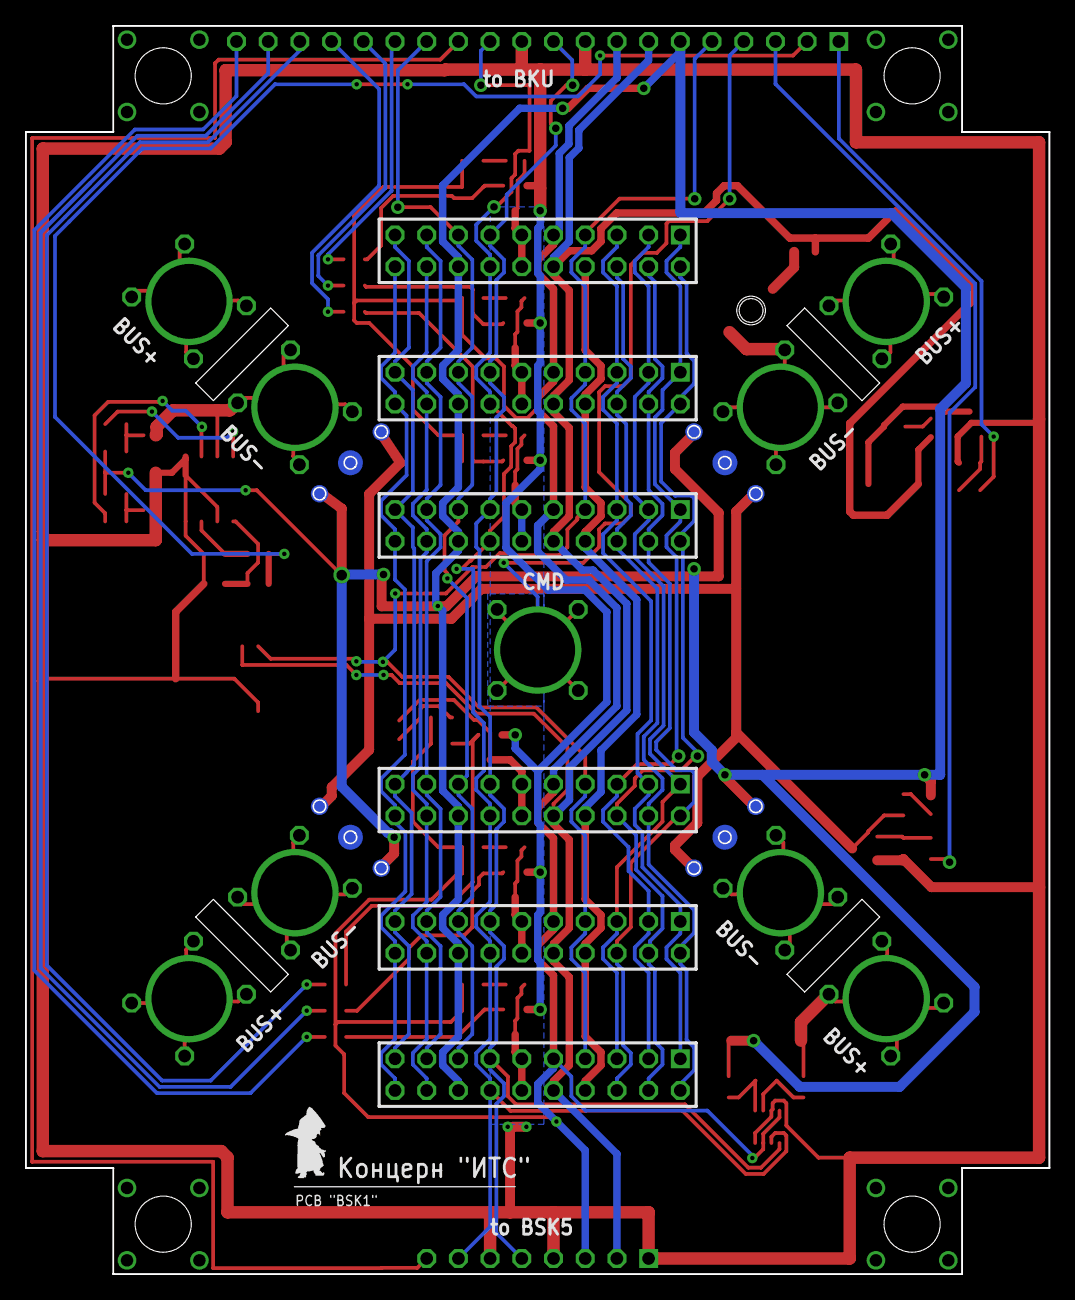
[picture p48: board BSK1.brd from below]

Board: 2 copper layers, 82.0 x 100.0 mm, 81 parts (7 on the bottom side), 71 nets.
