cansat-tsniimash/can-cube-sat-2022/schematics/board/PL.brd

## EAGLE design schematics/board/PL.brd (2021-04-12)

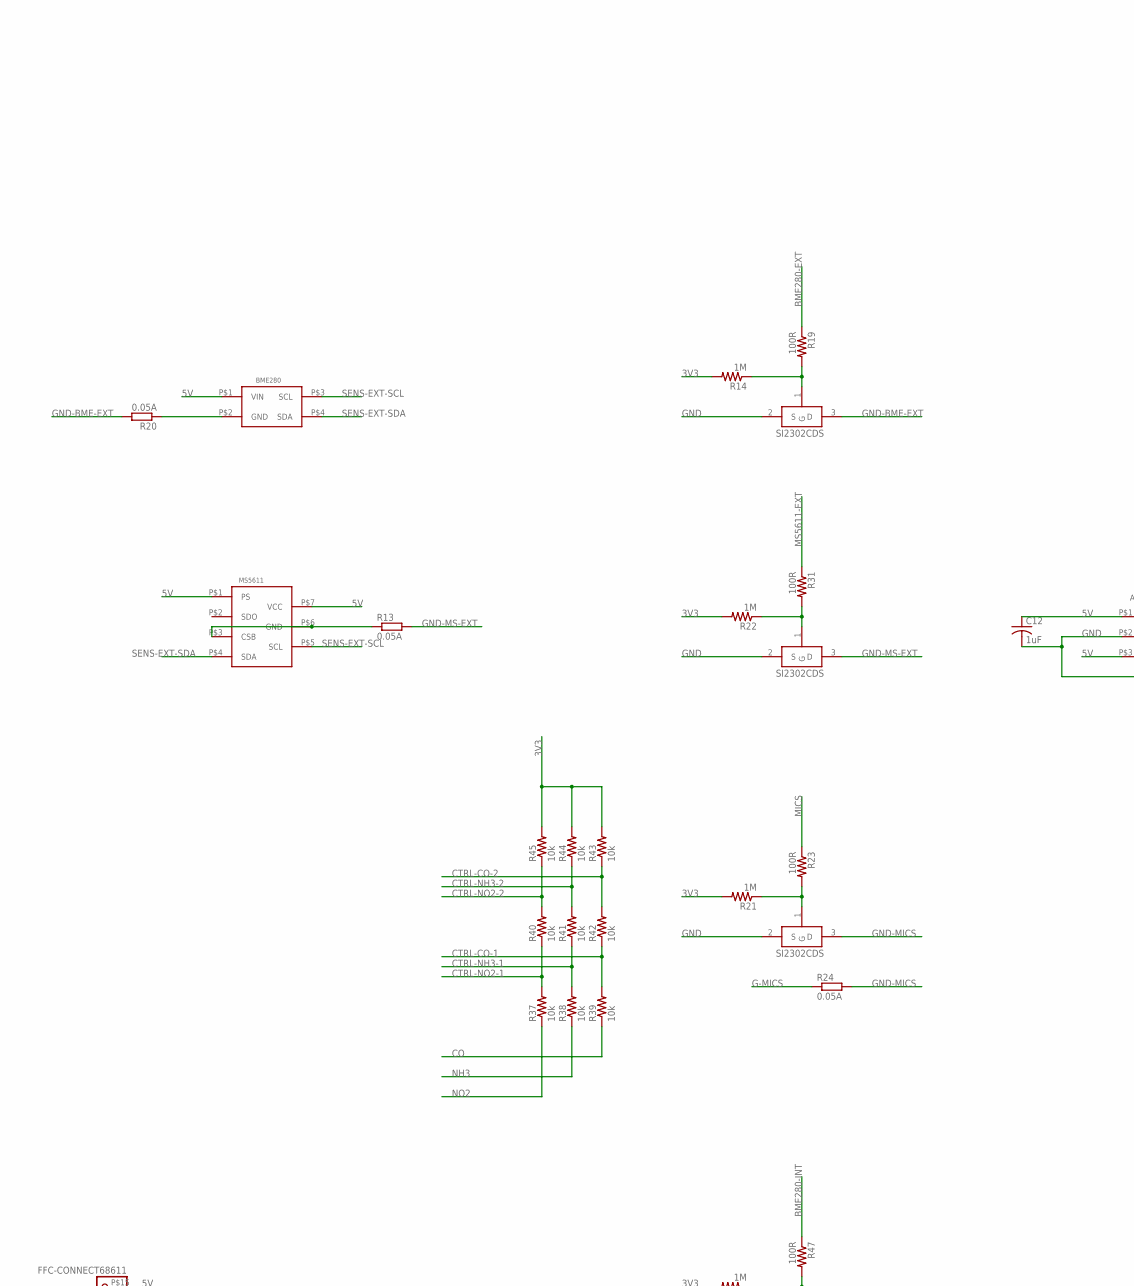
[picture p49: schematic PL.sch, part in row 1, column 1]

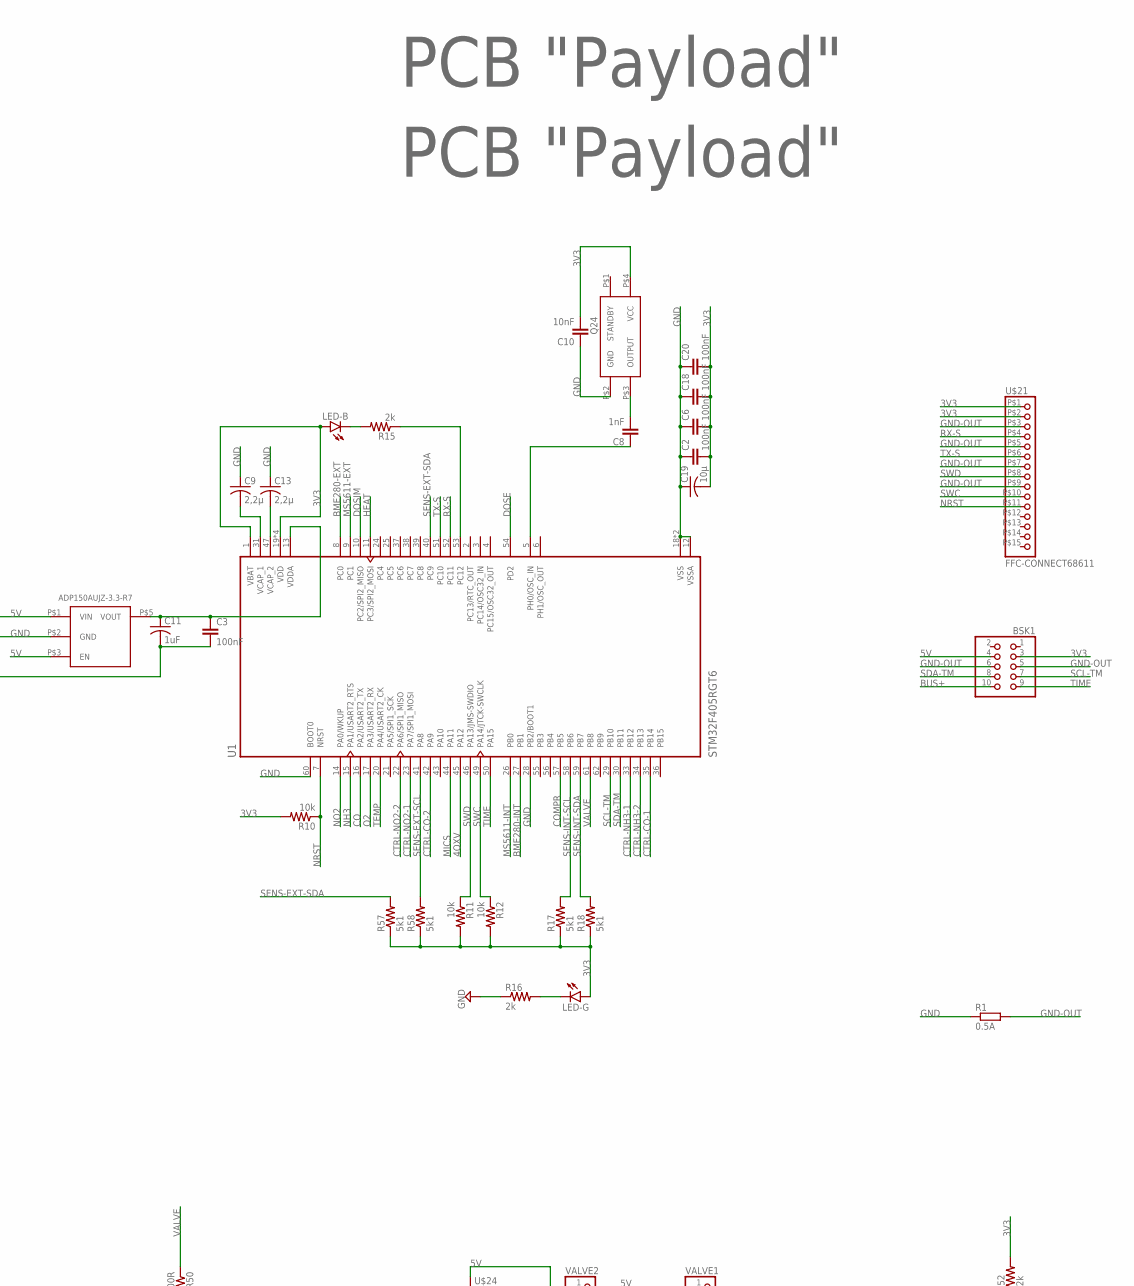
[picture p50: schematic PL.sch, part in row 1, column 2]

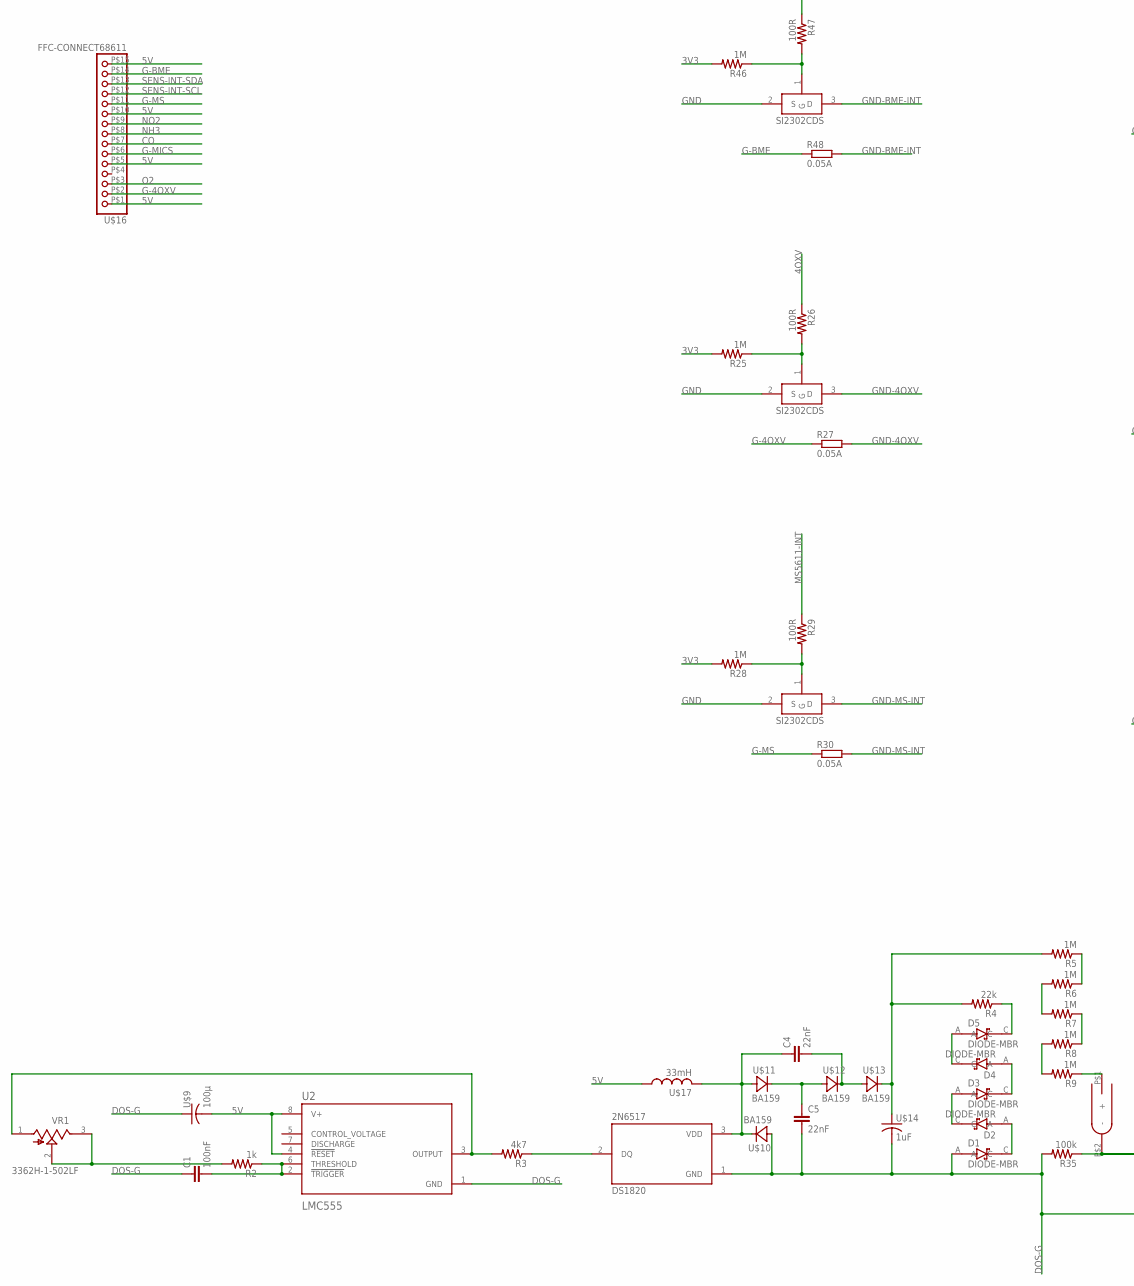
[picture p51: schematic PL.sch, part in row 2, column 1]

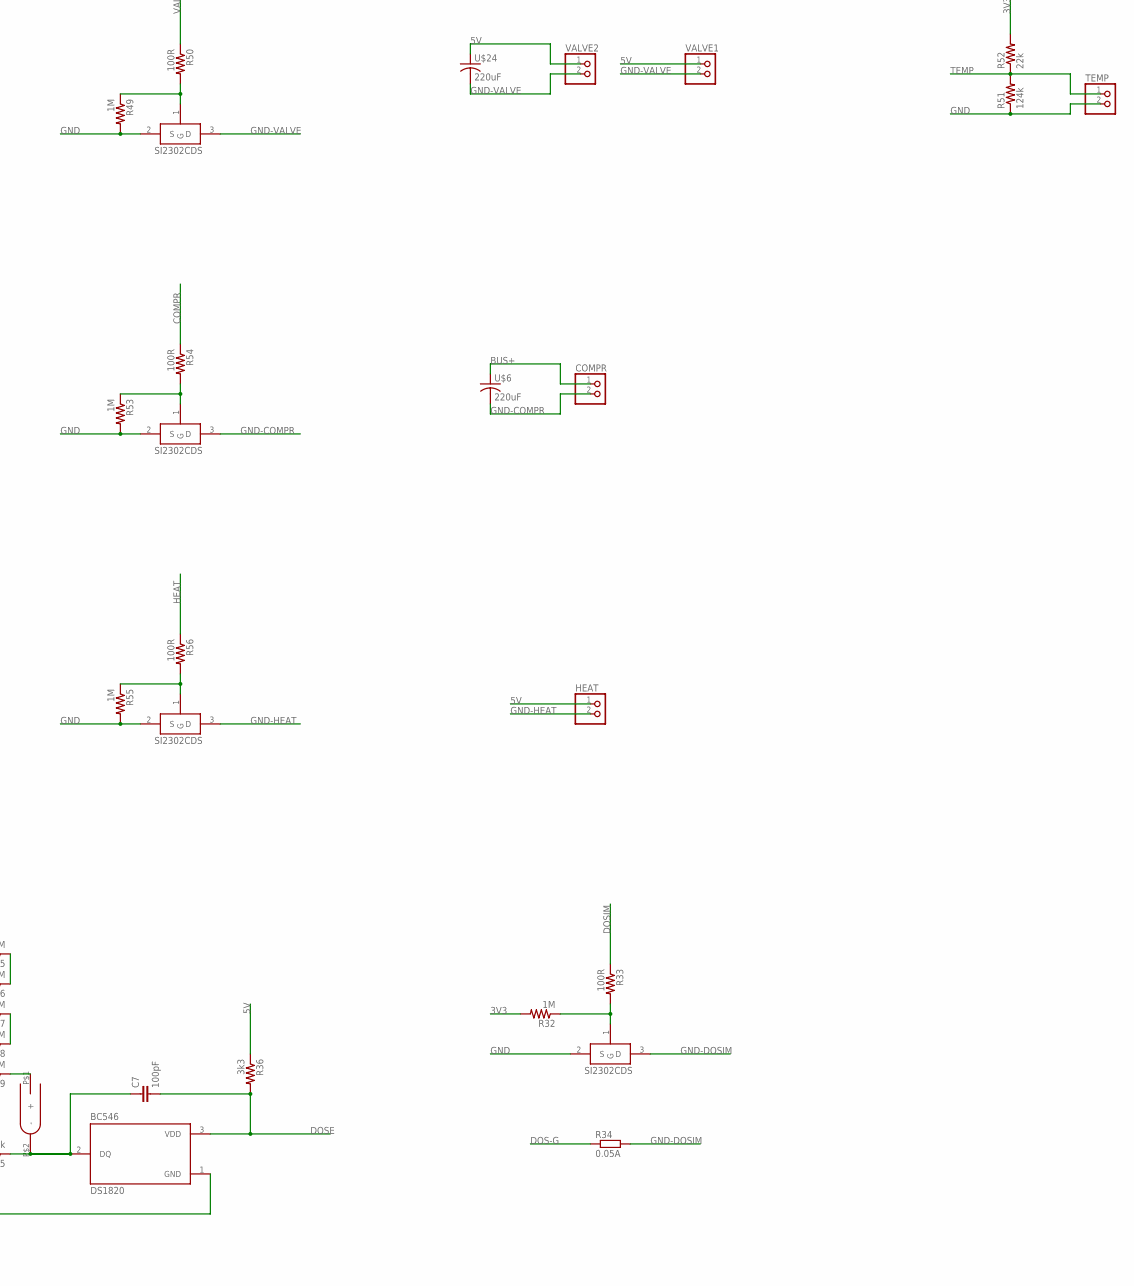
[picture p52: schematic PL.sch, part in row 2, column 2]

Parts:
2N6517: DS1820; TO92/TO226
BC546: DS1820; TO92/TO226
BME280: BME280BME280-PINS-ONLY; BME280-PINS-ONLY
BSK1: PINHD-2X5; 2X05
C1, C2, C3, C6, C18, C20: 100nF; C0603
C4, C5: 22nF; C1210
C7: 100pF; C0603
C8: 1nF; C0603
C9, C13: 2,2µ; C0603
C10: 10nF; C0603
C11, C12: 1uF; ECAP-SMD-D4
C19: 10µ; C1206
COMPR: PINHD-1X2; 1X02
D1, D2, D3, D4, D5: DIODE-MBR; SOD123
HEAT: PINHD-1X2; 1X02
LED-B: LEDCHIPLED_0603; CHIPLED_0603
LED-G: LEDCHIPLED_0603; CHIPLED_0603
MS5611: MS5611MS5611-PIN-ONLY; MS5611-PINS-ONLY
Q24: Q24
R1: 0.5A; R1210
R2: 1k; R0603
R3: 4k7; R0603
R4, R52: 22k; R0603
R5, R6, R7, R8, R9, R14, R21, R22, R25, R28, R32, R46, R49, R53, R55: 1M; R0603
R10, R11, R12, R37, R38, R39, R40, R41, R42, R43, R44, R45: 10k; R0603
R13, R20, R24, R27, R30, R34, R48: 0.05A; R1210
R15, R16: 2k; R0603
R17, R18, R57, R58: 5k1; R0603
R19, R23, R26, R29, R31, R33, R47, R50, R54, R56: 100R; R0603
R35: 100k; R0603
R36: 3k3; R0603
R51: 124k; R0603
SI2302-0, SI2302-1, SI2302-2, SI2302-3, SI2302-4, SI2302-5, SI2302-6, SI2302-7, SI2302-8, SI2302-9: SI2302CDS; SOT23-3
STAB: ADP150AUJZ-3.3-R7; SOT23-5
TEMP: PINHD-1X2; 1X02
U1: STM32F405RGT6; QFP50P1200X1200X160-64N
U2: LMC555; SOIC127P599X175-8N
U$1, U$26: PCB "Payload"; ITS-LOGO
U$6, U$24: 220uF; ECAP220-CMD
U$9: 100µ; ECAP100-CMD
U$10, U$11, U$12, U$13: BA159
U$14: 1uF; ECAP1MK
U$15: DOSIM
U$16, U$21: FFC-CONNECT68611; 68611
U$17: 33mH; RCH114NP
VALVE1, VALVE2: PINHD-1X2; 1X02
VR1: 3362H-1-502LF; TRIM_3362H-1-502LF

Connections:
3V3: BSK1.3, C2.2, C6.2, C10.2, C18.2, C19.2, C20.2, LED-B.A, LED-G.A, Q24.P$4 (VCC), R10.2, R11.2, R12.2, R14.2, R17.1, R18.1, R21.2, R22.2, R25.2, R28.2, R32.2, R43.2, R44.2, R45.2, R46.2, R52.2, R57.1, R58.1, U1.1 (VBAT), U1.19 (VDD), U1.32 (VDD), U1.48 (VDD), U1.64 (VDD), U$21.P$1 (1), U$21.P$2 (2)
4OXV: R26.1, U1.45 (PA12)
5V: BME280.P$1 (VIN), BSK1.4, C12.P+ (1), HEAT.1, MS5611.P$1 (PS), MS5611.P$7 (VCC), R36.1, STAB.P$1 (VIN), STAB.P$3 (EN), U2.4 (!RESET!), U2.8 (V+), U$9.P$2 (2), U$16.P$1 (1), U$16.P$5 (5), U$16.P$10 (10), U$16.P$15 (15), U$17.P$1 (1), U$24.P$1 (1), VALVE1.1, VALVE2.1
BME280-EXT: R19.1, U1.8 (PC0)
BME280-INT: R47.1, U1.27 (PB1)
BUS+: BSK1.10, COMPR.1, U$6.P$1 (1)
CO: R39.1, U1.16 (PA2/USART2_TX), U$16.P$7 (7)
COMPR: R54.1, U1.57 (PB5)
CTRL-CO-1: R39.2, R42.1, U1.35 (PB14)
CTRL-CO-2: R42.2, R43.1, U1.42 (PA9)
CTRL-NH3-1: R38.2, R41.1, U1.33 (PB12)
CTRL-NH3-2: R41.2, R44.1, U1.34 (PB13)
CTRL-NO2-1: R37.2, R40.1, U1.23 (PA7/SPI1_MOSI)
CTRL-NO2-2: R40.2, R45.1, U1.22 (PA6/SPI1_MISO)
DOS-G: 2N6517.1 (GND), BC546.1 (GND), C1.1, C5.2, D1.A, R34.1, R35.2, U2.1 (GND), U$9.P$1 (1), U$10.P$1 (A), U$14.P$2 (2)
DOSE: BC546.3 (VDD), C7.2, R36.2, U1.54 (PD2)
DOSIM: R33.1, U1.10 (PC2/SPI2_MISO)
G-4OXV: R27.1, U$16.P$2 (2)
G-BME: R48.1, U$16.P$14 (14)
G-MICS: R24.1, U$16.P$6 (6)
G-MS: R30.1, U$16.P$11 (11)
GND: C2.1, C3.2, C6.1, C9.1, C10.1, C11.P- (2), C12.P- (2), C13.1, C18.1, C19.1, C20.1, Q24.P$2 (GND), R1.1, R16.1, R49.2, R51.1, R53.2, R55.2, SI2302-0.2 (S), SI2302-1.2 (S), SI2302-2.2 (S), SI2302-3.2 (S), SI2302-4.2 (S), SI2302-5.2 (S), SI2302-6.2 (S), SI2302-7.2 (S), SI2302-8.2 (S), SI2302-9.2 (S), STAB.P$2 (GND), TEMP.2, U1.12 (VSSA), U1.18 (VSS), U1.28 (PB2/BOOT1), U1.60 (BOOT0), U1.63 (VSS)
GND-4OXV: R27.2, SI2302-8.3 (D)
GND-BME-EXT: R20.2, SI2302-2.3 (D)
GND-BME-INT: R48.2, SI2302-5.3 (D)
GND-COMPR: COMPR.2, SI2302-9.3 (D), U$6.P$2 (2)
GND-DOSIM: R34.2, SI2302-4.3 (D)
GND-HEAT: HEAT.2, SI2302-3.3 (D)
GND-MICS: R24.2, SI2302-7.3 (D)
GND-MS-EXT: R13.2, SI2302-1.3 (D)
GND-MS-INT: R30.2, SI2302-6.3 (D)
GND-OUT: BSK1.5, BSK1.6, R1.2, U$21.P$3 (3), U$21.P$5 (5), U$21.P$7 (7), U$21.P$9 (9)
GND-VALVE: SI2302-0.3 (D), U$24.P$2 (2), VALVE1.2, VALVE2.2
HEAT: R56.1, U1.11 (PC3/SPI2_MOSI)
MICS: R23.1, U1.44 (PA11)
MS5611-EXT: R31.1, U1.9 (PC1)
MS5611-INT: R29.1, U1.26 (PB0)
unnamed: MS5611.P$3 (CSB), MS5611.P$6 (GND), R13.1
unnamed: R14.1, R19.2, SI2302-2.1 (G)
unnamed: BME280.P$2 (GND), R20.1
unnamed: C8.2, Q24.P$3 (OUTPUT)
unnamed: C8.1, U1.5 (PH0/OSC_IN)
unnamed: R21.1, R23.2, SI2302-7.1 (G)
unnamed: R49.1, R50.2, SI2302-0.1 (G)
unnamed: R25.1, R26.2, SI2302-8.1 (G)
unnamed: C3.1, C11.P+ (1), STAB.P$5 (VOUT), U1.13 (VDDA)
unnamed: R46.1, R47.2, SI2302-5.1 (G)
unnamed: R22.1, R31.2, SI2302-1.1 (G)
unnamed: R28.1, R29.2, SI2302-6.1 (G)
unnamed: LED-G.C, R16.2
unnamed: R32.1, R33.2, SI2302-4.1 (G)
unnamed: C1.2, R2.1, U2.2 (!TRIGGER!), U2.6 (THRESHOLD)
unnamed: R2.2, VR1.2 (WIPER), VR1.3 (CW)
unnamed: R3.2, U2.3 (OUTPUT), VR1.1 (CCW)
unnamed: 2N6517.2 (DQ), R3.1
unnamed: 2N6517.3 (VDD), C4.1, U$10.P$2 (C), U$11.P$1 (A), U$17.P$2 (2)
unnamed: C5.1, U$11.P$2 (C), U$12.P$1 (A)
unnamed: C4.2, U$12.P$2 (C), U$13.P$1 (A)
unnamed: R4.2, R5.2, U$13.P$2 (C), U$14.P$1 (1)
unnamed: D1.C, D2.A
unnamed: D2.C, D3.A
unnamed: D3.C, D4.A
unnamed: D4.C, D5.A
unnamed: D5.C, R4.1
unnamed: R5.1, R6.1
unnamed: C13.2, U1.47 (VCAP_2)
unnamed: R6.2, R7.2
unnamed: R7.1, R8.1
unnamed: R8.2, R9.2
unnamed: R9.1, U$15.P$1 (+)
unnamed: BC546.2 (DQ), C7.1, R35.1, U$15.P$2 (-)
unnamed: C9.2, U1.31 (VCAP_1)
unnamed: LED-B.C, R15.2
unnamed: R15.1, U1.53 (PC12)
unnamed: R53.1, R54.2, SI2302-9.1 (G)
unnamed: R55.1, R56.2, SI2302-3.1 (G)
NH3: R38.1, U1.15 (PA1/USART2_RTS), U$16.P$8 (8)
NO2: R37.1, U1.14 (PA0/WKUP), U$16.P$9 (9)
NRST: R10.1, U1.7 (NRST), U$21.P$11 (11)
O2: U1.17 (PA3/USART2_RX), U$16.P$3 (3)
RX-S: U1.52 (PC11), U$21.P$4 (4)
SCL-TM: BSK1.7, U1.29 (PB10)
SDA-TM: BSK1.8, U1.30 (PB11)
SENS-EXT-SCL: BME280.P$3 (SCL), MS5611.P$5 (SCL), R58.2, U1.41 (PA8)
SENS-EXT-SDA: BME280.P$4 (SDA), MS5611.P$4 (SDA), R57.2, U1.40 (PC9)
SENS-INT-SCL: R17.2, U1.58 (PB6), U$16.P$12 (12)
SENS-INT-SDA: R18.2, U1.59 (PB7), U$16.P$13 (13)
SWC: R12.1, U1.49 (PA14/JTCK-SWCLK), U$21.P$10 (10)
SWD: R11.1, U1.46 (PA13/JMS-SWDIO), U$21.P$8 (8)
TEMP: R51.2, R52.1, TEMP.1, U1.20 (PA4/USART2_CK)
TIME: BSK1.9, U1.50 (PA15)
TX-S: U1.51 (PC10), U$21.P$6 (6)
VALVE: R50.1, U1.61 (PB8)

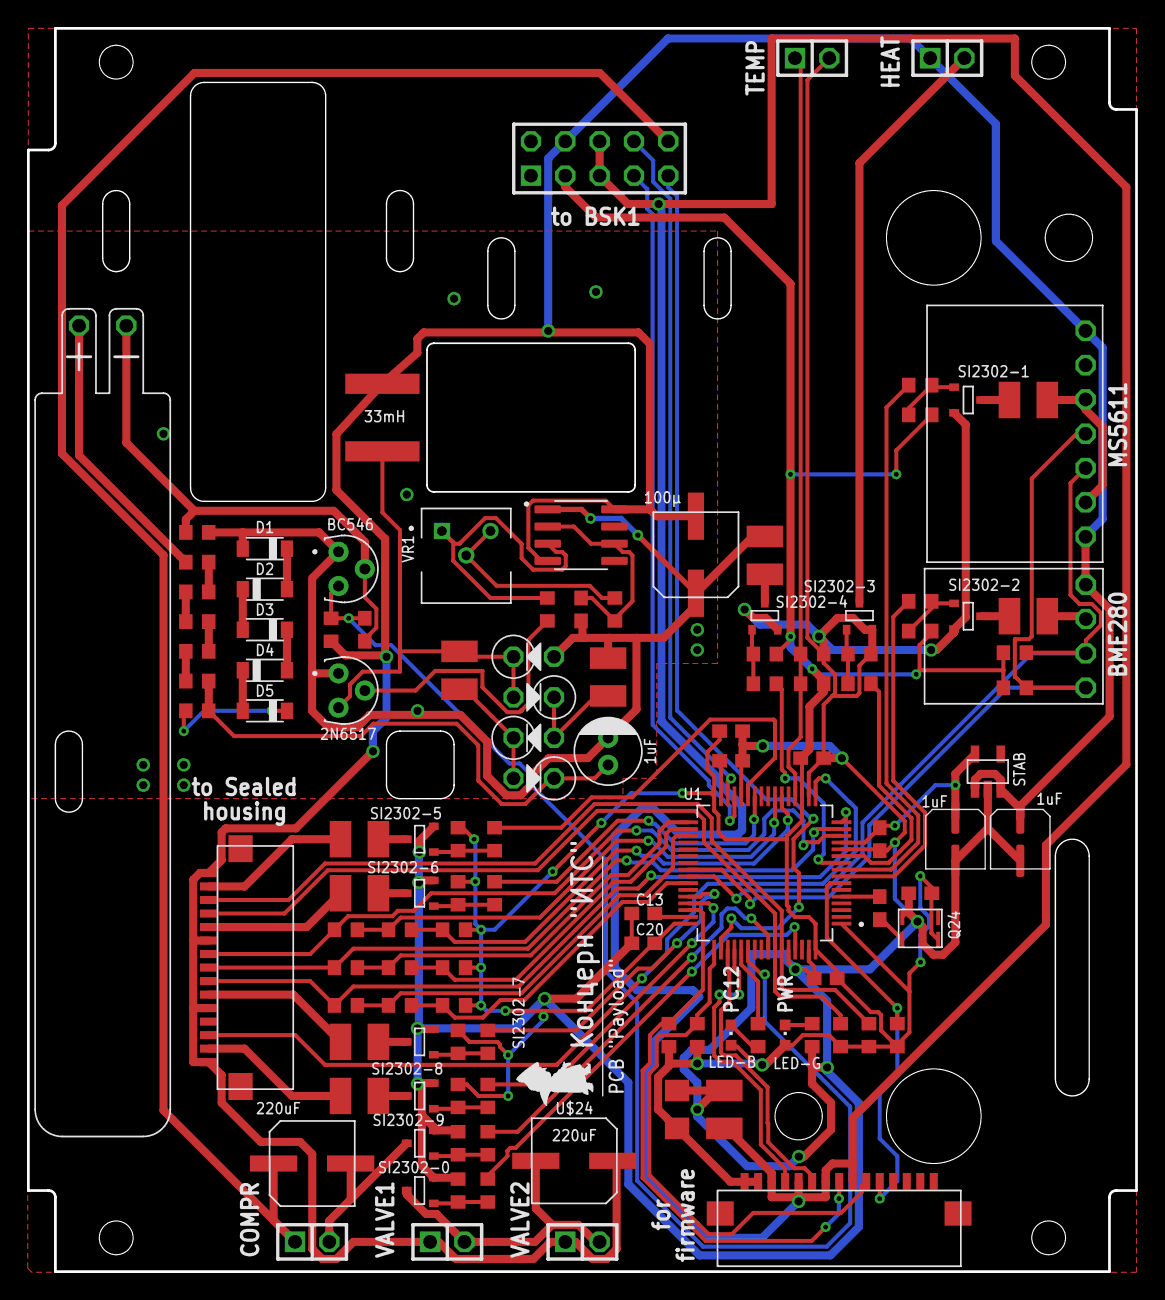
[picture p53: board PL.brd from above]

Board: 2 copper layers, 82.0 x 92.0 mm, 120 parts (1 on the bottom side), 93 nets.
