cansat-tsniimash/can-cube-sat-2022/schematics/board/DC-DC.brd

## EAGLE design schematics/board/DC-DC.brd (2020-12-17)

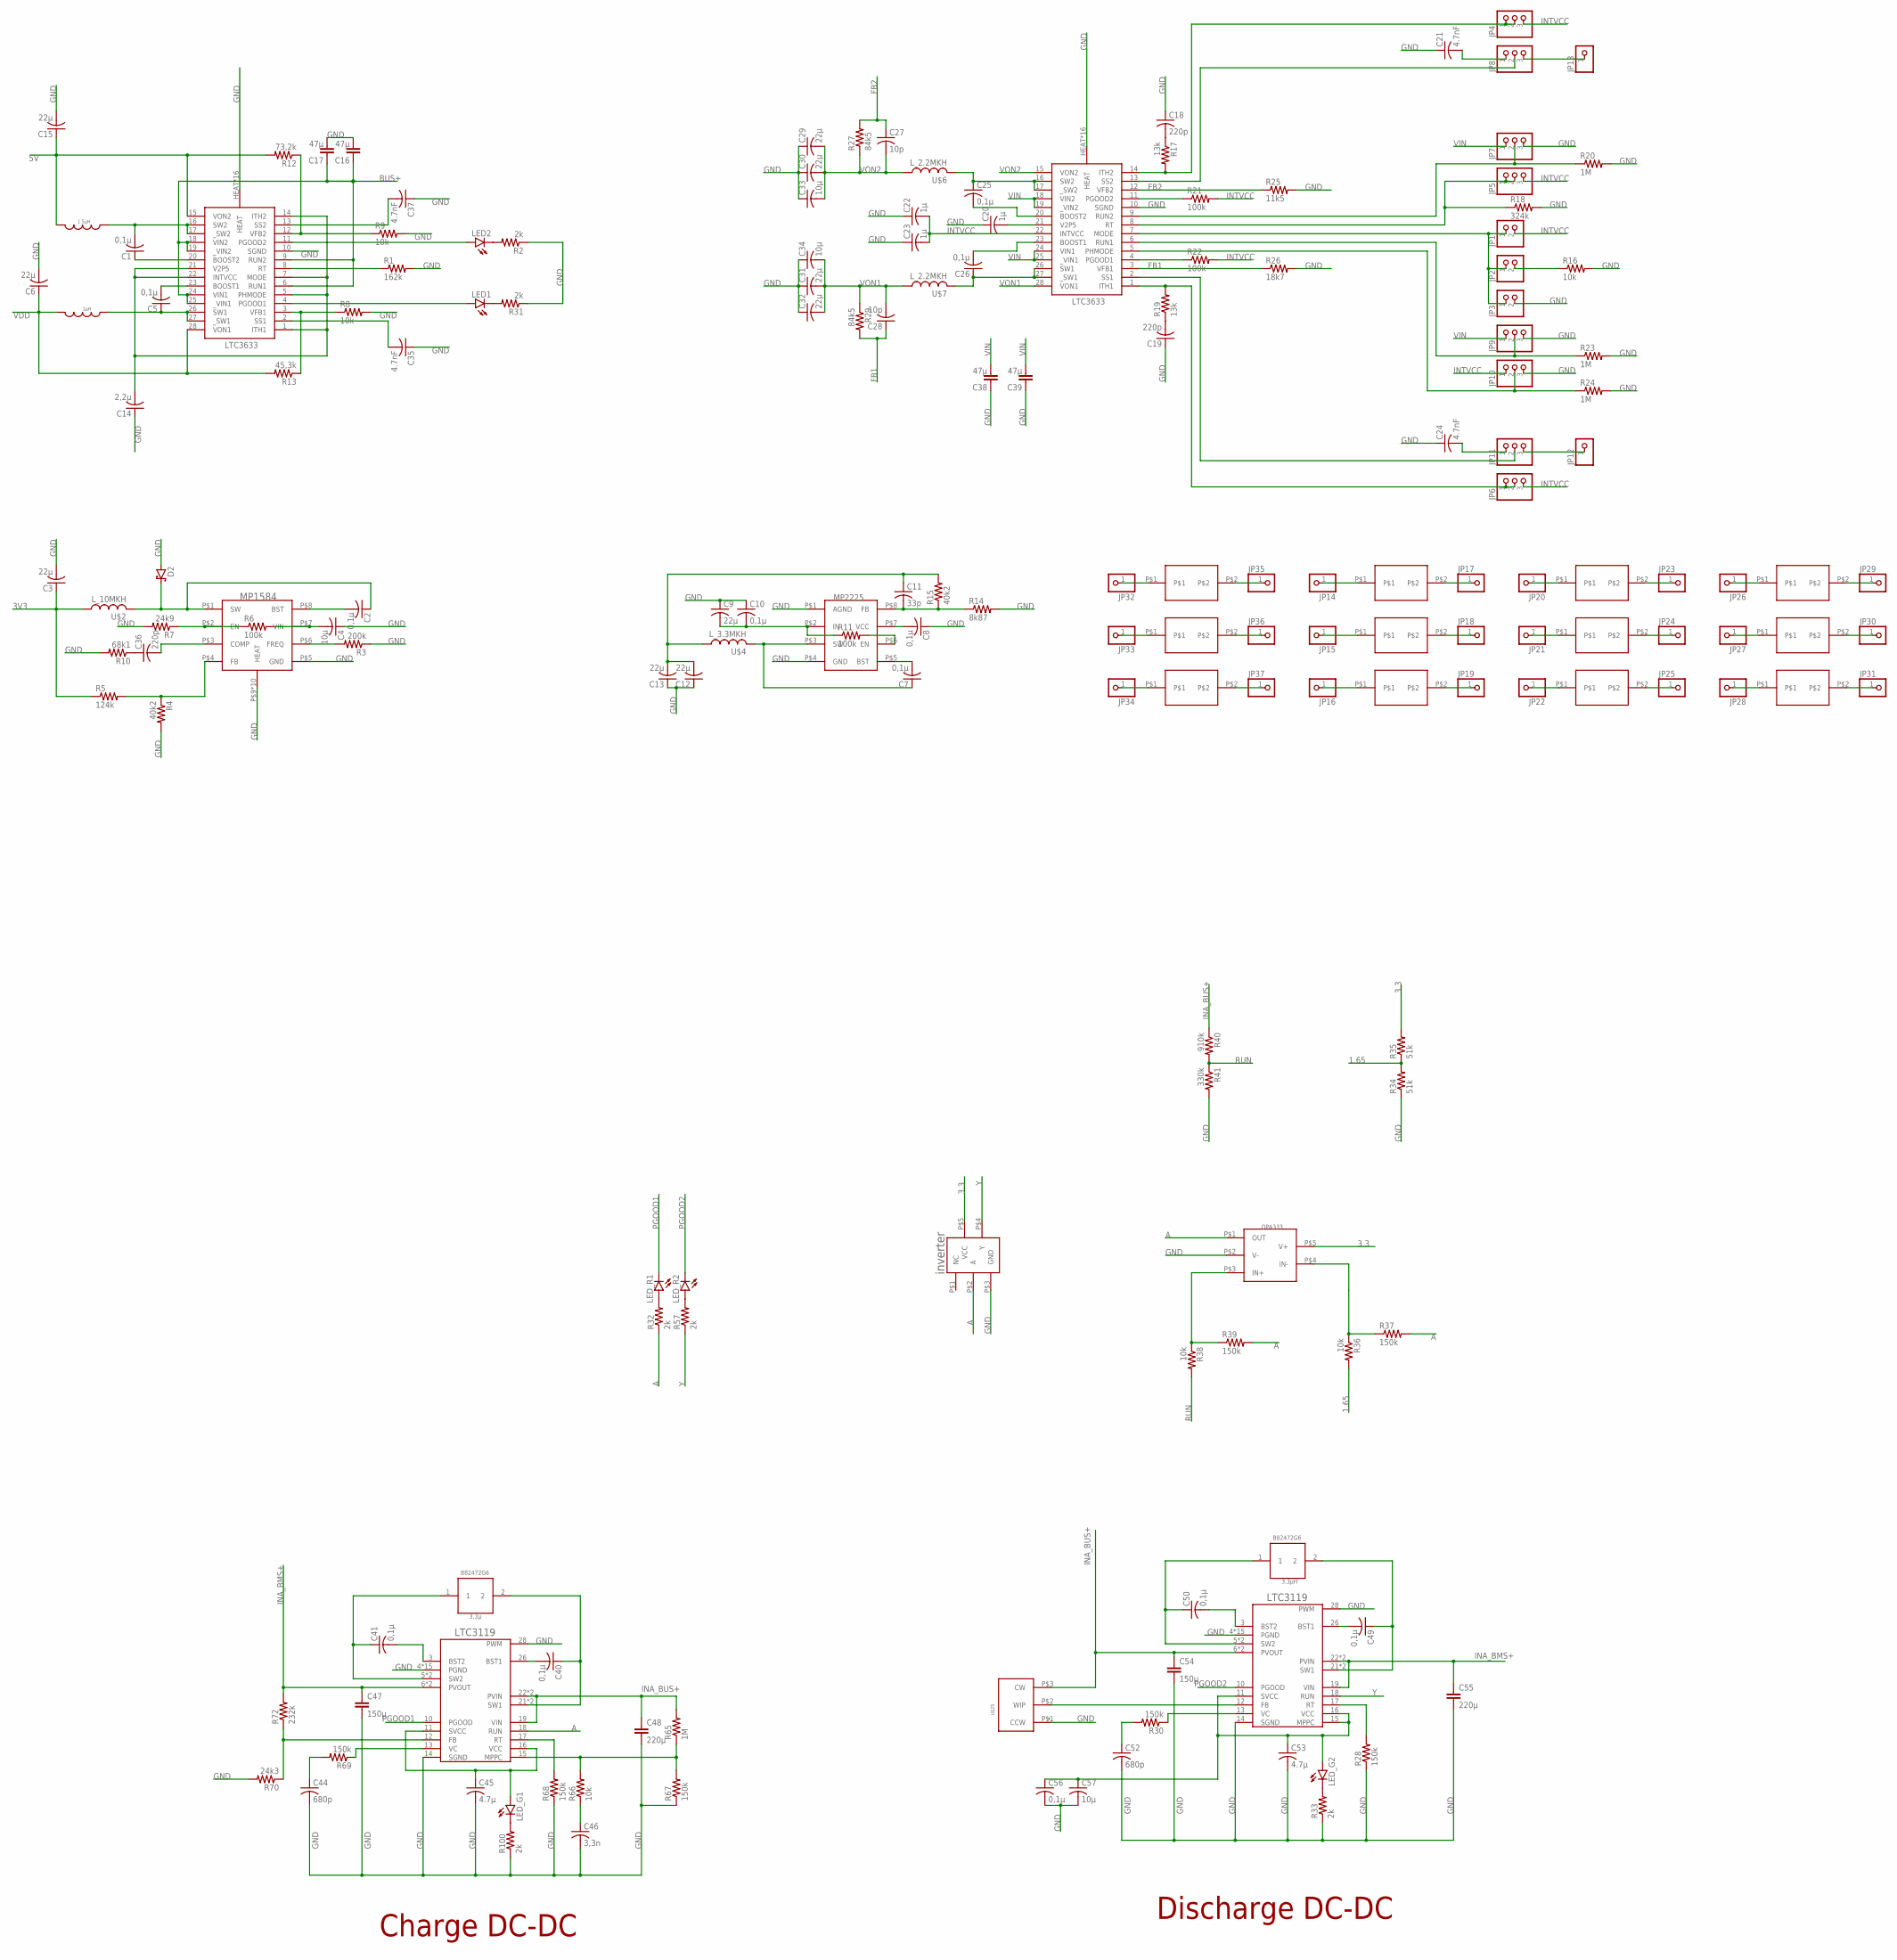
[picture p55: schematic DC-DC.sch]

Parts:
3,3µH: 3,3µ; B82472G6
3,3µH1: 3,3µH; B82472G6
C1, C2, C5, C7, C8, C10, C25, C26, C40, C41, C49, C50, C56: 0,1µ; C0603
C3, C6, C9, C12, C13, C15, C29, C30, C31, C32: 22µ; C1206
C4, C33, C34, C57: 10µ; C1206
C11: 33p; C0603
C14: 2,2µ; C0603
C16, C17, C38, C39: 47µ; C1210
C18, C19, C36: 220p; C0603
C20, C22, C23: 1µ; C0603
C21, C24, C35, C37: 4.7nF; C0603
C27, C28: 10p; C0603
C44, C52: 680p; C0603
C45, C53: 4.7µ; C1206
C46: 3,3n; C0603
C47, C54: 150µ; ECAP150
C48, C55: 220µ; ECAP220
D2: SCHOTTKY-DIODESMC; SMC
INVERT: INVERTER; SOT23-5
JP1, JP2, JP3: PINHD-1X2; 1X02
JP4, JP5, JP6, JP7, JP8, JP9, JP10, JP11: PINHD-1X3; 1X03
JP12, JP13, JP14, JP15, JP16, JP17, JP18, JP19, JP20, JP21, JP22, JP23, JP24, JP25, JP26, JP27, JP28, JP29, JP30, JP31, JP32, JP33, JP34, JP35, JP36, JP37: PINHD-1X1; 1X01
LED1, LED2: LEDCHIPLED_0603; CHIPLED_0603
LED_G1, LED_G2: LEDCHIPLED_0603; CHIPLED_0603
LED_R1, LED_R2: LEDCHIPLED_0603; CHIPLED_0603
OPA: OPA333; SOT23-5
R1: 162k; R0603
R2, R31, R32, R33, R57, R100: 2k; R0603
R3: 200k; R0603
R4, R15: 40k2; R0603
R5: 124k; R0603
R6, R11, R21, R22: 100k; R0603
R7: 24k9; R0603
R8, R9, R16, R36, R38, R66: 10k; R0603
R10: 68k1; R0603
R12: 73,2k; R0603
R13: 45,3k; R0603
R14: 8k87; R0603
R17, R19: 13k; R0603
R18: 324k; R0603
R20, R23, R24, R65: 1M; R0603
R25: 11k5; R0603
R26: 18k7; R0603
R27, R29: 84k5; R0603
R28, R30, R37, R39, R67, R68, R69: 150k; R0603
R34, R35: 51k; R0603
R40: 910k; R0603
R41: 330k; R0603
R70: 24k3; R0603
R72: 232k; R0603
U$1: MP1584+VIA
U$2: L_10MKH; L_12X12
U$3: MP2225; TSOT23-8
U$4: L_3.3MKH; L_SPM5020
U$5, U$10: LTC3633+VIA
U$6, U$7: L_2.2MKH; L_SPM4020
U$8: GRAFITGRAFIT1; GRAFIT1
U$9: GRAFITGRAFIT1_1; GRAFIT1_1
U$11: 1µH; VLS3012HBX
U$12: SPM4020
U$13: GRAFITGRAFIT1_2; GRAFIT1_2
U$14: GRAFITGRAFIT2; GRAFIT2
U$15: GRAFITGRAFIT2_1; GRAFIT2_1
U$16: GRAFITGRAFIT2_2; GRAFIT2_2
U$17: GRAFITGRAFIT3; GRAFIT3
U$18: GRAFITGRAFIT3_1; GRAFIT3_1
U$19: GRAFITGRAFIT3_2; GRAFIT3_2
U$20: GRAFITGRAFIT4; GRAFIT4
U$21: GRAFITGRAFIT4_1; GRAFIT4_1
U$22: GRAFITGRAFIT4_2; GRAFIT4_2
U$23, U$59: LTC31191; LTC3119+VIA
U$25: 32961; 3296W

Connections:
1.65: R34.2, R35.1, R36.2
3.3: INVERT.P$5 (VCC), OPA.P$5 (V+), R35.2
3V3: C3.1, R5.1, U$2.P$1 (1)
5V: C15.1, R12.2, U$10.15 (VON2), U$12.P$2 (2)
90: R65.1, R66.2, R67.2, U$59.15 (MPPC)
A: INVERT.P$2 (A), OPA.P$1 (OUT), R32.1, R37.2, R39.2, U$59.18 (RUN)
BUS+: C16.1, C17.1, U$10.6 (RUN1), U$10.9 (RUN2), U$10.18 (VIN2), U$10.19 (_VIN2), U$10.24 (VIN1), U$10.25 (_VIN1)
FB1: C28.1, R26.1, R29.2, U$5.3 (VFB1)
FB2: C27.1, R25.1, R27.2, U$5.12 (VFB2)
GND: C3.2, C4.1, C6.2, C8.1, C9.1, C10.1, C12.1, C13.1, C14.1, C15.2, C16.2, C17.2, C18.1, C19.1, C20.1, C21.1, C22.1, C23.1, C24.1, C29.1, C30.1, C31.1, C32.1, C33.1, C34.1, C35.1, C37.1, C38.1, C39.1, C44.2, C45.2, C46.2, C47.P$2 (2), C48.P$2 (2), C52.2, C53.2, C54.P$2 (2), C55.P$2 (2), C56.2, C57.2, D2.A, INVERT.P$3 (GND), JP3.2, JP7.3, JP9.3, JP10.3, OPA.P$2 (V-), R1.2, R2.1, R3.1, R4.2, R7.2, R8.2, R9.2, R10.2, R14.2, R16.2, R18.2, R20.2, R23.2, R24.2, R25.2, R26.2, R28.1, R31.1, R33.1, R34.1, R41.2, R67.1, R68.1, R70.2, R100.1, U$1.P$5 (GND), U$1.P$9 (HEAT), U$1.P$10 (HEAT), U$1.P$11 (HEAT), U$1.P$12 (HEAT), U$1.P$13 (HEAT), U$1.P$14 (HEAT), U$1.P$15 (HEAT), U$1.P$16 (HEAT), U$1.P$17 (HEAT), U$1.P$18 (HEAT), U$3.P$1 (AGND), U$3.P$4 (GND), U$5.10 (SGND), U$5.HEAT, U$5.P$1 (HEAT), U$5.P$2 (HEAT), U$5.P$3 (HEAT), U$5.P$4 (HEAT), U$5.P$5 (HEAT), U$5.P$6 (HEAT), U$5.P$7 (HEAT), U$5.P$8 (HEAT), U$5.P$9 (HEAT), U$5.P$10 (HEAT), U$5.P$11 (HEAT), U$5.P$12 (HEAT), U$5.P$13 (HEAT), U$5.P$14 (HEAT), U$5.P$15 (HEAT), U$10.10 (SGND), U$10.HEAT, U$10.P$1 (HEAT), U$10.P$2 (HEAT), U$10.P$3 (HEAT), U$10.P$4 (HEAT), U$10.P$5 (HEAT), U$10.P$6 (HEAT), U$10.P$7 (HEAT), U$10.P$8 (HEAT), U$10.P$9 (HEAT), U$10.P$10 (HEAT), U$10.P$11 (HEAT), U$10.P$12 (HEAT), U$10.P$13 (HEAT), U$10.P$14 (HEAT), U$10.P$15 (HEAT), U$23.4 (PGND), U$23.9 (PGND), U$23.14 (SGND), U$23.20 (PGND), U$23.25 (PGND), U$23.28 (PWM), U$23.29 (PGND), U$23.P$1 (PGND), U$23.P$2 (PGND), U$23.P$3 (PGND), U$23.P$4 (PGND), U$23.P$5 (PGND), U$23.P$6 (PGND), U$23.P$7 (PGND), U$23.P$8 (PGND), U$23.P$9 (PGND), U$23.P$10 (PGND), U$25.P$1 (CCW), U$59.4 (PGND), U$59.9 (PGND), U$59.14 (SGND), U$59.20 (PGND), U$59.25 (PGND), U$59.28 (PWM), U$59.29 (PGND), U$59.P$1 (PGND), U$59.P$2 (PGND), U$59.P$3 (PGND), U$59.P$4 (PGND), U$59.P$5 (PGND), U$59.P$6 (PGND), U$59.P$7 (PGND), U$59.P$8 (PGND), U$59.P$9 (PGND), U$59.P$10 (PGND)
INA_BMS+: C47.P$1 (1), C55.P$1 (1), R72.2, U$23.19 (VIN), U$23.22 (PVIN), U$23.23 (PVIN), U$59.6 (PVOUT), U$59.7 (PVOUT)
INA_BUS+: C48.P$1 (1), C54.P$1 (1), R40.1, R65.2, U$23.6 (PVOUT), U$23.7 (PVOUT), U$25.P$3 (CW), U$59.19 (VIN), U$59.22 (PVIN), U$59.23 (PVIN)
INTVCC: C22.2, C23.2, JP1.2, JP4.3, JP5.3, JP6.3, JP10.1, R21.2, R22.2, U$5.22 (INTVCC)
unnamed: R1.1, U$10.8 (RT)
unnamed: LED1.C, R31.2
unnamed: LED2.A, U$10.11 (PGOOD2)
unnamed: LED2.C, R2.2
unnamed: C2.2, U$1.P$8 (BST)
unnamed: C2.1, D2.C, U$1.P$1 (SW), U$2.P$2 (2)
unnamed: R3.2, U$1.P$6 (FREQ)
unnamed: R4.1, R5.2, U$1.P$4 (FB)
unnamed: R6.1, R7.1, U$1.P$2 (EN)
unnamed: C4.2, R6.2, U$1.P$7 (VIN)
unnamed: C36.1, R10.1
unnamed: C36.2, U$1.P$3 (COMP)
unnamed: C7.2, U$3.P$5 (BST)
unnamed: C7.1, U$3.P$3 (SW), U$4.P$2 (2)
unnamed: R11.2, U$3.P$6 (EN)
unnamed: C8.2, U$3.P$7 (VCC)
unnamed: C9.2, C10.2, R11.1, U$3.P$2 (IN)
unnamed: C11.2, R14.1, R15.1, U$3.P$8 (FB)
unnamed: C11.1, C12.2, C13.2, R15.2, U$4.P$1 (1)
unnamed: JP1.1, JP2.1, JP3.1, U$5.7 (MODE)
unnamed: JP4.1, JP4.2, R17.2, U$5.14 (ITH2)
unnamed: C18.2, R17.1
unnamed: JP2.2, R16.1
unnamed: C14.2, U$10.1 (ITH1), U$10.5 (PHMODE), U$10.7 (MODE), U$10.14 (ITH2), U$10.21 (V2P5), U$10.22 (INTVCC)
unnamed: R8.1, R13.1, U$10.3 (VFB1)
unnamed: JP5.1, JP5.2, R18.1, U$5.8 (RT)
unnamed: C20.2, U$5.21 (V2P5)
unnamed: C5.1, U$10.26 (SW1), U$10.27 (_SW1), U$11.P$1 (1)
unnamed: JP6.1, JP6.2, R19.2, U$5.1 (ITH1)
unnamed: C19.2, R19.1
unnamed: C5.2, U$10.23 (BOOST1)
unnamed: C1.1, U$10.20 (BOOST2)
unnamed: C1.2, U$10.16 (SW2), U$10.17 (_SW2), U$12.P$1 (1)
unnamed: C25.1, U$5.16 (SW2), U$5.17 (_SW2), U$6.P$2 (2)
unnamed: C26.1, U$5.26 (SW1), U$5.27 (_SW1), U$7.P$2 (2)
unnamed: R22.1, U$5.4 (PGOOD1)
unnamed: JP8.2, U$5.13 (SS2)
unnamed: JP7.2, R20.1, U$5.9 (RUN2)
unnamed: R9.1, R12.1, U$10.12 (VFB2)
unnamed: R21.1, U$5.11 (PGOOD2)
unnamed: JP9.2, R23.1, U$5.6 (RUN1)
unnamed: JP11.2, U$5.2 (SS1)
unnamed: C21.2, JP8.1
unnamed: JP10.2, R24.1, U$5.5 (PHMODE)
unnamed: C24.2, JP11.1
unnamed: C25.2, U$5.20 (BOOST2)
unnamed: LED1.A, U$10.4 (PGOOD1)
unnamed: C26.2, U$5.23 (BOOST1)
unnamed: JP8.3, JP13.1
unnamed: JP11.3, JP12.1
unnamed: C35.2, U$10.2 (SS1)
unnamed: C37.2, U$10.13 (SS2)
unnamed: JP14.1, U$14.P$1
unnamed: JP15.1, U$15.P$1
unnamed: JP16.1, U$16.P$1
unnamed: JP17.1, U$14.P$2
unnamed: JP18.1, U$15.P$2
unnamed: JP19.1, U$16.P$2
unnamed: JP20.1, U$17.P$1
unnamed: JP21.1, U$18.P$1
unnamed: JP22.1, U$19.P$1
unnamed: JP23.1, U$17.P$2
unnamed: JP24.1, U$18.P$2
unnamed: JP25.1, U$19.P$2
unnamed: JP26.1, U$20.P$1
unnamed: JP27.1, U$21.P$1
unnamed: JP28.1, U$22.P$1
unnamed: JP29.1, U$20.P$2
unnamed: JP30.1, U$21.P$2
unnamed: JP31.1, U$22.P$2
unnamed: JP32.1, U$8.P$1
unnamed: JP33.1, U$9.P$1
unnamed: JP34.1, U$13.P$1
unnamed: JP35.1, U$8.P$2
unnamed: JP36.1, U$9.P$2
unnamed: JP37.1, U$13.P$2
unnamed: 3,3µH1.2, C49.1, U$23.21 (SW1), U$23.24 (SW1)
unnamed: 3,3µH1.1, C50.1, U$23.5 (SW2), U$23.8 (SW2)
unnamed: R28.2, U$23.17 (RT)
unnamed: C49.2, U$23.26 (BST1)
unnamed: R30.1, U$23.13 (VC)
unnamed: C52.1, R30.2
unnamed: C50.2, U$23.3 (BST2)
unnamed: LED_R1.A, R32.2
unnamed: U$23.12 (FB), U$25.P$2 (WIP)
unnamed: LED_R2.A, R57.2
unnamed: R70.1, R72.1, U$59.12 (FB)
unnamed: OPA.P$3 (IN+), R38.1, R39.1
unnamed: LED_G1.C, R100.2
unnamed: LED_G2.C, R33.2
unnamed: C41.2, U$59.3 (BST2)
unnamed: 3,3µH.2, C40.1, U$59.21 (SW1), U$59.24 (SW1)
unnamed: 3,3µH.1, C41.1, U$59.5 (SW2), U$59.8 (SW2)
unnamed: R69.1, U$59.13 (VC)
unnamed: C44.1, R69.2
unnamed: C46.1, R66.1
unnamed: R68.2, U$59.17 (RT)
unnamed: C40.2, U$59.26 (BST1)
unnamed: C53.1, C56.1, C57.1, LED_G2.A, U$23.11 (SVCC), U$23.15 (MPPC), U$23.16 (VCC)
unnamed: C45.1, LED_G1.A, U$59.11 (SVCC), U$59.16 (VCC)
unnamed: OPA.P$4 (IN-), R36.1, R37.1
PGOOD1: LED_R1.C, U$59.10 (PGOOD)
PGOOD2: LED_R2.C, U$23.10 (PGOOD)
RUN: R38.2, R40.2, R41.1
VDD: C6.1, R13.2, U$10.28 (VON1), U$11.P$2 (2)
VIN: C38.2, C39.2, JP7.1, JP9.1, U$5.18 (VIN2), U$5.19 (_VIN2), U$5.24 (VIN1), U$5.25 (_VIN1)
VON1: C28.2, C31.2, C32.2, C34.2, R29.1, U$5.28 (VON1), U$7.P$1 (1)
VON2: C27.2, C29.2, C30.2, C33.2, R27.1, U$5.15 (VON2), U$6.P$1 (1)
Y: INVERT.P$4 (Y), R57.1, U$23.18 (RUN)

Notes on the sheet:
1µH
1.5µH
Charge DC-DC
Discharge DC-DC

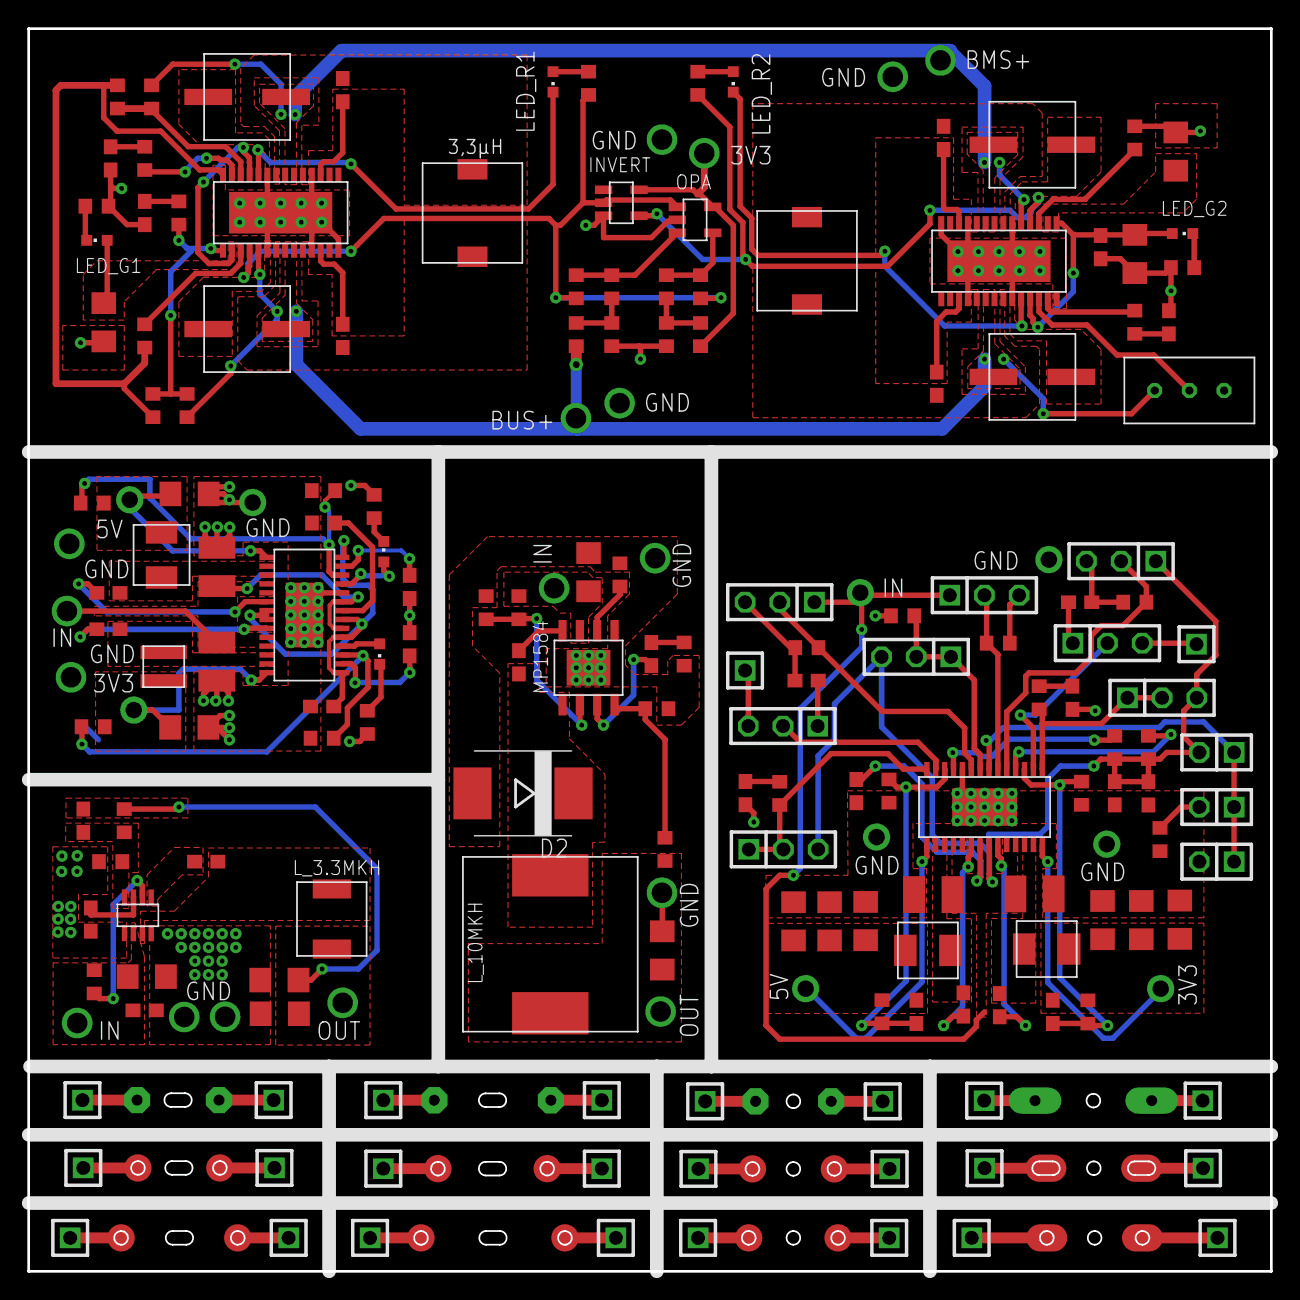
[picture p56: board DC-DC.brd from above]

Board: 2 copper layers, 91.0 x 91.0 mm, 177 parts (0 on the bottom side), 122 nets.
