cansat-tsniimash/can-cube-sat-2022/schematics/board/SP.brd

## EAGLE design schematics/board/SP.brd (2020-08-12)

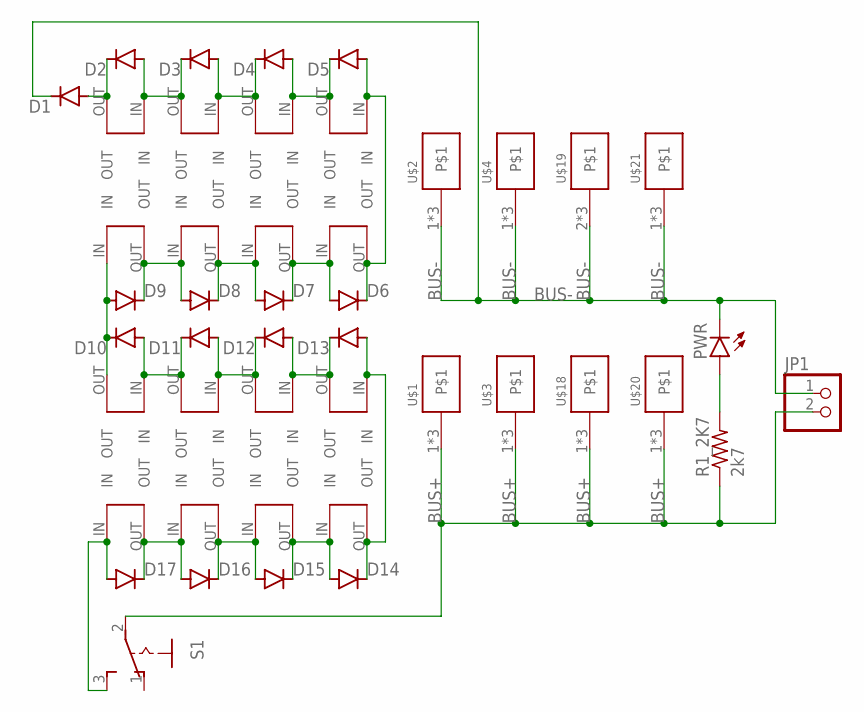
[picture p57: schematic SP.sch]

Parts:
D1, D2, D3, D4, D5, D6, D7, D8, D9, D10, D11, D12, D13, D14, D15, D16, D17: MBR0520LT; SOD123
JP1: PINHD-1X2; 1X02
PWR: LEDCHIPLED_0603; CHIPLED_0603
R1_2K7: 2k7; R0603
S1: 255SB
SOL1, SOL2, SOL3, SOL5, SOL6, SOL7, SOL9, SOL10, SOL11, SOL13, SOL14, SOL15: SOLAR_0
SOL4, SOL8, SOL12, SOL16: SOLAR_1
U$1, U$2, U$20, U$21: KCONNECT3; KCONNECT-3
U$3, U$4, U$18: KCONNECT4; KCONNECT-4
U$19: KCONNECT1; KCONNECT-1

Connections:
BUS+: JP1.2, R1_2K7.1, S1.2, U$1.1, U$1.2, U$1.4, U$3.1, U$3.2, U$3.3, U$18.1, U$18.2, U$18.3, U$20.1, U$20.2, U$20.4
BUS-: D1.C, JP1.1, PWR.C, U$2.1, U$2.2, U$2.4, U$4.1, U$4.2, U$4.3, U$19.2, U$19.3, U$19.4, U$21.1, U$21.2, U$21.4
unnamed: D16.A, D17.C, SOL1.OUT, SOL2.IN
unnamed: D15.A, D16.C, SOL2.OUT, SOL3.IN
unnamed: D1.A, D2.C, SOL16.OUT
unnamed: PWR.A, R1_2K7.2
unnamed: D14.A, D15.C, SOL3.OUT, SOL4.IN
unnamed: D17.A, S1.3 (S), SOL1.IN
unnamed: D12.A, D13.C, SOL5.OUT, SOL6.IN
unnamed: D11.A, D12.C, SOL6.OUT, SOL7.IN
unnamed: D10.A, D11.C, SOL7.OUT, SOL8.IN
unnamed: D9.A, D10.C, SOL8.OUT, SOL9.IN
unnamed: D8.A, D9.C, SOL9.OUT, SOL10.IN
unnamed: D7.A, D8.C, SOL10.OUT, SOL11.IN
unnamed: D6.A, D7.C, SOL11.OUT, SOL12.IN
unnamed: D5.A, D6.C, SOL12.OUT, SOL13.IN
unnamed: D4.A, D5.C, SOL13.OUT, SOL14.IN
unnamed: D3.A, D4.C, SOL14.OUT, SOL15.IN
unnamed: D2.A, D3.C, SOL15.OUT, SOL16.IN
unnamed: D13.A, D14.C, SOL4.OUT, SOL5.IN

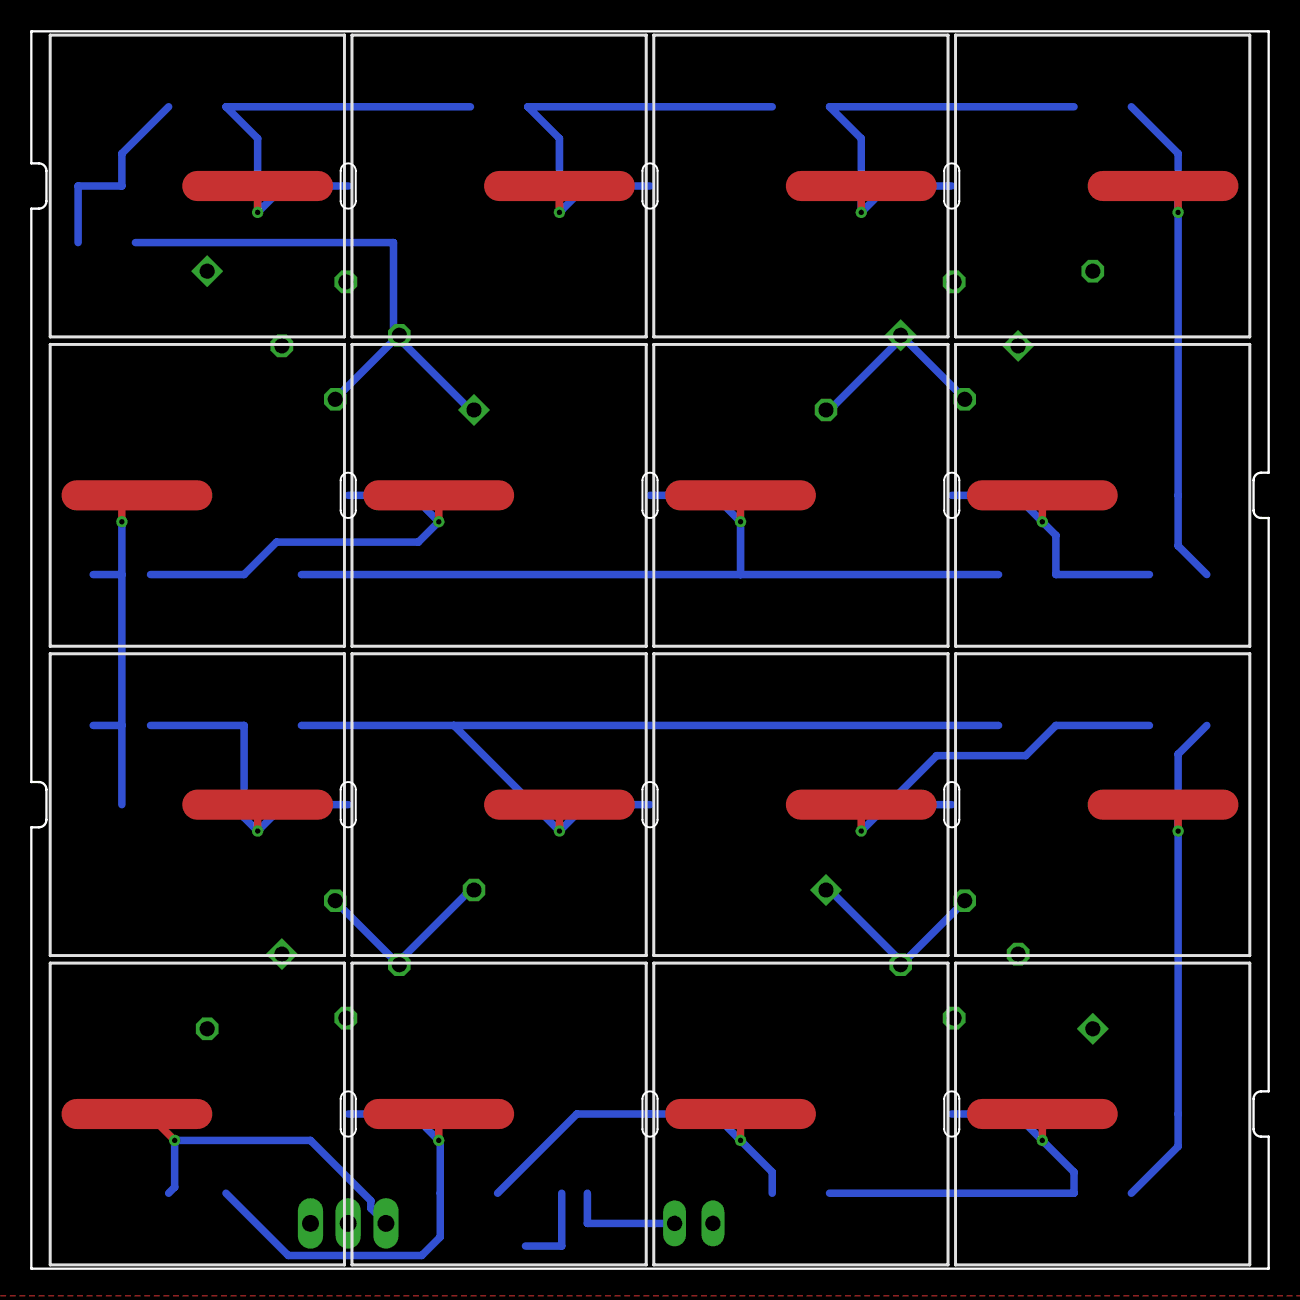
[picture p58: board SP.brd from above]

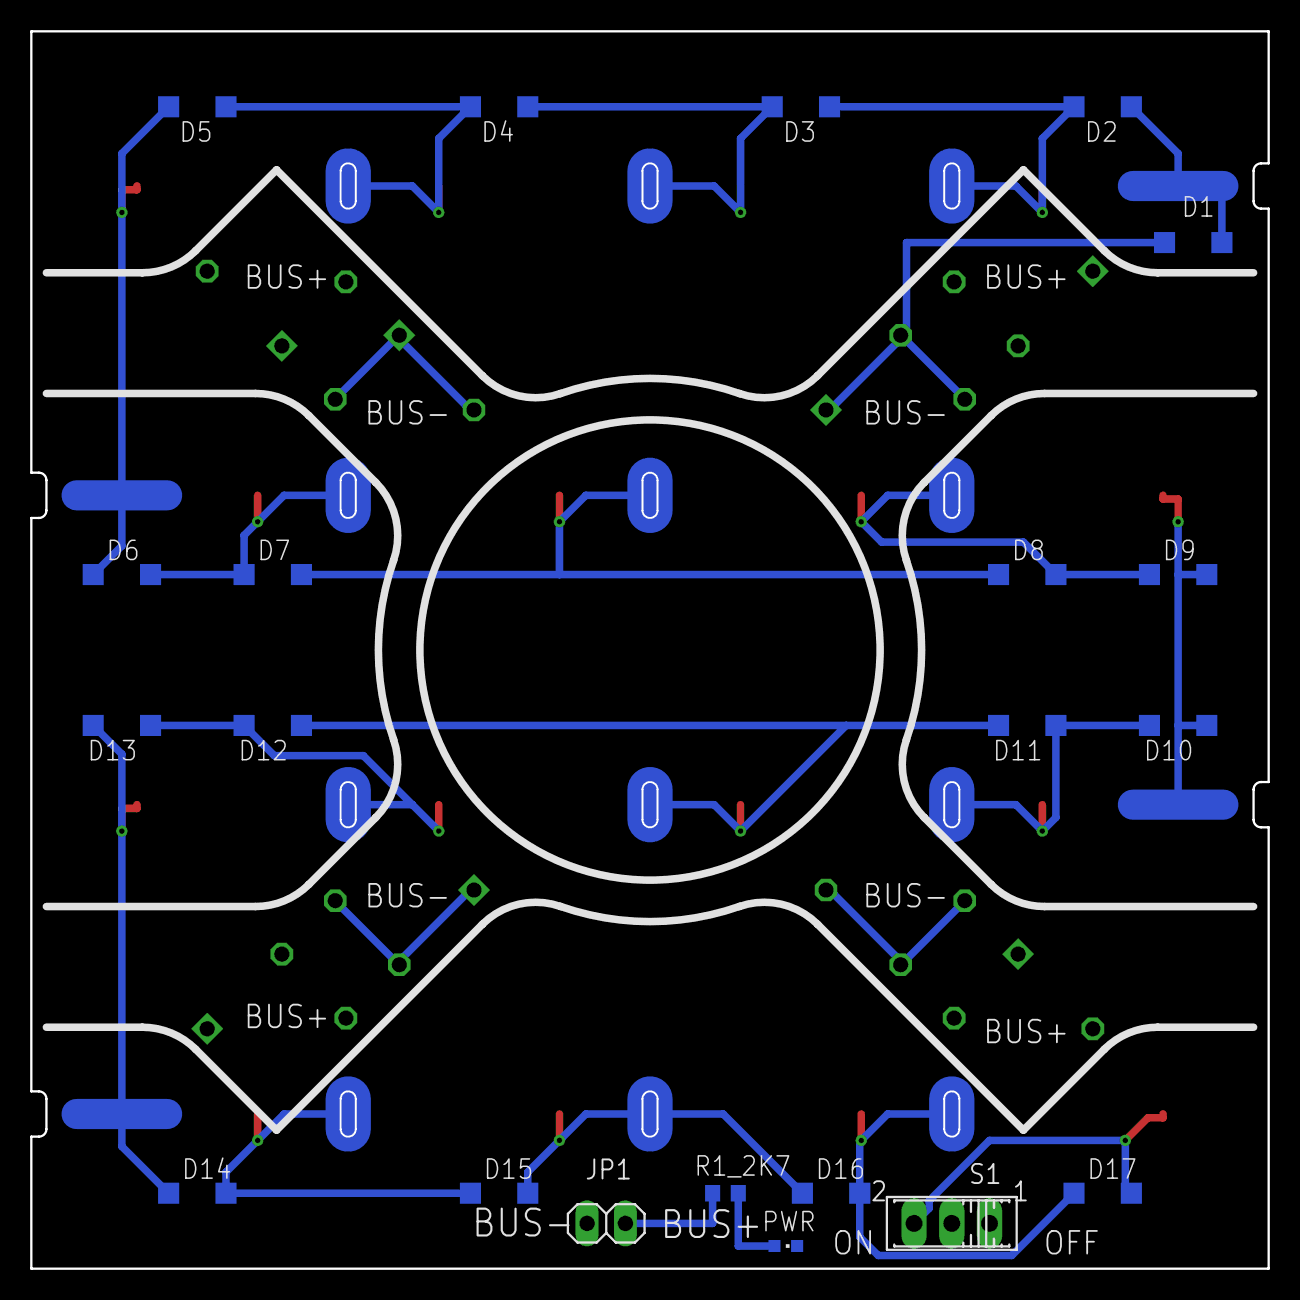
[picture p59: board SP.brd from below]

Board: 2 copper layers, 82.0 x 82.0 mm, 45 parts (29 on the bottom side), 20 nets.
