cansat-tsniimash/can-cube-sat-2022/schematics/board/BSK5+ARK.brd

## EAGLE design schematics/board/BSK5+ARK.brd (2021-05-01)

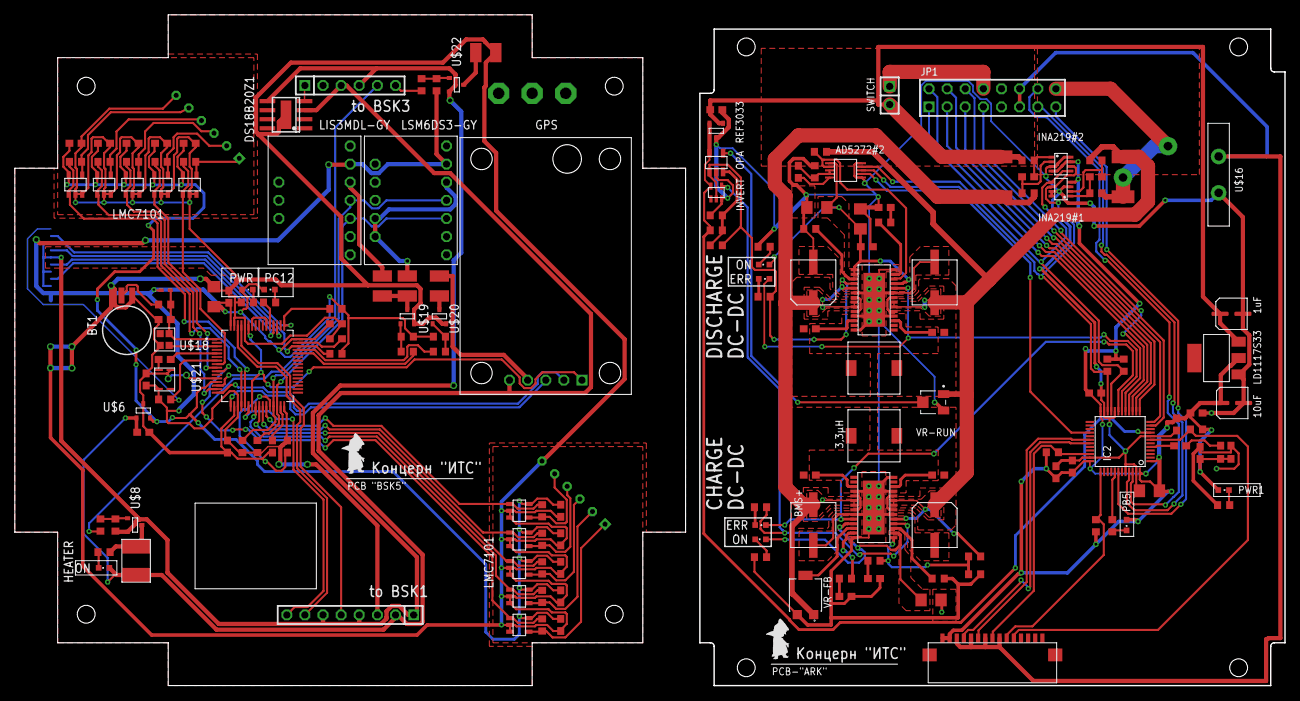
[picture p62: board BSK5+ARK.brd from above]

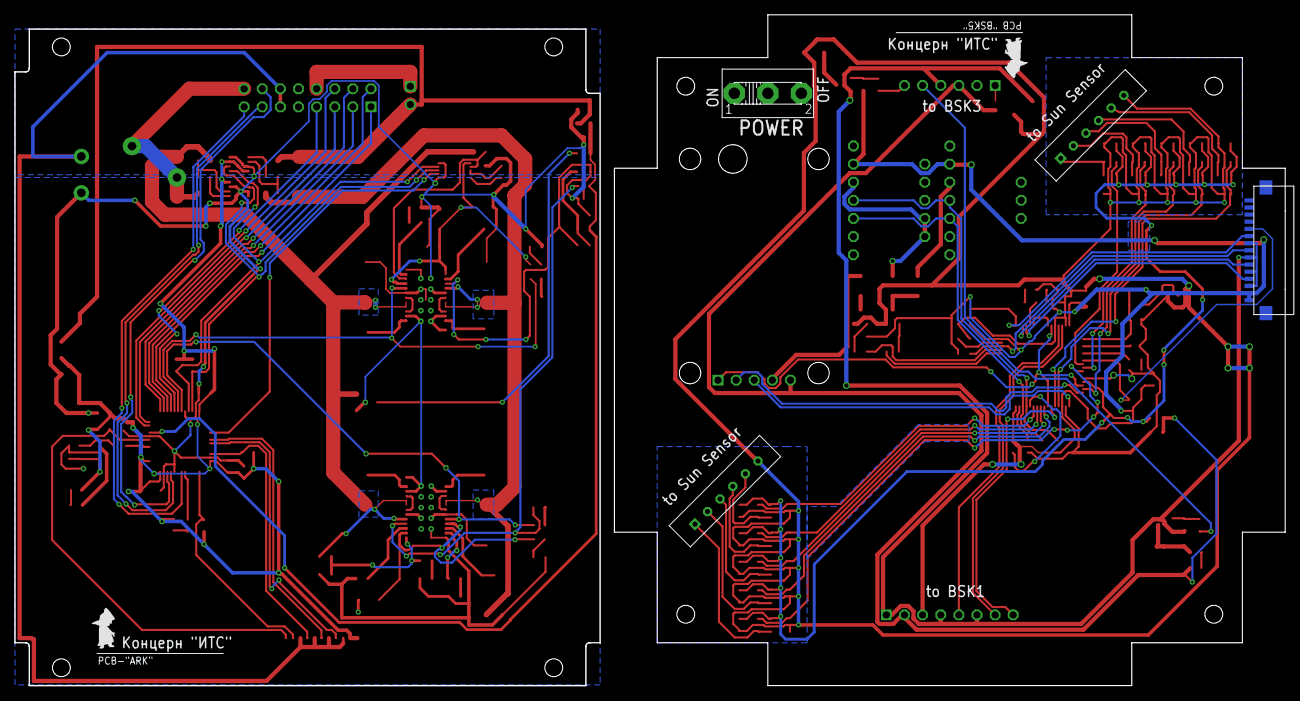
[picture p63: board BSK5+ARK.brd from below]

Board: 2 copper layers, 178.0 x 94.0 mm, 173 parts (6 on the bottom side), 134 nets.

Parts:
3,3µH: 3,3µ; B82472G6
3,3µH1: 3,3µH; B82472G6
AD5272#2: AD5272; MSOP10
BSK1: 1X08
BSK3: 1X06
BT1: 6.8MM_COIN_CELL; BATTCON-6.8MM
C1, C5, C31: 10nF; C0603
C2, C6, C7, C8, C11, C12, C14, C15, C16, C17, C18, C20, C22, C23, C25, C26, C27, C54, C55: 100nF; C0603
C3, C33: 470nF; C0603
C4, C30: 1nF; C0603
C9, C13: 2,2µ; C0603
C10, C47: 150µ; ECAP150-CMD
C19, C24, C57: 10µ; C1206
C21, C48: 220µ; ECAP220-CMD
C28, C29, C40, C41, C49, C50, C56: 0,1µ; C0603
C32: 1µ; C0603
C34: 10uF; ECAP-SMD-D4
C35: 1uF; ECAP-SMD-D4
C44, C52: 680p; C0603
C45, C53: 4.7µ; C1206
C46: 3,3n; C0603
D1: BB141; SOD523
DS18B20Z1: DS18B20Z; SOIC8+HEAT_S
GPS: GPSNEO6M; GPS-NEO6M
HEATER: EM_HEAT
IC2: STM32F103C8T; LQFP48
INA219#1, INA219#2: INA219AID; SOT23-8
INVERT: INVERTER.; SC70
JP1: 2X08
LD1117S33: LD1117S33; SOT223
LED_G1, LED_G2: CHIPLED_0603
LED_R1, LED_R2: CHIPLED_0603
LIS3MDL-GY: LIS3MDL-GY
LSM6DS3-GY: LSM6DS3-GY
ON: CHIPLED_0603
OPA: OPA333; SOT23-5
PB5: CHIPLED_0603
PC12: CHIPLED_0603
PWR, PWR1: CHIPLED_0603
R1, R2, R3, R36, R64, R66, R79: 10k; R0603
R4, R5, R6, R9, R12, R13, R14, R18, R19, R28: 24k9; R0603
R7, R15, R16, R27, R35, R57, R81, R82, R100: 2k; R0603
R8, R22, R24, R33, R65: 1M; R0603
R10: 620R; R0603
R11, R17, R67, R68, R69: 150k; R0603
R20: 0.5A; R1210
R21: 0.2A; R1210
R23, R34: 0.05A; R1210
R25, R26, R101, R102: 5k1; R0603
R29, R30, R31, R32: 100R; R0603
R37: 14K3; R0603
R38: 91K; R0603
R39: 430k; R0603
R40: 680k; R0603
R41: 120k; R0603
R71, R75: R01; R2512
R73, R74, R76, R77: 10R; R0603
REF3033: REF3033; SOT23-3
S1: UNICS-SWITCH
SWITCH: 1X02
TCXO: OC2E08000XCCDRX
U1: STM32F405RGT6; QFP50P1200X1200X160-64N
U$1, U$2, U$3, U$4, U$5, U$7, U$9, U$10, U$11, U$23: LMC7101
U$6: REF3033; SOT23-3
U$8, U$19, U$20, U$22: SI2302CDS; SOT23-3
U$12, U$15: FFC-CONNECT68611; 68611
U$13, U$26: PCB "BSK5"; ITS-LOGO
U$14, U$59: LTC31191; LTC3119+VIA
U$16: MF-R400
U$17, U$24: PCB-"ARK"; ITS-LOGO
U$18: Q32.768
U$21: Q24
VR-FB: 3314G-1-504E; TRIM_3314G-1-504E
VR-RUN: 3313J-1-205E; TRIM_3313J-1-205E
X1, X11: JST-6A; B6B-EH-A

Connections:
1: HEATER.2, R7.2, U$8.3
1W: BSK3.1, DS18B20Z1.4
1W1: IC2.17, JP1.7
3V1: C22.1, C23.1, C24.1, C25.1, C26.1, C27.1, C31.2, C34.P+, IC2.1, IC2.24, IC2.36, IC2.48, INA219#1.4, INA219#2.4, INA219#2.7, LD1117S33.P$3, PB5.A, PWR1.A, R36.1, R64.1, R79.1, R101.1, R102.1, TCXO.P$1, TCXO.P$4, U$15.P$1, U$15.P$2
3V3: BSK1.3, C5.2, C18.2, C19.2, C20.2, C54.2, C55.2, D1.A, LIS3MDL-GY.P$6, LSM6DS3-GY.P$6, PC12.A, PWR.A, R1.2, R2.2, R3.2, R22.1, R24.1, R25.1, R26.1, R33.1, U1.19, U1.32, U1.48, U1.64, U$12.P$1, U$12.P$2, U$21.P$4
3V3-STAB: C2.1, C6.1, C7.1, C8.1, C11.1, C12.1, C14.1, C15.1, C16.1, C17.1, U1.13, U$1.P$5, U$2.P$5, U$3.P$5, U$4.P$5, U$5.P$5, U$6.2, U$7.P$5, U$9.P$5, U$10.P$5, U$11.P$5, U$23.P$5
3V3-STAB1: IC2.9, INVERT.P$5, OPA.P$5, R41.1, REF3033.2
5V: BSK1.2, BSK3.3, C3.2, DS18B20Z1.3, GPS.P$5, HEATER.1, ON.A, U$6.1
90: R65.1, R66.2, R67.2, U$59.15
A: INVERT.P$2, OPA.P$1, R35.1, R40.1, U$14.18
B5-KHEAT: BSK3.5, R29.1
BMS1: IC2.16, JP1.1
BMS2: IC2.15, JP1.2
BMS3: IC2.14, JP1.3
BMS4: IC2.13, JP1.4
BMS5: IC2.12, JP1.5
BMS6: IC2.11, JP1.6
BMS+: C33.2, C35.P+, LD1117S33.P$4, R75.2, R76.1, REF3033.1, SWITCH.2
BMS+_OUT: JP1.8, SWITCH.1
BUS+1: JP1.16, R71.2, R73.1
CELL: C1.2, D1.C, R10.2, U1.1, U$18.P$4
DPD_RST: AD5272#2.7, IC2.28
GND: BT1.-, C1.1, C2.2, C3.1, C5.1, C6.2, C7.2, C8.2, C9.1, C11.2, C12.2, C13.1, C14.2, C15.2, C16.2, C17.2, C18.1, C19.1, C20.1, C54.1, C55.1, DS18B20Z1.HEAT, R16.1, R20.2, U1.12, U1.18, U1.28, U1.60, U1.63, U$1.P$2, U$1.P$3, U$2.P$2, U$2.P$3, U$3.P$2, U$3.P$3, U$4.P$2, U$4.P$3, U$5.P$2, U$5.P$3, U$6.3, U$7.P$2, U$7.P$3, U$9.P$2, U$9.P$3, U$10.P$2, U$10.P$3, U$11.P$2, U$11.P$3, U$18.P$2, U$19.2, U$20.2, U$21.P$2, U$23.P$2, U$23.P$3, X1.6, X11.6
GND1: AD5272#2.6, AD5272#2.10, C10.P$2, C21.P$2, C22.2, C23.2, C24.2, C25.2, C26.2, C27.2, C31.1, C33.1, C34.P-, C35.P-, C44.2, C45.2, C46.2, C47.P$2, C48.P$2, C52.2, C53.2, C56.2, C57.2, IC2.8, IC2.20, IC2.23, IC2.35, IC2.44, IC2.47, INA219#1.3, INA219#1.7, INA219#1.8, INA219#2.3, INA219#2.8, INVERT.P$3, LD1117S33.P$2, OPA.P$2, R11.1, R27.1, R37.2, R39.1, R67.1, R68.1, R82.1, R100.1, REF3033.3, TCXO.P$2, U$14.4, U$14.9, U$14.14, U$14.20, U$14.25, U$14.28, U$14.29, U$14.P$1, U$14.P$2, U$14.P$3, U$14.P$4, U$14.P$5, U$14.P$6, U$14.P$7, U$14.P$8, U$14.P$9, U$14.P$10, U$16.P$1, U$59.4, U$59.9, U$59.14, U$59.20, U$59.25, U$59.28, U$59.29, U$59.P$1, U$59.P$2, U$59.P$3, U$59.P$4, U$59.P$5, U$59.P$6, U$59.P$7, U$59.P$8, U$59.P$9, U$59.P$10, VR-FB.3, VR-RUN.3
GND-GPS: R21.2, U$20.3
GND-MAG: R23.2, R34.2, U$19.3
GND-OUT: BSK1.1, BSK1.4, BSK1.6, BSK3.4, DS18B20Z1.5, R8.2, U$8.2, U$12.P$3, U$12.P$5, U$12.P$7, U$12.P$9, U$22.2
GND-OUT1: JP1.11, JP1.12, U$15.P$3, U$15.P$5, U$15.P$7, U$15.P$9, U$16.P$2
GPS: R32.1, U1.45
INA_BMS+: C21.P$1, C47.P$1, R75.1, R77.1, U$14.19, U$14.22, U$14.23, U$59.6, U$59.7, VR-FB.1
INA_BUS+: C10.P$1, C48.P$1, R38.1, R65.2, R71.1, R74.1, U$14.6, U$14.7, U$59.19, U$59.22, U$59.23, VR-RUN.1
MAG: R31.1, U1.44
unnamed: U1.3, U$18.P$3
unnamed: R20.1, U$22.3
unnamed: C28.2, INA219#1.2, R74.2
unnamed: R13.1, U$7.P$4, X11.1
unnamed: R6.1, U$3.P$4, X1.1
unnamed: R9.1, U$4.P$4, X1.4
unnamed: R8.1, R29.2, U$8.1
unnamed: C30.2, TCXO.P$3
unnamed: C30.1, IC2.5
unnamed: R30.2, R33.2, U$22.1
unnamed: R24.2, R31.2, U$19.1
unnamed: LSM6DS3-GY.P$5, LSM6DS3-GY.P$8, LSM6DS3-GY.P$9, R23.1
unnamed: R22.2, R32.2, U$20.1
unnamed: LIS3MDL-GY.P$5, R34.1
unnamed: AD5272#2.3, AD5272#2.4, C32.2, R37.1
unnamed: AD5272#2.2, R38.2, U$14.12
unnamed: PB5.C, R81.2
unnamed: OPA.P$3, R39.2, R40.2, R41.2
unnamed: BT1.+, R10.1
unnamed: GPS.P$4, R21.1
unnamed: U1.54, U1.58
unnamed: C13.2, U1.47
unnamed: R4.1, U$1.P$4, X11.4
unnamed: R5.1, U$2.P$4, X11.5
unnamed: ON.C, R7.1
unnamed: R12.1, U$5.P$4, X1.5
unnamed: C9.2, U1.31
unnamed: PC12.C, R15.2
unnamed: R15.1, U1.53
unnamed: PWR.C, R16.2
unnamed: GPS.P$2, U1.16
unnamed: GPS.P$3, U1.17
unnamed: C4.2, U$21.P$3
unnamed: C4.1, U1.5
unnamed: R28.1, U$23.P$4, X11.3
unnamed: R14.1, U$9.P$4, X11.2
unnamed: R18.1, U$10.P$4, X1.2
unnamed: R19.1, U$11.P$4, X1.3
unnamed: AD5272#2.5, C32.1
unnamed: 3,3µH1.2, C49.1, U$14.21, U$14.24
unnamed: 3,3µH1.1, C50.1, U$14.5, U$14.8
unnamed: R11.2, U$14.17
unnamed: C49.2, U$14.26
unnamed: R17.1, U$14.13
unnamed: C52.1, R17.2
unnamed: C50.2, U$14.3
unnamed: LED_R1.A, R35.2
unnamed: LED_R2.A, R57.2
unnamed: U$59.12, VR-FB.2
unnamed: LED_G1.C, R100.2
unnamed: LED_G2.C, R27.2
unnamed: C41.2, U$59.3
unnamed: 3,3µH.2, C40.1, U$59.21, U$59.24
unnamed: 3,3µH.1, C41.1, U$59.5, U$59.8
unnamed: R69.1, U$59.13
unnamed: C44.1, R69.2
unnamed: C46.1, R66.1
unnamed: R68.2, U$59.17
unnamed: C40.2, U$59.26
unnamed: C28.1, INA219#1.1, R73.2
unnamed: C29.1, INA219#2.1, R76.2
unnamed: C29.2, INA219#2.2, R77.2
unnamed: PWR1.C, R82.2
unnamed: IC2.41, R81.1
unnamed: AD5272#2.1, C53.1, C56.1, C57.1, LED_G2.A, U$14.11, U$14.15, U$14.16
unnamed: C45.1, LED_G1.A, U$59.11, U$59.16
NRST: R1.1, U1.7, U$12.P$11
NRST1: IC2.7, R79.2, U$15.P$11
PGOOD1: IC2.19, LED_R2.C, U$59.10
PGOOD2: IC2.18, LED_R1.C, U$14.10
RUN: OPA.P$4, VR-RUN.2
RX-S: U1.52, U$12.P$4
RX-S1: IC2.31, U$15.P$4
SCL: LIS3MDL-GY.P$4, LSM6DS3-GY.P$4, R25.2, U1.29
SCL1: AD5272#2.9, IC2.21, INA219#1.5, INA219#2.5, R101.2
SCL-TM: BSK1.5, U1.61
SCLTM: IC2.45, JP1.13
SDA: LIS3MDL-GY.P$3, LSM6DS3-GY.P$3, R26.2, U1.30
SDA1: AD5272#2.8, IC2.22, INA219#1.6, INA219#2.6, R102.2
SDA-TM: BSK1.7, U1.62
SDATM: IC2.46, JP1.14
SINS-KVCC: BSK3.6, R30.1
SS1: R28.2, U1.15, U$23.P$1
SS2: R4.2, U1.20, U$1.P$1
SS3: R5.2, U1.21, U$2.P$1
SS4: R6.2, U1.10, U$3.P$1
SS5: R9.2, U1.26, U$4.P$1
SS6: R12.2, U1.27, U$5.P$1
SS7: R13.2, U1.8, U$7.P$1
SS8: R14.2, U1.9, U$9.P$1
SS9: R18.2, U1.24, U$10.P$1
SS10: R19.2, U1.25, U$11.P$1
SWC: R3.1, U1.49, U$12.P$10
SWC1: IC2.37, R36.2, U$15.P$10
SWD: R2.1, U1.46, U$12.P$8
SWD1: IC2.34, R64.2, U$15.P$8
TIME: IC2.42, JP1.15
TIME-ES: BSK1.8, U1.22
TIME-G: GPS.P$1, U1.14, U1.23, U1.59
TX-S: U1.51, U$12.P$6
TX-S1: IC2.30, U$15.P$6
Y: INVERT.P$4, R57.1, U$59.18
