cansat-tsniimash/can-cube-sat-2022/schematics/board/BSK2+BSK4.brd

## EAGLE design schematics/board/BSK2+BSK4.brd (2021-04-13)

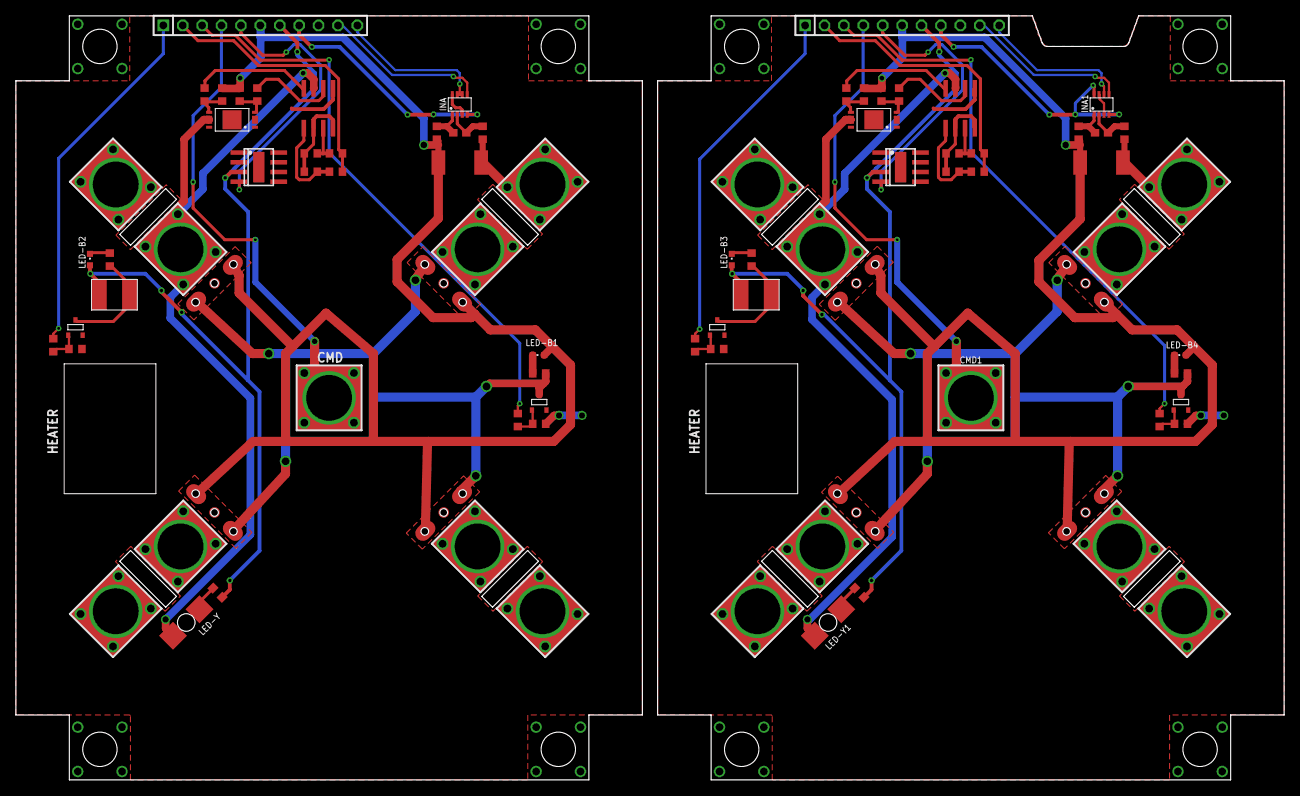
[picture p64: board BSK2+BSK4.brd from above]

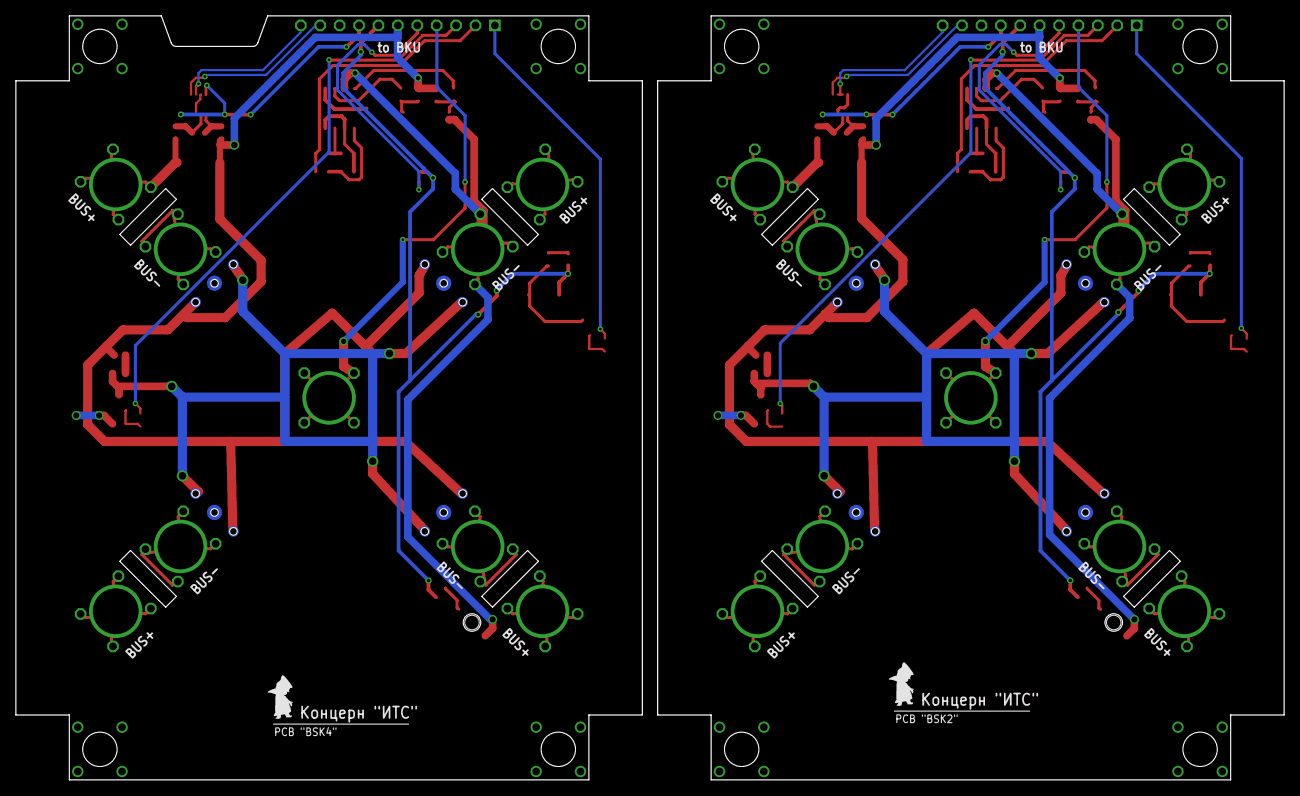
[picture p65: board BSK2+BSK4.brd from below]

Board: 2 copper layers, 166.0 x 100.0 mm, 88 parts (2 on the bottom side), 68 nets.

Parts:
BKU, BKU1: 1X11
C1, C41: 0,1µ; C0603
CMD, CMD1: KCONNECTQUAD; KCONNECT_QUAD
DS18B20Z1, DS18B20Z2: DS18B20Z; SOIC8+HEAT_S
INA, INA1: INA219AID; SOT23-8
LED-B1, LED-B2, LED-B3, LED-B4: CHIPLED_0603
LED-Y, LED-Y1: LAP4-BOTTOM; P47F-BOTTOM
MOCD: MOCD; SOIC8
R1, R2, R27, R28: 2k26; R0603
R3, R5, R9, R15, R16, R29, R30, R32: 100R; R0603
R4, R7, R19, R20: 2k; R0603
R6, R12, R17, R18: 100k; R0603
R8, R14, R21, R23: 1M; R0603
R10, R11, R94, R95: 200k; R0603
R13, R22: 3k3; R0603
R24, R75: R01; R2512
R25, R26, R76, R77: 10R; R0603
U$1, U$2, U$3, U$4, U$5, U$9, U$10, U$11, U$12, U$18, U$19, U$20, U$21, U$22, U$23, U$24: KCONNECT
U$6, U$7, U$15, U$16, U$31, U$32, U$33, U$34: GRAFITGRAFIT4_2; GRAFIT4_2
U$8, U$13, U$28, U$30: SI2302CDS; SOT23-3
U$14, U$29: EM_HEAT
U$17: PCB "BSK2"; ITS-LOGO
U$25, U$26: FS8205A+
U$27: MOCD; SOIC8
U$35: PCB "BSK4"; ITS-LOGO

Connections:
1: R7.2, U$8.3, U$14.2
1W: BKU.5, DS18B20Z1.4
1W1: BKU1.5, DS18B20Z2.4
2: R13.2, U$6.P$1, U$6.P$4, U$7.P$1, U$7.P$4, U$13.3, U$15.P$1, U$15.P$4, U$16.P$1, U$16.P$4
3: R20.2, U$28.3, U$29.2
3V1: BKU1.8, INA1.4, INA1.8
3V3: BKU.8, INA.4
4: R22.2, U$30.3, U$31.P$1, U$31.P$4, U$32.P$1, U$32.P$4, U$33.P$1, U$33.P$4, U$34.P$1, U$34.P$4
5V: BKU.7, DS18B20Z1.3, LED-B2.A, R4.1, U$14.1
5V1: BKU1.7, DS18B20Z2.3, LED-B3.A, R19.1, U$29.1
B2-CMD: BKU.4, CMD.1, CMD.2, CMD.3, CMD.4, CMD.P$1, CMD.P$2
B2-KHEAT: BKU.1, R32.2
B2-KVCC: BKU.2, R1.2, R2.2
B2-ROZE: BKU.3, R3.2
B4-CMD: BKU1.4, CMD1.1, CMD1.2, CMD1.3, CMD1.4, CMD1.P$1, CMD1.P$2
B4-KHEAT: BKU1.1, R29.2
B4-KVCC: BKU1.2, R27.2, R28.2
B4-ROZE: BKU1.3, R30.2
BUS+: BKU.6, LED-B1.A, R6.1, R12.2, R75.2, R76.1, U$6.P$2, U$6.P$5, U$7.P$2, U$7.P$5, U$15.P$2, U$15.P$5, U$16.P$2, U$16.P$5
BUS+1: BKU1.6, LED-B4.A, R17.1, R18.2, R24.2, R25.1, U$31.P$2, U$31.P$5, U$32.P$2, U$32.P$5, U$33.P$2, U$33.P$5, U$34.P$2, U$34.P$5
GND: BKU.9, DS18B20Z1.5, DS18B20Z1.HEAT, INA.3, INA.8, MOCD.2, MOCD.4, MOCD.5, R8.2, R14.2, R94.1, R95.1, U$8.2, U$13.2, U$26.23, U$26.HEAT
GND4: BKU1.9, DS18B20Z2.5, DS18B20Z2.HEAT, INA1.3, INA1.7, R10.1, R11.1, R21.2, R23.2, U$25.23, U$25.HEAT, U$27.2, U$27.4, U$27.5, U$28.2, U$30.2
unnamed: MOCD.1, R1.1, R94.2
unnamed: MOCD.3, R2.1, R95.2
unnamed: R8.1, R32.1, U$8.1
unnamed: R3.1, R14.1, U$13.1
unnamed: R16.1, R17.2, U$25.5
unnamed: R15.1, R18.1, U$25.4
unnamed: LED-Y1.A, R19.2
unnamed: LED-B3.C, R20.1
unnamed: LED-B4.C, R22.1
unnamed: R5.1, R6.2, U$26.5
unnamed: R9.1, R12.1, U$26.4
unnamed: LED-Y.A, R4.2
unnamed: LED-B1.C, R13.1
unnamed: LED-B2.C, R7.1
unnamed: C1.1, INA1.1, R25.2
unnamed: C1.2, INA1.2, R26.2
unnamed: R10.2, R27.1, U$27.1
unnamed: R11.2, R28.1, U$27.3
unnamed: R21.1, R29.1, U$28.1
unnamed: R23.1, R30.1, U$30.1
unnamed: C41.1, INA.1, R76.2
unnamed: C41.2, INA.2, R77.2
OC1: MOCD.6, R9.2
OC2: R15.2, U$27.6
OD1: MOCD.8, R5.2
OD2: R16.2, U$27.8
SCL-TM: BKU.10, INA.5
SCL-TM1: BKU1.10, INA1.5
SDA-TM: BKU.11, INA.6, INA.7
SDA-TM1: BKU1.11, INA1.6
SP+: R75.1, R77.1, U$3.1, U$3.2, U$3.3, U$3.4, U$3.P$1, U$3.P$2
SP+1: U$1.1, U$1.2, U$1.3, U$1.4, U$1.P$1, U$1.P$2
SP+2: U$9.1, U$9.2, U$9.3, U$9.4, U$9.P$1, U$9.P$2
SP+3: U$11.1, U$11.2, U$11.3, U$11.4, U$11.P$1, U$11.P$2
SP+4: U$5.1, U$5.2, U$5.3, U$5.4, U$5.P$1, U$5.P$2
SP+5: U$24.1, U$24.2, U$24.3, U$24.4, U$24.P$1, U$24.P$2
SP+6: U$19.1, U$19.2, U$19.3, U$19.4, U$19.P$1, U$19.P$2
SP+7: R24.1, R26.1, U$22.1, U$22.2, U$22.3, U$22.4, U$22.P$1, U$22.P$2
SP-: LED-Y.C, MOCD.7, U$2.1, U$2.2, U$2.3, U$2.4, U$2.P$1, U$2.P$2, U$26.67
SP-1: U$4.1, U$4.2, U$4.3, U$4.4, U$4.P$1, U$4.P$2
SP-2: U$10.1, U$10.2, U$10.3, U$10.4, U$10.P$1, U$10.P$2
SP-3: U$12.1, U$12.2, U$12.3, U$12.4, U$12.P$1, U$12.P$2
SP-4: U$23.1, U$23.2, U$23.3, U$23.4, U$23.P$1, U$23.P$2
SP-5: U$18.1, U$18.2, U$18.3, U$18.4, U$18.P$1, U$18.P$2
SP-6: U$20.1, U$20.2, U$20.3, U$20.4, U$20.P$1, U$20.P$2
SP-7: LED-Y1.C, U$21.1, U$21.2, U$21.3, U$21.4, U$21.P$1, U$21.P$2, U$25.67, U$27.7
