cansat-tsniimash/can-cube-sat-2022/schematics/board/BSK1+BSK3+PL.brd

## EAGLE design schematics/board/BSK1+BSK3+PL.brd (2021-04-13)

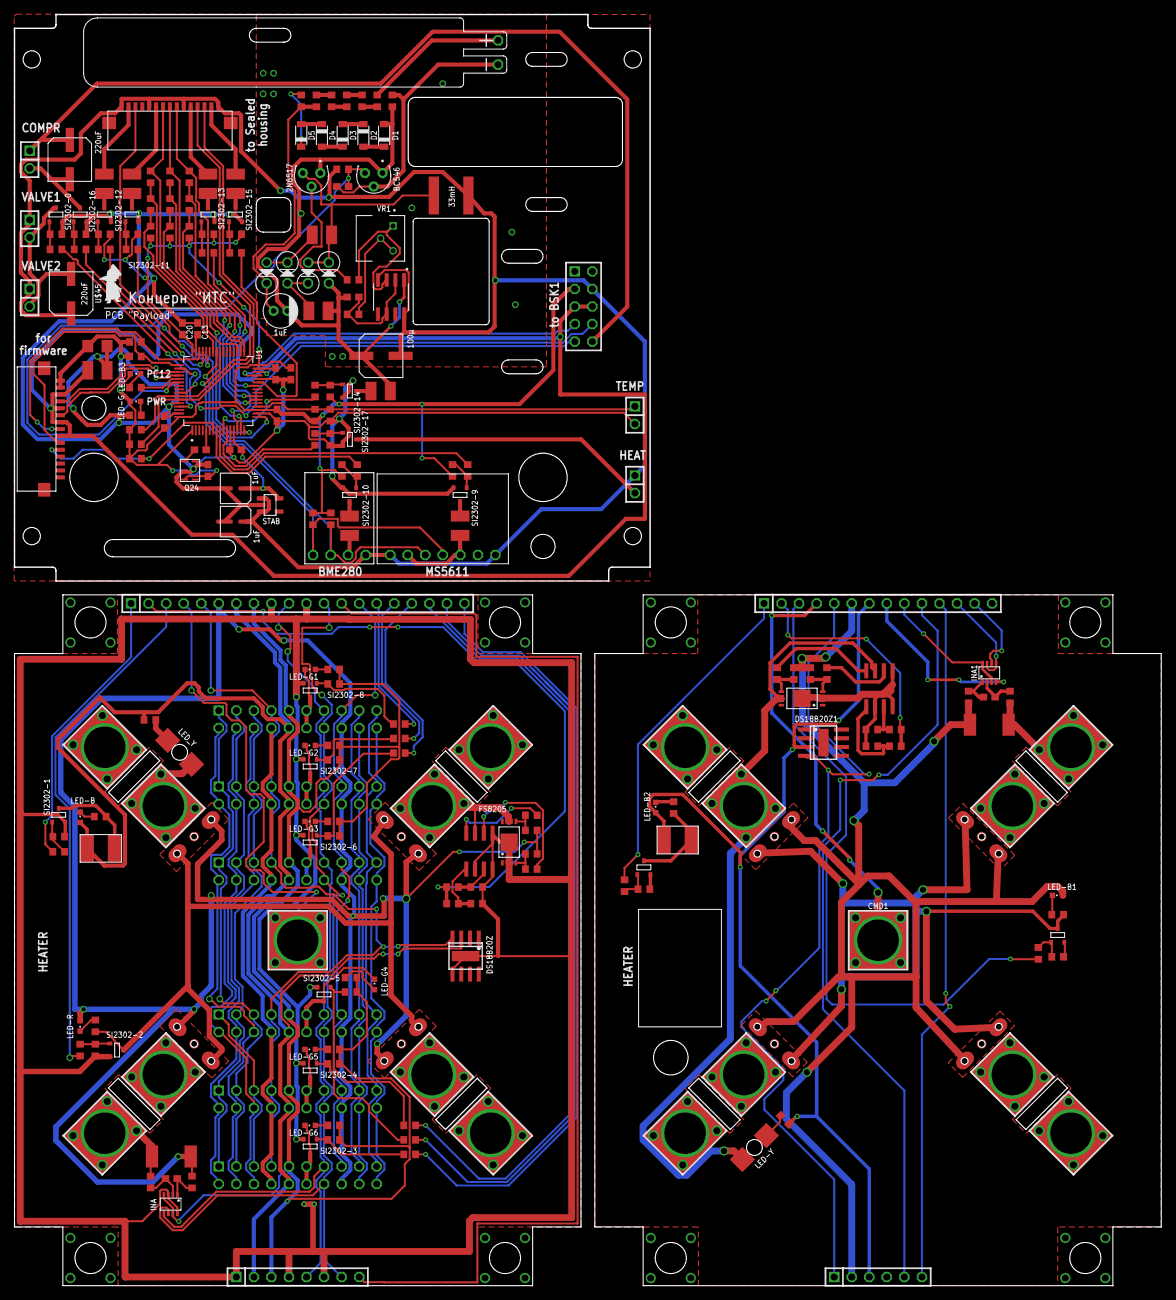
[picture p66: board BSK1+BSK3+PL.brd from above]

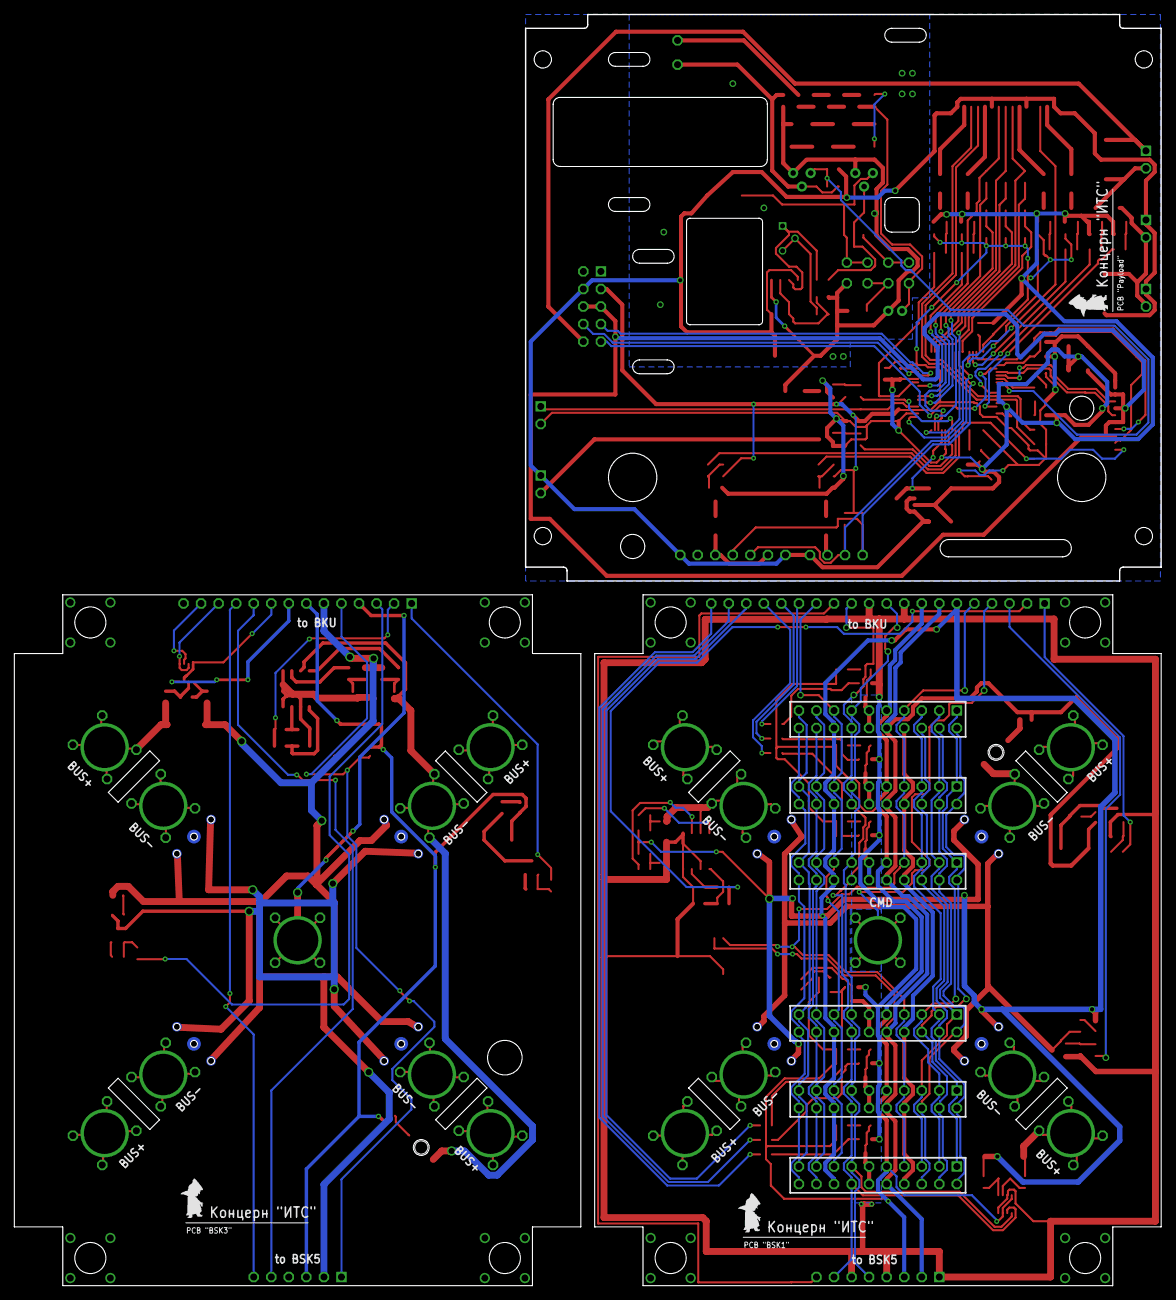
[picture p67: board BSK1+BSK3+PL.brd from below]

Board: 2 copper layers, 166.0 x 184.0 mm, 246 parts (9 on the bottom side), 200 nets.

Parts:
2N6517: DS1820; TO92/TO226
BC546: DS1820; TO92/TO226
BKU: 1X20
BKU1: 1X14
BME280: BME280BME280-PINS-ONLY; BME280-PINS-ONLY
BSK1: 1X06
BSK2: 2X05
BSK5: 1X08
C1, C41: 0,1µ; C0603
C2, C3, C4, C6, C18, C20: 100nF; C0603
C5, C7: 22nF; C1210
C8: 1nF; C0603
C9, C13: 2,2µ; C0603
C10: 10nF; C0603
C11: 100pF; C0603
C12, C14: 1uF; ECAP-SMD-D4
C19: 10µ; C1206
CMD, CMD1: KCONNECTQUAD; KCONNECT_QUAD
COMPR: 1X02
D1, D2, D3, D4, D5: DIODE-MBR; SOD123
DS18B20Z, DS18B20Z1: DS18B20Z; SOIC8+HEAT_S
FS8205: FS8205A+
HEAT: 1X02
INA, INA1: INA219AID; SOT23-8
JP1, JP2, JP3, JP4, JP5, JP6: 2X10
LED-B, LED-B1, LED-B2, LED-B3: CHIPLED_0603
LED-G, LED-G1, LED-G2, LED-G3, LED-G4, LED-G5, LED-G6: CHIPLED_0603
LED-R: CHIPLED_0603
LED-Y: LAP4-BOTTOM; P47F-BOTTOM
LED_Y: LAP4-BOTTOM; P47F-BOTTOM
MS5611: MS5611MS5611-PIN-ONLY; MS5611-PINS-ONLY
Q24: Q24
R1, R2, R94, R95: 200k; R0603
R3, R5, R26, R27, R28, R29, R30, R31, R32, R33, R34, R35, R48, R49, R59, R61, R64, R66, R69, R72, R101, R104, R106, R108: 100R; R0603
R4, R7, R36, R37, R87: 100k; R0603
R6, R8, R9, R12, R13, R14, R18, R20, R40, R42, R58, R60, R63, R65, R68, R71, R82, R83, R84, R85, R86, R100, R103, R105, R107: 1M; R0603
R10, R11, R15, R16, R17, R21, R22, R23, R38, R39, R51, R54: 2k; R0603
R19, R88: 3k3; R0603
R24, R25, R46, R47: 2k26; R0603
R41: 1k5; R0603
R43, R75: R01; R2512
R44, R45, R76, R77: 10R; R0603
R50, R52, R53, R89, R90, R91, R92, R93, R96, R97, R98, R99: 10k; R0603
R55, R56, R111, R112: 5k1; R0603
R57, R62, R67, R70, R73, R74, R102: 0.05A; R1210
R78: 0.5A; R1210
R79: 1k; R0603
R80: 4k7; R0603
R81, R110: 22k; R0603
R109: 124k; R0603
SI2302-0, SI2302-1, SI2302-2, SI2302-3, SI2302-4, SI2302-5, SI2302-6, SI2302-7, SI2302-8, SI2302-9, SI2302-10, SI2302-11, SI2302-12, SI2302-13, SI2302-14, SI2302-15, SI2302-16, SI2302-17: SI2302CDS; SOT23-3
STAB: ADP150AUJZ-3.3-R7; SOT23-5
TEMP: 1X02
U1: STM32F405RGT6; QFP50P1200X1200X160-64N
U2: LMC555; SOIC127P599X175-8N
U$1, U$2, U$3, U$4, U$5, U$6, U$7, U$8, U$9, U$10, U$11, U$12, U$18, U$19, U$20, U$21: KCONNECT
U$13: FS8205A+
U$14, U$22: MOCD; SOIC8
U$15, U$17: SI2302CDS; SOT23-3
U$16, U$24: EM_HEAT
U$23, U$25, U$27, U$28, U$29, U$30, U$31, U$32: GRAFITGRAFIT4_2; GRAFIT4_2
U$26: PCB "BSK1"; ITS-LOGO
U$33: PCB "BSK3"; ITS-LOGO
U$34: 100µ; ECAP100-CMD
U$35, U$36, U$37, U$38: BA159
U$39: 1uF; ECAP1MK
U$40: DOSIM
U$41, U$43: FFC-CONNECT68611; 68611
U$42: 33mH; RCH114NP
U$44, U$45: 220uF; ECAP220-CMD
U$46, U$47: PCB "Payload"; ITS-LOGO
VALVE1, VALVE2: 1X02
VR1: 3362H-1-502LF; TRIM_3362H-1-502LF

Connections:
1: R39.2, U$15.3, U$16.2
1W: BKU.5, DS18B20Z.4, JP1.7, JP2.7, JP3.7, JP4.7, JP5.7, JP6.7
1W1: BKU1.5, BSK1.1, DS18B20Z1.4
2: R41.2, U$17.3, U$23.P$1, U$23.P$4, U$25.P$1, U$25.P$4, U$31.P$1, U$31.P$4, U$32.P$1, U$32.P$4
3: R11.2, SI2302-1.3, U$24.2
3V1: BKU1.8, INA1.4
3V2: BSK2.3, C2.2, C6.2, C10.2, C18.2, C19.2, C20.2, LED-B3.A, LED-G.A, Q24.P$4, R50.2, R52.2, R53.2, R55.1, R56.1, R58.2, R60.2, R63.2, R65.2, R68.2, R71.2, R97.2, R98.2, R99.2, R100.2, R110.2, R111.1, R112.1, U1.1, U1.19, U1.32, U1.48, U1.64, U$43.P$1, U$43.P$2
3V3: BKU.8, BSK5.3, INA.4, INA.7, JP1.9, JP2.9, JP3.9, JP4.9, JP5.9, JP6.9, R6.1, R8.2, R9.1, R12.1, R13.2, R14.1, R15.1, R16.1, R17.1, R21.1, R22.1, R23.1
4: R19.2, SI2302-2.3, U$27.P$1, U$27.P$4, U$28.P$1, U$28.P$4, U$29.P$1, U$29.P$4, U$30.P$1, U$30.P$4
4OXV: R66.1, U1.45
5V: BKU.7, BSK5.2, DS18B20Z.3, JP1.10, JP2.10, JP3.10, JP4.10, JP5.10, JP6.10, LED-B.A, R10.1, U$24.1
5V1: BKU1.7, BSK1.3, DS18B20Z1.3, LED-B2.A, R38.1, U$16.1
5V2: BME280.P$1, BSK2.4, C14.P+, HEAT.1, MS5611.P$1, MS5611.P$7, R88.1, STAB.P$1, STAB.P$3, U2.4, U2.8, U$34.P$2, U$41.P$1, U$41.P$5, U$41.P$10, U$41.P$15, U$42.P$1, U$45.P$1, VALVE1.1, VALVE2.1
B1-CMD: BKU.4, CMD.1, CMD.2, CMD.3, CMD.4, CMD.P$1, CMD.P$2
B1-KHEAT: BKU.1, R32.2
B1-KVCC: BKU.2, R24.2, R25.2
B1-ROZE: BKU.3, R33.2
B3-CMD: BKU1.4, CMD1.1, CMD1.2, CMD1.3, CMD1.4, CMD1.P$1, CMD1.P$2
B3-KHEAT: BKU1.1, R48.2
B3-KVCC: BKU1.2, R46.2, R47.2
B3-ROZE: BKU1.3, R49.2
B5-KHEAT: BKU1.10, BSK1.5
BME280-EXT: R61.1, U1.8
BME280-INT: R101.1, U1.27
BMS1: JP1.1, JP2.1, JP3.1, JP4.5, JP5.3, JP6.3
BMS2: JP1.2, JP2.2, JP3.2, JP4.6, JP5.4, JP6.4
BMS3: JP1.3, JP2.3, JP3.3, JP4.1, JP5.5, JP6.5
BMS4: JP1.4, JP2.4, JP3.4, JP4.2, JP5.6, JP6.6
BMS5: JP1.5, JP2.5, JP3.5, JP4.3, JP5.1, JP6.1
BMS6: JP1.6, JP2.6, JP3.6, JP4.4, JP5.2, JP6.2
BMS+: JP1.8, JP2.8, JP3.8, JP4.8, JP5.8, JP6.8
BUS+: BKU.6, JP1.16, JP2.16, JP3.16, JP4.16, JP5.16, JP6.16, LED-R.A, R4.1, R7.2, R75.2, R76.1, U$27.P$2, U$27.P$5, U$28.P$2, U$28.P$5, U$29.P$2, U$29.P$5, U$30.P$2, U$30.P$5
BUS+1: BKU1.6, BSK1.2, LED-B1.A, R36.1, R37.2, R43.2, R44.1, U$23.P$2, U$23.P$5, U$25.P$2, U$25.P$5, U$31.P$2, U$31.P$5, U$32.P$2, U$32.P$5
BUS+2: BSK2.10, COMPR.1, U$44.P$1
CO: R91.1, U1.16, U$41.P$7
COMPR: R106.1, U1.57
CTRL-CO-1: R91.2, R96.1, U1.35
CTRL-CO-2: R96.2, R97.1, U1.42
CTRL-NH3-1: R90.2, R93.1, U1.33
CTRL-NH3-2: R93.2, R98.1, U1.34
CTRL-NO2-1: R89.2, R92.1, U1.23
CTRL-NO2-2: R92.2, R99.1, U1.22
DOS-G: 2N6517.1, BC546.1, C4.1, C7.2, D1.A, R73.1, R87.2, U2.1, U$34.P$1, U$35.P$1, U$39.P$2
DOSE: BC546.3, C11.2, R88.2, U1.54
DOSIM: R72.1, U1.10
G-4OXV: R67.1, U$41.P$2
G-BME: R102.1, U$41.P$14
G-MICS: R74.1, U$41.P$6
G-MS: R70.1, U$41.P$11
GND: BKU.9, BKU.11, BSK5.1, BSK5.4, BSK5.6, DS18B20Z.5, DS18B20Z.HEAT, FS8205.23, FS8205.HEAT, INA.3, INA.8, R1.1, R2.1, R18.2, R20.2, SI2302-1.2, SI2302-2.2, SI2302-3.2, SI2302-4.2, SI2302-5.2, SI2302-6.2, SI2302-7.2, SI2302-8.2, U$22.2, U$22.4, U$22.5
GND4: BKU1.9, BKU1.14, BSK1.4, DS18B20Z1.5, DS18B20Z1.HEAT, INA1.3, INA1.8, R40.2, R42.2, R94.1, R95.1, U$13.23, U$13.HEAT, U$14.2, U$14.4, U$14.5, U$15.2, U$17.2
GND9: C2.1, C3.2, C6.1, C9.1, C10.1, C12.P-, C13.1, C14.P-, C18.1, C19.1, C20.1, Q24.P$2, R54.1, R78.1, R103.2, R105.2, R107.2, R109.1, SI2302-0.2, SI2302-9.2, SI2302-10.2, SI2302-11.2, SI2302-12.2, SI2302-13.2, SI2302-14.2, SI2302-15.2, SI2302-16.2, SI2302-17.2, STAB.P$2, TEMP.2, U1.12, U1.18, U1.28, U1.60, U1.63
GND-4OXV: R67.2, SI2302-12.3
GND-BME-EXT: R62.2, SI2302-10.3
GND-BME-INT: R102.2, SI2302-15.3
GND-COMPR: COMPR.2, SI2302-16.3, U$44.P$2
GND-DOSIM: R73.2, SI2302-14.3
GND-HEAT: HEAT.2, SI2302-17.3
GND-MICS: R74.2, SI2302-11.3
GND-MS-EXT: R57.2, SI2302-9.3
GND-MS-INT: R70.2, SI2302-13.3
GND-OUT: BSK2.5, BSK2.6, R78.2, U$43.P$3, U$43.P$5, U$43.P$7, U$43.P$9
GND-VALVE: SI2302-0.3, U$45.P$2, VALVE1.2, VALVE2.2
HEAT: R108.1, U1.11
MICS: R64.1, U1.44
MS5611-EXT: R59.1, U1.9
MS5611-INT: R69.1, U1.26
unnamed: FS8205.5, R4.2, R5.1
unnamed: LED-B.C, R11.1
unnamed: LED-R.C, R19.1
unnamed: LED-G1.A, R16.2
unnamed: LED-G3.A, R17.2
unnamed: LED-G4.A, R21.2
unnamed: LED-G5.A, R22.2
unnamed: LED-G6.A, R23.2
unnamed: R1.2, R24.1, U$22.1
unnamed: R2.2, R25.1, U$22.3
unnamed: FS8205.4, R3.1, R7.1
unnamed: LED_Y.A, R10.2
unnamed: R13.1, R26.1, SI2302-4.1
unnamed: R9.2, R27.1, SI2302-6.1
unnamed: R6.2, R28.1, SI2302-8.1
unnamed: R14.2, R31.1, SI2302-3.1
unnamed: R35.1, R36.2, U$13.5
unnamed: R8.1, R29.1, SI2302-7.1
unnamed: R12.2, R30.1, SI2302-5.1
unnamed: R18.1, R32.1, SI2302-1.1
unnamed: R20.1, R33.1, SI2302-2.1
unnamed: LED-G2.A, R15.2
unnamed: R34.1, R37.1, U$13.4
unnamed: LED-Y.A, R38.2
unnamed: LED-B2.C, R39.1
unnamed: LED-B1.C, R41.1
unnamed: C1.1, INA1.1, R44.2
unnamed: C1.2, INA1.2, R45.2
unnamed: R46.1, R94.2, U$14.1
unnamed: R47.1, R95.2, U$14.3
unnamed: R40.1, R48.1, U$15.1
unnamed: R42.1, R49.1, U$17.1
unnamed: R51.1, U1.53
unnamed: C13.2, U1.47
unnamed: C9.2, U1.31
unnamed: C8.1, U1.5
unnamed: LED-B3.C, R51.2
unnamed: C8.2, Q24.P$3
unnamed: R58.1, R59.2, SI2302-9.1
unnamed: MS5611.P$3, MS5611.P$6, R57.1
unnamed: R60.1, R61.2, SI2302-10.1
unnamed: BME280.P$2, R62.1
unnamed: R63.1, R64.2, SI2302-11.1
unnamed: R65.1, R66.2, SI2302-12.1
unnamed: R68.1, R69.2, SI2302-13.1
unnamed: R71.1, R72.2, SI2302-14.1
unnamed: C4.2, R79.1, U2.2, U2.6
unnamed: R79.2, VR1.2, VR1.3
unnamed: R80.2, U2.3, VR1.1
unnamed: 2N6517.2, R80.1
unnamed: 2N6517.3, C5.1, U$35.P$2, U$36.P$1, U$42.P$2
unnamed: C7.1, U$36.P$2, U$37.P$1
unnamed: C5.2, U$37.P$2, U$38.P$1
unnamed: R81.2, R82.2, U$38.P$2, U$39.P$1
unnamed: D1.C, D2.A
unnamed: D2.C, D3.A
unnamed: D3.C, D4.A
unnamed: D4.C, D5.A
unnamed: D5.C, R81.1
unnamed: R82.1, R83.1
unnamed: R83.2, R84.2
unnamed: R84.1, R85.1
unnamed: R85.2, R86.2
unnamed: R86.1, U$40.P$1
unnamed: BC546.2, C11.1, R87.1, U$40.P$2
unnamed: R100.1, R101.2, SI2302-15.1
unnamed: R103.1, R104.2, SI2302-0.1
unnamed: R105.1, R106.2, SI2302-16.1
unnamed: R107.1, R108.2, SI2302-17.1
unnamed: C3.1, C12.P+, STAB.P$5, U1.13
unnamed: LED-G.C, R54.2
unnamed: C41.1, INA.1, R76.2
unnamed: C41.2, INA.2, R77.2
NH3: R90.1, U1.15, U$41.P$8
NO2: R89.1, U1.14, U$41.P$9
NRST: R50.1, U1.7, U$43.P$11
O2: U1.17, U$41.P$3
OC1: R34.2, U$14.6
OC2: R3.2, U$22.6
OD1: R35.2, U$14.8
OD2: R5.2, U$22.8
PL1: JP1.17, JP2.17, JP3.17, JP4.17, JP5.17, JP6.17
PL1-GND: JP1.11, JP1.12, LED-G1.C, SI2302-8.3
PL1-KVCC: BKU.15, R28.2
PL2: JP1.18, JP2.18, JP3.18, JP4.18, JP5.18, JP6.18
PL2-GND: JP2.11, JP2.12, LED-G2.C, SI2302-7.3
PL2-KVCC: BKU.16, R29.2
PL3: JP1.19, JP2.19, JP3.19, JP4.19, JP5.19, JP6.19
PL3-GND: JP3.11, JP3.12, LED-G3.C, SI2302-6.3
PL3-KVCC: BKU.17, R27.2
PL4: JP1.20, JP2.20, JP3.20, JP4.20, JP5.20, JP6.20
PL4-GND: JP4.11, JP4.12, LED-G4.C, SI2302-5.3
PL4-KVCC: BKU.18, R30.2
PL5-GND: JP5.11, JP5.12, LED-G5.C, SI2302-4.3
PL5-KVCC: BKU.19, R26.2
PL6-GND: JP6.11, JP6.12, LED-G6.C, SI2302-3.3
PL6-KVCC: BKU.20, R31.2
RX-S: U1.52, U$43.P$4
SCL-TM: BKU.10, BSK5.5, INA.5, JP1.13, JP2.13, JP3.13, JP4.13, JP5.13, JP6.13
SCL-TM1: BKU1.12, INA1.5, INA1.7
SCL-TM2: BSK2.7, U1.29
SDA-TM: BKU.12, BSK5.7, INA.6, JP1.14, JP2.14, JP3.14, JP4.14, JP5.14, JP6.14
SDA-TM1: BKU1.13, INA1.6
SDA-TM2: BSK2.8, U1.30
SENS-EXT-SCL: BME280.P$3, MS5611.P$5, R112.2, U1.41
SENS-EXT-SDA: BME280.P$4, MS5611.P$4, R111.2, U1.40
SENS-INT-SCL: R55.2, U1.58, U$41.P$12
SENS-INT-SDA: R56.2, U1.59, U$41.P$13
SINS-KVCC: BKU1.11, BSK1.6
SP+: U$20.1, U$20.2, U$20.3, U$20.4, U$20.P$1, U$20.P$2
SP+1: U$1.1, U$1.2, U$1.3, U$1.4, U$1.P$1, U$1.P$2
SP+2: U$3.1, U$3.2, U$3.3, U$3.4, U$3.P$1, U$3.P$2
SP+3: R75.1, R77.1, U$18.1, U$18.2, U$18.3, U$18.4, U$18.P$1, U$18.P$2
SP+4: U$5.1, U$5.2, U$5.3, U$5.4, U$5.P$1, U$5.P$2
SP+5: U$6.1, U$6.2, U$6.3, U$6.4, U$6.P$1, U$6.P$2
SP+6: U$9.1, U$9.2, U$9.3, U$9.4, U$9.P$1, U$9.P$2
SP+7: R43.1, R45.1, U$11.1, U$11.2, U$11.3, U$11.4, U$11.P$1, U$11.P$2
SP-: LED_Y.C, U$2.1, U$2.2, U$2.3, U$2.4, U$2.P$1, U$2.P$2
SP-1: FS8205.67, U$4.1, U$4.2, U$4.3, U$4.4, U$4.P$1, U$4.P$2, U$22.7
SP-2: U$19.1, U$19.2, U$19.3, U$19.4, U$19.P$1, U$19.P$2
SP-3: U$21.1, U$21.2, U$21.3, U$21.4, U$21.P$1, U$21.P$2
SP-4: U$12.1, U$12.2, U$12.3, U$12.4, U$12.P$1, U$12.P$2
SP-5: U$7.1, U$7.2, U$7.3, U$7.4, U$7.P$1, U$7.P$2
SP-6: U$10.1, U$10.2, U$10.3, U$10.4, U$10.P$1, U$10.P$2
SP-7: LED-Y.C, U$8.1, U$8.2, U$8.3, U$8.4, U$8.P$1, U$8.P$2, U$13.67, U$14.7
SWC: R53.1, U1.49, U$43.P$10
SWD: R52.1, U1.46, U$43.P$8
TEMP: R109.2, R110.1, TEMP.1, U1.20
TIME: BKU.14, JP1.15, JP2.15, JP3.15, JP4.15, JP5.15, JP6.15
TIME1: BSK2.9, U1.50
TIME-ES: BKU.13, BSK5.8
TX-S: U1.51, U$43.P$6
VALVE: R104.1, U1.61
