cansat-tsniimash/can-cube-sat-2022/schematics/board/AB+DC-DC.brd

## EAGLE design schematics/board/AB+DC-DC.brd (2020-12-30)

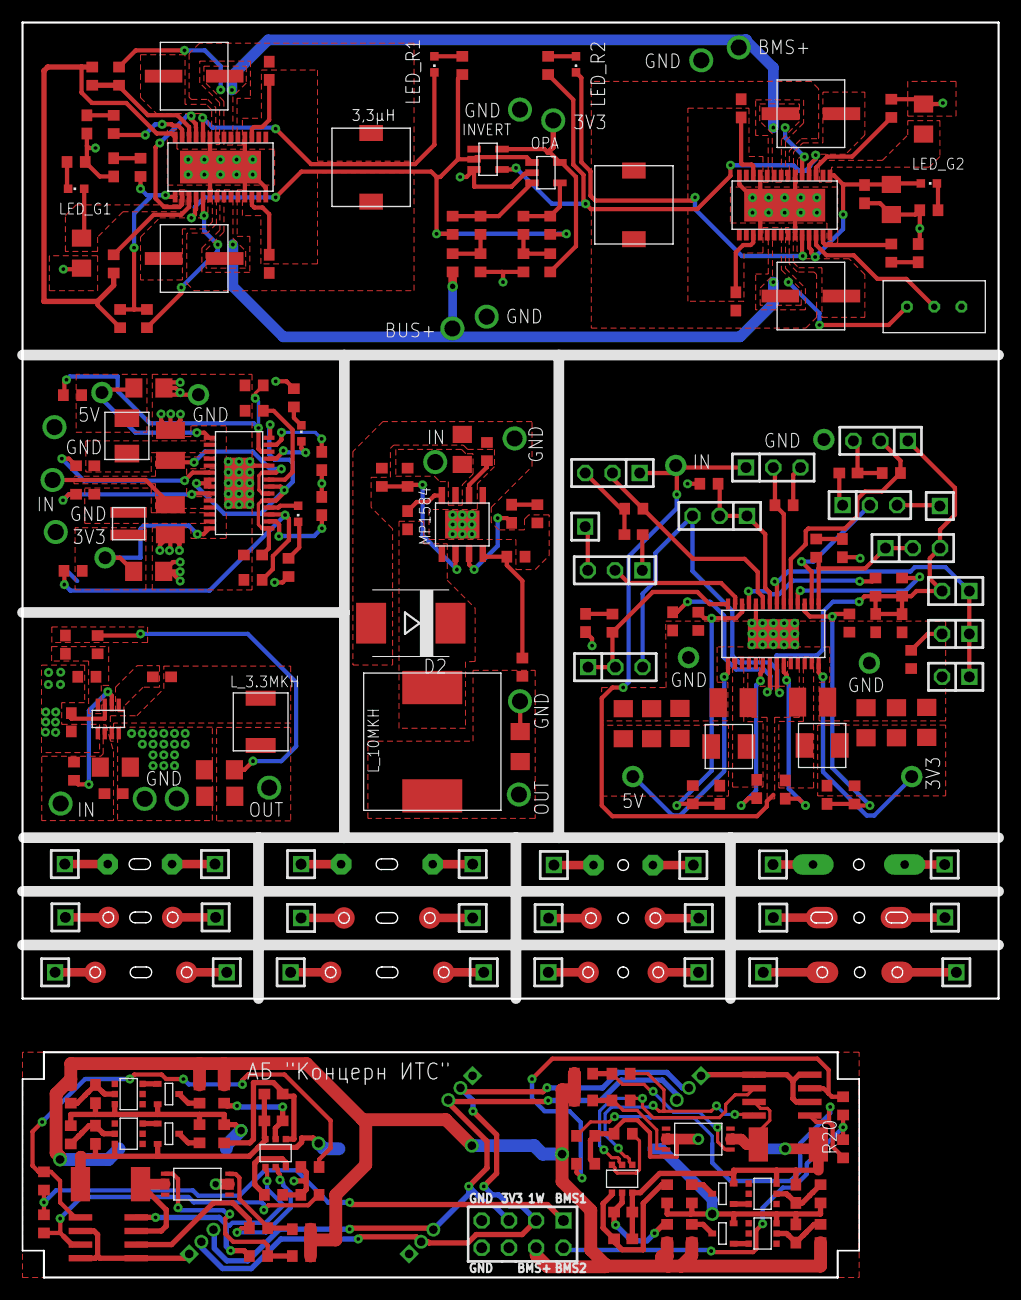
[picture p68: board AB+DC-DC.brd from above]

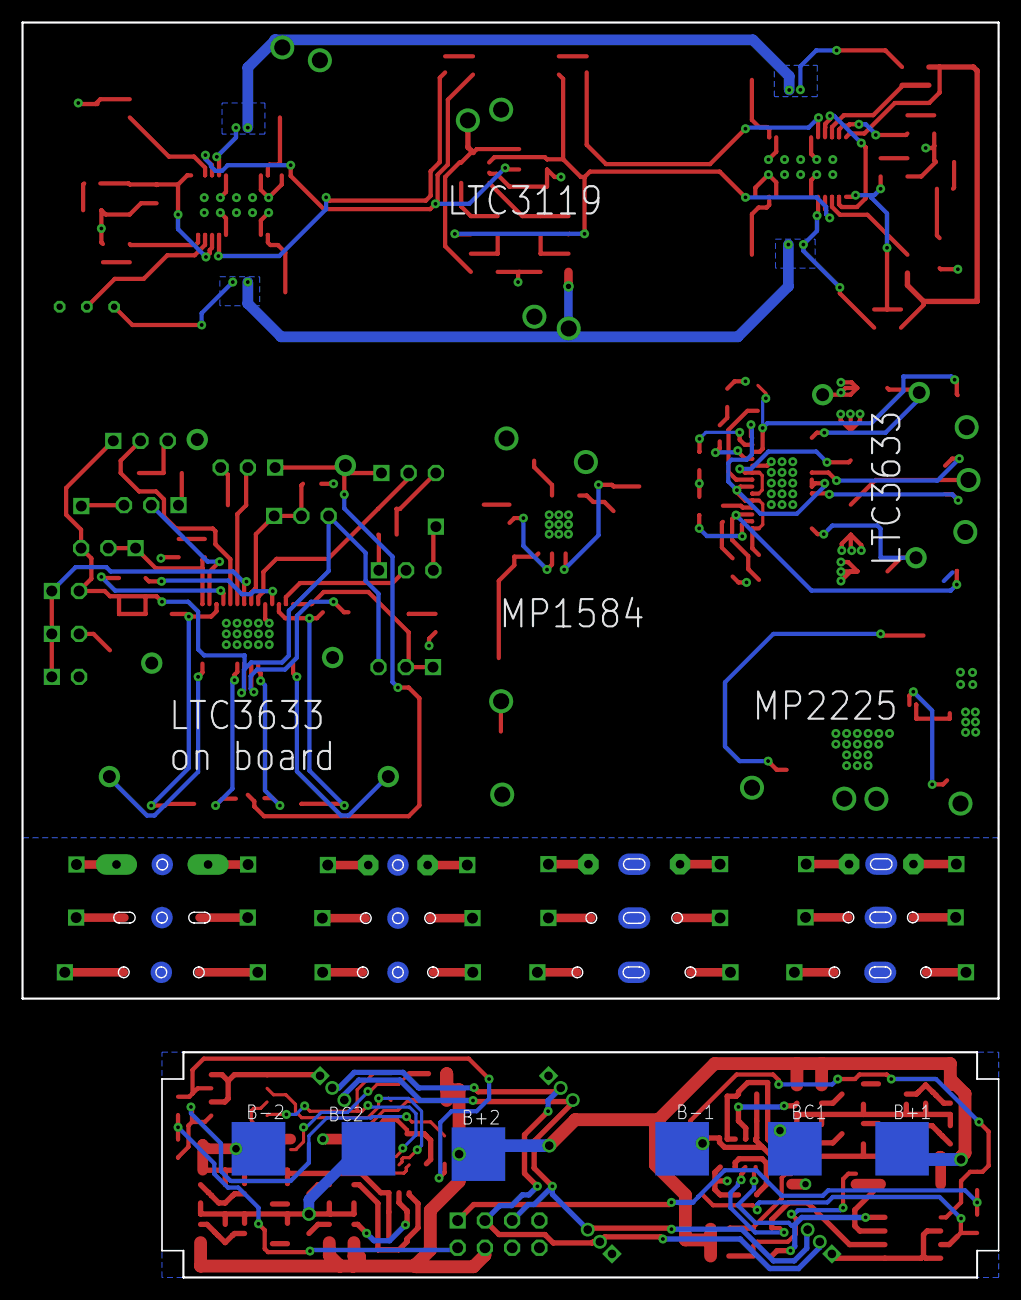
[picture p69: board AB+DC-DC.brd from below]

Board: 2 copper layers, 91.0 x 117.0 mm, 242 parts (6 on the bottom side), 164 nets.

Parts:
3,3µH: 3,3µ; B82472G6
3,3µH1: 3,3µH; B82472G6
AB1: 2X04
B+1, B+2: BATTERY
B-1, B-2: BATTERY
BC1, BC2: BATTERY
C1, C2, C3, C4, C5, C6, C8, C11, C12, C18, C25, C26, C27, C28, C33, C34, C48, C49, C55, C56, C61: 0,1µ; C0603
C7, C9, C13, C15, C20, C21, C38, C39, C40, C41: 22µ; C1206
C10, C42, C43, C62: 10µ; C1206
C14: 2,2µ; C0603
C16, C17, C46, C47: 47µ; C1210
C19: 33p; C0603
C22, C23, C36: 220p; C0603
C24, C30, C31: 1µ; C0603
C29, C32, C44, C45: 4.7nF; C0603
C35, C37: 10p; C0603
C50, C57: 680p; C0603
C51, C58: 4.7µ; C1206
C52: 3,3n; C0603
C53, C59: 150µ; ECAP150
C54, C60: 220µ; ECAP220
D2: SMC
DS18B20, DS18B20A, DS18B20B, DS18B20C: CONNECT1X3
INVERT: INVERTER; SOT23-5
JP1, JP2, JP3: 1X02
JP4, JP5, JP6, JP7, JP8, JP9, JP10, JP11: 1X03
JP12, JP13, JP14, JP15, JP16, JP17, JP18, JP19, JP20, JP21, JP22, JP23, JP24, JP25, JP26, JP27, JP28, JP29, JP30, JP31, JP32, JP33, JP34, JP35, JP36, JP37: 1X01
LED1, LED2: CHIPLED_0603
LED_G1, LED_G2: CHIPLED_0603
LED_R1, LED_R2: CHIPLED_0603
OPA: OPA333; SOT23-5
R1, R26, R31, R49, R60, R61, R62, R100: 2k; R0603
R2, R3, R50, R51: 330R; R0603
R4, R5, R6, R7, R9, R10, R15, R16, R52, R53, R54, R55: 100R; R0603
R8, R56: R05; R2512
R11, R12, R17, R18, R30, R34, R42, R43: 100k; R0603
R13, R14, R19, R20: 2k26; R0603
R21: 73,2k; R0603
R22: 45,3k; R0603
R23, R24, R37, R66, R74, R76: 10k; R0603
R25: 162k; R0603
R27, R94, R95, R98, R99: 200k; R0603
R28, R36: 40k2; R0603
R29: 124k; R0603
R32: 24k9; R0603
R33: 68k1; R0603
R35: 8k87; R0603
R38, R40: 13k; R0603
R39: 324k; R0603
R41, R44, R45, R65: 1M; R0603
R46: 11k5; R0603
R47: 18k7; R0603
R48, R57: 84k5; R0603
R58, R59, R67, R68, R69, R75, R77: 150k; R0603
R63: 910k; R0603
R64: 330k; R0603
R70: 24k3; R0603
R71, R73: 51k; R0603
R72: 232k; R0603
U$1, U$26: FS8205A-
U$2, U$10: MOCD217M; SOIC8
U$3, U$45: HY2120; SOT23-6
U$4, U$5, U$46, U$47: HY2213"; SOT23-6
U$6, U$7, U$48, U$49: SI2302CDS; SOT23-3
U$8, U$16: LTC3633+VIA
U$9: MP1584+VIA
U$11: 1µH; VLS3012HBX
U$12: SPM4020
U$13: L_10MKH; L_12X12
U$14: MP2225; TSOT23-8
U$15: L_3.3MKH; L_SPM5020
U$17, U$18: L_2.2MKH; L_SPM4020
U$19: GRAFITGRAFIT1; GRAFIT1
U$20: GRAFITGRAFIT1_1; GRAFIT1_1
U$21: GRAFITGRAFIT1_2; GRAFIT1_2
U$22: GRAFITGRAFIT2; GRAFIT2
U$23: GRAFITGRAFIT2_1; GRAFIT2_1
U$24: GRAFITGRAFIT2_2; GRAFIT2_2
U$25: GRAFITGRAFIT3; GRAFIT3
U$27: GRAFITGRAFIT3_1; GRAFIT3_1
U$28: GRAFITGRAFIT3_2; GRAFIT3_2
U$29: GRAFITGRAFIT4; GRAFIT4
U$30: GRAFITGRAFIT4_1; GRAFIT4_1
U$31: GRAFITGRAFIT4_2; GRAFIT4_2
U$32, U$59: LTC31191; LTC3119+VIA
U$33: 32961; 3296W

Connections:
1.65: R71.2, R73.1, R74.2
1W: AB1.3, DS18B20.2, DS18B20A.2, DS18B20B.2, DS18B20C.2
3.3: INVERT.P$5, OPA.P$5, R73.2
3V1: C9.1, R29.1, U$13.P$1
3V3: AB1.5, DS18B20.3, DS18B20A.3, DS18B20B.3, DS18B20C.3
5V: C15.1, R21.2, U$8.15, U$12.P$2
90: R65.1, R66.2, R67.2, U$59.15
A: INVERT.P$2, OPA.P$1, R61.1, R75.2, R77.2, U$59.18
B-1: B-1.P$1, C1.2, C2.2, C4.2, R8.2, U$3.6, U$5.3, U$7.2
B-2: B-2.P$1, C25.2, C26.2, C28.2, R56.2, U$45.6, U$47.3, U$49.2
BC1: BC1.P$1, C3.2, R3.2, R5.2, R7.2, U$4.3, U$6.2
BC2: BC2.P$1, C27.2, R51.2, R53.2, R55.2, U$46.3, U$48.2
BMS1: AB1.1, R13.2, R14.2
BMS2: AB1.2, R19.2, R20.2
BMS+: AB1.4, B+1.P$1, B+2.P$1, R2.2, R4.2, R6.2, R11.1, R12.2, R17.1, R18.2, R50.2, R52.2, R54.2
BUS+: C16.1, C17.1, U$8.6, U$8.9, U$8.18, U$8.19, U$8.24, U$8.25
FB1: C37.1, R47.1, R57.2, U$16.3
FB2: C35.1, R46.1, R48.2, U$16.12
GND: AB1.7, AB1.8, DS18B20.1, DS18B20A.1, DS18B20B.1, DS18B20C.1, R1.1, R49.1, R94.1, R95.1, R98.1, R99.1, U$1.23, U$2.2, U$2.4, U$2.5, U$10.2, U$10.4, U$10.5, U$26.23
GND1: C7.2, C9.2, C10.1, C12.1, C13.1, C14.1, C15.2, C16.2, C17.2, C18.1, C20.1, C21.1, C22.1, C23.1, C24.1, C29.1, C30.1, C31.1, C32.1, C38.1, C39.1, C40.1, C41.1, C42.1, C43.1, C44.1, C45.1, C46.1, C47.1, C50.2, C51.2, C52.2, C53.P$2, C54.P$2, C57.2, C58.2, C59.P$2, C60.P$2, C61.2, C62.2, D2.A, INVERT.P$3, JP3.2, JP7.3, JP9.3, JP10.3, OPA.P$2, R23.2, R24.2, R25.2, R26.1, R27.1, R28.2, R31.1, R32.2, R33.2, R35.2, R37.2, R39.2, R41.2, R44.2, R45.2, R46.2, R47.2, R58.1, R60.1, R64.2, R67.1, R68.1, R70.2, R71.1, R100.1, U$8.10, U$8.HEAT, U$8.P$1, U$8.P$2, U$8.P$3, U$8.P$4, U$8.P$5, U$8.P$6, U$8.P$7, U$8.P$8, U$8.P$9, U$8.P$10, U$8.P$11, U$8.P$12, U$8.P$13, U$8.P$14, U$8.P$15, U$9.P$5, U$9.P$9, U$9.P$10, U$9.P$11, U$9.P$12, U$9.P$13, U$9.P$14, U$9.P$15, U$9.P$16, U$9.P$17, U$9.P$18, U$14.P$1, U$14.P$4, U$16.10, U$16.HEAT, U$16.P$1, U$16.P$2, U$16.P$3, U$16.P$4, U$16.P$5, U$16.P$6, U$16.P$7, U$16.P$8, U$16.P$9, U$16.P$10, U$16.P$11, U$16.P$12, U$16.P$13, U$16.P$14, U$16.P$15, U$32.4, U$32.9, U$32.14, U$32.20, U$32.25, U$32.28, U$32.29, U$32.P$1, U$32.P$2, U$32.P$3, U$32.P$4, U$32.P$5, U$32.P$6, U$32.P$7, U$32.P$8, U$32.P$9, U$32.P$10, U$33.P$1, U$59.4, U$59.9, U$59.14, U$59.20, U$59.25, U$59.28, U$59.29, U$59.P$1, U$59.P$2, U$59.P$3, U$59.P$4, U$59.P$5, U$59.P$6, U$59.P$7, U$59.P$8, U$59.P$9, U$59.P$10
INA_BMS+: C53.P$1, C60.P$1, R72.2, U$32.19, U$32.22, U$32.23, U$59.6, U$59.7
INA_BUS+: C54.P$1, C59.P$1, R63.1, R65.2, U$32.6, U$32.7, U$33.P$3, U$59.19, U$59.22, U$59.23
INTVCC: C30.2, C31.2, JP1.2, JP4.3, JP5.3, JP6.3, JP10.1, R42.2, R43.2, U$16.22
unnamed: R10.1, R11.2, U$26.5
unnamed: R9.1, R12.1, U$26.4
unnamed: R20.1, R98.2, U$10.1
unnamed: C1.1, R2.1, U$3.5
unnamed: R49.2, U$45.3
unnamed: C3.1, R6.1, U$4.2
unnamed: U$4.6, U$6.1
unnamed: C4.1, R7.1, U$5.2
unnamed: U$5.6, U$7.1
unnamed: R16.1, R17.2, U$1.5
unnamed: R4.1, U$6.3
unnamed: R5.1, U$7.3
unnamed: R1.2, U$3.3
unnamed: R15.1, R18.1, U$1.4
unnamed: C2.1, R3.1, U$3.4
unnamed: R25.1, U$8.8
unnamed: R14.1, R94.2, U$2.1
unnamed: R13.1, R95.2, U$2.3
unnamed: R19.1, R99.2, U$10.3
unnamed: LED1.C, R31.2
unnamed: LED2.C, R26.2
unnamed: LED2.A, U$8.11
unnamed: C8.2, U$9.P$8
unnamed: C14.2, U$8.1, U$8.5, U$8.7, U$8.14, U$8.21, U$8.22
unnamed: R22.1, R23.1, U$8.3
unnamed: C8.1, D2.C, U$9.P$1, U$13.P$2
unnamed: R27.2, U$9.P$6
unnamed: C6.1, U$8.26, U$8.27, U$11.P$1
unnamed: R28.1, R29.2, U$9.P$4
unnamed: R30.1, R32.1, U$9.P$2
unnamed: C6.2, U$8.23
unnamed: C5.1, U$8.20
unnamed: C5.2, U$8.16, U$8.17, U$12.P$1
unnamed: C10.2, R30.2, U$9.P$7
unnamed: C36.1, R33.1
unnamed: C36.2, U$9.P$3
unnamed: C11.2, U$14.P$5
unnamed: C11.1, U$14.P$3, U$15.P$2
unnamed: R21.1, R24.1, U$8.12
unnamed: C12.2, U$14.P$7
unnamed: R34.2, U$14.P$6
unnamed: C13.2, C18.2, R34.1, U$14.P$2
unnamed: C19.2, R35.1, R36.1, U$14.P$8
unnamed: C19.1, C20.2, C21.2, R36.2, U$15.P$1
unnamed: JP1.1, JP2.1, JP3.1, U$16.7
unnamed: JP2.2, R37.1
unnamed: LED1.A, U$8.4
unnamed: JP4.1, JP4.2, R38.2, U$16.14
unnamed: C22.2, R38.1
unnamed: JP5.1, JP5.2, R39.1, U$16.8
unnamed: JP6.1, JP6.2, R40.2, U$16.1
unnamed: C23.2, R40.1
unnamed: C24.2, U$16.21
unnamed: C33.1, U$16.16, U$16.17, U$17.P$2
unnamed: C34.1, U$16.26, U$16.27, U$18.P$2
unnamed: JP7.2, R41.1, U$16.9
unnamed: R42.1, U$16.11
unnamed: JP8.2, U$16.13
unnamed: R43.1, U$16.4
unnamed: JP9.2, R44.1, U$16.6
unnamed: C29.2, JP8.1
unnamed: JP10.2, R45.1, U$16.5
unnamed: JP11.2, U$16.2
unnamed: C32.2, JP11.1
unnamed: C33.2, U$16.20
unnamed: C34.2, U$16.23
unnamed: JP8.3, JP13.1
unnamed: JP11.3, JP12.1
unnamed: C44.2, U$8.2
unnamed: C45.2, U$8.13
unnamed: R52.1, U$48.3
unnamed: JP14.1, U$22.P$1
unnamed: JP15.1, U$23.P$1
unnamed: JP16.1, U$24.P$1
unnamed: JP17.1, U$22.P$2
unnamed: JP18.1, U$23.P$2
unnamed: JP19.1, U$24.P$2
unnamed: JP20.1, U$25.P$1
unnamed: JP21.1, U$27.P$1
unnamed: JP22.1, U$28.P$1
unnamed: JP23.1, U$25.P$2
unnamed: JP24.1, U$27.P$2
unnamed: JP25.1, U$28.P$2
unnamed: JP26.1, U$29.P$1
unnamed: R53.1, U$49.3
unnamed: JP27.1, U$30.P$1
unnamed: JP28.1, U$31.P$1
unnamed: JP29.1, U$29.P$2
unnamed: JP30.1, U$30.P$2
unnamed: JP31.1, U$31.P$2
unnamed: JP32.1, U$19.P$1
unnamed: JP33.1, U$20.P$1
unnamed: JP34.1, U$21.P$1
unnamed: JP35.1, U$19.P$2
unnamed: JP36.1, U$20.P$2
unnamed: JP37.1, U$21.P$2
unnamed: C25.1, R50.1, U$45.5
unnamed: R70.1, R72.1, U$59.12
unnamed: C27.1, R54.1, U$46.2
unnamed: U$46.6, U$48.1
unnamed: 3,3µH1.2, C55.1, U$32.21, U$32.24
unnamed: U$47.6, U$49.1
unnamed: 3,3µH1.1, C56.1, U$32.5, U$32.8
unnamed: R58.2, U$32.17
unnamed: C55.2, U$32.26
unnamed: R59.1, U$32.13
unnamed: C26.1, R51.1, U$45.4
unnamed: C28.1, R55.1, U$47.2
unnamed: C56.2, U$32.3
unnamed: U$32.12, U$33.P$2
unnamed: C57.1, R59.2
unnamed: LED_G1.C, R100.2
unnamed: LED_G2.C, R60.2
unnamed: OPA.P$3, R76.1, R77.1
unnamed: LED_R1.A, R61.2
unnamed: LED_R2.A, R62.2
unnamed: C49.2, U$59.3
unnamed: 3,3µH.2, C48.1, U$59.21, U$59.24
unnamed: 3,3µH.1, C49.1, U$59.5, U$59.8
unnamed: R69.1, U$59.13
unnamed: C50.1, R69.2
unnamed: C52.1, R66.1
unnamed: R68.2, U$59.17
unnamed: C48.2, U$59.26
unnamed: C58.1, C61.1, C62.1, LED_G2.A, U$32.11, U$32.15, U$32.16
unnamed: C51.1, LED_G1.A, U$59.11, U$59.16
unnamed: OPA.P$4, R74.1, R75.1
NO_GND1: R8.1, U$2.7, U$26.67
NO_GND2: R56.1, U$1.67, U$10.7
OC1: R9.2, U$2.6, U$3.2
OC2: R15.2, U$10.6, U$45.2
OD1: R10.2, U$2.8, U$3.1
OD2: R16.2, U$10.8, U$45.1
PGOOD1: LED_R1.C, U$59.10
PGOOD2: LED_R2.C, U$32.10
RUN: R63.2, R64.1, R76.2
VDD: C7.1, R22.2, U$8.28, U$11.P$2
VIN: C46.2, C47.2, JP7.1, JP9.1, U$16.18, U$16.19, U$16.24, U$16.25
VON1: C37.2, C40.2, C41.2, C43.2, R57.1, U$16.28, U$18.P$1
VON2: C35.2, C38.2, C39.2, C42.2, R48.1, U$16.15, U$17.P$1
Y: INVERT.P$4, R62.1, U$32.18
