cansat-tsniimash/can-cube-sat-2022/src/board/PAYLOAD/PAYLOAD.ioc

Mcu.UserName=STM32F405RGTx
PA0-WKUP.Signal=ADCx_IN0
PA1.Signal=ADCx_IN1
PA11.GPIO_Label=MICS_PWR
PA11.Signal=GPIO_Output
PA12.GPIO_Label=O2_PWR
PA12.Signal=GPIO_Output
PA13.Signal=SYS_JTMS-SWDIO
PA14.Signal=SYS_JTCK-SWCLK
PA15.GPIO_Label=PPS_Input
PA15.Signal=GPXTI15
PA2.Signal=ADCx_IN2
PA3.Signal=ADCx_IN3
PA4.Signal=ADCx_IN4
PA6.GPIO_Label=SENS_CTRL_NO2_2
PA6.Signal=GPIO_Output
PA7.GPIO_Label=SENS_CTRL_NO2_1
PA7.Signal=GPIO_Output
PA8.Signal=I2C3_SCL
PA9.GPIO_Label=SENS_CTRL_CO_2
PA9.Signal=GPIO_Output
PB0.GPIO_Label=MS_INT_PWR
PB0.Signal=GPIO_Output
PB1.GPIO_Label=BME_INT_PWR
PB1.Signal=GPIO_Output
PB10.Signal=I2C2_SCL
PB11.Signal=I2C2_SDA
PB12.GPIO_Label=SENS_CTRL_NH3_1
PB12.Signal=GPIO_Output
PB13.GPIO_Label=SENS_CTRL_NH3_2
PB13.Signal=GPIO_Output
PB14.GPIO_Label=SENS_CTRL_CO_1
PB14.Signal=GPIO_Output
PB5.GPIO_Label=VALVE_ON
PB5.Signal=GPIO_Output
PB6.Signal=I2C1_SCL
PB7.Signal=I2C1_SDA
PB8.GPIO_Label=COMPR_ON
PB8.Signal=GPIO_Output
PC0.GPIO_Label=BME_EXT_PWR
PC0.Signal=GPIO_Output
PC1.GPIO_Label=MS_EXT_PWR
PC1.Signal=GPIO_Output
PC10.Signal=UART4_TX
PC11.Signal=UART4_RX
PC12.GPIO_Label=LED_Pin
PC12.Signal=GPIO_Output
PC2.GPIO_Label=DOSIM_PWR
PC2.Signal=GPIO_Output
PC3.GPIO_Label=HEATER_PWR
PC3.Signal=GPIO_Output
PC6.Signal=USART6_TX
PC7.Signal=USART6_RX
PC8.GPIO_Label=PPS_Input_debug
PC8.Signal=GPXTI8
PC9.Signal=I2C3_SDA
PD2.Signal=S_TIM3_ETR
PH0-OSC_IN.Signal=RCC_OSC_IN
PH1-OSC_OUT.Signal=RCC_OSC_OUT
