cansat-tsniimash/can-cube-sat-2022/src/board/PAYLOAD/Core/Src/main.c

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
/* Includes ------------------------------------------------------------------*/
#include "main.h"

/* USER CODE BEGIN Includes */
#include "app_main.h"
#include "osc_config.h"
/* USER CODE END Includes */

ADC_HandleTypeDef hadc1;

I2C_HandleTypeDef hi2c1;
I2C_HandleTypeDef hi2c3;
DMA_HandleTypeDef hdma_i2c1_tx;
DMA_HandleTypeDef hdma_i2c1_rx;
DMA_HandleTypeDef hdma_i2c3_tx;
DMA_HandleTypeDef hdma_i2c3_rx;

IWDG_HandleTypeDef hiwdg;

TIM_HandleTypeDef htim3;
TIM_HandleTypeDef htim4;

UART_HandleTypeDef huart4;
UART_HandleTypeDef huart6;

void SystemClock_Config(void);
static void MX_GPIO_Init(void);
static void MX_DMA_Init(void);
static void MX_I2C1_Init(void);
static void MX_ADC1_Init(void);
static void MX_I2C2_Init(void);
static void MX_TIM3_Init(void);
static void MX_UART4_Init(void);
static void MX_I2C3_Init(void);
static void MX_IWDG_Init(void);
static void MX_RTC_Init(void);
static void MX_TIM4_Init(void);
static void MX_USART6_UART_Init(void);
/**
  * @brief  The application entry point.
  * @retval int
  */
int main(void)
{
  /* MCU Configuration--------------------------------------------------------*/

  /* Reset of all peripherals, Initializes the Flash interface and the Systick. */
  HAL_Init();

  /* USER CODE BEGIN Init */

    int error = HSE_SystemClock_Config();
    if (1 == error)
    {
  	  error = 0;
  	  error = HSI_SystemClock_Config();
  	  if (1 == error)
  		  HAL_NVIC_SystemReset();
    }

#ifdef CUBE_CLOCK_CONFIG
  /* USER CODE END Init */

  /* Configure the system clock */
  SystemClock_Config();

  /* USER CODE BEGIN SysInit */
#endif
  /* USER CODE END SysInit */

  /* Initialize all configured peripherals */
  MX_GPIO_Init();
  MX_DMA_Init();
  MX_I2C1_Init();
  MX_ADC1_Init();
  MX_I2C2_Init();
  MX_TIM3_Init();
  MX_UART4_Init();
  MX_I2C3_Init();
  MX_IWDG_Init();
  MX_RTC_Init();
  MX_TIM4_Init();
  MX_USART6_UART_Init();
  /* USER CODE BEGIN 2 */

  app_main();

  /* USER CODE END 2 */

  /* Infinite loop */
  /* USER CODE BEGIN WHILE */
  while (1)
  {

    /* USER CODE END WHILE */

    /* USER CODE BEGIN 3 */
  }
  /* USER CODE END 3 */
}

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
