cansat-tsniimash/can-cube-sat-2022/src/board/ARK/Core/Inc/main.h

#define BATTERY_PACK_COUNT 2
#define BATTERY_COUNT_IN_PACK 2
#define BMS5_Pin GPIO_PIN_13
#define BMS5_GPIO_Port GPIOC
#define BMS6_Pin GPIO_PIN_14
#define BMS6_GPIO_Port GPIOC
#define BMS3_Pin GPIO_PIN_15
#define BMS3_GPIO_Port GPIOC
#define BMS4_Pin GPIO_PIN_0
#define BMS4_GPIO_Port GPIOA
#define BMS1_Pin GPIO_PIN_1
#define BMS1_GPIO_Port GPIOA
#define BMS2_Pin GPIO_PIN_2
#define BMS2_GPIO_Port GPIOA
#define TIME_Pin GPIO_PIN_3
#define TIME_GPIO_Port GPIOA
#define TIME_EXTI_IRQn EXTI3_IRQn
#define OW_Pin GPIO_PIN_4
#define OW_GPIO_Port GPIOA
#define ROZE1_Pin GPIO_PIN_5
#define ROZE1_GPIO_Port GPIOA
#define ROZE2_Pin GPIO_PIN_6
#define ROZE2_GPIO_Port GPIOA
#define ROZE3_Pin GPIO_PIN_7
#define ROZE3_GPIO_Port GPIOA
#define ROZE4_Pin GPIO_PIN_0
#define ROZE4_GPIO_Port GPIOB
#define SCL_Pin GPIO_PIN_10
#define SCL_GPIO_Port GPIOB
#define SDA_Pin GPIO_PIN_11
#define SDA_GPIO_Port GPIOB
#define LED_Pin GPIO_PIN_12
#define LED_GPIO_Port GPIOB
#define INT_C_Pin GPIO_PIN_13
#define INT_C_GPIO_Port GPIOB
#define INT_C_EXTI_IRQn EXTI15_10_IRQn
#define PGB_C_Pin GPIO_PIN_14
#define PGB_C_GPIO_Port GPIOB
#define PGB_C_EXTI_IRQn EXTI15_10_IRQn
#define PGS_C_Pin GPIO_PIN_15
#define PGS_C_GPIO_Port GPIOB
#define PGS_C_EXTI_IRQn EXTI15_10_IRQn
#define PFI_C_Pin GPIO_PIN_8
#define PFI_C_GPIO_Port GPIOA
#define PFI_C_EXTI_IRQn EXTI9_5_IRQn
#define DC_DC_Pin GPIO_PIN_15
#define DC_DC_GPIO_Port GPIOA
#define PFI_D_Pin GPIO_PIN_4
#define PFI_D_GPIO_Port GPIOB
#define PFI_D_EXTI_IRQn EXTI4_IRQn
#define INT_D_Pin GPIO_PIN_5
#define INT_D_GPIO_Port GPIOB
#define INT_D_EXTI_IRQn EXTI9_5_IRQn
#define PGB_D_Pin GPIO_PIN_6
#define PGB_D_GPIO_Port GPIOB
#define PGB_D_EXTI_IRQn EXTI9_5_IRQn
#define PGS_D_Pin GPIO_PIN_7
#define PGS_D_GPIO_Port GPIOB
#define PGS_D_EXTI_IRQn EXTI9_5_IRQn
#define SCLTM_Pin GPIO_PIN_8
#define SCLTM_GPIO_Port GPIOB
#define SDATM_Pin GPIO_PIN_9
#define SDATM_GPIO_Port GPIOB
