cansat-tsniimash/can-cube-sat-2022/src/research/ccsds-even-better/main.c

#include <stdio.h>
#include <time.h>
#include <ctype.h>

#include "ccsds/uslp/uslp.h"

#define MIN(a, b) ((a) < (b) ? (a) : (b))

void print_byte_arr(const uint8_t* arr, size_t size) {
    for (size_t i = 0; i < size; i++) {
        printf("%02X ", arr[i]);
    }
}

void print_bit_byte(uint8_t val) {
    for (int i = 0; i < 8; i++) {
        printf("%d", val & 1);
        val >>= 1;
    }
}

void print_bit_byte_arr(const uint8_t* arr, size_t size) {
    for (size_t i = 0; i < size; i++) {
        print_bit_byte(arr[i]);
        printf(" ");
    }
}

void print_printable(const uint8_t* arr, size_t size) {
    for (size_t i = 0; i < size; i++) {
        printf("%c", isprint(arr[i]) ? (char)arr[i] : '.');
    }
}

void map_cb(void* arg, const uint8_t* data, size_t size) {
    epp_packet_t packet = {0};
    if (epp_extract_packet(&packet, (uint8_t*)data, size)) {
        printf("DEAD\n");
        return;
    }
    print_byte_arr(packet.data, packet.size);
    printf(" | ");
    print_printable(packet.data, packet.size);
    printf("\n");
    //printf("%d %d %d %d %d\n", packet.header.ccsds_defined_field, packet.header.epp_id, packet.header.epp_id_ex, packet.header.lol);
}


int main() {
    printf("Hello world\n");

    map_t map = {0};
    vc_t vc = {0};
    mc_t mc = {0};
    pc_t pc = {0};
    sap_t sap = {0};
    uslp_core_t uslp = {0};
    sep_t sep = {0};

    map_config_t map_config = {0};
    map_config.map_id = 13;
    map_config.tfdz_capacity = 10;
    map_config.map_type = MAP_TYPE_PACKET;

    vc_config_t vc_config = {0};
    vc_config.vc_id = 45;
    vc_config.cop_type = COP_NONE;
    vc_config.tfdz_max_size = 10;
    vc_config.cop_queue_count = 1;
    vc_config.ex_frame_count_length = 2;
    vc_config.sc_frame_count_length = 3;
    
    mc_config_t mc_config = {0};
    mc_config.sc_id = 8347;
    mc_config.sc_id_is_destination = false;
    mc_config.ocf_is_used = false;
    
    pc_config_t pc_config = {0};
    pc_config.tfvn = 12;
    pc_config.is_fec_presented = false;
    pc_config.insert_size = 0;

    sap_config_t sap_config = {0};
    sap_config.service = SERVICE_MAPP;
    sap_config.data_capacity = 200;


    uslp_init(&uslp, malloc, free);
    pc_init(&uslp, &pc, &pc_config);
    mc_init(&uslp, &mc, &pc, &mc_config);
    vc_init(&uslp, &vc, &mc, &vc_config);
    map_init(&uslp, &map, &vc, &map_config);
    sap_init(&uslp, &sap, &map, &sap_config);
    sep_init(&uslp, &sep, &pc);

//////////////////////////// Принимающая сторона
    sap_receive_t sapr = {0};
    vc_receive_t vcr = {0};

    sap_receive_config_t sapr_config = {0};
    sapr_config.demx_entry_count = 1;
    sapr_config.insert_size = 0;
    sapr_config.is_fec_presented = false;
    sapr_config.tfvn = 12;

    vc_receive_config_t vcr_config = {0};
    vcr_config.cop_type = COP_NONE;
    vcr_config.map_cb = map_cb;
    vcr_config.map_cb_arg = 0;
    vcr_config.map_id = 13;
    vcr_config.pvn = PVN_EP;
    vcr_config.upid = UPID_SP_OR_EP;
    vcr_config.vc_id = 45;
    vcr_config.sc_id = 8347;
    vcr_config.sc_is_destination = false;
    vcr_config.sapr = &sapr;

    sap_receive_init(&uslp, &sapr, &sapr_config);
    vc_receive_init(&uslp, &vcr, &vcr_config);



    uint8_t data[] = "Hello World! What a beautiful day outside! Birds are singing, flowers are flowering...";
    //sap_send(&sap, data, sizeof(data));
    size_t end_size = 0;
    size_t data_index = 0;
#define Period 1 //ms
    time_t prev = time(0) - Period;
    const size_t packet_size = 3;
    while (data_index < sizeof(data)) {
        epp_packet_t epp_packet = {0};
        epp_packet.data = data + data_index;
        epp_packet.header.pvn = PVN_EP;
        epp_packet.header.epp_id = EPP_ID_USER_DEFINED;
        epp_packet.header.lol = epp_calc_min_lol_packet(map_config.tfdz_capacity);
        epp_packet.size = MIN(packet_size - (1 << epp_packet.header.lol), sizeof(data) - data_index);
        epp_packet.header.packet_length = epp_packet.size + (1 << epp_packet.header.lol);
        sap_epp_send(&sap, &epp_packet);

        data_index += epp_packet.size;

        uint8_t end_data[100] = {0};
        end_size = sep_get_data(&sep, end_data, sizeof(end_data), true);
        if (end_size == 0) {
            break;
        }
        sep_push_data(&sapr, end_data, end_size);
        // print_byte_arr(end_data, end_size);
        // printf(" | ");
        // for (size_t i = 0; i < end_size; i++) {
        //     printf("%c", isprint(end_data[i]) ? (char)end_data[i] : '.');
        // }
        // printf("\n");
    } 

}
