cansat-tsniimash/can-cube-sat-2022/src/board/ARK/Application/Src/tmain.c

#include <ina219_helper.h>
#include "main.h"

#include <stdio.h>
#include <string.h>

#include "ds18b20.h"
//#include "i2c.h"
#include "its-i2c-link.h"
#include "its-time.h"

#pragma GCC diagnostic push
#pragma GCC diagnostic ignored "-Waddress-of-packed-member"
// Тут генерируется множество вот таких сообщений
// warning: taking address of packed member of 'struct __mavlink_vision_speed_estimate_t' may result in an unaligned pointer value [-Waddress-of-packed-member]
// Мы доверяем мавлинку в том, что он не сгенерит ничего невыровненого, поэтому давим эти варнинги
#include "mavlink.h"
#include "battery.h"
#include "mavlink_system_id.h"
#include "task.h"
#include "task_ds.h"
#include "task_ina.h"
#include "task_send.h"
#include "task_recv.h"
#include "task_battery_control.h"
#include "adc.h"


extern I2C_HandleTypeDef hi2c2;
extern I2C_HandleTypeDef hi2c1;
#define MSG_TEMP_DELAY 1000
#define MSG_INA_DELAY 1000

enum TEMP_STATE {
    DS_PROCESSING,
    DS_READY
} ;


void time_recv_callback(const mavlink_message_t *msg);

void task_main_init(void *arg) {
    printf("INFO: Starting task scheduling\n");
    its_i2c_link_start();
    its_time_init();
    trecv_add_callbac(time_recv_callback);

    task_t t = {0};

    t.init = task_ina_init;
    t.update = task_ina_update;
    strcpy(t.name, "INA read");
    task_create(t, 0);

    t.init = task_ds_init;
    t.update = task_ds_update;
    strcpy(t.name, "DS read");
    task_create(t, 0);

    t.init = task_send_init;
    t.update = task_send_update;
    strcpy(t.name, "I2C send");
    task_create(t, 0);

    t.init = task_recv_init;
    t.update = task_recv_update;
    strcpy(t.name, "I2C recv");
    task_create(t, 0);

//    t.init = task_battery_control_init;
//    t.update = task_battery_control_update;
//    strcpy(t.name, "Battery control");
//    task_create(t, 0);

    t.init = adc_task_init;
    t.update = adc_task_update;
    strcpy(t.name, "ADC control");
    task_create(t, 0);

}


void task_main_update(void *arg) {
    static uint32_t t = 0;
    uint32_t now = HAL_GetTick();

    // Если нас только что запустили, мигаем почаще, чтобы это показать
    uint32_t delta = (now < 1000) ? 100 : 1000;

    if (now - t > delta) {
        t = now;
        HAL_GPIO_TogglePin(LED_GPIO_Port, LED_Pin);
    }
}

int tmain(void) {
    task_t m = {

            .arg = 0,
            .init = task_main_init,
            .update = task_main_update,
            .name = "Main"
    };
    task_create(m, 0);
    while (1) {
        task_update_all();
    }
    return 0;
}


void time_recv_callback(const mavlink_message_t *msg) {

    uint8_t time_base = 0;
    its_get_time_base(&time_base);
    if (msg->msgid != MAVLINK_MSG_ID_TIMESTAMP) {
        return;
    }
    mavlink_timestamp_t mts;
    mavlink_msg_timestamp_decode(msg, &mts);
    if (time_base > mts.time_base) {
        return;
        its_count__time_sync_attempts();
    }

    its_set_time_base(mts.time_base);
    its_time_t t;
    t.sec = mts.time_s;
    t.msec = mts.time_us / 1000;
    its_sync_time(&t);
}
