cansat-tsniimash/can-cube-sat-2022/src/board/PAYLOAD/Application/Inc/adc_sensors.h

/*
 * adc_sensors.h
 *
 *  Created on: 18 мая 2020 г.
 *      Author: snork
 */

#ifndef INC_ADC_SENSORS_H_
#define INC_ADC_SENSORS_H_


int its_pld_adc_sensors_init();


#endif /* INC_ADC_SENSORS_H_ */
