cansat-tsniimash/can-cube-sat-2022/src/board/SINS/Application/drivers/gps/neo6-cfg.c

/*! Конфигурация gps модуля, сгенерированная из конфигурации в
    формате ucenter.
    Файл сгенерирован автоматически, поэтому менять его не рекомендуется,
    так как все изменения могут быть затерты перегенерацией */

#include <stdint.h>

/*! Статические переменные для отдельных сообщений.
    Эти массивы содержат сообщение полностью, без синхрослова в начале
    и контрольной суммы в конце.
    Однако такие поля как cls_id, msg_id, len в сообщениях содержаться */

// Сброс всех настроек кроме
static const uint8_t cfg_reset_config[] = {
		0x06, 0x09, // clsid, msgid
		0x0D, 0x00, // len
		0xFF, 0xFB, 0x00, 0x00, // clear mask
		0x00, 0x00, 0x00, 0x00, // save mask
		0xFF, 0xFF, 0x00, 0x00, // load mask
		0x03 // device mask
};

// Это дефолтная конфигурация антенны, не будет лишним задать её еще разок
static const uint8_t cfg_ant_0[] = {
		0x06, 0x13, // msgid, clsid
		0x04, 0x00, // len
		0x1B, 0x00, // flags
		0x8B, 0x00  // pins
};

// Это настройки разрешенных сообщений.
// По итогу тут включается только UBX-NAX-SOL UBX-TIM-TP и UBX-GPS-TIME
static const uint8_t cfg_msg_7[] = {0x06, 0x01, 0x08, 0x00, 0x0B, 0x30, 0x00, 0x00, 0x00, 0x00, 0x00, 0x00};
static const uint8_t cfg_msg_8[] = {0x06, 0x01, 0x08, 0x00, 0x0B, 0x32, 0x00, 0x00, 0x00, 0x00, 0x00, 0x00};
static const uint8_t cfg_msg_9[] = {0x06, 0x01, 0x08, 0x00, 0x0B, 0x33, 0x00, 0x00, 0x00, 0x00, 0x00, 0x00};
static const uint8_t cfg_msg_10[] = {0x06, 0x01, 0x08, 0x00, 0x0B, 0x31, 0x00, 0x00, 0x00, 0x00, 0x00, 0x00};
static const uint8_t cfg_msg_11[] = {0x06, 0x01, 0x08, 0x00, 0x0B, 0x01, 0x00, 0x00, 0x00, 0x00, 0x00, 0x00};
static const uint8_t cfg_msg_12[] = {0x06, 0x01, 0x08, 0x00, 0x0B, 0x00, 0x00, 0x00, 0x00, 0x00, 0x00, 0x00};

//static const uint8_t cfg_msg_13[] = {0x06, 0x01, 0x08, 0x00, 0x0A, 0x0B, 0x00, 0x00, 0x00, 0x00, 0x00, 0x00};
// MON-HW2 - Расширенное состояние аппаратуры
static const uint8_t cfg_msg_13[] = {
		0x06, 0x01, // msgid, clsid
		0x08, 0x00, // len
		0x0A, 0x0B, // msgid, clsid целевого сообщения
		// Дальше частоты этого сообщения на разных портах
		0x00, // 0 - ddc
		0x01, // 1 - uart <--- вот тут и нужно поставить 1 чтобы включилось
		0x00, // 2 - тоже uart? у нас такого вроде нет
		0x00, // 3 - usb
		0x00, // 4 - spi
		0x00  // 5 - чет знает что такое
};
//static const uint8_t cfg_msg_14[] = {0x06, 0x01, 0x08, 0x00, 0x0A, 0x09, 0x00, 0x00, 0x00, 0x00, 0x00, 0x00};
// MON-HW2 - Расширенное состояние аппаратуры
static const uint8_t cfg_msg_14[] = {
		0x06, 0x01, // msgid, clsid
		0x08, 0x00, // len
		0x0A, 0x09, // msgid, clsid целевого сообщения
		// Дальше частоты этого сообщения на разных портах
		0x00, // 0 - ddc
		0x01, // 1 - uart <--- вот тут и нужно поставить 1 чтобы включилось
		0x00, // 2 - тоже uart? у нас такого вроде нет
		0x00, // 3 - usb
		0x00, // 4 - spi
		0x00  // 5 - чет знает что такое
};
static const uint8_t cfg_msg_15[] = {0x06, 0x01, 0x08, 0x00, 0x0A, 0x02, 0x00, 0x00, 0x00, 0x00, 0x00, 0x00};
static const uint8_t cfg_msg_16[] = {0x06, 0x01, 0x08, 0x00, 0x0A, 0x06, 0x00, 0x00, 0x00, 0x00, 0x00, 0x00};
static const uint8_t cfg_msg_17[] = {0x06, 0x01, 0x08, 0x00, 0x0A, 0x07, 0x00, 0x00, 0x00, 0x00, 0x00, 0x00};
static const uint8_t cfg_msg_18[] = {0x06, 0x01, 0x08, 0x00, 0x0A, 0x21, 0x00, 0x00, 0x00, 0x00, 0x00, 0x00};
static const uint8_t cfg_msg_19[] = {0x06, 0x01, 0x08, 0x00, 0x0A, 0x08, 0x00, 0x00, 0x00, 0x00, 0x00, 0x00};
static const uint8_t cfg_msg_20[] = {0x06, 0x01, 0x08, 0x00, 0x01, 0x60, 0x00, 0x00, 0x00, 0x00, 0x00, 0x00};
static const uint8_t cfg_msg_21[] = {0x06, 0x01, 0x08, 0x00, 0x01, 0x22, 0x00, 0x00, 0x00, 0x00, 0x00, 0x00};
static const uint8_t cfg_msg_22[] = {0x06, 0x01, 0x08, 0x00, 0x01, 0x31, 0x00, 0x00, 0x00, 0x00, 0x00, 0x00};
static const uint8_t cfg_msg_23[] = {0x06, 0x01, 0x08, 0x00, 0x01, 0x04, 0x00, 0x00, 0x00, 0x00, 0x00, 0x00};
static const uint8_t cfg_msg_24[] = {0x06, 0x01, 0x08, 0x00, 0x01, 0x01, 0x00, 0x00, 0x00, 0x00, 0x00, 0x00};
static const uint8_t cfg_msg_25[] = {0x06, 0x01, 0x08, 0x00, 0x01, 0x02, 0x00, 0x00, 0x00, 0x00, 0x00, 0x00};
static const uint8_t cfg_msg_26[] = {0x06, 0x01, 0x08, 0x00, 0x01, 0x32, 0x00, 0x00, 0x00, 0x00, 0x00, 0x00};
static const uint8_t cfg_msg_27[] = {0x06, 0x01, 0x08, 0x00, 0x01, 0x06, 0x00, 0x01, 0x00, 0x00, 0x00, 0x00};
static const uint8_t cfg_msg_28[] = {0x06, 0x01, 0x08, 0x00, 0x01, 0x03, 0x00, 0x00, 0x00, 0x00, 0x00, 0x00};
// NAV_SVINFO - Space Vehicle Information
static const uint8_t cfg_msg_29[] = {
		0x06, 0x01, // msgid, clsid
		0x08, 0x00, // len
		0x01, 0x30, // msgid, clsid целевого сообщения
		// Дальше частоты этого сообщения на разных портах
		0x00, // 0 - ddc
		0x01, // 1 - uart <--- вот тут и нужно поставить 1 чтобы включилось
		0x00, // 2 - тоже uart? у нас такого вроде нет
		0x00, // 3 - usb
		0x00, // 4 - spi
		0x00  // 5 - чет знает что такое
};
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
