cansat-tsniimash/can-cube-sat-2022/(commit log)

2020-01-04 Версия 2
2020-01-04 Это был тест
2020-01-04 Новые каталоги для конструкции
2020-01-06 Добавлено ТЗ на наземный комплекс управления
2020-01-07 Исправлены даты и ошибки в написании
2020-01-10 Схемы для презентации
2020-01-13 Version 0.05 Добавлен крепеж, сборки рекофигурированы в соответствии со спецификацией
2020-01-19 Version 0.06 Добавлены массы основным компонентам, добавлено упрощенное представление для расчета масс КА
2020-01-20 Version 0.07 Уточнены массы КА
2020-01-21 Version 0.08 Добавлен сборочный чертёж
2020-01-21 version 0.09 добавлен габаритный чертеж
2020-01-21 Свежая редакция ТЗ
2020-01-22 Version 0.10 Проработана плата ПН
2020-01-22 Version 0.11 Завершён сборочный чертеж
2020-01-22 Добавлены СБ и спецификация ДКА
2020-01-22 ТЗ не ограничивает бюджет
2020-01-23 Version 0.11a Дополнены основные надписи СБ и спецификации
2020-01-23 Дополнены основные надписи СБ и спецификации; исправлен косяк шрифта
2020-01-24 Добавлены принципиальные электрические схемы КА
2020-01-24 Version 0.12 ГЧ завершен
2020-01-24 Добавлен ГЧ
2020-01-25 Протоколы взаимодействия
2020-01-25 Version 0.13 исправлены ошибки СБ и ГЧ
2020-01-25 Исправлены ошибки ГЧ и СБ
2020-01-25 Переделан протокол взаимодействия
2020-01-25 Удалил прошлый протокол
2020-01-28 Добавлена эсхема БКУ
2020-01-29 Переименованы и реструктурированы документы на зимнюю сессию
2020-01-29 Исправлены опечатки в презентации
2020-01-30 Version 0.14 Добавлено упрощенное представление урезанного варианта КА
2020-02-02 презентация после ночных правок
2020-02-05 Реструктуризация: шаг 1
2020-02-05 Интеграция мавлинка
2020-02-05 Интеграция схем
    [BMS.brd, BMS.sch, BSK.brd, BSK.sch, BSK2.brd, BSK2.sch, BSK3.brd, BSK3.sch]
2020-02-05 Гитингор для игла
2020-02-09 Добавлен сабмодуль для esp-idf
2020-02-09 Version 0.15 Добавлены проставки
2020-02-10 Незначительные изменения
2020-02-10 Version 0.15a добавлены крепежные гайки
2020-02-10 Version 0.15b Внесены изменения в каркас; Удалены лишние итерации файлов модели
2020-02-11 Начало тестирования
2020-02-12 Version 0.15c добавлены поддержки в каркас
2020-02-12 Начало тестирования v2
2020-02-15 Version 0.15d добавлены правки в электромагниты(ЭМ), сделаны чертежи ЭМ
2020-02-18 Новые схемы
    [ARK.brd, ARK.sch, BMS.brd, BMS.sch, BSK2.brd, BSK3.brd, BSK5.brd, PCU.brd]
2020-02-18 Забыли в прошлый коммит
    [BMS.brd]
2020-02-18 изменения схемы АРК
    [ARK.brd, ARK.sch]
2020-02-19 Version 0.15e добавлено отверстие в ЭМ, обновлен его чертеж
2020-02-21 Добавлена схема отладочной платы (без кнопки)
    [Debug.sch]
2020-02-21 Добавлен gitignore
2020-02-21 Кнопка на отладочной плате
    [Debug.brd, Debug.sch]
2020-02-21 Version 0.16 добавлен крепеж 1 камеры
2020-02-22 Добавлены библиотеки
2020-02-22 Initial CubeIDE project for stm32f103C8Tx
    That is base project made by CubeIDE with some enchantments.
    These are
    1. SWD debug does not become disabled after flashing MC.
    2. Add semihosting IO
    3. Add Application folder for your program that doesn't touch
    core or drivers.
    4. Add tmain function which is called in main from core
    [_initialize_hardware.c, ark.ioc, bme280.c, bme280.h, ds18b20.c, ds18b20.h, ina219.c]
2020-02-22 DS18B20 works (just one)!
    I will test it with multiple devices later
2020-02-22 DS18B20 works with multiple devices
2020-02-22 Добавлен БСК4, исправлены разъемы
    [BSK4.brd]
2020-02-25 изменен БСК4
    [BSK.brd, BSK.sch, BSK2.brd, BSK3.brd, BSK4.sch, BSK5.brd]
2020-02-25 Debug plata
    [Debug.brd, Debug.sch]
2020-02-25 изменен БСК1
    [BSK.brd, BSK.sch]
2020-02-26 Version 0.17 Добавлен второй USB-C на плату БКУ, внесены изменения в каркас
2020-02-28 Очередная дебажная плата
    [Debug.brd, Debug.sch]
2020-02-29 Исправил путь до сабмодуля (наконец-то)
2020-02-29 INA219 работает
    Я нашел баг в драйвере Кирилла в файле ina219.c строка 125. Кирилл
    полагал, что значение в даташите - это значение переменной Cal.
    Но в даташите написано, что Cal - значение регистра, а значит
    проводить дополнительные действия по сдвигу (значения переменной
    выравнивается не по нулевому биту, а по первому) нет нужды.
2020-02-29 Убраны магические числа
2020-02-29 доработана схема БСК1
    [BKU.sch, BSK.brd, BSK.sch, BSK2.brd]
2020-02-29 Поправлена настройка spi
2020-02-29 Version 0.17a доделано крепление камеры и магнитометра
2020-03-01 Косметика
2020-03-01 Был не прав, исправился. Теперь delay_us всегда инлайнится
2020-03-01 Лучшие инклюды
2020-03-01 Реструктурированы сигналы коммутации для плат БСК
    [BSK.brd, BSK.sch, BSK2.brd, BSK2.sch, BSK3.brd, BSK3.sch, BSK4.brd, BSK4.sch]
2020-03-01 доработаны схемы БСК1 и БКУ
    [ARK.brd, ARK.sch, BKU.sch, BSK.brd, BSK.sch]
2020-03-02 Безумные приключения с lsm6ds3 отмечены в истории
2020-03-03 Проект для esp32 из шаблона
2020-03-03 Проект немного похож на проект для I2C
2020-03-04 Version 0.17b Завершен кронштейн видеокамеры с магнитометром
2020-03-04 Исправлены ошибки в плате АБ
    [BMS.brd, BMS.sch]
2020-03-06 Version 0.18 создан чертеж диска ЭМ, внесены правки в чертеж корпуса ЭМ
2020-03-06 Отладочная плата v2
    [Debug.brd, Debug.sch]
2020-03-06 обновлена схема БКУ
    [ARK.brd, ARK.sch, BKU.sch, BSK.brd]
2020-03-06 Отладочная плата v3
    [Debug.brd, Debug.sch]
2020-03-06 Version 0.18 разработка кронштейна камеры завершена
2020-03-07 SINS пересел на I2C
2020-03-07 Добавлены светодиоды на платы БСК
    [ARK.brd, ARK.sch, BKU.sch, BSK.brd, BSK.sch, BSK3.brd, BSK3.sch, BSK4.brd]
2020-03-08 Разведена БСК1
    [BSK.brd]
2020-03-08 Разведены платы БСК2-5
    [BSK.brd, BSK2.brd, BSK2.sch, BSK3.brd, BSK4.brd, BSK5.brd]
2020-03-08 передача данных между контроллерами по i2c в каком-то виде работает
2020-03-09 i2c-link более менее работает, но не слишком стабильно :c
2020-03-09 Навел порядок в папках
2020-03-09 Блокировка i2c халом подперта костылём
2020-03-09 i2c-link оформлен как общий драйвер и проверен к сборке для stm32f4 и stm32f1
2020-03-09 Потерялось к прошлому коммиту
2020-03-10 Посмотрел плату БСК1, немного поправил и разместил шелкографию
    [BSK.brd, BSK.sch]
2020-03-10 Незначительные изменения в платах БСК1 и АРК
    [ARK.brd, ARK.sch, BSK.brd, BSK.sch]
2020-03-11 В плате АРК разведены дорожки групп BMS и всех DC-DC. Остался МК и его обвес
    [ARK.brd, ARK.sch]
2020-03-11 В плате АРК разведено еще больше дорожек - до 99%. Надо заменить МК или подключить текущий МК к GND
    [ARK.brd, ARK.sch]
2020-03-12 Разведена плата АРК
    [ARK.brd, ARK.sch]
2020-03-13 Плата АРК проложена на 76%
    [BSK.brd, BSK.sch]
2020-03-13 Разведена плата БСК1
    [ARK.brd, ARK.sch, BSK.brd, BSK.sch]
2020-03-14 Добавлена плата SPIDER
    [BKU.brd, BSK.brd, BSK2.brd, BSK2.sch, BSK3.brd, BSK3.sch, BSK4.brd, BSK4.sch]
2020-03-14 Добавлена плата CROSS
    [CROSS.brd]
2020-03-14 Исправлено ишью, открытое Василием
    [ina219_helper.c, ina219_helper.h, tmain.c]
2020-03-14 Добавлен код, объединяющий отправку данных
    Добавены файлы data_*, которые обобщают инициализацию, считывание
    и отправку данных по i2c/mavlink.
2020-03-14 Добавлен симлинк на мавлинк
2020-03-14 Подписаны разъемы на платах
    [BSK.brd, BSK2.brd, BSK2.sch, BSK3.brd, BSK4.brd, BSK5.brd, BSK5.sch]
2020-03-14 Добавлены платы СБ
    [SP.brd, SP.sch]
2020-03-14 lsm6ds3 работает. Ура, товарищи! А GPS нет(
2020-03-14 Version 0.19 Внесены изменения в конструкцию по результатам печати
2020-03-15 Логическая схема для сбросом и управление бутлоадером ESP32 на отладочной плате.
    [Debug.brd, Debug.sch]
2020-03-15 lis3mdl работает
2020-03-15 С АРКом всё плохо. Надо снова переделывать(
    [ARK.brd, ARK.sch]
2020-03-15 Внёс незначительные правки на платах. Но пока не везде
    [BSK.brd, BSK2.brd, BSK2.sch, Debug.brd, Debug.sch]
2020-03-16 Version 0.20 Модель krepej (Адаптер) подготовлена для печати
2020-03-17 Исправлен АРК
    [ARK.brd, ARK.sch]
2020-03-17 Добавлен драйвер для дигипода
2020-03-17 Код, собирающий АРК воединно (и BMS)
    Готов код, собирающий все части воединно. Реализовано получение
    данных от устройств, удобное хранение в одном месте с помощью
    структуры BatteryBanch. Данные обрабатываются и обновляется состаяние
    цифровых потеницометров и силовых ключей.
    Модуль Battery нужен для структурированного хранения данных, удобного
    обращения к устройствам и быстрого конфигури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
2020-03-18 Добавлена плата MAG
    [BKU.brd, BKU.sch, MAG.brd, MAG.sch]
2020-03-20 Сделано прерывание для GPS
2020-03-20 Исправлены компоненты
    [ARK.brd, ARK.sch, BKU.brd, BKU.sch, BSK.brd, BSK.sch, MAG.brd]
2020-03-20 Начата работа над обработкой сообщений с GPS
2020-03-20 Нзначительные изменения БКУ
    [BKU.brd, BKU.sch]
2020-03-20 Незначительные изменения БКУ
    [BKU.brd, BKU.sch]
2020-03-21 Чуть-чуть поправил АРК
    [ARK.brd]
2020-03-21 Добавлена плата RADIO
    [BKU.brd, BKU.sch, RADIO.brd, RADIO.sch]
2020-03-21 Плата СБ
    [SP.brd, SP.sch]
2020-03-21 Написана обработка сообщений с gps (данный функционал ожидает тестирования)
2020-03-21 Плата СБ готовая
    [SP.brd]
2020-03-21 Внесены косметические изменения на БСК2 и БСК3
    [BSK2.brd, BSK3.brd, BSK3.sch]
2020-03-21 Незначительные изменения АРК
    [ARK.brd]
2020-03-23 Платы подготовлены для Резонита
    [BSK.brd, BSK.sch, BSK2.brd, BSK2.sch, BSK3.brd, BSK3.sch, BSK4.brd, BSK4.sch]
2020-03-24 Пытаем плату БКУ компоновкой
    [BKU.brd, BKU.sch]
2020-03-24 Изменения в компоновке БКУ
    [ARK.brd, ARK.sch, BKU.brd]
2020-03-25 Начало тестирования gps
2020-03-25 Изменения в БКУ
    [BKU.brd, BKU.sch]
2020-03-25 GKS: допиливается конструкция, изменены размеры платы под радио
    [RADIO.brd]
2020-03-26 Исправлены АРК и БСК1
    [ARK.brd, ARK.sch, BSK.brd, BSK.sch]
2020-03-26 Добавлена батарейка в БКУ
    [BKU.brd, BKU.sch]
2020-03-27 Реализована отправка сообщений различной длины
    Взаимодействие работает так.
    esp: вот тебе команда
    stm: ок, выполню, когда ты запросишь что-то еще
    esp: запрашиваю
    stm: вот, что ты хотел
    Работает не идеально быстро, но если пакеты сделать достаточно большими,
    то проседание по скорости будет не заметно.
    На esp есть драйвер взаимодействия с арком.
    На арке есть драйвер может отвечать на все зап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
2020-03-28 Плата SP
    [SP.brd]
2020-03-29 Несколько новых библиотек
2020-03-29 Исправлена ошибка в библиотеке
2020-03-30 GPS работает
2020-03-30 вот теперь точно работает
2020-03-30 Разводка БКУ кроме 1 дорожки к есп (RX-R)
    [BKU.brd, BKU.sch]
2020-03-30 На плате БКУ проведена дорожка RX-R
    [BKU.brd]
2020-03-30 Реструкторизация для того, чтобы не было каши в будущем
2020-03-30 Готовый модуль работы со временем
    Основные функции задания и получения времени пародируют аналогичные
    из стандартной библиотеки.
    Основные часы для хранения времени используют милисекундную точность.
    Также имеются микросекундные часы для точных вычислений. Они не
    рекомендуются для использования на длительные периоды времени.
2020-03-30 Добавлены комментарии к функциям
2020-03-31 Добавлены подтяжки i2c
    [ARK.brd, ARK.sch, BKU.brd, BKU.sch, BSK.brd, BSK.sch]
2020-03-31 Применение замечаний Василия
2020-03-31 Добавлена схема АС, исправлена плата RADIO
    [RADIO.brd, RADIO.sch]
2020-03-31 Добавлены датчики
    [Grove - Gas Sensor(O2) v1.1.brd, Grove - Gas Sensor(O2) v1.1.sch]
2020-04-01 Исправлены RADIO и диоды
    [BKU.brd, BSK.brd, BSK.sch, BSK2.brd, BSK2.sch, BSK3.brd, BSK3.sch, BSK4.brd]
2020-04-01 Попытка сделать время
2020-04-01 Резисторы у FS8205A 100Ом
    [ARK.brd, ARK.sch, BSK.brd, BSK.sch, BSK2.brd, BSK2.sch, BSK3.brd, BSK3.sch]
2020-04-01 Попытка сделать время v2
2020-04-01 Добавлен проект с отработкой таймера
2020-04-01 БЫСТРОФИКС
2020-04-01 Попытка сделать время v3 (работают master и slave таймеры)
2020-04-02 Добавлена плата TOGETHER
    [TOGETHER.brd]
2020-04-02 Добавлены герберы плат
2020-04-02 Исправлены MAG и BSK1
    [BSK.brd, BSK.sch, MAG.brd, MAG.sch, TOGETHER.brd]
2020-04-03 Тест проект для работы с PPS
2020-04-03 Схема разводки PPS и работы с ним
2020-04-04 Добавлен micro-USB на АРК
    [ARK.brd, ARK.sch]
2020-04-04 Новый проект для настройки RTC по GPS
2020-04-04 Ой, ничайно коммитнул лишнего
2020-04-04 Маджвик начало
2020-04-04 Настройка RTC (без PPS) почти готова. Нужно только внимательно продумать момент с гонкой между обработкой пакетов и PPS
2020-04-05 Добавлены новые диоды
    [BKU.brd, BKU.sch, BSK.brd, BSK.sch, BSK2.brd, BSK2.sch, BSK3.brd, BSK3.sch]
2020-04-05 Обновлены герберы плат
    [ARK.brd, HEAT.brd]
2020-04-05 Незначительные изменения БСК1
    [BKU.brd, BKU.sch, BSK.brd, BSK.sch]
2020-04-05 Демка проекта для esp с концептом маршрутизатора
2020-04-06 Создана плата HEAT
    [HEAT.brd, HEAT.sch]
2020-04-07 Исправлены слои в HEAT
    [HEAT.brd]
2020-04-08 Убрали лишнее из SINS проекта. Добавили не лишнее
2020-04-08 gps драйвер более менее готов
2020-04-08 Начал добавлять службу времени
2020-04-08 RTC для службы времени причесывается
2020-04-08 Что-то похожее на запуск службы времени SINS от RTC
2020-04-08 Рокировка файлов по местам
2020-04-08 Лишнее
2020-04-08 Исправил пути до мавлинка и добавил инклюд на него в мейн
    [main.c]
2020-04-08 Грязь и опечатки
2020-04-08 очень много причесывания
2020-04-08 Убрана тонна ассертов из службы времени
2020-04-08 разбор NAV-SOL пакета UBX
2020-04-08 Доведено до сборки
2020-04-08 Оказывается не все что выглядит лишним - есть лишнее
    В файле Timer.c, удаленном в 5a4602e5ac4d3b0b8e7fefc72233a44e9d8025a7
    был вызов HAL_IncTick() в прерывании SysTick таймера. Из-за его пропажи
    HalDelay перестало работать. Пришлось его вернуть
2020-04-08 Омерзительная ошибки в функция преобразования времен
2020-04-08 В файле Timer.c, удаленном в 5a4602e5ac4d3b0b8e7fefc72233a44e9d8025a7 был вызов HAL_IncTick() в прерывании SysTick таймера. Из-за его пропажи HalDelay перестало работать. Пришлось его вернуть
2020-04-08 Новая конфигурация проекта для сборки под F407
2020-04-08 Исправлены ошибки по отладке RTC
    [main.c, time_svc.c, time_svc.h]
2020-04-09 Еще один вариант роутинга
2020-04-09 Служба времени разбита на две части - мировое время и стабильное время
2020-04-09 Настройки NVIC перенесены в MSP
2020-04-09 Синхронизация времени по GPS
2020-04-10 Теоретически fixes #17
2020-04-10 Поддержка ack/nack ubx пакетов
2020-04-10 Сделана и отлажена конфигурация GPS. closes #16
2020-04-11 Маджвик вроде работает
2020-04-11 Обновление esp-idf до 4.2
2020-04-12 Перемещение route в драйвер
2020-04-12 Клиент-сервер реализация с esp32 и linux
    В данной реалтзации сервер в виде линукс броадкастит сообщения
    всем, кто находится в одной сети с сервером. Клиент в виде
    esp32 получает пакет, выясняет из него ip адрес сервера и
    отпрвляет тому сообщения. Для такой реализации и клиенту и
    серверу должны быть известны порты друг друга. При этом им не
    нужно знать ip адреса друг друга с самого начала. Это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
2020-04-13 Реализован SNTP клиент и добавлен .gitignore
2020-04-13 Плата SPv2
    [SP.brd, SP.sch]
2020-04-13 Плата SPv3
    [SP.brd]
2020-04-13 Сделаны платы ADAPT и SPIDERADAPT, создана плата PL
    [ADAPT.brd, ADAPT.sch, CROSSMAG.brd, PL.sch, SPIDERADAPT.brd]
2020-04-14 SC: Изменена конструкция солнечной батареи
2020-04-14 Плата TESTPL
    [PL.brd, TESTPL.brd, TESTPL.sch]
2020-04-14 Разработана схема подключения датчиков полезной нагрузки. Closes #18
    [PL.sch]
2020-04-15 Добавлена забытое разрешение доступа к бекап домену при настройке RTC
2020-04-15 То, что должно работать, но не работает
2020-04-15 Вроде переделал на LSI
2020-04-15 Возможна работа RTC на LSI и принудительный сброс бекап домена для SINS
2020-04-15 Исправлена плата TESTPL
    [BKU.brd, PL.brd, PL.sch, TESTPL.brd, TESTPL.sch]
2020-04-15 Разведена плата PL
    [PL.brd, PL.sch]
2020-04-15 Обновлены архивы плат
2020-04-15 Незначительные изменения TESTPL
    [TESTPL.brd]
2020-04-16 SC: Внесены изменения в моделях по результатам 3D печати
2020-04-16 Исправлена ошибка в преобразовании unix time -gps time и ошибка при запуске таймера 2
2020-04-17 SC: сделана упрщенная модель GKS: заменен драйвер двигателя и его крепление
    [general_assembly_sw0001.stl]
2020-04-17 Корректная обработка флагов корректности в gps сообщение gps time. Учёт липосекунд при заборе времени от GPS
2020-04-17 Обновлен гербер RADIO
    [RADIO.brd]
2020-04-18 Обновление проекта для настройки RTC под новые липосекундные реалии
2020-04-18 На плату полезной нагрузки добавлены управляемые резисторы для управления балансирующими сопротивлениями для газового датчика
    [PL.brd, PL.sch]
2020-04-18 SC: поправлена упрощенная модель
    [general_assembly_sw0001.stl]
2020-04-18 Доработана плата БКУ
    [BKU.brd, BKU.sch, PL.brd]
2020-04-18 Плата SP с колодками
    [SP.brd, SP.sch]
2020-04-18 Синхронизация времени и IMI
    ESP32 теперь может синхронизироваться по времени с одним из ntp
    сервером. Также, он может синхронизировать всех, кто свзяан с ESP32
    по интерфейсу IMI.
    IMI (I2C messaging interface) - новосозданный интерфейс, написанный
    изначально для взаимодействия АРКа с ESP32 по I2C. Он обеспечивает
    передачу сообщений от slave к master и обратно с использованием
    дополнительной шины I2C_INT. Также допол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
2020-04-18 Изменения в подключении мк
    [ARK.brd, ARK.sch, BKU.brd, BKU.sch, PL.brd, PL.sch]
2020-04-18 Обновлены герберы АРК, БКУ и ПН
2020-04-19 SC: Разработана 3D модель для наземки
    [general_assembly_sw0001.stl]
2020-04-19 Внешняя плата СБ утверждена с незначительными правками
    [SP.brd]
2020-04-19 Выложены вспомогательные модели для создания DXF файлов Eagle
    [cross_n_mag.dxf, solar_inter_plata.dxf]
2020-04-19 Гербер SP
    [SP.brd]
2020-04-19 Внутренняя плата СБ
    [SPinner.brd, SPinner.sch]
2020-04-19 Внутренняя плата СБ v2
    [SPinner.brd]
2020-04-19 Гербер SPinner
    [SPinner.brd]
2020-04-20 Обновлен гербер SPinner
    [SPinner.brd, SPinner.sch]
2020-04-20 Обновлена схема АС
2020-04-21 Таймеры работают
2020-04-21 Работа с handmade pps
2020-04-21 Прерывание работает
2020-04-22 Обновлен гербер SPIDERADAPT
2020-04-22 Добавил pyserial утилиту для перенаправления данных из uart в tcp
2020-04-22 Утилита улучшена
2020-04-22 Снова улучшена
2020-04-22 Добавлены утилиты для сборки mav сообщений из разных tcp каналов в один. Собрано на коленке. Косметика в like-a-socat.py
2020-04-22 Добавлена утилита для приема сообщений mavlink. Утилита получает сообщение и информирует о том, какое сообщение и когда получено
2020-04-23 Подготовка к совместным испытаниям
2020-04-24 Поправил оси (должны совпадать с осями аппарата)
2020-05-06 Рефакторинг IMI для удобной работы (без теста)
    Теперь для каждого i2c устройства можно установить свое imi
    устройство отдельно. Также теперь есть защита для синхронизации.
2020-05-06 Код на момент совместного тестирования
2020-05-06 Рефакторинг арка (не работает)
    Теперь есть псевдо-таски для всего нужного. Конечно, реализация
    хромает, но она работает (точнее, работала до недавнего времени).
    Сейчас не работает, так как места не хвататет. Но почему?
2020-05-06 Обновление основных проектов, uart в esp32, подготовка к интеграционному тесту
    Следуя советам Василия, приступаю к обновлению основных проектов.
    Обновлен проект ARK по образу и подобию проекта из research
    i2c-slave. Проект BCS (БКУ) - проект esp32-wifi-что-то-там.
    Ожидается серьезный рефакторинг кода, объединяющего все и вся в арке,
    так как он выглядит жутко. У esp32 все по мелочам.
    Так как я забыл сделать к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
2020-05-07 Небольшие изменения
2020-05-10 GKS: начало оснастки
2020-05-13 инициализация и настройка GPS включены в главный цикл. Конфигурация NEO-7 изменена - включено сообщение NAV-SOL
2020-05-13 Исправлена ошибка при разборе пакета NAV_SOL. Обновлен пакет NAV_SOL
    [main.c]
2020-05-13 Продолжение работ над оснасткой ЭМ
2020-05-14 Продолжения работ над оснасткой ЭМ ch_2
2020-05-17 Удалил старые файлы. Они переехали в ./drivers
2020-05-17 Заменил все на пробелы. Твоя взяла, Сергей
2020-05-17 Проект для платы полезной нагрузки
2020-05-17 Первые наброски для софта платы полезной нагрузки
2020-05-20 Стартовый код для управления батарями
    Добавлен таск, который должен отключать и включать ряды батарей
    в зависимости от температуры. Также он должен изменять напряжение
    на dc-dc, в зависимости от напряжений на шине.
2020-05-20 Маленький фикс проверки валидности напряжений
2020-05-20 Рабочая версия (не считая времени)
    АРК читает данные ds и ina, кидает на БКУ, тот их перекидывает
    на наземную станцию, где эти данные нормально интерпретируются.
2020-05-20 Полезная нагрузка вся в процессе
2020-05-20 Утилиты для генерации конфигурации u-blox
2020-05-20 RTC работает
2020-05-21 Продолжение работ над оснасткой ЭМ ch_3
2020-05-23 Начало переноса загрузчика для gps в другой проект
2020-05-29 Налажена работa printf в консоль отладчика
2020-05-31 Настройка gps перенесена
2020-05-31 Ну, вроде разобрались с ацп и управлением делителями
2020-05-31 Внутренний термистор теперь тоже можно опрашивать
2020-05-31 Посчитал коэффициенты для mics6814
2020-06-01 Управление резисторами уходит к датчику а не в общий аналог
2020-06-01 драйвер mics6814 теперь более менее на что-то похож
2020-06-01 Максимум упрощения для mics6814. Все это было лишнее имхо
2020-06-02 me2o2 вроде готов?
2020-06-02 bme280 отлажен. Все работает кроме высоты (она еще не доделана) Ну и еще всякие оформительские мелочи и опечатки
2020-06-02 me2o2... отлажен?
2020-06-02 Чуть чуть поработал со встроенным температурным сенсором
2020-06-05 Все датчики более менее работают и даже немного калибруются
2020-06-06 Написана программа для приема пакетов на земле. Ожидаются тесты
2020-06-14 Багфикс. Неправильная подсчет миллисекунд при синхронизации времени АРКом
2020-06-14 Багфикс. Счетчик таймера TIM4 никогда не будет больше 0xFFFF0000, потому что он 16-тибитный
2020-06-14 Вот так BME работает не LSI
2020-06-14 Разработка полезной нагрузки идет во всю силу
2020-06-14 Отладочные сообщения полезной нагрузки
2020-06-14 В плате полезной нагрузки включен IWDG
2020-06-14 В плате полезной нагрузки настроена ламопчка (и отлажен IWDG)
2020-06-14 Крупное переосмысление кода полезной нагрузки Достигнута стабильная работа после КЗ на линиях i2c bme
2020-06-24 Исправлена проблема с SNTP сервером
    Раньше адрес NTP-сервера получался по DHCP. Мы его отключили, так
    как на борту он не особо нужен будет. Поэтому ESP32 не мог
    отправлять запросы на синхронизацию.
    Понемногу пытаюсь писать комменатарии к коду. Теперь я полностью
    определился, что буду писать их на русском, поэтому они
    понемногу будут появляться.
    [main.c]
2020-06-24 Переведен АРК с LSE на LSI
    LSE работает не всегда. Пару раз он уже ломался. Температуры для
    него страшны. Так что было решено отказаться от LSE.
2020-06-25 Синхронизация времени между ESP32
    Добавлен NTP сервер. Он будет работать в кубе с stmf4, который
    будет получать время от gps. Так что это получается stratum 1.
    Вот только из-за выполнения нескольких задач, время отправления
    может быть неточным.
2020-06-25 Чтобы увеличить точность синхронизации,надо лишь...
    Поднять приоритет задачи NTP сервера. Скорее всего, это лучшее
    решение. Но надо тестить с помощью осциллографа.
2020-06-25 Настройка DMA для I2C1 и tx_overrun в its-i2c-link
2020-06-25 Ассерты и ErrorHandler Хала теперь перезапускают систему Настроена периодичность пакетов
    [app_main.c, main.c]
2020-06-25 Добавлены конфигурации для сборки платы полезной нагрузки как имитатора
2020-07-01 Исправлено опускание i2c-int и разные фиксы
    I2C-INT неправильно работал. Теперь он опускается и поднимается
    своевременно.
    Пытаемя застваить работать ПН. Пока не очень.
    [PAYLOAD.ioc, main.c, main.h]
2020-07-02 Подписал контакты, отправил плату в производство
    [Debug.brd, Debug.sch]
2020-07-03 Рабочий код АРКа, ПН и БКУ
    Наконец-то все заработало! Основная проблема была в
    высоком сопротивлении на подтяжке.
    Убраны лишние принтфы. На данный момент печатается
    лишь информация о том, что пришло какое-то сообщение,
    время и оповещение о синхронизации.
2020-07-10 SP, убраны диоды, изменены площадки, добавлены надписи
    [SP.brd, SP.sch]
2020-07-11 SC: Созданы оснастки для сборки СБ и намотки катушки ЭМ, укорочена втулка ЭМ
2020-07-11 Добавил в .gitignore файлы с расширением STL
2020-07-11 SC: Уменьшил углубления под гайки в каркасе
2020-07-13 Созданы новые gerber файлы плат SP и BSK2 версии 1.1
    [BSK2.brd, SP.brd, SP.sch]
2020-07-14 Исправлены недочеты
2020-07-15 Добавлен Wi-Fi AP
    Раньше оба esp32 коннектились к одному внешнему
    вайфаю. Теперь добавлен новые функции (и немного
    изменены старые) для инициализации AP.
2020-07-15 Провели тест с Данилой - успешно
2020-07-15 Точно рабочий код АРКа, ПН, БКУ
    Забыл добавить файлы к позапрошлому коммиту. Это очень грустно!
2020-07-15 Добавлена новая конфигурация gps модуля
    [neo6-config.cfg]
2020-07-16 Новая плата АРК
    [ARKnew.brd, ARKnew.sch]
2020-07-16 Заменены ID компонент и систем для АРКа
    Раньше было 42. Теперь нормальное число.
2020-07-16 Исправлен выход за пределы массива
    Я перепутал местами номер канала и передаваемый байт.
    Из-за этого мавлинк выходил за пределы массива. Мораль:
    не доверяй проверку на допустимость параметров кому-либо
    другому.
    [main.c]
2020-07-16 БСК теперь ищет БКУ через Wi-Fi после отключения
2020-07-16 Служба времени перенесена в отдельный файл + комментарии
    Служба времени была наоднородной и была в разных местах.
    Теперь все находится в одном аккуратненьком файле.
    Добавлены комментарии в разных участках кода. Теперь должно
    быть проще для сопровождения кода.
2020-07-16 Передача сообщений через wifi
2020-07-17 Обновлена плата АРК
    [ARKnew.brd, ARKnew.sch]
2020-07-17 АРК 2.0
    [ARKnew.brd, ARKnew.sch]
2020-07-17 Доделана программа для приема радиопакетов на земле
2020-07-17 Первая порция фикса
2020-07-18 Принятие первой порции фиксов
2020-07-18 Дополнение
2020-07-18 Уменьшена частота отправки времени на APK, изменена конфигурация для gps
2020-07-18 Добавлен драйвер встроенного термодатчика
    Стмовский АЦП сложен в управлении. Но на АЦП висит лишь термодатчик, а
    значит все намного проще, чем обычно.
    Забыл закинуть в предыдущий коммит
    Это тоже
2020-07-18 Перемещен timeout шины на уровень выше
2020-07-18 Изменены настройки на более нормальные
2020-07-18 Добавлен дебаг АРКовски тасков
2020-07-18 Теперь ВСЯ синхронизация веремени в одном месте
    Добавлен в общую кучу ark_time_sync, синхронизирующий
    всех на линии imi. Также выделен отдельно ntp_cerver
2020-07-18 Синронизация времени между СИНС и БКУ работает
    Теперь все работает.
2020-07-19 Исправлены диоды в АРКе
    [ARKnew.brd, ARKnew.sch]
2020-07-22 Переместил код для приема по радио на земле
2020-07-24 Изменен АРК
    [ARKnew.brd, ARKnew.sch]
2020-07-25 Изменения в размерах крепления камеры
2020-07-25 Улучшен ADC на АРКе
    Теперь встроен оверсэмплинг! И добавлен вывод на шину телеметрии.
2020-07-25 Добавлен модуль для работы с радио
    Теперь все сообщения проходят отбор и отпраляются по радио с заданной
    частотой, если это позволяет канал и реализация системы.
2020-07-25 Добавление коментариев и очистка от лишнего
2020-07-28 SC: Корректировка моделей по результатам печати
2020-07-28 В КА измененя в размерах кронштейна
2020-07-28 Добавлен парсер логов. Нужен тест
2020-07-29 Работает парсер логов с таймштампом. Необходима доработка для сырого лога
2020-07-30 Радио теперь разделяет сообщения по отправителю
    Раньше сообщения разелялись только по msgid. Однако из-за этого
    сообщения одного типа от разных источников могли заглушаться одним
    из источников. Теперь добавилось разделение с помощью динамического
    добавления контейнеров.
2020-07-30 Добавлено определение основы получения времени
2020-07-30 Начало работы с термометром
2020-08-01 Продолжение
2020-08-01 Датчик температуры чипа работает
2020-08-04 Небольшие исправления
2020-08-05 Добавлена конфигурация gps в основной проект
2020-08-08 Начало разработки бессмертного sins
2020-08-11 Исправлена плата MAG
    [MAG.brd, MAG.sch]
2020-08-12 Подготовлены к производству платы ARK v1.1 и SP v 1.2
    [ARKnew.brd, SP.brd, SP.sch]
2020-08-12 Добавлена структура ошибок
2020-08-12 Сдвиговый регистр, управляющие компоненты и релизная конфигурация
    Новая компоненты для работы со сдвиговым регистром. Пока не
    тестировалось из-за проблем с прошиванием МК.
    Управляющие компоненты управляют питанием, магнитами и нагревателями.
    Новая релизная конфигурация для печатных плат. Управляется простым
    дефайном.
2020-08-12 Добавлены модуль SD и удаление очереди в route
    Рабочий модуль для работы с SD картой. Известна проблема, что при
    отключения SD карты и обратной вставки эта карта больше не использется
    микроконтролером.
    Теперь можно удалять свою очередь из route после того, как она
    становится ненужной.
2020-08-12 Код обновлен в соответствии с мавлинком
2020-08-13 Драйверы для шины 1W и ds18b20, и управляющий таск
    Добавлены драйверы от https://github.com/DavidAntliff/ для работы с
    ds18b20. Пока что без тестов.
    Также взят его пример за основу для будущего таска, управляющего
    температурой. В будущем он будет отправлять данные в route, но пока
    он просто печатает все, что видит.
2020-08-15 Добавлена возможность работы с backup SRAM
2020-08-15 На БСК1 или на БКУ пины I2C_INT и LED перепутаны
    Проблема решена успешно
2020-08-15 Малые исправления
2020-08-15 shift_reg теперь правильно изменяет сдвиговые регистры
    Хоть порядок бит MSB правильный, но SPI передает байты в порядке LSB, а
    сдвиговые регситры хотят MSB
2020-08-15 Уменьшение логов и добавление подтяжки
    Забыли вставить подтяжку на плату >_<
2020-08-15 Рабочая версия сдвиговых регистров и ds18b20
2020-08-15 Улучшение синхронизации времени
    Забытые файлы
2020-08-15 Определены состояния платы по джамперу. Начата проработка сосотояний
2020-08-15 Добавил проект для маяка для теста дальнобойности радио
2020-08-15 Маяк готов. Осталось настроить радио
2020-08-22 обработка ошибок для mems датчиков. требует отладки
2020-08-27 Исправление ошибок
2020-08-27 Исправляем ошибку i2c busy
    [main.c, mems.c]
2020-08-29 После HardFault контроллер перезапускается
2020-08-29 WATCHDOG полезной нагрузки перенастроен так, что перезапускает её, если она слишком давно не отправляла сообщения I2С мастеру
2020-08-29 Обработка ошибки повторяющихся данных
2020-08-29 Добавлен watchdog на передающий uart на 16 секунд. Изменены параметры конфигурации gps
2020-08-29 Убран HardFault из main
2020-09-02 Сенсоры теперь отправляют данные в route
2020-09-02 Увеличена надежность SD
2020-09-02 Новая компонента "опрератор"
    Новая компонента ответственна за управление аппаратом "снаружи".
2020-09-02 Модуль логирования и логи БКУ
2020-09-02 Доделан вочдог
2020-09-02 Симлинки в проекте БКУ поправлены на относительные
2020-09-02 обновлен сабмодуль на esp-idf на ту версию, которой наши проекты собираются
2020-09-02 Добавлен файл, который удерживает папку Inc ntp-сервера, без которой проект не собирается
2020-09-02 SC: Модуль GPS и некоторые другие помпоненты платы БКУ установлены в соответствии с разводкой платы
2020-09-04 Опция для генерации списка команд проектом БКУ для проверки через CPPCHECK. И снова правка сабмодуля. Наконец-то я собрал проект...
2020-09-05 Ассерты в релизе перезапускают контроллер
2020-09-05 Неблокирующая настройка gps. Первые наброски
2020-09-05 Не ждем конфигурации gps по началу
2020-09-05 Кажется, теперь esp-idf указывает на правильную ревизию для сборки
2020-09-05 SC: Начало разработки крепления антенны GPS
2020-09-06 Включили CSS. Пересели на HSI. Проверка кватерниона на нан
2020-09-06 !!! ОБНОВЛЕН МАВЛИНК!!! Добавлен пакет с ошибками SINS
2020-09-06 Исправлена релизная конфигурация АРК
2020-09-06 АРК переведен на HSI вместо HSE
2020-09-06 Небольшой рефактор ARK. Добавлен вотчдог на отправку сообщений
2020-09-06 Исправления конфигуаций PAYLOAD аналогичные исправлениям ARK
    [main.c]
2020-09-06 Проверен вотчдог арка, исправлены некоторые макросы в релизной конфигурации, добавлена перезагрузка по ошибкам HAL и ассертам
    [main.c, tmain.c]
2020-09-06 Помедленнее клок АЦП для АРК
2020-09-06 PAYLOAD перевед на HSI с понижением частоты с 72Мгц до 64Мгц. Из-за этого перенстроен таймер службы времени
2020-09-06 Добавил причину резета для PAYLOAD и поправил mavlink сообщение с кодами ошибок периферии
2020-09-08 Управляющие таски делают своб работу еще лучше
    Нагреватели теперь ограничиваются силой тока.
    Добавлена возможность управления питанием Payload.
    Параметры сдвиговых регистров теперь правильно ограничены.
2020-09-08 Новые операции для управления извне
2020-09-08 Теперь доступно полное очищение памяти от модулей
2020-09-08 Изменены пины АРКа для соответствия с платами
2020-09-08 Фиксы после merge для дополнительной проверки
2020-09-08 Убраны лишние файлы из гита
2020-09-08 Ремонт файла проекта и .settings в гитигнор
2020-09-08 Убрал блокирующую индикацию ребута из АРК
2020-09-08 Добавил неблокирующую индикацию ребута для АРК
2020-09-08 Миграция PAYLOAD на новую версию IDE и чистка различного мусора
2020-09-08 Продолжение миграции PAYLAOD но новую версию IDE и отключение инициализации внешних кристаллов в ARK и PAYLOAD
2020-09-08 Добавлен счетчик резетов и счетчик переконфигураций жпс
2020-09-08 Протестирована неблокирующая конфигурация жпс
2020-09-08 Внесены изменения в GKS, КА
2020-09-10 Исправил самописный клок. Теперь он работет правильно
    [mems.c]
2020-09-11 Теперь собирается и для дебага
2020-09-11 Рестарт контроллера по немаскируемым прерываниям для полезной нагрузки и АРК
2020-09-11 Пересадка пинов на настоящие для АРК
2020-09-12 Убрал пулдаун с TIME пина PAYLOAD
2020-09-12 СОЗДАВАЙТЕ GITIGNORE В СВОЕЙ ПАПКЕ ЛИЧНО СЕБЕ!!! ЭТО НЕДОРАЗУМЕНИЕ РАЗВАЛИЛО МНЕ НАЗЕМКУ!
2020-09-13 SC: Добавлены платы с DC-DC, внесены изменения в печатные детали для БКУ и СБ по результатам 3D печати, прочие правки...
2020-09-13 SC: Переименована модель антенны на борту КА
2020-09-13 Правильные калибровочные коэффициенты для mics6814 для полетной платы
2020-09-13 Включены прерывания для пина TIME
2020-09-13 Разный порядок BSK и починенный control_heat
2020-09-13 Упрощенная версия АРКа для полурабочей платы
2020-09-13 Изменена частота uart и разные фиксы
2020-09-13 Починены пины SPI и отключение SD
2020-09-13 Починенен log_collector
2020-09-13 Исправлена конфигурация жпс. Убраны исправления осей у мемс датчиков. Понижена частота отправки. Системные пакеты отправляются раз в секунду
    [gps.c, led.c, lis3mdl.c, main.c, neo6-cfg.c, uplink.c]
2020-09-13 Сохранение данных сдигового регистра в TP50
2020-09-13 Теперь он буден кидать 0 на реостат
2020-09-14 Лишние файлы в гитигнор
2020-09-14 Теперь компилится
2020-09-17 Убран PL_KVCC и добавлены логи радио
    Временно у нас проблемы с нормальной подачей питания. Так что теперь
    оно идет через PL на BCU. Мы убрали транзистор, управляющий питанием
    от BCU на PL, и соединили напрямую.
    Консольныу логи радио починили его работу, так что пока не убираем.
2020-09-17 Убраны статики из заголовка в mavlink_comp
2020-09-20 Миграция маяка на новый cubemx. Добавлена neo6 конфигурация
2020-09-20 Пересмотренная конфигурация neo6. Дает PPS всегда
2020-09-20 Кажется, финальный реворк конфигурации neo-6
2020-09-20 SC: Модернизирована крышка антенны GPS, добавлены шайбы под антенну РМ, переделан адаптер корпусных модулей
2020-09-23 Добавили вотчдоги
2020-09-23 Уменьшенная частота радио и включенная SD карта
2020-09-23 Починили радио
2020-09-27 Добавлены функции для калиборовки магнитометра и акселерометра. Для их правильной работы необходимо включить соответствующие макросы в state.h и включить макрос CALIBRATION.
2020-09-27 Уменьшена скорость отправки по i2c. Добавлена проверка данных lis
2020-09-28 Канал WIFI, исправлен баг с iwdt
2020-09-28 Отображение обнаруженных 1w адресов при иницализации esp32
2020-09-28 Адреса 1w сенсоров захардкожены в esp32
2020-09-28 Фикс бага в 1w библиотеке
2020-09-28 Захардкоженные адреса ds18b20 для АРК. Новые конфигурации сборки АРК
2020-09-29 Реворк радио таска
2020-09-29 подтяжка для пинов, на которых работают прерывания
2020-09-29 Корректировка опросов ины арком
2020-10-01 log_collector защищен от ужасов параллелизма + включен таск нагревателей
2020-10-01 Нагреватели роаботают, как положенно + контроль скорости радио
    Но потребление не уменьшается. Либо баг в коде, либо радиомодуль так
    устроен.
2020-10-01 Дефайны теперь правильные: у нас всего 6 1W устройств
2020-10-01 Из-за путаницы при сборке АКБ стоят не в тех кубах
2020-10-01 Тюнинг цифр в управлении температурой
2020-10-01 Радио отправляет только пакеты целиком, чтобы не сыпать отдельными байтиками
2020-10-01 Правильное значение шунта ины на арках
2020-10-01 Таск управления батарейками отключен Убраны таск опроса ины на втором
2020-10-01 Мавлинк система зависит от номера куба
2020-10-01 Исправлен баг с включением всех нагревателей после включения
    Я неправильн инициализировал массив
    [control_heat.c, control_heat.h]
2020-10-01 Перезапуск esp, если вайфай не включился
2020-10-01 Ограничение нагревателей по току
2020-10-01 Обновлена конфигурация GPS для SINS. Увеличен буфер для входящих GPS сообщений. Включено сообщение NMEA-GSV для диагностики качества приёма (SINS его не обрабатывает)
2020-10-06 Полётная телеметрия
    [BCU_STATS-10-0.csv, BCU_STATS-20-0.csv, ELECTRICAL_STATE-12-0.csv, ELECTRICAL_STATE-21-0.csv, Electrical_state.csv, Electrical_state.xlsx, GPS_UBX_NAV_SOL-11-0-with-o2-and-bme-and-mics.csv, GPS_UBX_NAV_SOL-11-0-with-o2-and-bme.csv]
2020-10-09 Добавление архива телеметрии
    [archive-pld.ods, archive-sins.ods]
2020-10-10 Новый способ ограничения радио
2020-10-10 Исправлен баг вылета первого и второго есп32
2020-10-10 Убраны логи ЕСП
2020-10-10 Новый приоритет сообщений и убран коэфициент
2020-10-10 Пофикшенная телеметрия от меня
    [Electrical_state.xlsx]
2020-11-05 Папка с платами
    [ARKnew.brd, ARKnew.sch, BKU.brd, BSK5.brd, CROSS.brd, DC-DC.brd, DC-DC.sch, PL.brd]
2020-11-05 Обновлена библиотека компонентов
2020-11-16 Обновлены корпуса компонентов
    [BMSnew.brd, BMSnew.sch]
2020-11-17 Плата АБ
    [ARKnew.brd, ARKnew.sch, BMSnew.brd, BMSnew.sch]
2020-11-27 SC: Да начнется 3D моделестороение стратосферного зонда 2.0!
2020-11-27 SC: Добавлена BSK5_PCB-main.prt
2020-11-28 Сделаны платы CROSSnew, SPIDERnew, BSK2
    [BKU.brd, BKU.sch, BSK1.brd, BSK1.sch, BSK2.sch, BSK3.brd, BSK3.sch, BSK4.brd]
2020-12-05 Наработки солнечного датчики команды ЗИКЮШ
    А также наработки этого года.
    [theplane.stl]
2020-12-05 Плата DC-DC
    [DC-DC.brd, DC-DC.sch]
2020-12-09 Схема расположения плат и разъемов
2020-12-09 Новая схема подключения плат
2020-12-09 Почистил папку doc/ от старых файлов и добавил описание к проекту Eagle
    [Debug.brd, Debug.sch]
2020-12-09 Сделал платку BMSnew лучше, но не совсем
    [BMSnew.brd, BMSnew.sch]
2020-12-11 платы DC-DC и AB
    [BMSnew.brd, BMSnew.sch, DC-DC.brd, DC-DC.sch]
2020-12-11 Герберы плат DC-DC и AB
    [AB.brd, AB.csv, AB.sch, DC-DC.csv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]
2020-12-11 Теперь платы КонцеРна
2020-12-17 Добавлены предохранители в библиотеку
    [AB+DC-DC.brd, AB.brd, AB.csv, AB.sch, BSK1.brd, BSK1.sch, BSK4new.brd, BSK4new.sch]
2020-12-18 ТЗ на НКУ"Охотник"
2020-12-19 Разаботка драйвера sx126x наконец-то переехала в репозиторий
2020-12-19 Добавлен проект для тестов лоры для ф4 чипа
2020-12-19 Добавлен проект для тестов лоры для ф1 чипа
2020-12-19 Переименовашки в sx126x_plt
2020-12-19 Исправлена БСК1
    [BKU.brd, BKU.sch, BSK1.brd, BSK1.sch, BSK2.brd, BSK2.sch]
2020-12-19 Значительный прогресс в драйвере sx126x
2020-12-19 SpaceCraft: помолимся за спасение душ, главный архитектор делает пуш
2020-12-19 ping-pong почти работает, но не так как надо
2020-12-19 Попытки наладить CAD, пока не успешные
2020-12-20 Очередные попытки запустить CAD
2020-12-20 Решил все переделать и все сломал
2020-12-21 Попробуем вот так
2020-12-21 Вот так - намного лучше!
2020-12-21 Убраны ненужные глобальные переменные
2020-12-21 Исправлено несколько грубых ошибок в частности в CAD режиме с управлением антенной
2020-12-26 SpaceCraft:пуш того что не запушено(развитие конструкции + первый вариант ТЗ на аппарат)
    [ex2.stp]
2020-12-26 Исправленное ТЗ
2020-12-26 Добавлено ТЗ на систему
2020-12-26 Исправление ТЗ
2020-12-26 Исправлен pdf
2020-12-30 Плата АB+DC-DC
    [AB+DC-DC.brd, AB.brd, AB.sch, BSK1.brd, BSK1.sch, BSK2.brd, BSK2.sch, BSK3.brd]
2020-12-30 Gerber AB+DC-DC
    [drill_1_16.xln, gerber_job.gbrjob]
2020-12-30 Убраны лишние файлы
2020-12-30 добавил проект с прикидками по ccsds-sdl
2021-01-04 Новый вариант CCSDS
2021-01-06 Начало работы над ccsds unified space link для Земли
2021-01-08 Платы СБ
    [BSK5.brd, BSK5.sch, SPin.brd, SPin.sch, SPinner.brd, SPinner.sch, SPout.brd, SPout.sch]
2021-01-08 SC: Создана плата АБ
2021-01-10 Работа над спейс-линком ведется
2021-01-10 Все разобрано, но какой-то прогресс есть
2021-01-12 Продолжается работа на ccsds дата линком
2021-01-14 CCSDS на C
2021-01-15 Добавлен FOP
2021-01-15 Теперь ccsds-c компилируется
2021-01-15 Добавил vc_generate
2021-01-15 Добавил мультиплексор виртульного канала
2021-01-15 Построена вся структура сверху вниз
    Осталось снизу вверх и направление данных в обратную сторону
2021-01-16 SC: все что накопилось по конструкции за последнее время
2021-01-16 SC: Добавлена сборка с компрессором
2021-01-16 SC: добавлен модуль АБ(доделан)
2021-01-16 ccsds uslp cpp в процессе
2021-01-16 Отправка, очень грубо, но написана
2021-01-16 Первичная ловля багов в ccsds uslp cpp
2021-01-16 Продолжение первичной ловли багов
2021-01-17 Капитальное допиливание ccsds uslp cpp
2021-01-17 Неможко переименований
2021-01-17 Формировалка кадров формирует что-то похожее на правду
2021-01-17 Отделил определения от объявлений
2021-01-17 Заготовка под EPP
2021-01-17 Endian controlled field inserter 1.0
    Данный модуль позволяет вставлять поле в массив разных порядков бит и
    байт. Это необходимо для работы ccsds и других протоколов.
    Код тестился недостаточно хорошо, но автор позапускал пару раз, и вроде
    работает.
    Основная функция для запуска - endian. Если хотите понять код, то
    начинайте с MASK и MASK_U, которые создают маску из единиц посередине и
    нулей по краям. Главная фу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
2021-01-17 Прием в ccsds uslp потихоньку движется
2021-01-18 Фикс endian, более свежий вид
2021-01-18 Endian 2.0
    Основаня функция переработана и стала максимально универсальной.
    Добавлены комментарии к функциям и коду.
    Добавлена ccsds версия endian.
2021-01-18 Правильная кодировка
2021-01-18 Вот уж не знаю что написать... ccsds uslp cpp активно движется. Кажется написан приём вплоть до map_access сервиса
2021-01-19 Добавил консты
2021-01-19 Реализован Encapsulation packet protocol
2021-01-19 Реализован запрос пакетов снизу для всего протокола
2021-01-20 SC: Изменила БКУ, поправила сплавы Розе и плату solar_pcb-inner
2021-01-20 плата БСК5
    [BSK5.brd, BSK5.sch, CROSSnew.brd, CROSSnew.sch, PLnew.brd, PLnew.sch, SPIDERnew.brd, SPIDERnew.sch]
2021-01-20 Фикс epp
2021-01-20 Mapp умеет принимать пакеты снизу
2021-01-20 В каком-то объеме приём ccsds uslp cpp работает
2021-01-21 Добавлена иницилизация всех уровней
2021-01-22 SC: постановка камер, добавлены крепления солнечных датчиков; а я ухожу в тень...
2021-01-23 Правки по замечаниям в ТЗ
2021-01-23 Работа над приёмом пакетов. Рефакторы тут и там, фиксы мелких багов
2021-01-23 Поправлены какие-то баги
2021-01-23 SC: добавлен адаптер
2021-01-23 В первом приближении, хоть и сильно не причесан - ccsds uslp cpp стек работает
2021-01-23 Фикс ужасного бага-опечатки с memset
2021-01-23 Много много рефактора и украшательств
2021-01-23 Подготовка примеров и украшалки
2021-01-23 Улучшенный endian но с багами
2021-01-23 Дебаг и получение пакетов снизу
2021-01-23 Рабочая (скорее всего) версия ccsds
2021-01-26 Очень... много... рефактора
2021-01-26 Рефакторы рефакторы. Добавлены проверки на совпадение каналов при их зацепе в мультиплексоры
2021-01-26 Более симпатишные айдлы
2021-01-26 Оформление cmake проектов
2021-01-26 Переезжаем в релизную ветку, готовимся к сборке на малину
2021-01-27 Реализован mapa сервис
2021-01-27 Теперь mapa может нормально передавать и принимать большие пакеты
2021-01-27 Теперь mapp может передавать и принимать большие пакеты
2021-01-29 Изменен номинал резисторов
    [BSK1.brd, BSK1.sch, BSK2.brd, BSK2.sch, BSK4.brd, BSK4.sch, BSK5.brd, BSK5.sch]
2021-01-29 БСК5
    [BSK5.brd]
2021-01-29 Я более менее доволен стеком, который получился. Переходим к интерфейсам
2021-01-29 рефактор системы эвентов (все равно плохо получается) и всякие косметические единобразия
2021-01-29 Лайаут cmake проекта для ccsds-линка наземной станции
2021-01-31 Выполнена перетрассировка платы BSK1. Осталось нанести маркировку
    [BSK1.brd, BSK1.sch]
2021-02-02 Внесены правки в платы БСК
    [BSK2.brd, BSK2.sch, BSK3.brd, BSK3.sch, BSK4.brd, BSK4.sch, BSK5.brd, BSK5.sch]
2021-02-04 Небольшой допил драйвера sx126x для экспорта прерываний и обработок ошибок
2021-02-05 Удаление всего из PAYLOAD
2021-02-05 Кажется сервер радио стал на что-то похож
2021-02-05 Добавление PAYLOAD проекта. Начало драйвера для ms5611
2021-02-05 Небольшой рефактор драйвера sx126x. Первичная интеграция RSSI
2021-02-06 Дописана проверка crc (необходимы тесты). Оформлен .header.
2021-02-06 Перенесены файлы датчиков из прошлогоднего проекта. Немного поправлены пути.
2021-02-06 Добавлен проект для проверки работоспособности генератора на 24МГц
2021-02-06 Исправлена частота генератора на 24 МГц
    [PAYLOAD.ioc, main.c]
2021-02-06 Обновлена схема подключения плат
2021-02-06 Две линии i2c на платах БСК заменены на одну
    [BSK1.brd, BSK1.sch, BSK2.brd, BSK2.sch, BSK3.brd, BSK3.sch, BSK4.brd, BSK4.sch]
2021-02-09 Сервер радио чуточку переосмыслен
2021-02-11 Снова ой
2021-02-19 Немного облегчил main
2021-02-19 Убрал баги
2021-02-19 Рефакторинг внутренних связий
2021-02-19 Отшлифовка рефакторинга
2021-02-19 Второй вариант фасада
2021-02-19 Первый вариант
2021-02-19 Последние нововедения во внешний рефакторинг
2021-02-19 Отшлифовка рефакторинга + const в параметрах функций
2021-02-19 Реализован красивый main для поиска многочисленных багов
2021-02-20 Теперь работает. Последствия рефакторинга исправлены
    [main.c]
2021-02-20 Теперь пакеты отправляются только по одному
2021-02-23 Электрические схемы
    [AB.sch, BSK1.sch, BSK2.sch, BSK3.sch, BSK4.sch, BSK5.sch, SPout.sch]
2021-02-23 Подготовлены материалы на зимнюю сессию!
2021-02-23 SC: Модель стратосферного зонда для зимней сессии!
2021-02-27 Добавил readme для солнечного датчика
2021-02-27 Градиентный солнечный датчик
2021-03-06 Сборка нового проекта
2021-03-06 Добавлена схема дозиметра, исправлены платы СБ
    [BSK1.brd, BSK1.sch, BSK4.brd, BSK5.brd, BSK5.sch, PLclose.brd, PLclose.sch, PLnew.brd]
2021-03-13 Подготовил проект под тест солнечного датчика
2021-03-13 Отделил src и inc
2021-03-20 Добавил каталог 1w устройств БКУ на стенде
2021-03-20 Закончена миграция проекта. Перенесен весь прошлогодний код. Проект собирается.
2021-03-20 Небольшие изменения в скорости работы mems датчиков
2021-03-23 SC-Rev1.0: Разработана конструкторская модель - ревизия 1.0
2021-03-25 Плата стала запускаться, но не может настроить частоты
2021-03-26 Обновлен список плат, работа над платой ПН
    [ADAPT.brd, ADAPT.sch, ARK.brd, ARK.sch, ARKnew.brd, ARKnew.sch, BKU.brd, BSK1.brd]
2021-03-28 Схема БКУ
    [BKU.brd, BKU.sch, BSK2.brd, BSK3.brd, BSK4.brd, BSK5.brd, BSK5.sch, PL.brd]
2021-04-01 Исправлена БСК5
    [ARKnew.brd, ARKnew.sch, BSK5.brd, BSK5.sch]
2021-04-01 Плата ПН почти разведена. Осталось добавить конденсаторы на компрессор и клапаны и запитать AVCC МК через стабилизатор напряжения
    [PL.brd, PL.sch]
2021-04-01 Схема АРКа + устройства для него
    [ARKnew.brd, ARKnew.sch]
2021-04-01 Начало работы с payload. Добавил симлинк i2c для payload и sins
2021-04-01 Доработана схема АРКа
    [ARKnew.brd, ARKnew.sch]
2021-04-02 Радио сделал, но радио не работает
2021-04-02 Исправления после советов Василия
    [sx126x_board.c]
2021-04-02 Еще разные приколюхи
2021-04-03 Плата ПН готова к проверке
    [PL.brd, PL.sch]
2021-04-03 На платах БСК устройства по умолчанию подтянуты к питанию
    [BKU.brd, BKU.sch, BSK.brd, BSK.sch, BSK5.brd, BSK5.sch]
2021-04-03 Добавил красоты на плате ПН, поправил подтяжки некоторых транзисторов
    [PL.brd, PL.sch]
2021-04-03 Эксперименты с радио
2021-04-03 Изменены площадки для сплавов Розе
    [BSK1.brd, BSK1.sch, BSK2.brd, BSK2.sch, BSK3.brd, BSK3.sch, BSK4.brd, BSK4.sch]
2021-04-03 Плата СП изменена для возможности подключения 2 вариантов ФЭПов
    [SPin.brd, SPin.sch, SPout.brd, SPout.sch]
2021-04-03 Добавлены подписи Концерна к платам
    [BSK1.brd, BSK1.sch, BSK2.brd, BSK2.sch, BSK3.brd, BSK3.sch, BSK4.brd, BSK4.sch]
2021-04-03 Двигаем логотип на плате ПН
    [PL.brd]
2021-04-05 Добавлены датчики СИНСа на платах
2021-04-05 Исправлены некоторые ошибки в плате ПН
    [PL.brd, PL.sch]
2021-04-05 Добавлен конденсатор на питание СБ
    [SPout.brd, SPout.sch]
2021-04-08 Замечания по плате ПН устранены
    [PL.brd, PL.sch]
2021-04-08 Начато исправление разъемов
    [ARKnew.brd, ARKnew.sch, BSK5.brd, BSK5.sch]
2021-04-08 Проект для отладки i2c шины
2021-04-10 Разведен АРК
    [ARKnew.brd, ARKnew.sch]
2021-04-10 Добавил i2c config и пин-заглушку для i2c прерывания
2021-04-10 Добавлена шелкография на платах БСК и СП
    [BSK2.brd, BSK2.sch, BSK3.brd, BSK3.sch, BSK4.brd, BSK4.sch, SPout.brd, SPout.sch]
2021-04-10 Небольшое переосмысление структуры проекта
2021-04-10 Добавлен конфиг для i2c и mavlink
2021-04-10 К платам добавлен маяк Прохора
    [k1fm-pico-balloon-v1.3.brd, k1fm-pico-balloon-v1.3.sch]
2021-04-10 Плата БСК1 переделана. Осталось разобраться с шелкографией
    [BSK1.brd, BSK1.sch]
2021-04-10 Радио принимает мусор
2021-04-11 Делаю ПН
2021-04-12 Добавлены герберы плат BSK1-4, PL, SP и SPIDER
    [ARK.brd, ARK.sch, ARKnew.brd, ARKnew.sch, BSK1.brd, BSK1.sch, BSK2.brd, BSK2.sch]
2021-04-13 Исправлены площадки механизмов Розе, соответствующие платы и герберы плат
    [BSK1+BSK3+PL.brd, BSK1.sch, BSK2+BSK4.brd, BSK2.brd, BSK2.sch, BSK3.sch, BSK4.sch, SP+SPIDER.brd]
2021-04-15 Проект собирается. Реализовано разделение на 2 bme. Необходимы тесты
2021-04-15 FIX для bme
2021-04-15 коммит
2021-04-17 Добавлен вызов основной функции в main
2021-04-17 !!! Обновлен мавлинк !!! Реализованы основные функции для внутреннего ms5611
2021-04-17 Сделаль радио таск
2021-04-19 В библиотеке добалек footprint для B6B-EH-A
2021-04-19 Плата BSK5 на проверку
    [BSK5.brd, BSK5.sch]
2021-04-22 Смержили библиотеку cancubesat.lbr
2021-04-22 Обновлены герберы плат BSK1-4, PL, SP и SPIDER
    [BSK1+BSK3.brd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]
2021-04-22 Сделана схема БКУ
    [BKU.brd, BKU.sch, MP2225.brd, MP2225.sch]
2021-04-22 Добавка к библиотеке
2021-04-24 В библиотеку EAGLE добавлены источники опорного напряжения REF3025 и REF3033
2021-04-24 Фикс критических багов. Теперь что-то отправляется
2021-04-25 Работа над полезной нагрузкой. Кажется, оно теперь запускается на правильной частоте.
    Переделал драйвер бме на общий код с дескрипторами
2021-04-26 Исправления АРКа
    [ARK.brd, ARK.sch]
2021-04-26 Плата АРК готова к проверке
    [ARK.brd, ARK.sch]
2021-04-26 Украсил плату АРК
    [ARK.brd, ARK.sch]
2021-04-29 Неотлаженная версия its-link мастера для малинки
2021-04-29 Начинаем разгребать этот мусор
2021-04-29 Отладочная плата Debug
    [Debug.brd, Debug.sch]
2021-04-29 Есть получение данных от SINS!
2021-04-29 Синсы отправляют данные с датчиков
    [SINS Debug.cfg]
2021-05-01 Завершена разработка плат БСК5 и АРК, половина платы БКУ разведена, добавлены гербер файлы плат АРК, БСК5 и WSPR
    [AB.csv, ARK.brd, ARK.sch, BKU.brd, BKU.sch, BSK5+ARK.brd, BSK5.sch, DC-DC.csv]
2021-05-01 Разведена плата БКУ
    [BKU.brd, BKU.sch]
2021-05-01 мемсы работают
2021-05-02 Значительно переосмыслен драйвер ms5611, исправлены мелочи в драйвере bme280. Убраны варнинги мавлинка и все остальные варнинги
    [app_main.c, mics6814.c]
2021-05-02 Война варнингам
2021-05-02 Кажется, теперь crc для ms5611 должно считаться правильно
2021-05-02 исправлена конфигурация uart в gps. теперь его конфигурирует куб
    [gps.c, gps.h]
2021-05-02 исправлена конфигурация i2c для mems датчиков. теперь его конфигурирует куб
    [lis3mdl.c, mems.c]
2021-05-02 проба баланса сообщений. необходимо доделать
2021-05-02 добавлено прерывание для gps uart
2021-05-02 исправлен небольшой баг
2021-05-02 Связь с Данилой налажена
2021-05-02 Танцы с бубном вокруг радио
2021-05-04 Убраны 2 варнинга
2021-05-04 Исправлены имена пинов питания датчиков
    [SINS.ioc, main.c, main.h]
2021-05-04 Реализовано отключение питания для mems датчиков
2021-05-04 Исправлены ошибки компиляции в payload
    [app_main.c, its-i2c-link-conf.h]
2021-05-04 Предложение по организации внедряемых сообщений на синсах
2021-05-04 Принят вариант баланса сообщений, но с небольшими исправлениями
    [uplink.c]
2021-05-04 Добавлено вкючение ивыключение питания для gps. Не реализовано
2021-05-04 Персчитываем углы в матрицы
2021-05-04 Уменьшаем агрессию вывода
2021-05-04 Теперь время меняется резко, редко и детерменированно
2021-05-05 Реализовано включение и выключение питания gps при реконфигурации
2021-05-05 Миграция проекта пейлоада на куб 1.6.1
2021-05-05 Забыл домножить на A.transpose()
2021-05-05 Кто-то сказал Солнечный Датчик?
2021-05-05 Лишний раз взял ссылку
2021-05-05 Скопировал и обновил старый AHRS проект команды ЗиКЮШ
2021-05-05 Укорачиваем Солнечный датчик
2021-05-05 Больше констов богу констов
2021-05-05 Извините, что намусорил - оно само так
2021-05-05 Перенес маджвик с солнечным датчиком в common
2021-05-05 Сделал статическим. Маджвик готов к инсталяции в Данилин код
2021-05-05 LDS стал суперпростым
2021-05-05 Приятное форматирование
2021-05-05 исправлены ошибки в драйвере ms5611. теперь он работает
    [app_main.c]
2021-05-05 изменены коэффициенты для внутреннего термодатчика под новый контроллер
2021-05-05 Исправлена ошибка в расчете контрольной суммы для параметров ms5611
2021-05-05 Добавлен таймаут на wait_busy операцию для sx126x драйвера
2021-05-05 Ой, это была неприятная мелочь
2021-05-06 Добавлен проект для генерации таблиц ICAO
2021-05-06 Добавлены таблицы ICAO с давлением по высоте и математика для их интерполяции.
    вычисление высоты по давлению интегрировано в опросник bme280
2021-05-07 Вкорячил таймаут грязным способом
2021-05-07 Смещение гироскопа и обработка магнитометра
2021-05-07 Убрана ручная настройка АЦП
2021-05-07 Вкорячил маджвика
2021-05-07 Добавил нормы матриц
2021-05-07 Воткнул солнечный датчик
2021-05-07 Добавлены пины для транзсторов. Созданы функции для выключения датчиков
2021-05-07 Исправлены периоды сообщений. Снижена частота обмена
    [PAYLOAD.ioc, app_main.c, main.c]
2021-05-07 Новый мавлинк!!!!!!!
2021-05-07 Убрал лишние пути до инклюдов для ASM компилятора (а то эклипс ругается)
2021-05-07 Исправлена ошибка в компенсации температуры ms5611! Алгоритм компенсации старательно переслизан с пиксхавка
2021-05-08 теперь ms5611 показывает правильные значения
2021-05-08 Термистор для днк работает
2021-05-08 Исправлена ошибка при подсчете кислорода
2021-05-08 Добавлен код для дозиметра
2021-05-08 Настроен таймер для дозиметра. Выставлен адресс для общения с БКУ
2021-05-08 Добавлен код для термистора и дозиметра в main
2021-05-09 Настроен таймер для дозиметра
2021-05-09 Добавлены прерывания для i2c
2021-05-09 Обновлен мавлинк. Добавлены сообщения для ДНК и дозиметра
2021-05-09 Небольшое переосмысление кода для ДНК. Добавлена работа с нагревателем
2021-05-09 Небольное переосмысление кода для дозиметра
2021-05-09 Новые сообщения отправляются
2021-05-09 Исправлен варнинг в драйвере ms5611
2021-05-09 Исправлена ошибка в работе термистора
2021-05-09 Еще раз исправлен варнинг в драйвере ms5611. Параноить, так до конца
2021-05-09 Добавлена дырка в полигоне под антенной для ESP на плате БКУ
    [BKU.brd]
2021-05-09 Тонкие настройки
2021-05-09 Новые данные фотодиодов
2021-05-09 Маджвик работает!!!
2021-05-09 Маджвик работает с солнечным датчиком (почти)
2021-05-09 Замдляем I2C
2021-05-11 Проект для имитации барометров скорее всего так и останется в зачатках. Переходим на альтернативное решение
2021-05-11 Зачатки проекта для имитатора барометров и прочего
2021-05-11 Зачатки имитаторов барометров
2021-05-12 Добавлена шелкографика на плате БКУ
    [BKU.brd, BKU.sch]
2021-05-12 Симуляция для алгоритма управления компрессором
2021-05-13 Убран лишний переключатель на плате БКУ
    [BKU.brd, BKU.sch]
2021-05-13 Исправлены тайминги отправки пакетов
    [app_main.c]
2021-05-13 Исправлены баги с радио и радио-сервер чуток переделан
2021-05-13 Добавлены герберы плат BKU и Debug
    [BKU.brd, BKU.csv, BKU.sch, Debug.brd, Debug.csv, Debug.sch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]
2021-05-13 Исправлены герберы плат
    [Debug.brd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]
2021-05-14 Выставляется правильное время в сообщениях о диодах в синсе
2021-05-14 исправил какой-то косяк с тулчейном для синса
2021-05-14 Включены прерывания на пейлоаде, необходимые для корректной работы службы времени
2021-05-15 Коррекция времени работет
2021-05-15 Добавлено название для pps пина. Он подтянут к земле
2021-05-15 Причесывание GPS в синсе, Работа еще не окончена
2021-05-15 Весь аналог приведен к общему интерфейсу
2021-05-15 Исправлено напряжение TCXO для радио, согласно мануалу (не очень понятно откуда он взялся...)
2021-05-16 ПН работа
2021-05-16 Пофиксили мавлинк
2021-05-16 Война варнингам и чистка общих настроек проекта
2021-05-16 Очень неприятный баг, который опять пропустили из-за обилия варнингов
2021-05-16 Настройки тулчейна пейлоада опять сползли
2021-05-16 Управление питанием MS5611 перенесено на параметры дескриптора
2021-05-16 Убрал подозрительные места с работой по невыровненным членам структур. сырое значение MICS6814 теперь сырое значение АЦП, а измеренного сопротивления TODO: перебить поле на инт
2021-05-16 Чуточку причесаны ДНК и дозиметр
2021-05-16 Добавлен комиссар в полезную нагрузку
2021-05-16 Попытка сделать i2c линк правильно и подключить его к комиссару
2021-05-16 Чистка сисколов и расстановка перезагружаторов в разных штуках типо NMI прерываниях
2021-05-19 Подтяжка на UART4 RX (отладочный) для пейлоада
2021-05-19 Комиссар приехал на синс. Исправлена небольшая вязанка багов на синсе
    [its-i2c-link.c, its-i2c-link.h, main.c, mav_packets.c, uplink.c]
2021-05-19 Исправлены баги на пл
2021-05-19 Исправлены ошибки подсчета RSSI в радио-сервере
2021-05-22 Вспомогательный коммит?
2021-05-22 Убрал подтяжку
2021-05-22 Пересобран проект для ARK. Убраны варнинги мавлинка
2021-05-22 Эксперименты с радио. bad-data стало меньше
2021-05-22 Отовсюду убраны подтяжки, в пейлоаде выловлено несколько багов и починнен (вроде как) файл проекта
2021-05-22 Вернул таск управления батарейками. Он был отключен здесь 438129f4b1aff372015f85f637c77f4349155d02
2021-05-22 Вернул 2 ины. Были убраны здесь b21d58dcb7bf618727028e3295f56fd343d0ac48
2021-05-22 Чиним синхронизацию времени
2021-05-22 Баг с дискретной темературой
2021-05-23 Удалил лишний проект с моделью барометра
2021-05-24 Исправлено UB в драйвере радио. Добавлены RSSI в сервер-радио
2021-05-24 Вспомогательное приложение для проверки радио-линии. Гонит натуральный ряд по радио
2021-05-25 Причесал и чуток запараноил драйвер радио
2021-05-26 Обновил БКУ вместе с драйвером радио
2021-05-26 Убрал варнинги из драйвера радио
2021-05-26 Варнинги отныне не существуют
2021-05-26 Дополнительный пин для синхронизации времени
2021-05-28 Большой прогресс в i2c-линк слейве на LL драйвере
2021-05-28 Второе рождение проекта для отладки i2c-link-а на f4
2021-05-28 Нехороший косяк в пейлоаде с i2c-линком и мелкая правка утилиты для разбора метаданных ZMQ
2021-05-29 Добавлены адреса 1w датчиков для арка на стенде
2021-05-29 Добавлен INA драйвер и мютекс на I2C
2021-05-29 Да здраствет передача земля - борт
2021-05-29 Бага при работе с иной
2021-05-29 Исправлена очень страшная бага с одновремененым доступом к шине
2021-05-29 Делаем считывание с ин
2021-05-29 I2C линк доведен до уровня на котором он может быть внедрен в проекты бортового ПО
2021-05-29 Миграция пейлоада на новый i2c-link
2021-05-29 Миграция SINS на новый its-i2c-link
2021-05-29 Миграция БКУ новый i2c-link протокол
2021-05-29 Миграция АРК на новую реализацию its-i2c-link
2021-05-30 Актуализация для отладки its-i2c линка на stm32f1
2021-05-30 Обновление i2c-link драйвера в отладочных проектах с возможностью сборки под f1 и f4
2021-05-30 Обновление i2c-link драйвера в проектах ПО бортовых компов с поддержкой f1 и f4
2021-05-30 Ошибка в расчете собственной температуры пейлоада
2021-05-30 Игры с VREFINT на пейлоаде
2021-05-31 Переезд наземных утилиток в отдельную папочку
2021-05-31 Удлалил старые и ненужные проекты из src/research
2021-06-03 Дописал гитингор для тестовых проектов
2021-06-03 Готова плата RADIO и переделана плата AB
    [AB.brd, AB.sch, RADIO.brd, RADIO.sch]
2021-06-03 Улучшен лог imi в БКУ, исправлены ужасные баги в its-i2c-link
    [its-i2c-link.c]
2021-06-03 Новый i2c линк отлажен на синсе
2021-06-03 Синс научился отправлять статистику по i2c шине
2021-06-03 Новый драйвер АЦП для полезной нагрузки с компенсацией по напряжению на VDDA
2021-06-03 Новый драйвер АЦП для полезной нагрузки с компенсацией по напряжению на VDDA теперь и на синсе
2021-06-03 Отчёты комиссара в полезной нагрузке
2021-06-04 Новый алгоритм управления компрессором
2021-06-04 Управление компрессором интегрированно в пейлоад. Мавлинк полностью перепахан
2021-06-04 Добавление стабильного времени во все сообщения полезной нагрузки
2021-06-05 Добавлено время из новых пакетов
2021-06-05 Обновлен счетчик резетов, добавлена причина резета. Перетянуты функции чтения и записи в бэкап регистр RTC из LL драйвера
2021-06-05 Ой! совсем забыл эти файлы
2021-06-05 Мелкие баги в комиссаре
2021-06-05 БКУ в реалиях стабильного времени в каждом сообщении
2021-06-05 VBAT работает. RTC работает, но при изменении кода куба
2021-06-05 Время теперь синхронизиурется
2021-06-05 Исправил страшную багу с I2C c переполнением памяти
    [ina219.c, my_i2c.c]
2021-06-05 Новая политика службы времени на полезной нагрузке и расширение её статуса
2021-06-05 Поправлен таск контроля температуры батарей. Исправлены адреса ds
    [task_battery_control.c]
2021-06-05 Попытка добавить ины
2021-06-05 Улучшения политики работы со службой времени на полезной нагрузке
2021-06-07 Ой, перепутал режимы лоры с явным и неявным заголовками
2021-06-08 MICS6814 меряет на всех доступных плечах
2021-06-09 Сервер радио теперь следит за ошибками в радио и кричит о них в лог
2021-06-09 Не то, чтобы это было страшные баги с радио, но мелочи, которые требовали правки
2021-06-10 Попытка наладить работу TXCO в радио
2021-06-10 Очень нехорошие баги в brd части радио на бку
2021-06-10 Попытка избежать гонки с завершением rx режима с радио на борту
2021-06-10 Стыдно
2021-06-10 Истеричные попытки наладить радиоканал
2021-06-10 Переменные надо инициализировать!
2021-06-10 Грядет большая революция в драйвере радио
2021-06-11 Большая революция в драйвере радио произошла
2021-06-11 Добавлен вочдог на sins. Необходимо проверить его работу
2021-06-11 Изменены настройки частот для работы с платой
2021-06-11 революция в самом разгаре
2021-06-11 ARK переехал на плату. Настроен HSE
2021-06-11 сборка в релизе
2021-06-11 обновлены LL драйверы для rtc-fromgps
2021-06-11 Правки по вдумчивому чтению документации
2021-06-12 Кажется, лучше не становится
2021-06-12 Все еще бьет данные
2021-06-12 Снова пробуем работать на sf7
2021-06-12 Доведено до сборки везде. Кажется, все проблемы устранены
2021-06-12 .launch файлы конкретно надоели
2021-06-12 Разные улучшайзеры
2021-06-12 Ины работают (только макс значение тока надо редактировать)
2021-06-12 Теперь исользуем Base
2021-06-12 Рабочее радио
2021-06-12 GPS было слишком частым
2021-06-12 Еще попытки работать
2021-06-12 Актуализация радио-параметров для тестового-борта
2021-06-12 Обновлен комиссар
2021-06-12 Добавлены логи оператора и радио
2021-06-12 Управление питанием теперь значительно проще
2021-06-15 Очередная переделка сервера-радио
2021-06-16 Попытка заставить ины работать так, как задумывалось
2021-06-16 Теперь дравер ины не противный
2021-06-16 Молчать!
2021-06-16 Проект для отработки CSS на f4 (и оно даже более менее работает, осталось оформить)
2021-06-16 CSS более менее оформлено
2021-06-17 Размер коррекции в телеметрии полезной нагрузки
2021-06-17 Правильный подсчет размера коррекции времени
2021-06-17 Ина как-то работает?
2021-06-17 Рабочие ины
2021-06-17 Ины работают отменно
2021-06-17 gettimeofday нельзя вызывать из прервания
2021-06-17 Логи теперь еще более безопасные
2021-06-19 Нагреватеели теперь работают
2021-06-19 Больше ин!
2021-06-19 Больше дсок!
2021-06-19 Оказывается, порядок сдивговых регистров другой :(
2021-06-19 Теперь команды обрабатываются бортом
2021-06-19 Лишний перевод на новую строку
2021-06-20 Проекты для ОЧЕРЕДНОЙ отработки лоры
2021-06-20 Правка, кажется ОЧЕНЬ МЕРЗКОГО БАГА в драйвере радио. Кажется это он пил кровь все это время
2021-06-20 Правки мелких и не сильно существенных багов в драйвере радио
2021-06-20 Кажется, наконец-то правильная реализация воркэрануда 4 для радио и задержка в секунду перед запуском проекта-спамера для устаканивания питания
2021-06-23 Номер пакета
2021-06-23 Больше дсок
2021-06-23 Больше логов
2021-06-23 ОБНОВЛЕНИЕ МАВЛИНКА. Ремонт службы времени на пейлоаде и расширенная диагностика в телеметрии.
2021-06-24 Баг с утечкой памяти и не только
2021-06-24 Ины работают только на высоких частотах
2021-06-24 Подкорректировали СД
2021-06-24 Пофискил время
2021-06-24 Почистил код
2021-06-24 Новый timebase для синса и выдача сообщения со временем не у границы секунды
    [SINS Debug.cfg]
2021-06-25 Запуск с RTC. Работает
2021-06-25 Заготовки для более хорошего управления радио
2021-06-25 Обработка новых команд
2021-06-25 Новая синхронизация времени
2021-06-25 Записываю номер последней команды
2021-06-25 Убран варнинг
2021-06-25 Добавлено монотонное время в пакеты ark
2021-06-25 Заготовки для безопасного радио
2021-06-26 поправлены таски
2021-06-26 исправлена лампочка для платы ark
    [main.h]
2021-06-26 i2c работает на ark
2021-06-26 Клок пейлоада для боевой платы
2021-06-26 Возвращена проверка валидности пакетов gps
2021-06-26 Реализована поддержка CSS на SINS
2021-06-26 Реализована поддержка CSS на PAYLOAD
2021-06-26 Реализована поддержка CSS на ARK
2021-06-26 Чистим
2021-06-26 Доработки
2021-06-29 Адреса на пейлоаде исправлены
2021-06-29 ИСПРАВЛЕНЫ ПИНЫ УПРАВЛЕНИЯ mics6814. АЦП снова работает
    [mics6814.c]
2021-06-29 Попытка уменьшить лаг отправки времени с синса
2021-06-29 Забытая диагностика
2021-06-29 Есп теперь успевает выгребать данные по i2c
2021-06-29 Таакая частота вроде тоже работает
2021-06-29 Статистика по времени работы тасков
2021-06-29 Комментарии к службе времени на синсе
2021-06-30 Мелкие вставки для всяких проверок и диагностики. Коммичу, чтобы были у всех, так как это сейчас зашито
2021-07-02 Больше дебаа богу дебага
2021-07-02 Заготовка для модуля, управляющего питанием
2021-07-02 Меньше дебага богу багов
2021-07-02 Частота синса исправлена
2021-07-02 Управление питанием теперь работает
2021-07-02 Исправлены баги радио
2021-07-02 Упси
2021-07-03 Комиссар теперь отправляет сообщения
2021-07-03 Исправлен пакет с ошибками
    [main.c, mav_packets.c, state.h]
2021-07-03 Добавлена статистика по синхронизации времени
2021-07-03 Убраны варнинги в ARK
2021-07-03 Добавлено в ARK: проверка timebase, сборка статистики по синхронизации времени, счетчик резетов
2021-07-03 Вбил параметры резисторов mics6814
2021-07-03 Добавлено оконное измерение дозиметром
2021-07-03 Добавлено ограничение по чатоте отправки сообщения
2021-07-03 Очень нехорошая ошибка с отправкой данных дозиметра
2021-07-03 Коррекция температур для ДНК
2021-07-03 Еще одна очень нехорошая ошибка в коде дозиметра
2021-07-03 Упс. На арке используются мс, а не мкс
2021-07-03 Починил синхронизацию времени
2021-07-03 Наконец-то дал этому модулю нормальное имя
2021-07-03 Починил MSP
2021-07-03 Мелкие изменения
2021-07-06 Кажется я нашел багу в синхронизации времени на пейлоаде
2021-07-06 ой! Это должно было быть в прошлом коммите
2021-07-06 Добавлено сообщение PLD_COMPRESSOR_DATA. Закрывает CCS2021-129
2021-07-07 Фиксим статистику времени
2021-07-07 Base не записывался в статистику
2021-07-07 Забытое время пакета
2021-07-07 Разделение кода на функции для улчшения читаемости
2021-07-07 Тсссс! Тише!
2021-07-07 Кажется теперь все параметры mics6814 вбиты правильно
2021-07-07 Игры с количеством буферов SINS и приоритетами выдачи сообещений
2021-07-07 Подправлена частота и оффсеты выдачи сообщений пейлоада
2021-07-07 Созданы гербер файлы AB и RADIO
    [AB+RADIO.brd, AB+RADIO.sch, BKU.csv, Debug.csv, SPout.brd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]
2021-07-07 Я очень надеюсь что больше проблем с синхронизацией на пейлоаде не будет
    А вот теперь прямо очень надеюсь на отсутствие проблем с синхронизацией времени на пейлоаде
2021-07-07 Починен сброс для sx126x на БКУ
2021-07-10 Добавил алгоритм расчета положения солнца
2021-07-12 Исправлена сборка синса в релизе (толком не проверено, но хотябы собирается)
2021-07-12 Кто-то не умеет вызывать функции. Должно исправлять не взятие времени gps https://conzern-its.myjetbrains.com/youtrack/issue/CCS2021-131
2021-07-12 Добавки к AHRS
2021-07-12 Закончен солнечный датчик
    [SINS Debug.cfg]
2021-07-12 Доработки БКУ
2021-09-01 Исправления драйвера ины и использование правильных сопротивлений
    [ina219.c, sensors.c]
2021-09-03 Радио теперь передает пакеты, которые накапливаются и во время получения
2021-09-03 Чаще замеряем ины
2021-09-08 Включен вотчдог
2021-09-08 Попытки с АЦП
2021-09-08 Починили термодатчики
    [ark Debug (1).cfg]
2021-09-11 Проект с расчетом параметров алгоритма управления компрессором (не понял почему он не был включен?)
2021-09-11 Реворк I2C таска на арке
2021-09-11 Досыл I2C_LINK_STATS сообщения от арка
2021-09-11 !MAVLINK! Новое сообщение для солнечного датчика
2021-09-11 напряжения с арка в вольтах а не в милливольтах
2021-09-11 В i2c-link-stats на арке забыто время
2021-09-11 Ины теперь должны перезагружаться при получении от них плохих данных
2021-09-11 Компрессору доверяем данные от MS5611. В крайних случаях от BME
2021-09-11 Правильная обработка флагов GPS
2021-09-15 Уменьшаем количество выводимых логов
2021-09-15 OW теперь на другом пине, так как старый поломался
2021-09-15 Радио теперь готово отправлять сразу после запуска. И буфер побольше
2021-09-15 Обидные баги синса
2021-09-15 СД карта теперь быстрее восстанавливается
2021-09-15 БКУ не перезапускается в первые 2 минуты после включения, если нет СД карты
    Это нужно для возможности получить данные по радио, если нет
    данных по сд карте
2021-09-15 Убрана подтяжка на OW
2021-09-15 Более информативный варнинг
2021-09-15 Этот дефайн больше не используется
2021-09-15 pdTRUE = 1 а pdFALSE = 0. Просто ужас
2021-09-16 Добавлен вспомогательный кодик для тестов компрессора
2021-09-18 ОМЕРЗИТЕЛЬНЫЙ БАГ В ДРАЙВЕРЕ РАДИО
2021-09-18 Актуализированны параметры управления компрессором
2021-09-18 time_steady у термодатчиков (и инн) было плохим
2021-09-18 Posix структура tm просто отвратительна
2021-09-24 Исправляем баги со временем на АРКе
    [adc.c, its-time-sync.c, its-time.c, its-time.h, task_send.c, tmain.c]
2021-09-24 Улучшенное управление включением магнитометра в AHRS
2021-09-24 Подправленные данные фотодиодов
2021-09-25 Реворк рекавера i2c шины с инами на арке
2021-09-25 Перестаем качать компрессором с 12ти километров и оставляем только продувку. А еще обновлена модель для проверки компрессора
2021-10-01 Правильное направление магнитометра
2021-10-01 Калибровка магнитометра
2021-10-01 Увеличенный буфер сообщений на отправку СИНСа
2021-10-01 Исправленный солнечный датчик
2021-10-01 ОБНОВЛЕН МАВЛИНК Увеличена частота сбороса состояния компрессора на пейлоаде Добавлены подробные параметры включения выключения компрессора на пейлоаде Увелчен размер очереди i2c сообщений в пейлоаде
2021-10-01 Добавлена отсечка показаний bme280 от алгоритмов управления, в случае, если его показания уходят за пределы допустимых по даташиту
2021-10-01 Исправлен и улучшен алгоритм для тестирования компрессора
    [app_main.c, its_ccompressor.c]
2021-10-02 Обновлен Мавлинк, добавлен недобавленный файл, улучшен ИНС
2021-10-02 Подтачиваем БКУ
2021-10-02 Подтачиваем ПЛ
2021-10-02 Тише!
2021-10-03 Работаем над управлением компрессора в условиях хорошей утечки из гермообъема
2021-10-03 Моделирование минимальной модификации
2021-10-03 более серьезная модификация
2021-10-04 Апгрейд алгоритма управления компрессором на пейлоаде
2021-10-05 Пин есп сломался - выбрали другой для OW
2021-10-05 Палетная телеметрия SD
2021-10-05 Перемещение старой телеметрии
    [BCU_STATS-10-0.csv, BCU_STATS-20-0.csv, ELECTRICAL_STATE-12-0.csv, ELECTRICAL_STATE-21-0.csv, Electrical_state.csv, Electrical_state.xlsx, GPS_UBX_NAV_SOL-11-0-with-o2-and-bme-and-mics.csv, GPS_UBX_NAV_SOL-11-0-with-o2-and-bme.csv]
2021-10-08 Забытый актуальный код модели компрессора
2022-02-17 команды для создания репозитория
2022-02-17 опять прикрутил мавлинк
2022-03-17 Добавлены платы SP
    [SPin.brd, SPin.sch, SPinner.brd, SPinner.sch]
2022-03-17 Доделаны платы SP
    [SPinner.brd, SPinner.sch]
2022-03-19 Добавил наработки по ccsds
2022-03-19 Наработки по map
2022-03-19 Перемщение папкой выше
2022-03-20 Проверил платы SPinner и SPin,внес декоративные правки
    [SPinner.brd, SPinner.sch]
2022-03-20 Король мертв! Да здравствует король! (заменил модель на новую)
    [adapter.prt, air-valve.prt, ark-pcb.prt, barometr-ms5611.prt, battery_pcb-bms.prt, bku-pcb.prt, bme280_module.prt, bottom-camera-kron.prt]
2022-03-20 Залил новую документацию на зимнюю сессию. Убрал устаревшую
2022-03-28 сабмодули передалны на относительные пути
2022-03-30 Пакет теперь целиком передается на землю
2022-03-30 Очистка буфера после использования
2022-03-30 Обрабатываем отдельно случай пустого tfdf в map
2022-03-30 Стырил файлы из старого проекта
2022-03-30 Добавил данные м-канала и физ-канала, переработал передачу данных
2022-03-30 Подготовил все для сериалайзинга фрейма
2022-04-05 Новые наработки ccsds
2022-04-05 Попытки доделать распаковку фреймов
2022-04-12 Пытаюсь добавить сообщения ГПС
2022-04-12 Проект для отладки парсера ГПС
2022-04-14 Добавила таки сообщение переменной длинны
2022-04-14 Новый патчик на парсер ГПС. Дописала сообщение переменной длины, исправила дич в возвращаемых значениях функций
2022-04-21 MAPA работает в обе стороны!
2022-04-23 Миграция на новую CubeIDE
2022-04-23 Интеграция мавлинка в новом стиле
2022-04-23 Пины компрессора и клапана перекинуты местами
2022-04-24 Синхронизация с мавлинком
2022-04-25 Правки в преобразовании типов. битовый вариант маски заменила на хексовый
2022-04-25 Покеты монхв
2022-04-25 Тестики
2022-04-26 Исправлен баг с включением уже включенного компрессора в телеметрии
    https://conzern-its.myjetbrains.com/youtrack/issue/CCS2021-168
    Нужно проверить
    [its_ccompressor.c]
2022-04-26 Модель компрессора чуточку подогнана под настоящее положение вещей
    [PLD_MS5611_DATA-13-1.csv, PLD_MS5611_DATA-13-2.csv, pump_history.csv, valve_history.csv]
2022-04-27 Наколдовала отправку новых сообщений. Надеюсь это сработает
2022-04-30 Акутализация принтов на полезной нагрузке
2022-04-30 Проект БКУ доведен до компиляции
2022-05-01 Новый мавлинк
2022-05-02 Готова схема платы АРК
    [ARK.brd, ARK.sch, SPin.brd]
2022-05-05 Добавила новое сообщение
2022-05-05 Новенький парсер
2022-05-05 Добавили новое сообщени в синсы (вроде)
2022-05-05 Радио исправно передает на более высокой скорости для отладки
2022-05-05 Пейлоад качает компесссором в покое для отладки (с другими цифрами)
2022-05-07 Превращение буфера в циклический буфер
2022-05-07 Циклобуфер работает!
2022-05-08 Начата разводка платы АРК
    [ARK.brd, ARK.sch]
2022-05-11 Работа Сергея
2022-05-12 Улучшение таймингов радио
2022-05-12 Калибровка магнитометра (плохая)
2022-05-18 Плата АРК готова
    [ARK.brd, ARK.sch]
2022-05-19 Дописала сообщения в костыль + исправление бага
    [mav_packets.c, uplink.c]
2022-05-19 Забыл объединить земли на плате АРК. Исправился
    [ARK.brd, ARK.sch]
2022-05-21 Добавлены компоненты в библиотеку CanCubeSat
2022-05-21 Откомпилировала и исправила баги
    [mav_packets.c, uplink.c]
2022-05-21 Исправление менее очевидного бага + смена типа
2022-05-21 Обновил мавлинк, починил калибровку
2022-05-22 Плата АРК и платы регулярок отправлены в производство
    [ARK+DOS+DA+SC.brd]
2022-05-22 Переделал крепление солнечной панели под кнопку и новую пружину
    [solar-eqv.prt, solar_inter-plata.prt, solar_kron-mirror.prt, solar_kron.prt, spring_0_4x2_4x19_6.prt]
2022-05-25 MAPP работает в обе стороны!
2022-05-25 Обмазался симейками
2022-05-25 Подготовка арка
2022-06-04 Исправлена лажа в дигностике GPS на синсе
    [neo6-cfg.c, sins_config.h]
2022-06-15 Боевые режимы радио на БКУ (ничего не работает)
2022-06-15 Пейлоад после доработки с ускорением реакции на компрессор
2022-06-15 Обновление мавлинка и фикс багов тайминга радио
2022-06-15 Поймано пропавшее сообщение NAV-SVSI. Правда пока не на борту. И вообще UBX парсеры несколько переосмыслены
2022-06-16 Сообщение nav-svsi перенесено из research на SINS
2022-06-16 Исправлена ошибка в разборе сообщений GPS
    [ubx_packet_parser.c, ubx_packet_parser.h]
2022-06-16 Красота для отладки GPS
2022-06-16 Увеличено время вотчдога для пейлоада
2022-06-16 Исправил баги в таймингах радио
2022-06-18 SINS больше не заваливает шину сообщениями комиссара
2022-06-24 Обновила сообщение SINS_RXMSVSI. Оно собирается. В бою не проверялось
2022-06-25 Рефакторинг АРКа
2022-06-28 Прием работает
2022-07-01 Пофикстл передачу данных розе от арка
2022-07-01 Эксперименты с таймнгами радио
2022-07-02 Пейлоаду возвращена полётная конфигурация
2022-07-03 Тестим радио
2022-07-03 Пофиксил радио
2022-07-04 Телеметрия
2022-07-05 Электрические параметры в телеметрии БКУ больше не путешествуют назад во времени по шкале time_steady. Жаль, что это были воображаемые путешествия :c
2022-07-06 Лучший датасет во всем Владимире
    [ARK_STATS-12-0.csv, BCU_RADIO_CONN_STATS-10-0.csv, BCU_STATS-10-0.csv, BCU_TIME_SYNC_STATS-10-0.csv, COMMISSAR_REPORT-13-0.csv, COMMISSAR_REPORT-13-1.csv, COMMISSAR_REPORT-13-2.csv, COMMISSAR_REPORT-13-3.csv]
2022-07-06 Актуализация скриптов и графопостроители
2022-07-06 Инфраструктура для массового рисования графиков
2022-07-06 Лучший набор телеметрии на ЗЕМЛЕ
    [ARK_SP_DEPLOYMENT_STATE-12-0.csv, ARK_STATS-12-0.csv, AS_AUTOMATIC_CONTROL-0-0.csv, AS_HARD_MANUAL_CONTROL-0-0.csv, AS_SEND_COMMAND-0-0.csv, AS_SOFT_MANUAL_CONTROL-0-0.csv, BCU_RADIO_CONN_STATS-10-0.csv, BCU_STATS-10-0.csv]
2022-07-06 требуемое для разбора
2022-07-06 Начало анализа наземной телеметрии
2022-07-06 Новые графики
2022-07-06 Новая версия лучшего датасета владимира с давлениеми (так же как с высотой)
    [ARK_STATS-12-0.csv, BCU_RADIO_CONN_STATS-10-0.csv, BCU_STATS-10-0.csv, BCU_TIME_SYNC_STATS-10-0.csv, COMMISSAR_REPORT-13-0.csv, COMMISSAR_REPORT-13-1.csv, COMMISSAR_REPORT-13-2.csv, COMMISSAR_REPORT-13-3.csv]
2022-07-06 Добавил секунды туда сюда
2022-07-06 Графики причесаны
2022-07-06 Анализ радио канала по дистанции от аппарата
2022-07-06 Анализ потерь пакетов
2022-07-06 Анализ потерь пакетов стал лучше
2022-07-06 Анализ RSSI и SNR на одном графике
2022-07-06 Больше дозиметров
2022-07-07 Разные правки и графики температуры
2022-07-07 Тут месиво, но мы так закончили
2022-12-23 Добавил графики
2023-04-18 Добавлен скрипт для графиков солнечного датчика
2023-04-19 Углы больше не перепутаны
2023-04-19 Теперь еще и названия углов рендерятся корректно
2023-04-19 Графики со сравнениями показаний AHRS и СД
